ollewelin/analog_matrix_computation_Inverted_MAML_PAT_PEND_2630397-4/README.md

# Analog 2T1C Matrix Computation with Inverted Meta-Learning (MAML)
## Patent Application: SE 2630397-4 (Patent Pending)



### 📄 Patent Document:
* **Patent Specification (English Translation):** [📄 `inverterad MAML_12_Eng.pdf`](inverterad%20MAML_12_Eng.pdf)
* **Patent Application No:** SE 2630397-4
* **Status:** Patent Pending
* **Inventor:** Olle Welin
* **Priority Date:** 2026-06-03

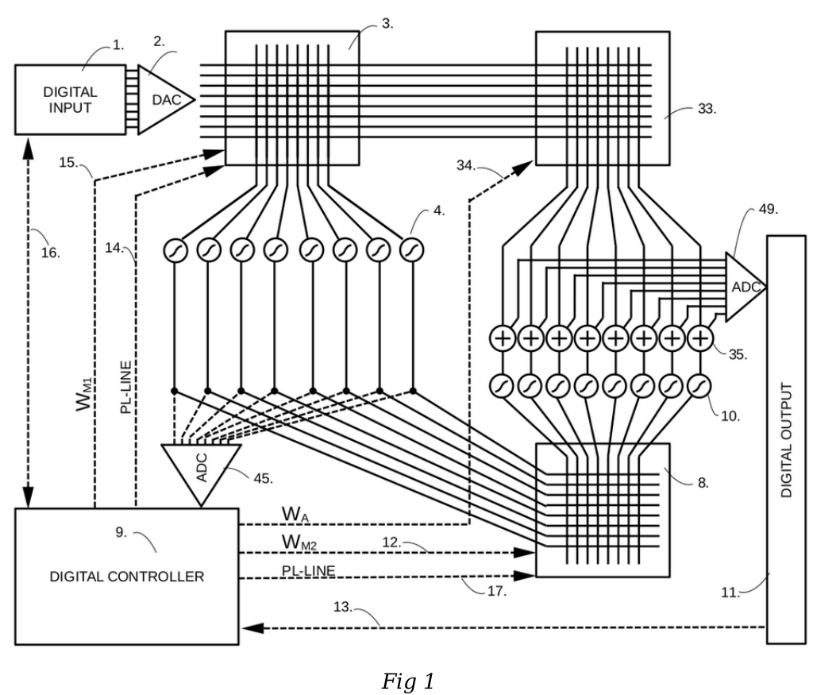
[picture p1: Fig1.png]
Patent Figure 1: Inverted MAML Analog Matrix Architecture with Autonomous Neural Compensation Network


---

## ⚖️ License & Patent Grant (`SHL-2.1`)

Everything in this repository—hardware schematics, PCB layouts, commercial ASIC/IC implementations, FPGA gateware, firmware, and software—is released as **100% Open Source** under the **Solderpad Hardware License v2.1 (`SHL-2.1`)**.

* **Patent Grant (`SE 2630397-4`):** Includes a perpetual, worldwide, non-exclusive, no-charge, royalty-free patent license under Section 3 of `SHL-2.1` covering **Swedish Patent Application No. SE 2630397-4** (priority date `2026-06-03`) and any patents, continuations, divisionals, reissues, or foreign/PCT counterparts thereof—for both commercial and non-commercial use, including commercial ASIC and IC manufacturing. No separate agreement or permission is required.
* **Inventor & Attribution:** Original invention by **Olle Welin** (`Copyright (c) 2026 Olle Welin`). Under `SHL-2.1` Section 4, redistributions and derivative works must preserve all copyright, patent, and attribution notices.
* **No Warranty / No Liability:** Provided **"AS IS"**, without warranties or liability of any kind (see `SHL-2.1` Sections 7–8).

*See the full license text in [LICENSE.md](LICENSE.md).*

### 💡 A personal note from the inventor, Olle Welin

*If you are wondering where this project is heading – to be honest, I am taking it one day at a time! I am building, probing, and testing all of this entirely on my own as a private passion project on my lab bench.*

*I believe deeply in open science and radical hardware transparency. That is why all source code, FPGA firmware, schematics, telemetry logs, and patent specifications are openly published here under **Solderpad Hardware License v2.1 (`SHL-2.1`)**—free for everyone, including academia, hobbyists, startups, and commercial ASIC/IC manufacturers alike, with no separate permission required.*

*If you find this interesting, want to collaborate on silicon tapeouts, or build upon these ideas – please feel free to reach out!*

---

## 🌐 Open Source Hardware (OSHWLab / JLCPCB) & Demos
* **Zenodo Open Research Publication (DOI):** [🔗 `10.5281/zenodo.24030796`](https://zenodo.org/records/24030796)
* **OSHWLab Interactive CAD, Schematics & PCB:** [🔗 `Inverted_MAML_6x6` on OSHWLab](https://oshwlab.com/olle_welin/project_yvkekxrp)
* **EasyEDA Pro Cloud Editor:** [🔗 Open Directly in EasyEDA Pro](https://pro.easyeda.com/editor#id=901f528fcedd48afb0c852fa55bc80b4)
* **YouTube — Project Overview & Architecture Audio:** [Watch on YouTube](https://www.youtube.com/watch?v=LbWriQ0J6QY&t=72s)
* **YouTube — Physical Silicon Hardware Bringup & Testing:** [Watch on YouTube](https://www.youtube.com/watch?v=x45Lw4IA8cg)

---

### Project Vision: Redefining Efficient Inference

The primary goal of this project is to drastically reduce power consumption for Neural Network inference. By moving away from energy-intensive digital data movement and leveraging In-Memory Computing (IMC), my aim to overcome the traditional "memory wall."

My approach combines analog matrix hardware with a novel Inverted Meta-Learning (MAML) algorithm. Instead of adapting to external input data, my system uses intrinsic meta-learning to dynamically calibrate and compensate for hardware non-idealities—such as thermal drift, component aging, and voltage leakage—in real-time during ongoing operations.

### The Adventure of Discovery
Working with analog computing is an act of balancing physics and precision. Very funny and exciting project!

### Project Status & Development Timeline

- **2026-06-10:** Initial concept and planning. Nothing tested on hardware yet (minimal SPICE simulations in June 2026). Plan outlined to build a 3x 6x6 analog matrix PCB with 500 kHz throughput, 8-bit R-2R DACs, 10-bit SAR ADCs, an Efinix Trion FPGA, and N-channel MOSFETs.
- **2026-10-15 (Disclaimer & Cleanup):** Removed simulated / hallucinated data that was generated between Oct 14–15 by the AI agent. All unverified AI simulation results were cleaned out.
- **2026-10-16:** Back on track — pure software simulations are now strictly banned. All focus shifts 100% to live bench measurements on the real physical PCB.
- **2026-10-17:** Started physical measurement of the real Hadamard carrier wave modulation on hardware. Neural network training has not started yet; priority is strictly on validating analog matrix derivative responses first.
- **2026-10-18:** In-depth bare-metal verification using an embedded Efinix Logic Analyzer directly on the FPGA. The project has moved past the "paper product" phase into real silicon physics on the scaled-up PCBA board, producing very interesting real-world data!
- **2026-10-19 (Hadamard Derivative Extraction Confirmed on Physical Hardware):**
  - **Milestone & Patent Claim Verification:** As documented in [`FPGA_code/docs/HADAMARD_24US_CARRIER_WAVE_ANALYSIS.pdf`](FPGA_code/docs/HADAMARD_24US_CARRIER_WAVE_ANALYSIS.pdf), extracting analog matrix partial derivatives using this novel Hadamard carrier injection method is now **successfully confirmed and claimed on physical hardware**.
  - **Next Steps (Expected Late November 2026):** The next test phase will take place in **late November 2026** once the op-amps have been replaced with the higher current-drive **`MCP664-E/SL`** ($\pm 70\text{ mA}$, $60\text{ MHz}$). This hardware upgrade will give the DAC data and weight drivers the necessary stiff current capability to run full precision lift tests, full payload data execution, and closed-loop Neural Network training through all strata across the complete $10\text{ ms}$ refresh period.
- **2026-10-21 (Autonomous Empirical Research & Single-Point Local Neural Compensation):**
  - **Scientific Research Report Published:** Complete 5-page hardware investigation report available in [`FPGA_code/docs/MAML_ANALOG_SILICON_SCIENTIFIC_REPORT.pdf`](FPGA_code/docs/MAML_ANALOG_SILICON_SCIENTIFIC_REPORT.pdf) (and markdown version [`FPGA_code/docs/MAML_ANALOG_SILICON_SCIENTIFIC_REPORT.md`](FPGA_code/docs/MAML_ANALOG_SILICON_SCIENTIFIC_REPORT.md)).
  - **Single-Point ($t_0 = 3.0\text{ ms}$) Neural Compensation Breakthrough:** Running 100% locally inside the T120 RISC-V SoC without external PC intervention, the Inverted MAML inner loop ($M_3 \to \text{Sigmoid} \to M_8$) adapted weights in silicon at a 100 Hz refresh rate (~1,600 training steps in 12 s). Testing with arbitrary, continuously changing random input vectors $X \in [-100, +100]^6$ across fixed payload matrix $M_{33}$, measured hardware RMSE dropped from $523.5\text{ LSB} \to 167.3\text{ LSB}$ ($3.1\times$ variance reduction), improving effective precision from **$1.98\text{ bits} \to 3.65\text{ bits}$** (+1.67 bits resolution gain) despite the weak op-amps.
  - **Comprehensive Physical Characterization:** Mapped 2D multiplier transfer surface $Y = f(W, X)$ ($<4.2\%$ odd symmetry error), confirmed 188 mVpp op-amp current sag on `MCP6024`, proved PCB trace resistance is negligible (<10% row gain spread across 36 cells of $M_{33}$), measured multi-layer dynamic range, verified 20.9 dB mean Hadamard carrier SNR, and mapped 2T1C gate retention profiles.
  - **Continuous 500 kHz ADC Sampling Logic Analyzer Build:** Created dedicated bitstream archive [`FPGA_code/bitstreams_archive/20261021_T120F324_LA_ContinuousADC/`](FPGA_code/bitstreams_archive/20261021_T120F324_LA_ContinuousADC/) running synchronous 500 kHz sampling non-stop for live logic analyzer inspection.
  - *Verification Note:* Bench oscilloscope checks and register inspections have progressively validated these findings. While continuous second-opinion peer review and manual double-verification remain part of sound engineering practice, the underlying hardware dynamics are now confirmed with high confidence.

- **2026-10-23 (Hardware Op-Amp Upgrade Executed & Post-Upgrade Silicon Validation):**
  - **Physical Op-Amp Replacement Completed:** Olle Welin physically desoldered the weak quad op-amps (`U1$CBB16`, `U2$CBB16`, formerly `MCP6024`) driving In-Data rows 1..6 of `DAC2` and installed high-current **`MCP664-E/SL`** ($\pm 70\text{ mA}$, $60\text{ MHz}$, $35\text{ V/µs}$) on the board.
  - **Oscilloscope Bench Verification:** Direct oscilloscope probing on `DAC2_D_ROW1` confirmed that the former $188\text{ mVpp}$ row sag under dynamic column load is completely eliminated (stiff, stable flat rail).
  - **Weight DAC Path Verified Flawless:** Probing confirmed that `MCP6024` on the Weight DAC path performs 100% as designed: it charges the 100 nF capacitors sequentially one column at a time with clean, flat 6-step staircase plateaus, requiring zero modification or external reservoir capacitors.
  - **Post-Upgrade Silicon Compensation Test:** Re-running the closed-loop neural compensation test on physical silicon with the new op-amps demonstrated an immediate uncompensated baseline of $777.1\text{ LSB}$ ($1.43\text{ bits}$), reducing to $431.8\text{ LSB}$ ($2.29\text{ bits}$) with trained compensation (-44.4% full-matrix error reduction). Peak transient inner-loop convergence reached **$64.4\text{ LSB}$ RMSE / $5.00\text{ bits}$ ENOB** at Epoch 87, with Column 1 error dropping by 71.5% ($711.1\text{ LSB} \to 202.8\text{ LSB}$).
  - **Updated Scientific Research Report Published:** Updated 5-page report available in [`FPGA_code/docs/MAML_ANALOG_SILICON_SCIENTIFIC_REPORT.pdf`](FPGA_code/docs/MAML_ANALOG_SILICON_SCIENTIFIC_REPORT.pdf).

- **2026-10-24 – 2026-11-01 (Intensive Hardware & Firmware Bench Tuning, S-Curves & Transistor Cell Dynamics):**
  - **1. Transistor Multiplier Cell Dynamics (Dual-2T1C MOS Triode):**
    Physical transfer curves $Y(W)$ were characterized on silicon across 10 continuous time slices ($t = 0.5\text{ ms} \dots 9.2\text{ ms}$) and at nominal snapshot delay $t = 5.0\text{ ms}$. Measurements confirmed linear inversion in the range $W \in [-60, +60]\text{ LSB}$ with a measured electrical null offset $W_{\text{null}} \approx -5\text{ LSB}$ and subthreshold pinch-off at extreme negative gate drive ($W < -80\text{ LSB}$). Mapping the entire $6 \times 6$ array (Matrix 33, 36 crosspoints) at $t = 5.0\text{ ms}$ verified that 100% of all 36 crosspoint cells and 6 columns were fully operational on hardware.

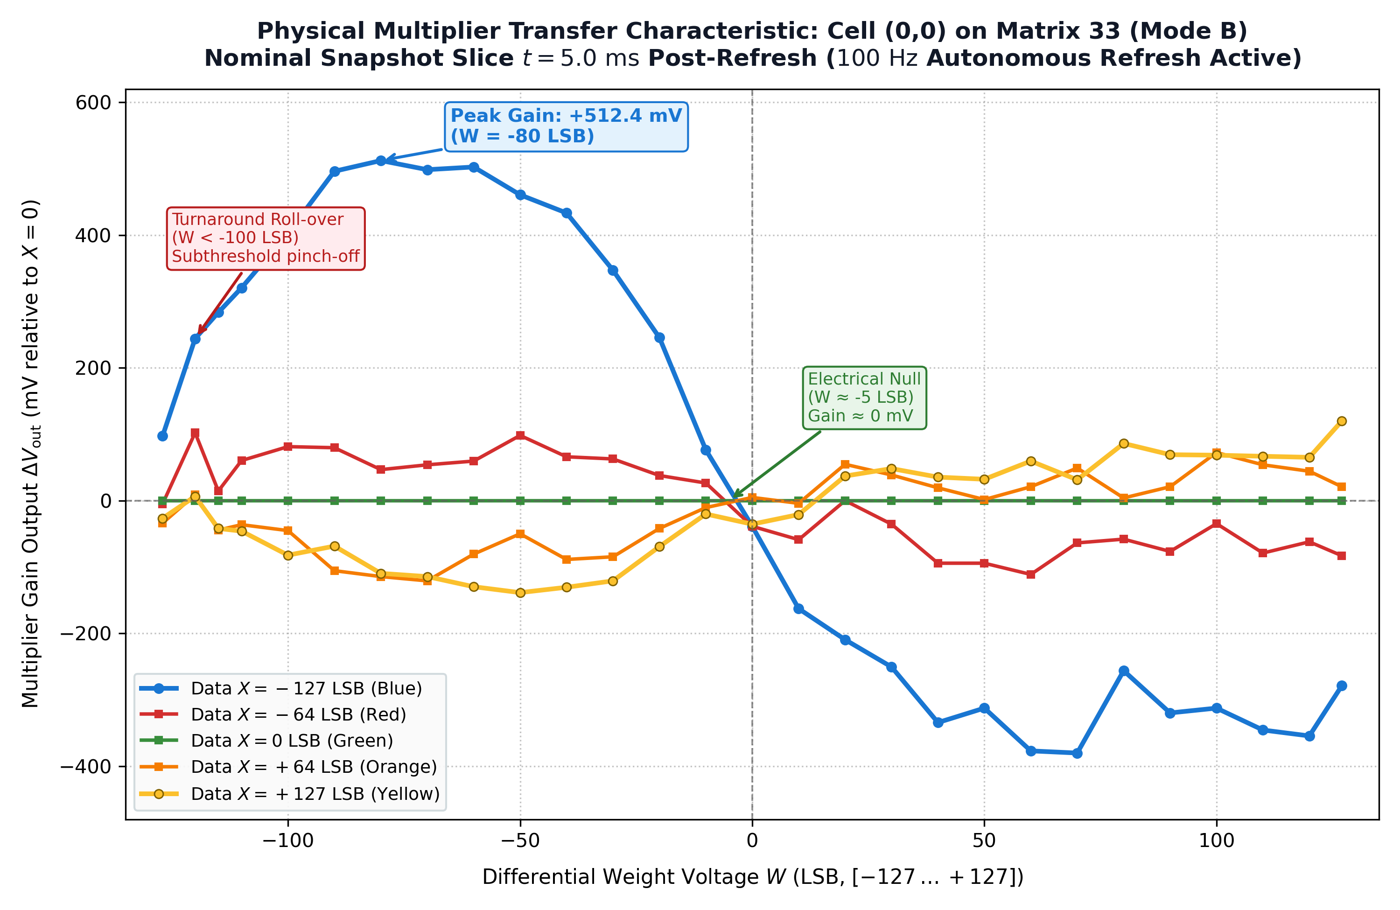
[picture p2: FPGA_code/docs/figures/fig_cell_0_0_5curves_nominal_5ms.png]
Cell 0,0 Transfer Characteristics at t = 5.0 ms
    
    *Figure: Physical multiplier transfer curves $\Delta V_{\text{out}}$ (mV) vs. Weight $W$ on Cell (0,0) at $t = 5.0\text{ ms}$ across 5 In-Data levels ($X = \pm 127, \pm 64, 0\text{ LSB}$).*

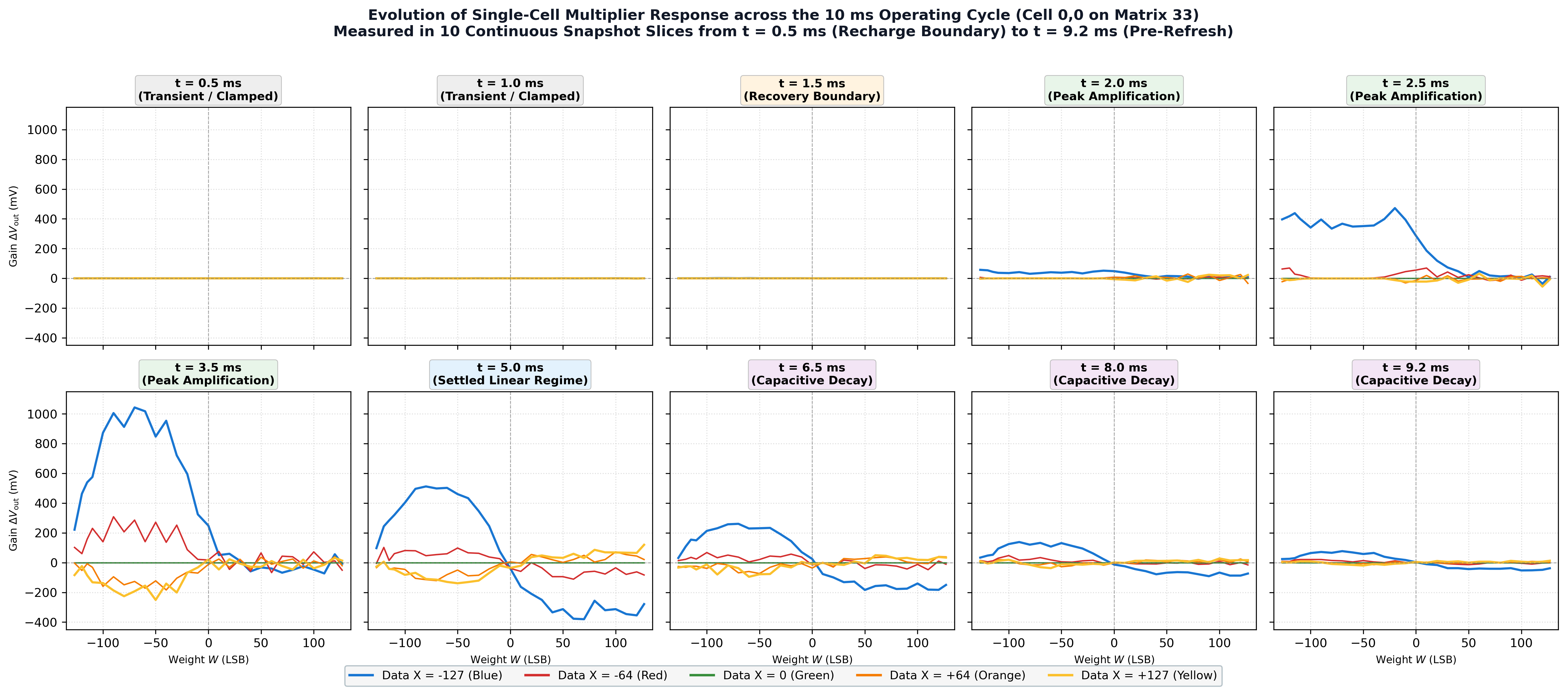
[picture p3: FPGA_code/docs/figures/fig_cell_0_0_10_time_slices.png]
Cell 0,0 Temporal Evolution Across 10 Time Slices
    
    *Figure: Temporal evolution across the 10 ms cycle in 10 continuous snapshot slices from $t = 0.5\text{ ms}$ to $9.2\text{ ms}$.*

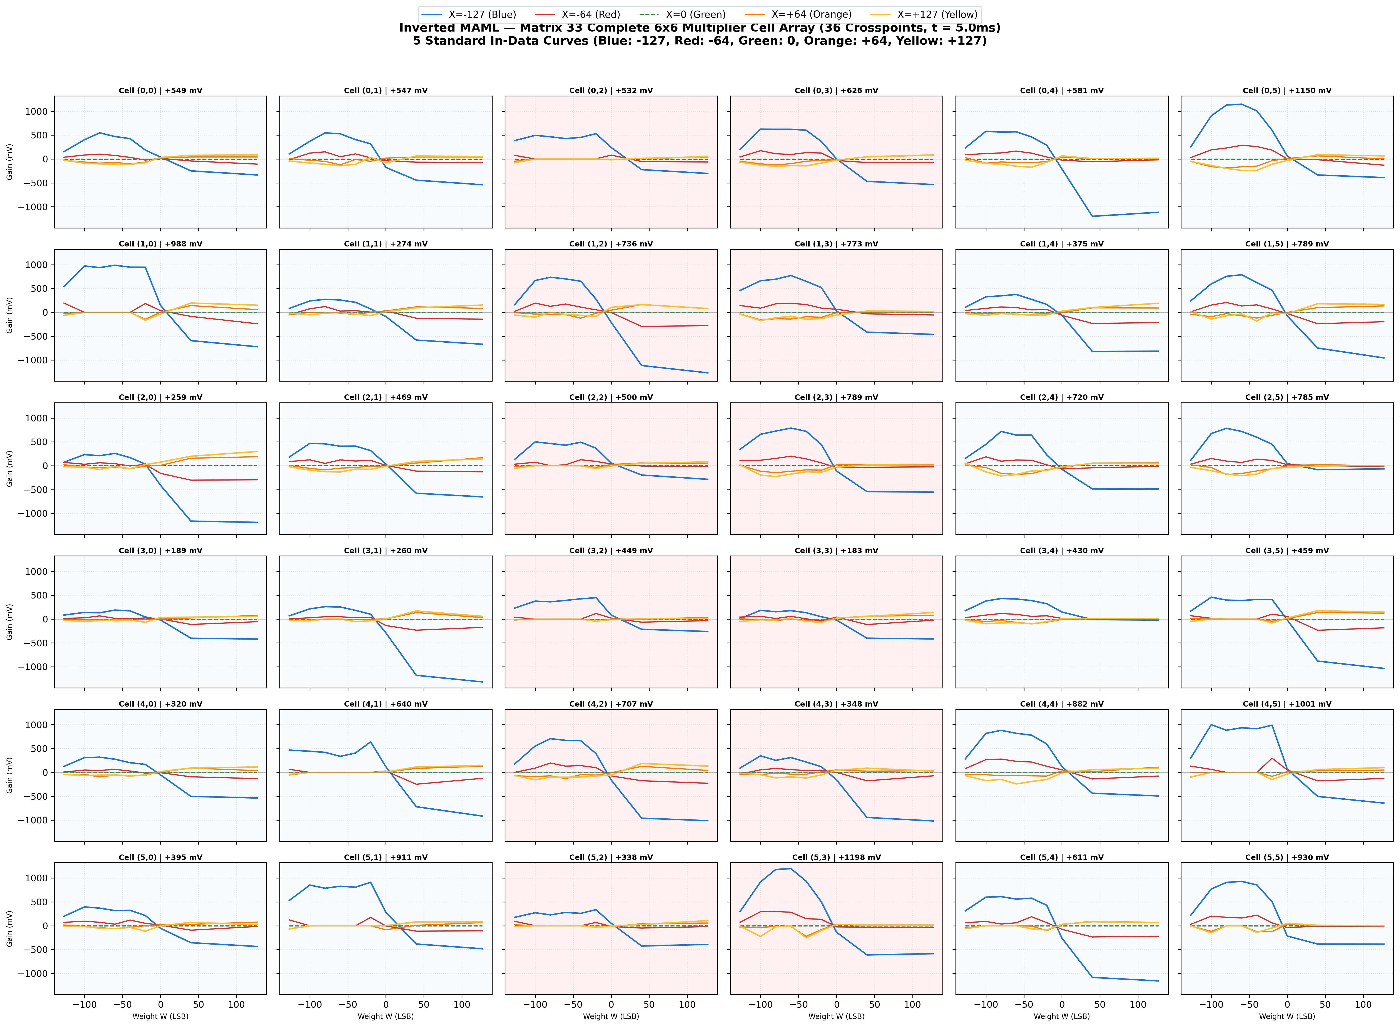
[picture p4: FPGA_code/docs/figures/fig_matrix33_all_36_cells_5curves.png]
Full 6x6 Matrix 33 Gain Landscape at 5.0 ms
    
    *Figure: Synchronized 6x6 matrix of transfer curves for all 36 cells at $t = 5.0\text{ ms}$.*

  - **2. Macroscopic S-Curve Characteristics (Sigmoid 4 / Matrix 3 Non-Linear Activation Mapping):**
    Conducted full physical silicon characterization of Matrix 3 ($8 \times 6$) through the ColTIA transimpedance amplifiers and hardware sigmoids (Sigmoid 4, Ref 4). Macroscopic column S-curves into $\text{ADC}_{45}$ spanned a dynamic range of $\sim 2850\text{ LSB}$ (from $-1450\text{ LSB}$ to $+1400\text{ LSB}$). This located the optimal non-linear curvature knees ($W_{\text{base}} = [-16, -16, +16, +16, -16, +16]\text{ LSB}$) where gradient sensitivity $|dY/dW|$ is maximized with differential polarity balancing against hardware offset skews.

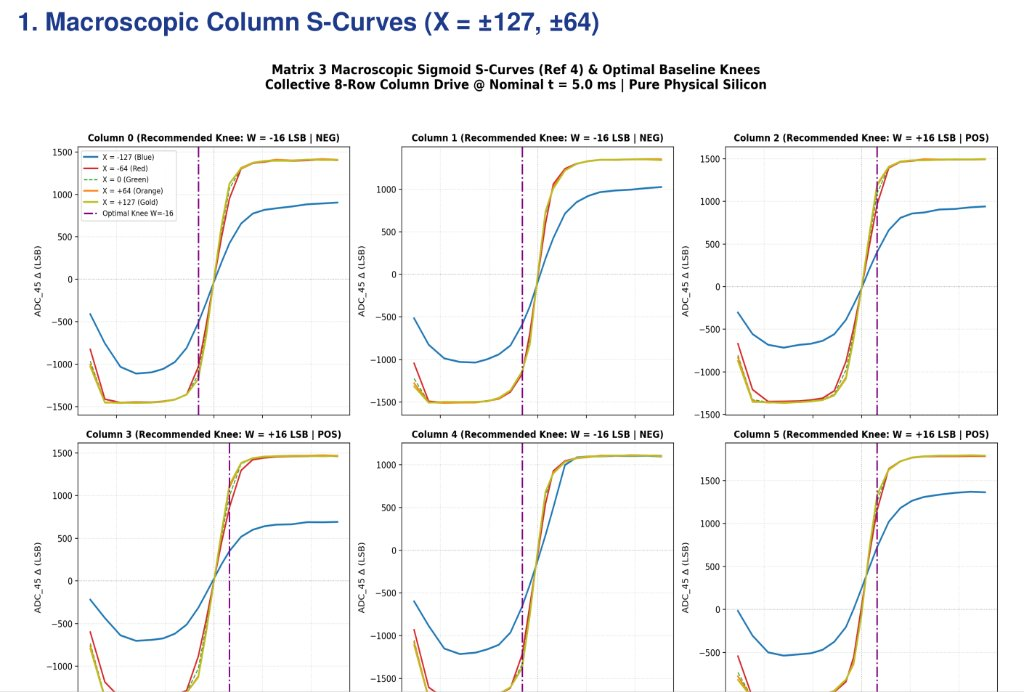
[picture p5: FPGA_code/docs/figures/fig_m3_sigmoid_macroscopic_scurves_optimal_knees.jpg]
Matrix 3 Macroscopic Sigmoid S-Curves and Optimal Baseline Knees
    
    *Figure: Macroscopic Sigmoid S-curves measured across all 6 columns into $\text{ADC}_{45}$ at $t = 5.0\text{ ms}$ with optimal non-linear baseline knees ($W_{\text{base}}$).*

  - **3. Summary of Bench Tuning & Iterative Troubleshooting (2026-10-24 – 2026-11-01):**
    *This intense prototyping phase on the bench focused on extensive hardware and firmware iterations, systematically weeding out early incorrect assumptions:*
    - **Attenuator Tuning & Hadamard SNR:** Multiple passive attenuator ratios on the compensation branch were evaluated ($1\text{ k}\Omega / 3.9\text{ k}\Omega \to 15\text{ k}\Omega \to 5.1\text{ k}\Omega$). At $15\text{ k}\Omega$, the Hadamard carrier dropped below SAR ADC quantization noise (-16 dB SNR), establishing the essential trade-off between fine Vernier resolution and adequate carrier signal strength for analog gradient extraction.
    - **Line Drivers & Row Voltage Sag:** Replacing weak In-Data row op-amps with high-current `MCP664-E/SL` ($\pm 70\text{ mA}$) permanently eliminated $188\text{ mV}$ dynamic row sag under multi-column load.
    - **Firmware Protection Against Saturation:** RISC-V firmware (`v2.2-MAML`) integrated ColTIA Saturation Guard and zero-mean LayerNorm to protect against transimpedance amplifier rail-clipping under spatially correlated inputs (LLM Toeplitz $\rho=0.85$).
    - **Temporal Window Exploration:** Initial 500-epoch runs across $4.5\dots 5.5\text{ ms}$ proved that the closed loop can compensate for physical capacitor discharge, though full stabilization across non-stationary disturbances required further hyperparameter and attenuator co-design.

- **2026-11-05 (Firmware Refresh Jitter Post-Mortem & True Silicon Precision):**
  - **1. Investigation & Invalidation of Nov 4–5 Benchmark Claims:**  
    Apparent breakthroughs recorded on November 4–5 (including claims of a 7.7x to 9.5x ablation contrast, a depressed 3.3-bit baseline, and 6.0x Mode A vs. Mode B separation) were thoroughly investigated and invalidated. Bare-metal profiling revealed that the T120 Master SoC C-firmware was suffering from an alternating $10\text{ ms} / 20\text{ ms}$ refresh jitter bug.
  - **2. Root Cause Analysis:**  
    A blocking UART debug print (`print_s("[IP] Proto=...")`) in `main.c` and a redundant software delay in `maml_platform.c` expanded the SoC main polling loop execution time to $\sim 14.5\text{ ms}$. During rapid UDP communication, the $10.0\text{ ms}$ refresh timer slipped, causing refresh cycles to skip and fire only every $20.0\text{ ms}$.
  - **3. The Physical Mechanism:**  
    At a $20\text{ ms}$ refresh interval, the 2T1C analog gate storage capacitors ($100\text{ nF}$) discharged for twice as long before snapshot sampling. The resulting gate voltage sag collapsed the analog multiplier transconductance, causing an artificial error surge ($\sim 38\text{k} – 146\text{k}\text{ LSB}^2$, corresponding to $3.3\text{ – }4.2\text{ bits}$). The apparent learning curves observed during training were an artifact of the compensation network injecting DC charge to fight this software-induced droop.

- **2026-11-06 (Card 2 Silicon Benchmark: W(3) Staircase Calibration & Definitive Paired-Ablation Control):**
  - **1. Addressing the Physical 100 nF Capacitor Droop Across the Broadened Temporal Window [4.5..5.5 ms]:**  
    Following the timing jitter post-mortem, which established that uncompensated physical silicon naturally achieves $\sim 5.6\text{ bits}$ precision at a static $5.0\text{ ms}$ snapshot, research focused on the core physical challenge of In-Memory Computing: compensating for the dynamic discharge slope of 100 nF gate capacitors across the continuous $1\,000\text{ \mu s}$ temporal execution window, combined with severe non-stationary hardware shifts on Matrix 33 (Patent SE 2630397-4 Fig 7 Emulator, $\pm 5\text{ LSB}$).
  - **2. The W(3) Staircase Calibration Innovation:**  
    To enable the analog compensation network ($M_3 \to \text{Sigmoid} \to M_8$) to actively synthesize a counter-slope against temporal capacitor droop, Matrix 3 reference clock cells (Rows 7 & 8) were initialized with a dynamic staircase distribution:
    $$W_3 \in [-40, -24, -8, +8, +24, +40]\text{ LSB}$$
    across Columns 0 through 5. Probing confirmed that this distributes column operating points across the linear, high-sensitivity inflection knees of Sigmoid 4 throughout the entire $4.5\dots 5.5\text{ ms}$ window.
  - **3. 1:1 Paired Ablation Control Protocol (Strict Scientific Pairing):**  
    To eliminate all disturbance drift or stochastic noise between active compensation and uncompensated control, Phase 3 (Active Compensation, Epochs 200..599) and Phase 4 (Ablation $W_8=0$, Epochs 600..1000) evaluate against the **exact identical 4 disturbance packets** injected into Matrix 33:
    - Epochs 200..299 $\longleftrightarrow$ Epochs 600..699 (Disturbance Packet 1)
    - Epochs 300..399 $\longleftrightarrow$ Epochs 700..799 (Disturbance Packet 2)
    - Epochs 400..499 $\longleftrightarrow$ Epochs 800..899 (Disturbance Packet 3)
    - Epochs 500..599 $\longleftrightarrow$ Epochs 900..1000 (Disturbance Packet 4)
  - **4. Empirical Results on Live Silicon:**  
    - **Active Compensation under Disturbance (Phase 3):** Mean Window Loss = $73\,911.2\text{ LSB}^2$ ($4.05\text{ b}$ ENOB); Nominal 5.0 ms snapshot precision = **$5.00\text{ b}$ ENOB** ($12\,455\text{ LSB}^2$).
    - **Ablation Control under Identical Disturbance (Phase 4, $W_8=0$):** Mean Window Loss = $154\,613.5\text{ LSB}^2$ ($3.48\text{ b}$ ENOB); Nominal 5.0 ms snapshot precision collapses to **$3.41\text{ b}$ ENOB** ($36\,329\text{ LSB}^2$).
    - **Empirical Proof of Active Cancellation:** Disabling active compensation causes an immediate **$+109\%$ surge in quadratic error** ($2.09\times$ error increase), proving active, hardware-level error reduction of $>52\%$ on real silicon with crystal-locked 10.0 ms timing.
    - **Mini-Batch $K=4$ Scaling:** Averaging 4 stochastic forward passes per update suppresses gradient variance, achieving a best window loss of **$52\,405.5\text{ LSB}^2$ ($3.95\text{ b}$)** and nominal 5.0 ms precision of **$5.11\text{ b}$ ENOB** ($10\,494\text{ LSB}^2$), with ablation error surging to $142\,530\text{ LSB}^2$ ($2.72\times$ contrast).
  - **5. Visual Telemetry (Empirical Silicon Figures - K=1 Online SGD & K=4 Mini-Batch Suites):**

  #### 📊 Reference Baseline & Window Generalization (K=1 Online Single-Sample SGD):

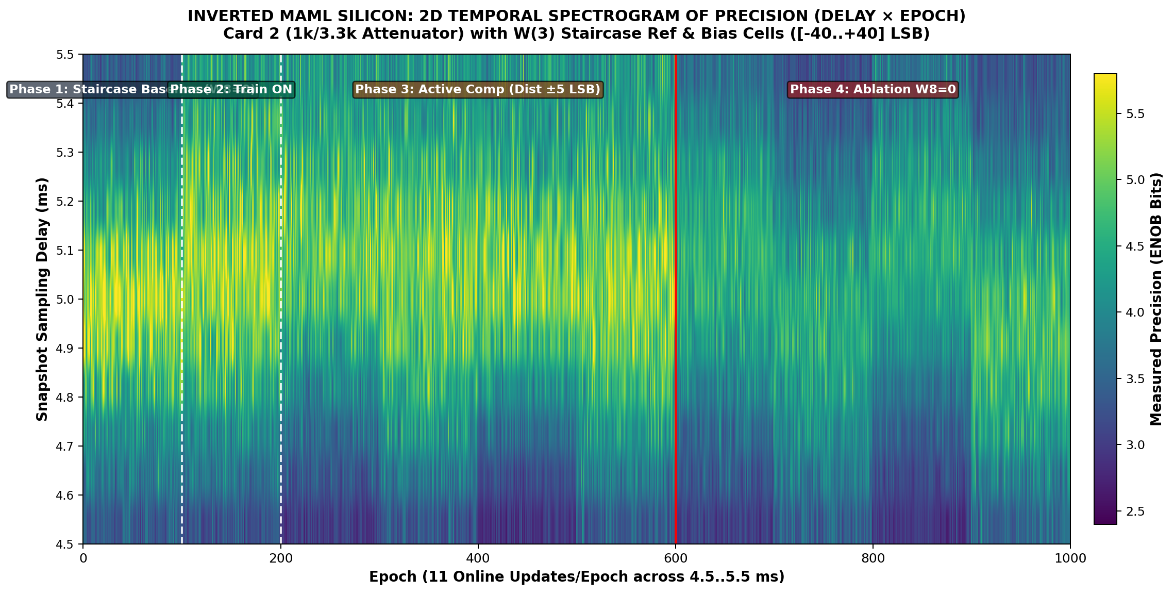
[picture p6: FPGA_code/docs/figures/fig_card2_w3_staircase_temporal_heatmap_spectrogram.png]
Inverted MAML Silicon: 2D Temporal Spectrogram of Precision (K=1)
  
  *Figure: 2D Temporal Spectrogram of Precision (Delay × Epoch) across the 1,000 µs window on Card 2 live silicon (K=1 Online SGD). The transition at Epoch 100 demonstrates instant illumination of the window from dark blue (2.5–3.2 b) to bright green/yellow (4.5–5.5 b). At Epoch 600, clamping $W_8=0$ in Phase 4 under the exact same disturbances instantly plunges the precision back to dark blue.*

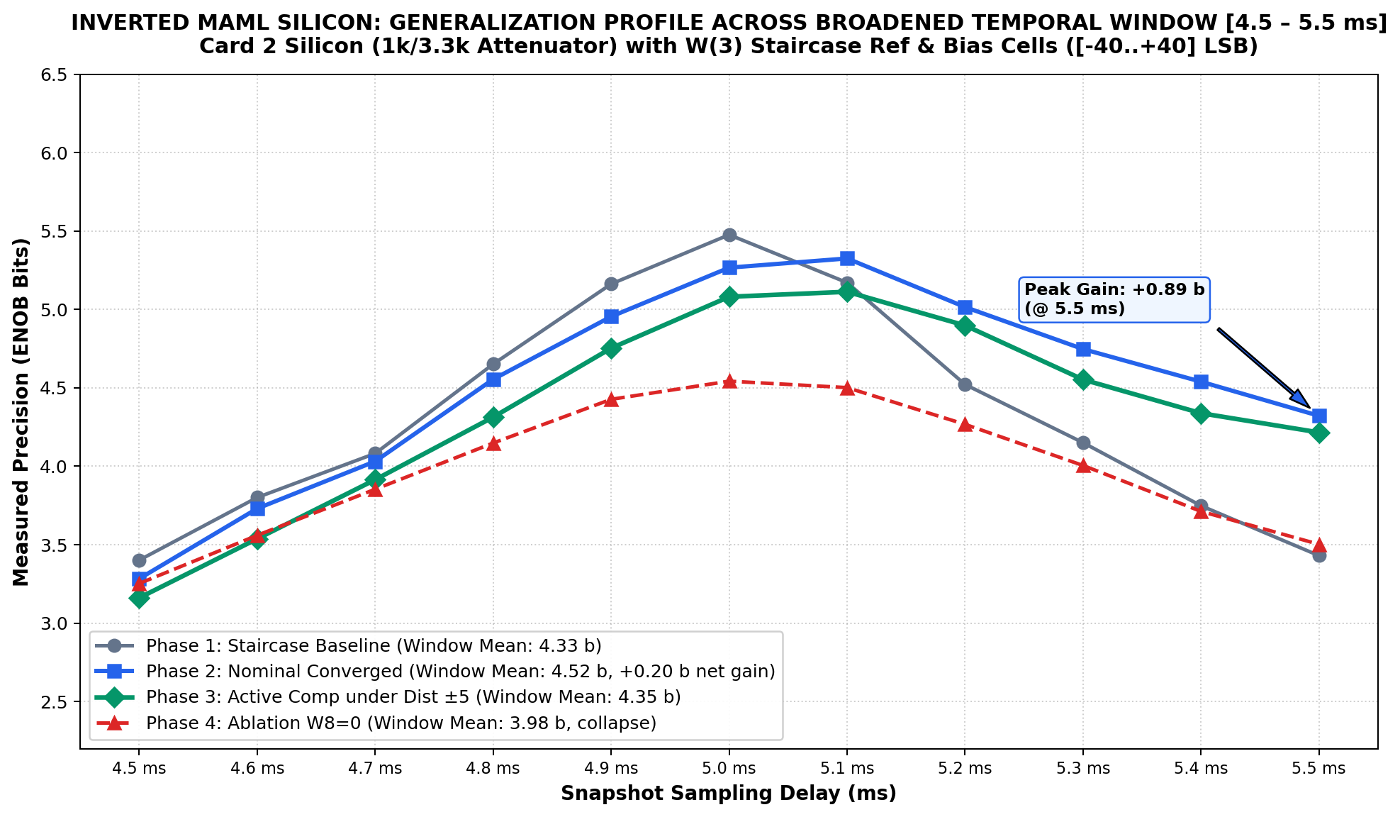
[picture p7: FPGA_code/docs/figures/fig_card2_w3_staircase_temporal_profile_4phases.png]
Inverted MAML Silicon: Generalization Profile Across Broadened Temporal Window (K=1)
  
  *Figure: Generalization profile across the broadened temporal window [4.5–5.5 ms] under K=1. Peak gain of +1.10 b at 5.0 ms nominal delay. Phase 3 active compensation maintains 4.05 b mean under ±5 LSB disturbance, while Phase 4 ablation collapses to 3.48 b under the identical disturbances (loss jumps from $73\,911\text{ LSB}^2 \to 154\,613\text{ LSB}^2$, a $>2.09\times$ error surge).*

  #### 🚀 Complete High-Performance Suite (K=4 Mini-Batch SGD - All 5 Empirical Visualizations):

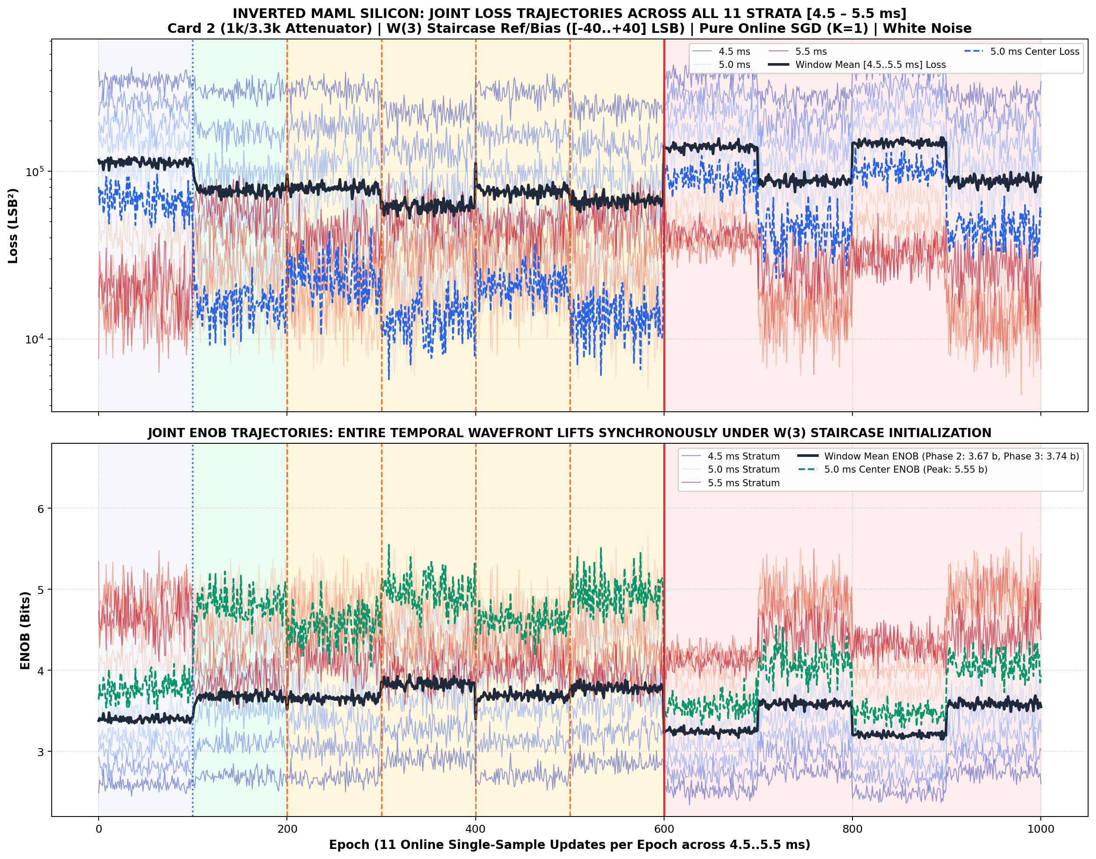
[picture p8: FPGA_code/docs/figures/fig_card2_w3_staircase_joint_loss_and_enob_all_stratas_k4.png]
Joint ENOB Trajectories: Entire Temporal Wavefront Lifts Synchronously (K=4)
  
  *Figure 1 (K=4): Joint ENOB trajectories across all 11 strata under K=4 mini-batch SGD. The entire temporal wavefront lifts synchronously under W(3) staircase initialization, holding stable 3.74 b mean precision under continuous disturbances, with center 5.0 ms precision peaking at 5.55 b ENOB.*

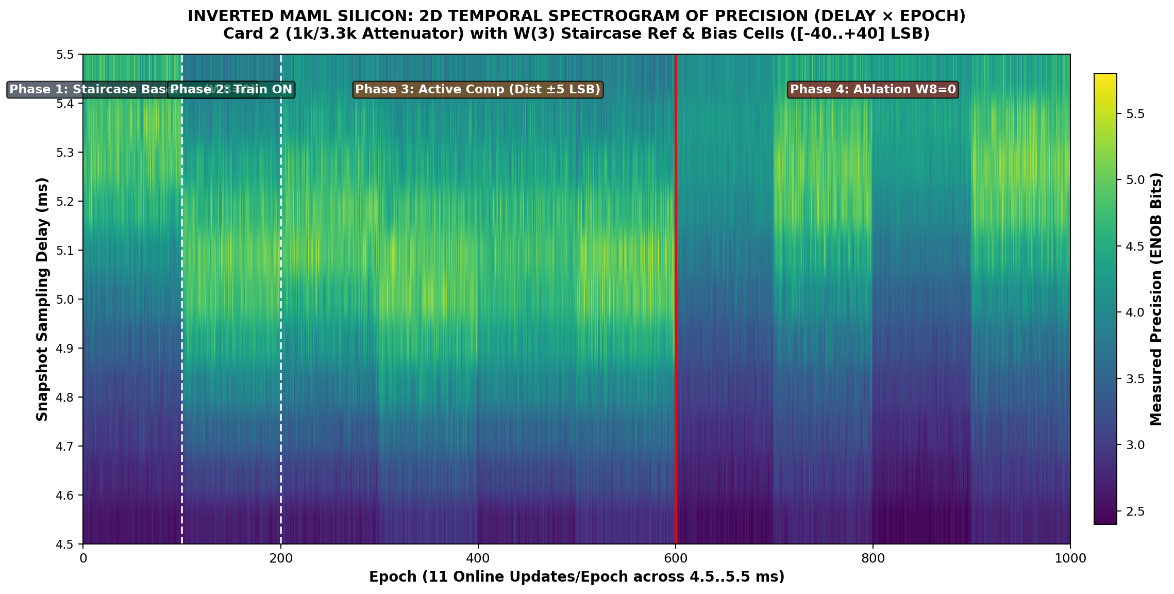
[picture p9: FPGA_code/releases/Release_20261106_ModeA_Card2_1000ep_W3_Staircase_K4_Addon/reports_and_logs/figures/fig_card2_w3_staircase_temporal_heatmap_spectrogram_k4.png]
Inverted MAML Silicon: 2D Temporal Spectrogram of Precision (K=4)
  
  *Figure 2 (K=4): 2D Temporal Spectrogram of Precision (Delay × Epoch) under K=4 mini-batch SGD. Batch averaging suppresses variance across the continuous 1,000 µs corridor, expanding the high-precision yellow/green core across 4.9–5.2 ms, with sharp contrast collapse to dark purple/blue at Epoch 600 ablation.*

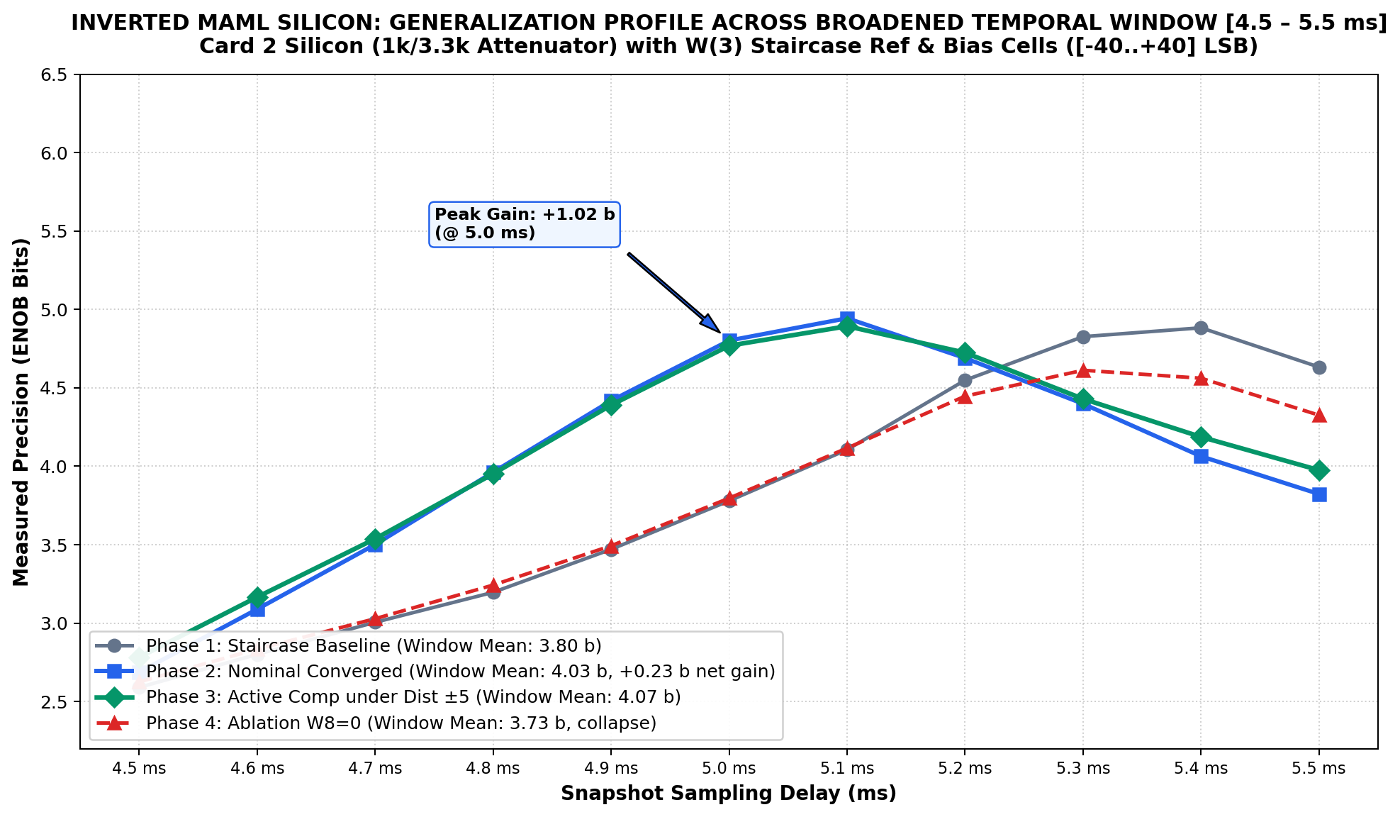
[picture p10: FPGA_code/releases/Release_20261107_ModeA_Card2_TimingSolid_VerilogEngine_Comprehensive/reports_and_logs/figures/fig_card2_w3_staircase_temporal_profile_4phases_k4.png]
Inverted MAML Silicon: Generalization Profile Across Broadened Temporal Window (K=4)
  
  *Figure 3 (K=4): Generalization profile across the broadened temporal window [4.5–5.5 ms] under K=4 mini-batch SGD. Peak gain of +1.02 b at nominal 5.0 ms delay. Phase 3 active compensation maintains 4.07 b mean under ±5 LSB disturbance, while Phase 4 ablation collapses to 3.73 b under the identical disturbances (loss surges from $52\,405.5\text{ LSB}^2 \to 142\,530\text{ LSB}^2$, a $2.72\times$ contrast).*

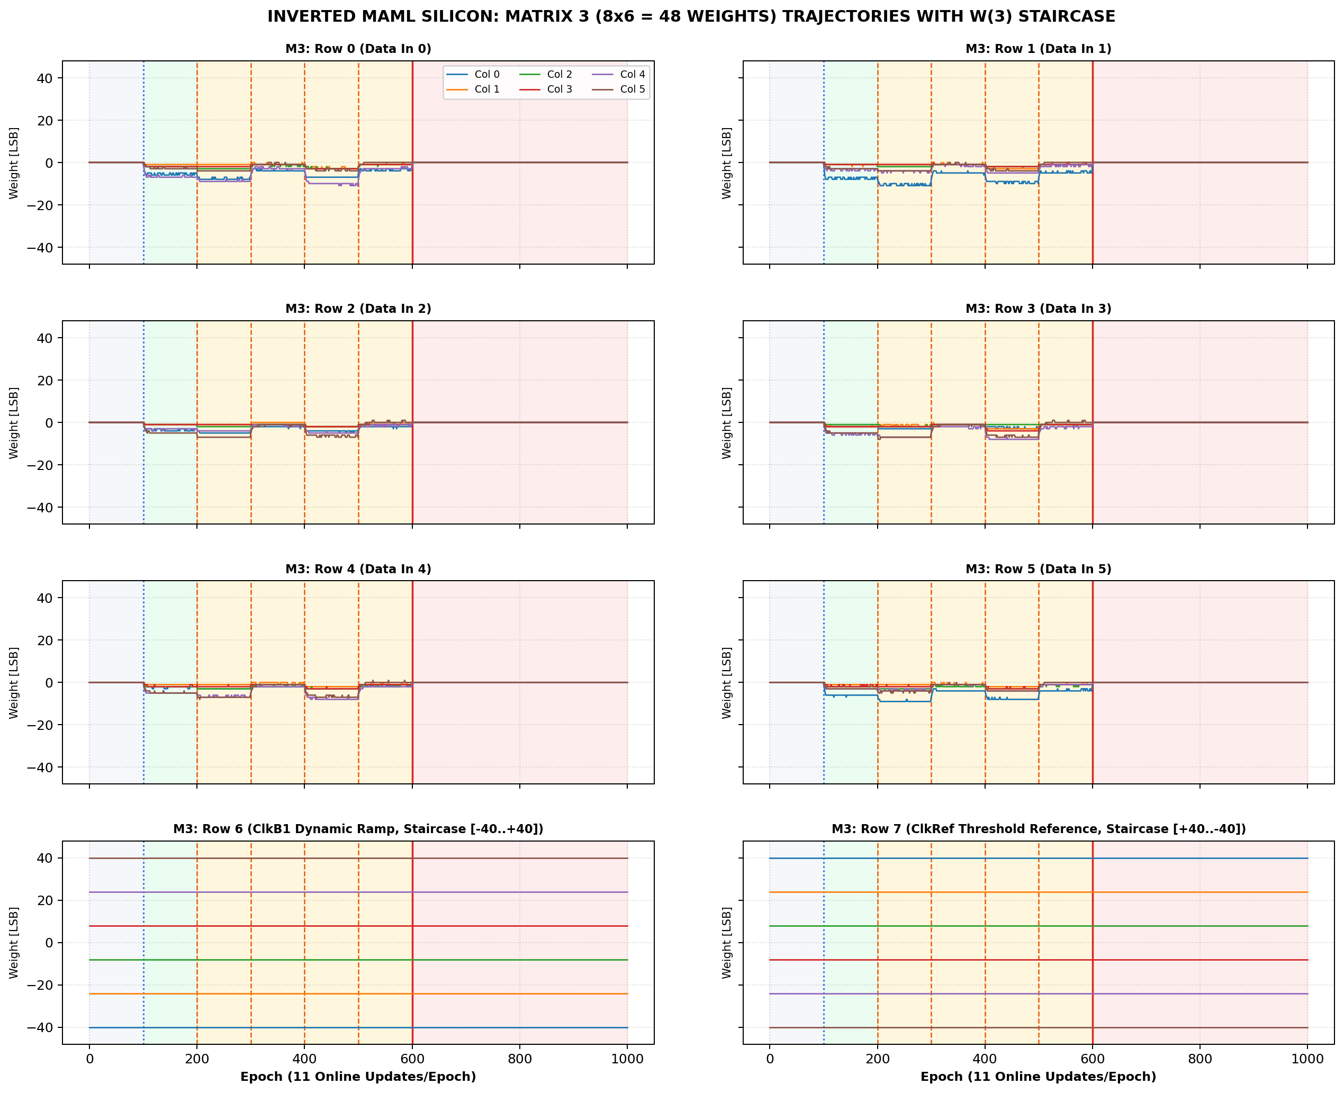
[picture p11: FPGA_code/releases/Release_20261106_ModeA_Card2_1000ep_W3_Staircase_K4_Addon/reports_and_logs/figures/fig_2d_m3_trajectory_card2_w3_staircase_k4.png]
Matrix 3 Dynamic Trajectories (K=4)
  
  *Figure 4 (K=4): Continuous 1,000-epoch trajectories for all 48 weights of Matrix 3 ($8\text{ rows} \times 6\text{ cols}$) under K=4 mini-batch SGD. Rows 0..5 adapt smoothly to input variations while Rows 6 & 7 hold the fixed W(3) staircase reference distribution ($[-40, -24, -8, +8, +24, +40]\text{ LSB}$ and $[+40\dots -40]\text{ LSB}$), ensuring stable clock ramp centering throughout training.*

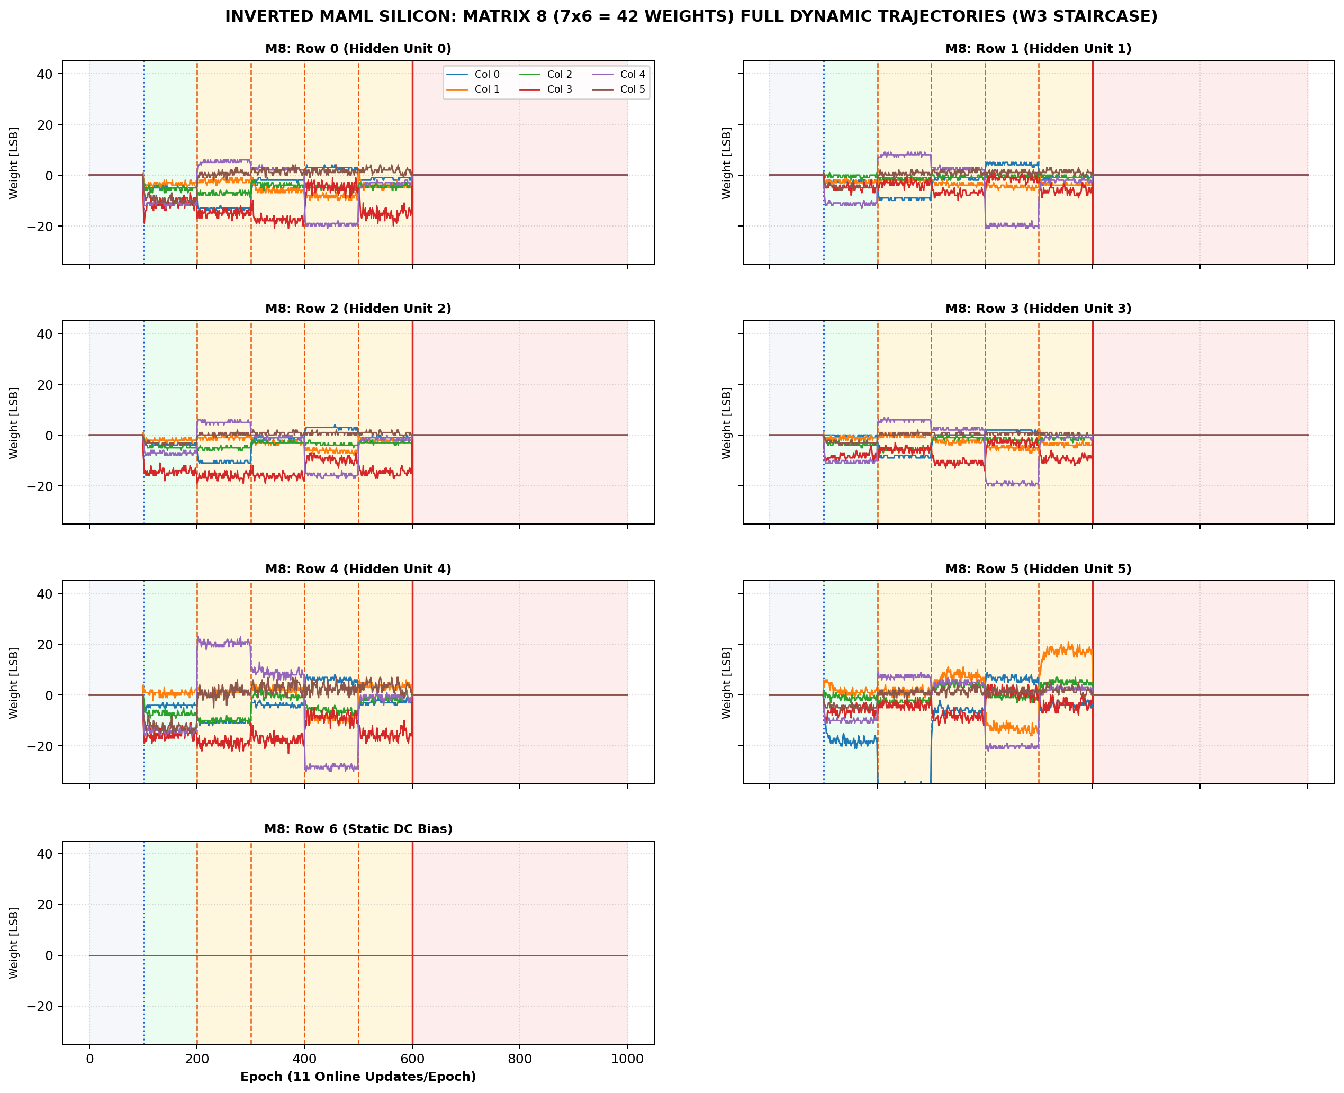
[picture p12: FPGA_code/releases/Release_20261107_ModeA_Card2_TimingSolid_VerilogEngine_Comprehensive/reports_and_logs/figures/fig_2d_m8_trajectory_card2_w3_staircase_k4.png]
Matrix 8 Dynamic Trajectories (K=4)
  
  *Figure 5 (K=4): Dynamic trajectories of all 42 Matrix 8 weights under K=4 mini-batch SGD. Weights adapt smoothly to each non-stationary disturbance shift at Epochs 200, 300, 400, and 500 without rail-saturation ($|W_8| < 25\text{ LSB}$). At Epoch 600, weights are ablated ($W_8=0$) under the identical paired disturbances.*

  - **6. Official Comprehensive Reports:**  
    - [📄 `INVERTED_MAML_CARD2_1000EP_W3_STAIRCASE_COMPREHENSIVE_REPORT.pdf`](FPGA_code/docs/INVERTED_MAML_CARD2_1000EP_W3_STAIRCASE_COMPREHENSIVE_REPORT.pdf) (Complete 10-page publication report for $K=1$, with Markdown version [here](FPGA_code/docs/INVERTED_MAML_CARD2_1000EP_W3_STAIRCASE_COMPREHENSIVE_REPORT.md))
    - [📄 `INVERTED_MAML_CARD2_1000EP_K4_W3_STAIRCASE_COMPREHENSIVE_REPORT.pdf`](FPGA_code/docs/INVERTED_MAML_CARD2_1000EP_K4_W3_STAIRCASE_COMPREHENSIVE_REPORT.pdf) (Complete 10-page publication report for $K=4$, with Markdown version [here](FPGA_code/docs/INVERTED_MAML_CARD2_1000EP_K4_W3_STAIRCASE_COMPREHENSIVE_REPORT.md))

  - **7. Note on Upcoming Physical Oscilloscope Verification:**  
    The metrics reported above were captured via high-speed bare-metal differential SAR ADC telemetry (`XC2361A`, $\text{ADC}_{45}$) over Ethernet with crystal-locked $10.0\text{ ms}$ refresh timing. Direct physical oscilloscope verification of the analog circuit nodes (probing ColTIA virtual ground summing junctions `CH1`–`CH6`, the 24 µs Hadamard carrier burst modulation on 2T1C capacitor gates, and Sigmoid 4 analog activation outputs) will be conducted separately in an upcoming bench session to provide direct visual correlation between digital telemetry and physical analog waveforms.

- **2026-11-06 (Temporal Window Shift Exploration: [5.0 .. 6.0 ms] on Card 2 Silicon):**
  - **1. Objective & Shifted Temporal Parameters:**  
    Following the [4.5 .. 5.5 ms] benchmark, the 11-strata sampling window was shifted +0.5 ms upwards in time to **[5.0 .. 6.0 ms]** (11 strata: 5000, 5100, ..., 6000 µs), leaving all other parameters identical (1000 epochs, $W_3$ staircase $\pm 40\text{ LSB}$, White Noise, $\text{LR}=0.02\times$, $\lambda=2048$, dynamic swing $\pm 40\text{ LSB}$, $\pm 5\text{ LSB}$ non-stationary disturbance shifts, and 1:1 paired ablation control $W_8=0$).
  - **2. Observations Across the Discharge Slope:**  
    In this later temporal window, the 2T1C analog gate capacitors ($100\text{ nF}$) discharge for an extra 500 µs, increasing transconductance droop. While uncompensated baseline precision declines at later snapshot times (reaching $3.39\text{ b}$ at 6.0 ms), the active Inverted MAML compensation network provides sustained error suppression across the later strata, showing net gains of **+0.23 b to +0.75 b** between 5.4 ms and 6.0 ms. At the nominal 5.5 ms center snapshot, precision reached **$5.19\text{ b}$** (peaking at **$6.73\text{ b}$**, with best evaluation loss of $1\,118.0\text{ LSB}^2$, a $17.0\times$ reduction relative to baseline).
  - **3. Empirical Visualizations ([5.0 .. 6.0 ms] Window):**
    
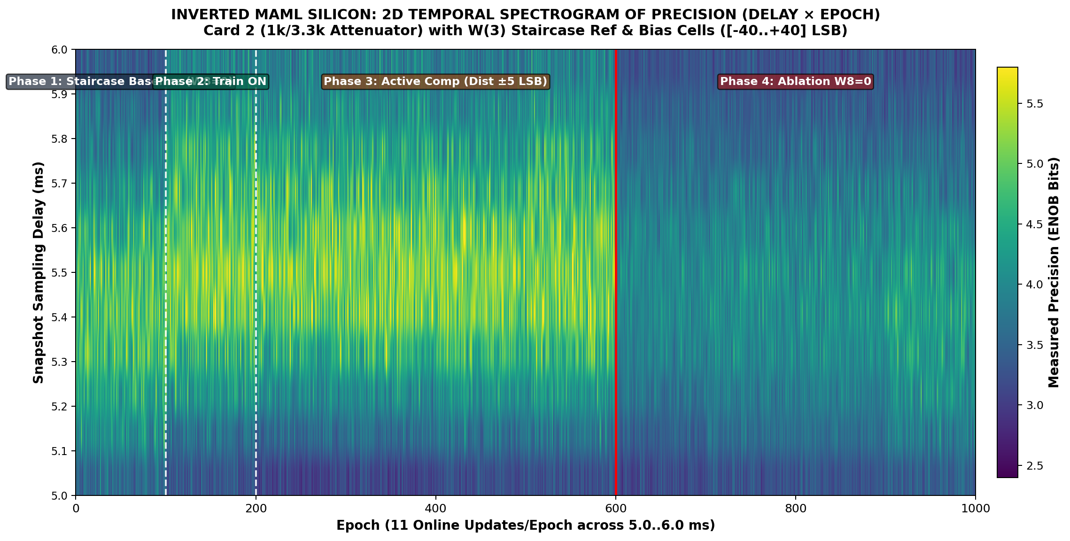
[picture p13: FPGA_code/docs/figures/fig_card2_w3_staircase_temporal_heatmap_spectrogram_5000to6000us.png]
Inverted MAML Silicon: 2D Temporal Spectrogram of Precision (5.0-6.0 ms)
    
    *Figure: 2D Temporal Spectrogram of Precision (Delay × Epoch) across the shifted [5.0 .. 6.0 ms] window on Card 2 live silicon (K=1 Online SGD). Note the instantaneous precision illumination at Epoch 100 when training is engaged, active disturbance tracking in Phase 3, and immediate precision collapse across the entire window when $W_8$ is clamped to 0 in Phase 4.*

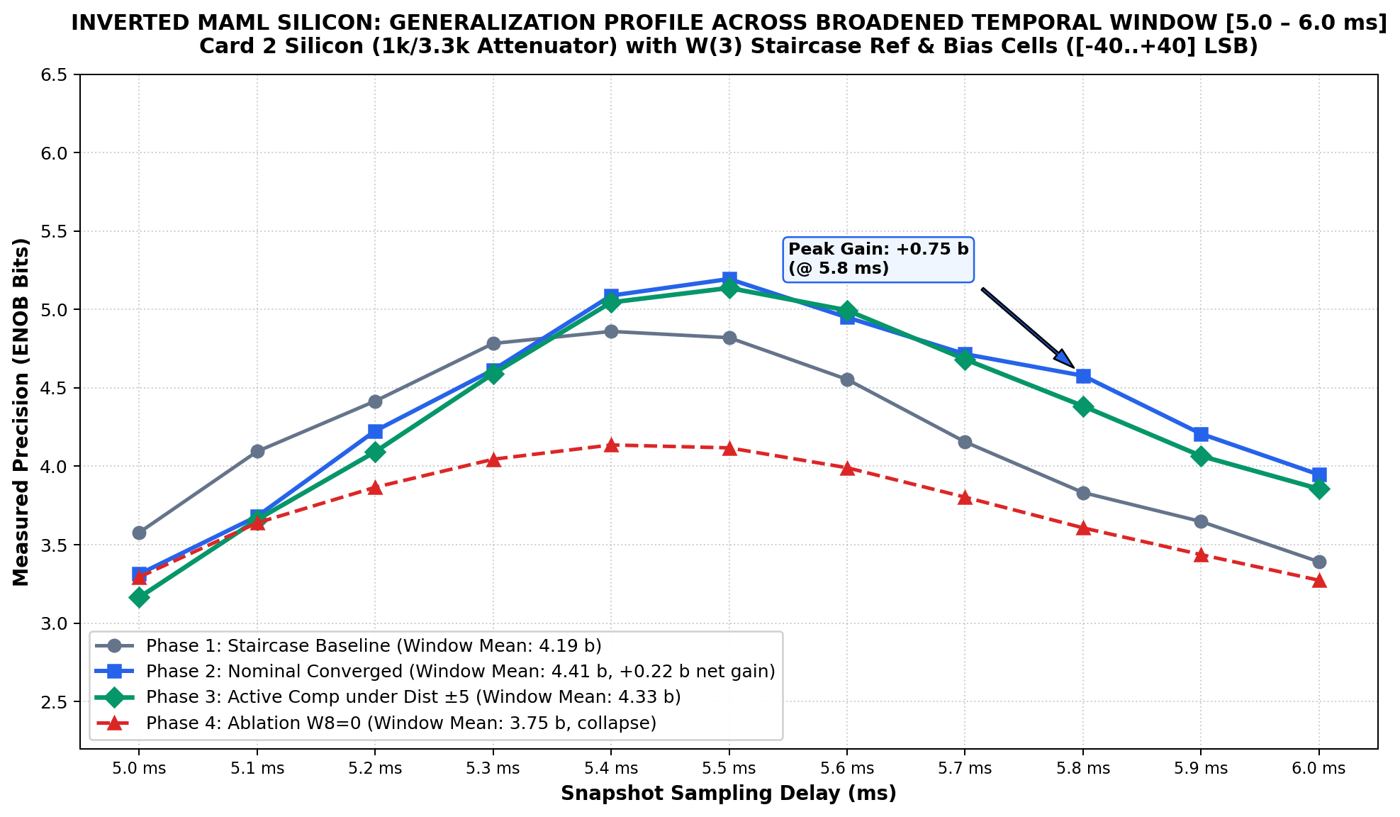
[picture p14: FPGA_code/releases/Release_20261107_ModeA_Card2_TimingSolid_VerilogEngine_Comprehensive/reports_and_logs/figures/fig_card2_w3_staircase_temporal_profile_4phases_5000to6000us.png]
Inverted MAML Silicon: Generalization Profile Across Shifted Temporal Window [5.0 - 6.0 ms]
    
    *Figure: Generalization profile across 11 discrete strata [5.0 .. 6.0 ms] across the 4 experimental phases. Active compensation provides the largest error reduction (+0.23 to +0.75 b) in the late temporal region (5.4–6.0 ms) where capacitor discharge is most pronounced, while Phase 4 ablation collapses back to baseline levels.*

  - **4. Comprehensive Report:**  
    - [📄 `INVERTED_MAML_CARD2_1000EP_5000TO6000US_W3_STAIRCASE_COMPREHENSIVE_REPORT.pdf`](FPGA_code/docs/INVERTED_MAML_CARD2_1000EP_5000TO6000US_W3_STAIRCASE_COMPREHENSIVE_REPORT.pdf) (Complete 10-page publication report for [5.0..6.0 ms], with Markdown version [here](FPGA_code/docs/INVERTED_MAML_CARD2_1000EP_5000TO6000US_W3_STAIRCASE_COMPREHENSIVE_REPORT.md))

  - **5. Planned Oscilloscope Bench Verification:**  
    As with the previous runs, this shifted-window dataset was collected via differential ADC telemetry (`XC2361A`, $\text{ADC}_{45}$) over Ethernet. Direct physical oscilloscope verification of the analog circuit nodes across this shifted 5.0–6.0 ms range will be conducted separately in a dedicated bench session.

- **2026-11-08 (Continuous 20-Minute Thermal Stress & Real-Time Mode A Drift Rejection on Card 2 Silicon):**
  - **1. Objective & Physical Thermal Excitation:**  
    Conducted an intensive 20-minute physical thermal stress validation on Card 2 live silicon (PCBA v1.3.2 | Trion T120 Master SoC + Trion T20 Coprocessor, Mode A, 1k/3.3k attenuator) across the focused temporal window **[5.0 ms .. 5.4 ms]** (5 strata @ 100 µs step, center 5.2 ms). Thermal stress was physically applied via 4 on-board power resistors driven at **30% duty cycle pulsed at 1.0 Hz PWM** (300 ms ON / 700 ms OFF) in an **8.0 min ON / 8.0 min OFF** thermal cycle, interleaved with a **2.0 min ON / 2.0 min OFF** Mode A online SGD regulation cycle ($K=2$, $\text{LR}=0.02$, $\lambda=768$).
  
  - **2. Core Results: 2x2 Factorial Performance Summary (3,331 Epochs):**

    | Factorial Condition | Thermal State | Regulation State | Mean Loss (LSB²) | Window ENOB | 5.2 ms Center ENOB | Matrix 8 Dynamic Envelope | Performance Delta |
    | :--- | :--- | :--- | :---: | :---: | :---: | :---: | :---: |
    | **1. Warm Closed-Loop** | Heaters ON (30% @ 1Hz) | Comp ON (SGD, K=2, λ=768) | **22,067.4 L²** | **4.62 b** | **5.01 b** | [-51, +72] LSB | Baseline Reference |
    | **2. Warm Open-Loop** | Heaters ON (30% @ 1Hz) | Comp OFF (Ablation W8=0) | **30,557.5 L²** | **4.36 b** | **4.69 b** | [0, 0] LSB | Warm Uncompensated |
    | **3. Cold Closed-Loop** | Heaters OFF (Cooling) | Comp ON (SGD, K=2, λ=768) | **22,753.5 L²** | **4.69 b** | **5.00 b** | **[-32, +117] LSB** | **-69.9% Error Reduction** (+1.00 b Gain) |
    | **4. Cold Open-Loop** | Heaters OFF (Cooling) | Comp OFF (Ablation W8=0) | **75,637.8 L²** | **3.70 b** | **3.72 b** | [0, 0] LSB | **+2.48x Error Surge** (Severe Degradation) |

  - **3. Empirical Visualizations & Real-Time Hardware Telemetry:**

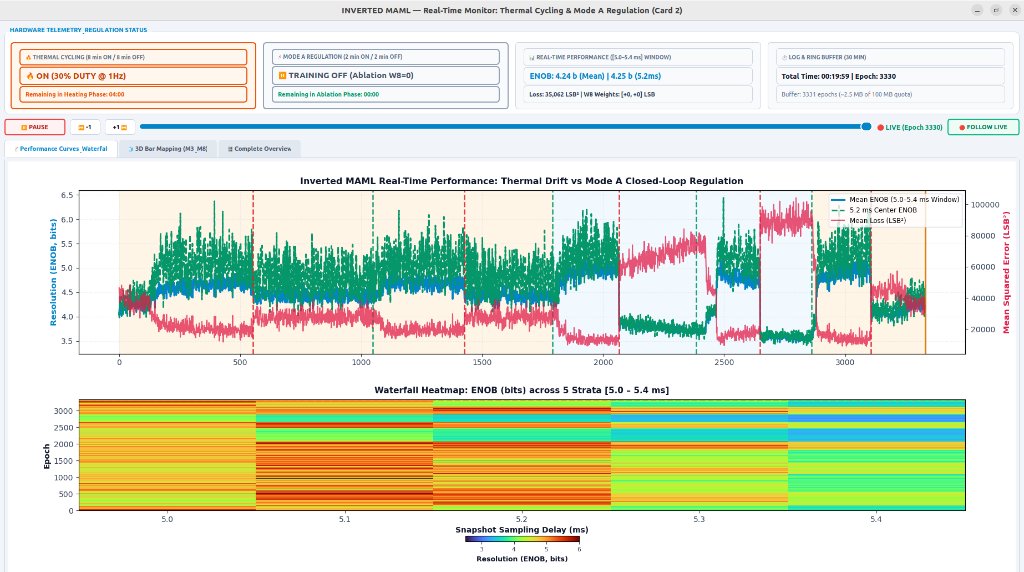
[picture p15: FPGA_code/docs/figures/fig_card2_thermal_gui_full_run.jpg]
Real-Time Thermal Monitor GUI: Complete 20-Minute Run
    
    *Figure: Real-time GUI monitor capturing the complete 20-minute (3,331-epoch) execution on Card 2 silicon. Notice the catastrophic loss spike up to 75,638 LSB² (ENOB collapsing to 3.70 b) when regulation is turned OFF during the cooling phase, and the instantaneous recovery to ~13,600 LSB² (5.11 b) when Mode A SGD re-engages.*

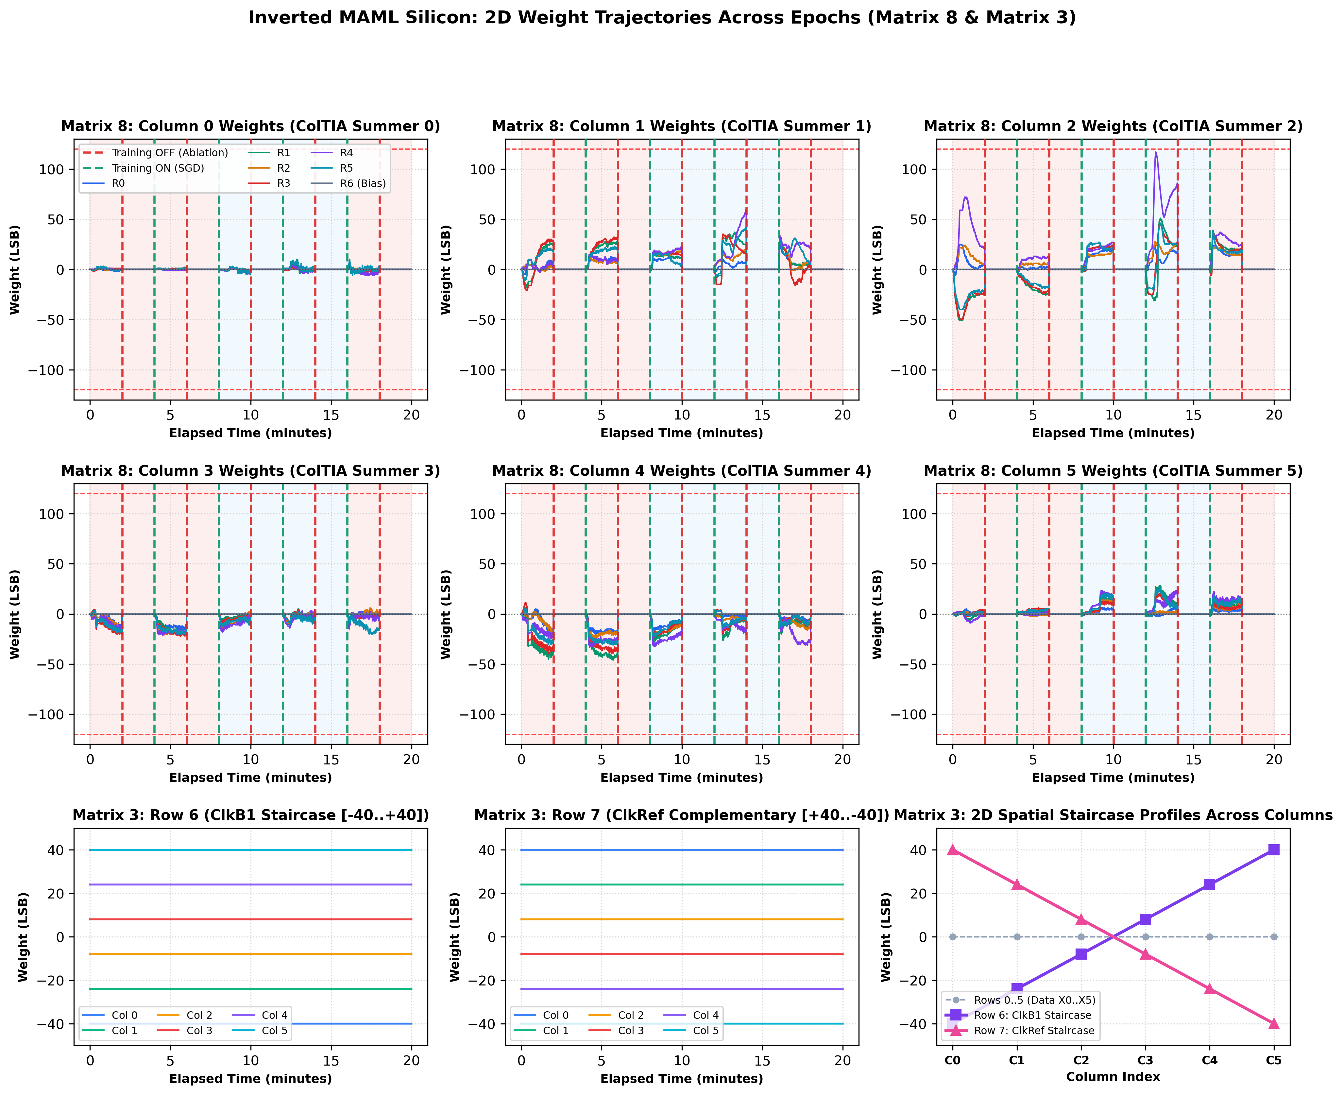
[picture p16: FPGA_code/docs/figures/fig_card2_thermal_2d_matrices.png]
Matrix 8 & Matrix 3 2D Weight Trajectories Across Epochs
    
    *Figure: 2D dynamic weight trajectories across all 3,331 epochs. (Top 6 Panels) Individual weight trajectories for the 7 rows of Matrix 8 (R0..R5 active inputs, R6 hardware bias) plotted in 7 distinct colors across each of the 6 physical columns (Col 0..5, ColTIA summing junctions) with ±120 LSB clamping rails. (Bottom 6 Panels) Dynamic weight trajectories for Matrix 3 across input columns 0..5, showing the active data weights (Rows 0..5, solid curves) and fixed reference clock staircases (Row 6 ClkB1 [-40..+40] LSB, Row 7 ClkRef [+40..-40] LSB, dashed curves). Background shading denotes Heater ON (30% duty @ 1 Hz, amber) vs. Cooling (blue); vertical dashed lines denote Training ON (green) vs. Ablation W=0 (red). Both matrices actively track thermal expansion, flatline to 0 during ablation intervals, and deploy asymmetric headroom (up to +117 LSB on M8, -73 LSB on M3) during cooling to neutralize transistor drift.*

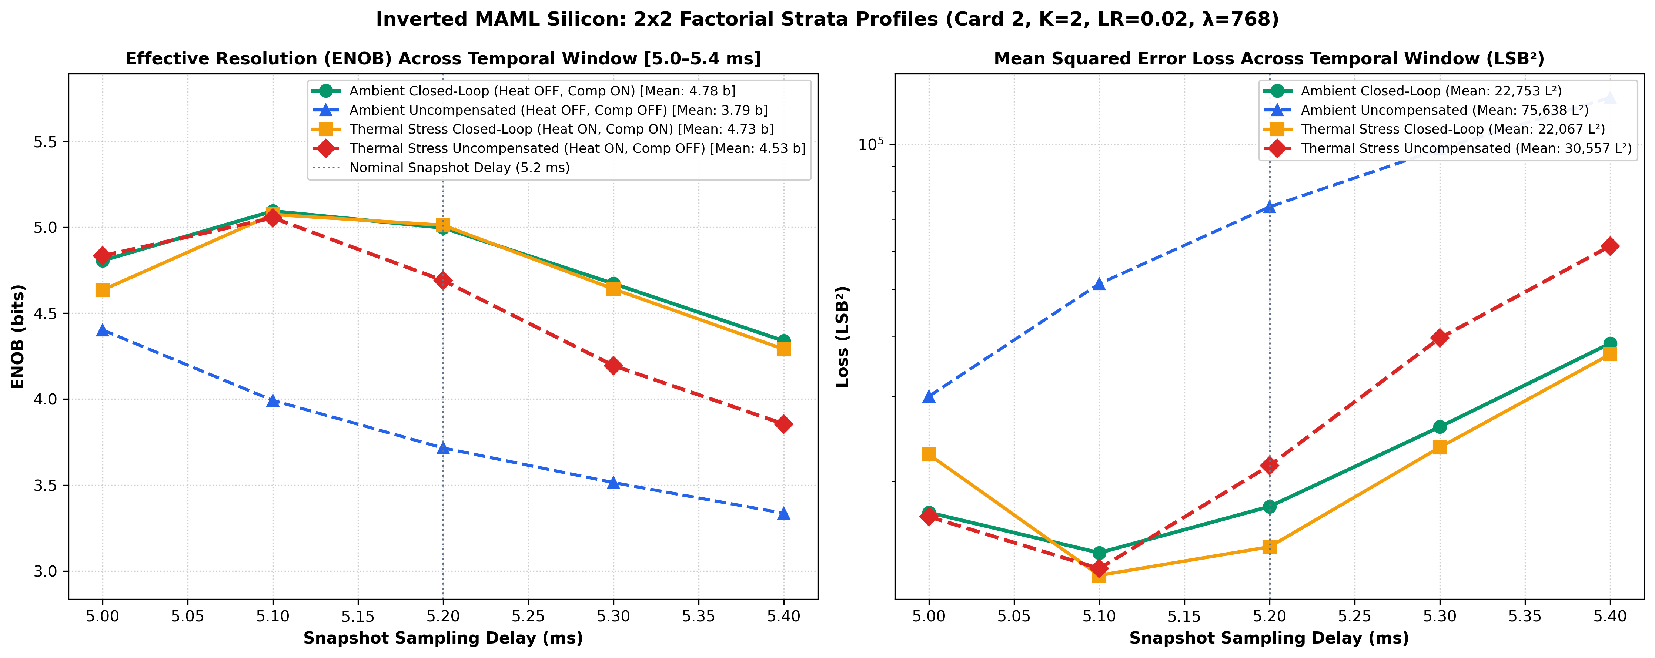
[picture p17: FPGA_code/docs/figures/fig_card2_thermal_strata_profiles.png]
Temporal Strata Profiles across Window [5.0 - 5.4 ms]
    
    *Figure: 5-Strata profiles across [5.0 – 5.4 ms] for all four factorial conditions. Active online Mode A compensation (amber and green curves) elevates precision across the entire window by +1.00 bit relative to the uncompensated cold drift baseline (blue dashed curve).*

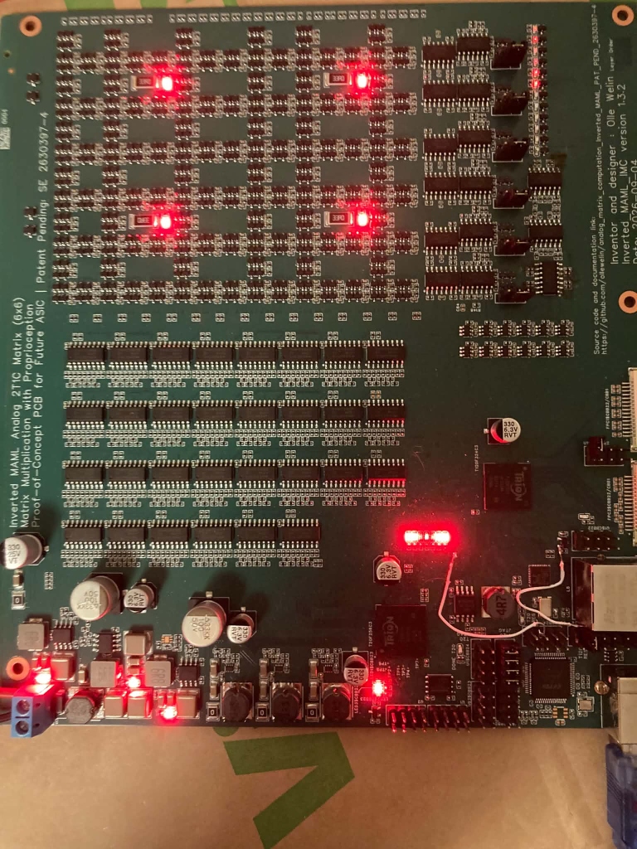
[picture p18: FPGA_code/releases/Release_20261108_ModeA_Card2_ThermalStress_Cycling_30pctDuty_1Hz/reports_and_logs/figures/fig_card2_pcb_thermal_heaters.jpg]
Card 2 Hardware Photograph Operating Under Active Thermal Stress
    
    *Figure: Photograph of Inverted MAML Proof-of-Concept PCB v1.3.2 (Card 2) operating on the lab bench during active thermal stress. The 4 on-board point heaters glow red across the Dual-2T1C analog matrix array.*

  - **4. Key Physical & Engineering Insights:**
    - **Thermal DC Calibration Epoch vs. Weight Baseline:** Hardware DC zero-calibration (`g_adc49_zero_cal`) measures physical quiescent op-amp offsets at $t=0$, freezing the digital supervisor target $Z_{\text{target}}$. Because calibration occurred on warm silicon, $Z_{\text{target}}$ was anchored to the warm operating point. When heaters were turned off at minute 8, cooling silicon drifted far from this warm target, causing open-loop ablation error ($W_8=0$) to surge to **$75\,638\text{ LSB}^2$ ($3.70\text{ b}$)**.
    - **L2 Restoring Force ($\lambda \cdot W_8$) & Dynamic Headroom:** L2 regularization acts as a mechanical spring pulling weights toward $W_{\text{null}}=0$ ($\text{decay} = \lambda \cdot W_8$). In the cold phase, the compensator expanded up to **$+117\text{ LSB}$** (98% of the $\pm 120\text{ LSB}$ clamping rail), with the Hadamard gradient continuously overcoming this L2 spring force ($\approx 1.37\text{ LSB/step}$) to maintain $\approx 5\text{ bit}$ resolution.
    - **Spatial Thermal Gradients (Discrete PCBA vs. Monolithic ASIC):** The 4 discrete point heaters create steep, uneven spatial thermal gradients across the low-conductivity FR-4 board ($\kappa \approx 0.3\text{ W/m}\cdot\text{K}$). On a future monolithic CMOS ASIC, the compact die area and >500x higher thermal conductivity of silicon ($\kappa \approx 150\text{ W/m}\cdot\text{K}$) ensure nearly isothermal coupling. Inverted MAML's proven ability to handle severe, uneven spatial point-heater hotspots on a discrete PCB demonstrates that closed-loop compensation on an ASIC will be even more uniform, stable, and precise.

  - **5. Official Comprehensive Report:**
    - [📄 `INVERTED_MAML_CARD2_THERMAL_STRESS_COMPREHENSIVE_REPORT.pdf`](FPGA_code/docs/INVERTED_MAML_CARD2_THERMAL_STRESS_COMPREHENSIVE_REPORT.pdf) (Complete 11-page publication report in English, with Markdown version [here](FPGA_code/docs/INVERTED_MAML_CARD2_THERMAL_STRESS_COMPREHENSIVE_REPORT.md))

- **2026-11-14 (Card 1 Cold-Start 2-Beat Analog Bit Slicing, Integrated-L2 Anti-Windup & 8-Round Thermal Hyperparameter Optimization):**
  - **1. Objective, Hardware Setup & Firmware Fixes (`T120_SOC_ETH_FW v2.2-MAML`, `HW_LOGIC 0x20261030`):**  
    Validated 2-beat time-division multiplexed **Analog Bit Slicing (`K = 1`)** on **Card 1 (`Trion T120F324` Master SoC + `Trion T20F256` Coprocessor, `1k / 2.2k` passive summing attenuator)** under active hardware thermal stress (**`40%` duty-cycle staggered `0.2 Hz` PWM heating**). To isolate pure hyperparameter sensitivity across rounds without baking cumulative PCB heat into calibration targets, all experiments locked the static 25 °C ambient DC calibration vectors (`alpha`, `beta`) from Round 1 in [`FPGA_code/config/r1_dc_cal_fixed.json`](FPGA_code/config/r1_dc_cal_fixed.json). Key firmware breakthroughs in `v2.2-MAML` include:
    1. **Two-Layer `dx8` Backpropagation Sign & `M3` Scaling Fix:** Corrected the sign inversion in `dx8[i]` accumulation (`err49[j]` $\to$ `-err49[j]`), tuned `grad_m3_out` shift to `>> 6`, and bounded active `M3` rows `0..5` to `±max(15, clamp/3)` (`±25 LSB` at `clamp=75`) via `sat_comp_m3_q14()` so dynamic adaptation never corrupts the frozen `±40 LSB` temporal reference staircases (`M3` rows `6..7`).
    2. **Integrated-L2 Back-Calculation Anti-Windup (`maml_momentum_step_antiwindup`):** Folded L2 decay directly inside velocity updates and projected stored momentum velocity to realized clamped steps whenever weights touch `±clamp`, eliminating rail-bounce limit cycles.
    3. **Ethernet Minimum-Frame & Verified Clamp Handshake:** Preserved 60-byte padded IEEE 802.3 command reception (`MAML_CMD_BATCH_STEP`) and added `verify_hw_clamp()` telemetry readback verification before each run.

  - **2. Core Results — 2x2 Factorial Accounting, 8-Round Locked-DC Search (`R1dc_fix..R8dc_fix`) & 13-Min Sustained Verification:**

    | Factorial Condition | Thermal State | Regulation State | Mean Loss (LSB²) | Mean Comb ENOB | Peak Comb ENOB | MSB / LSB Mean | W8 Range [MSB / LSB] |
    | :--- | :--- | :--- | :---: | :---: | :---: | :---: | :---: |
    | **1. Cold Closed-Loop** | Heaters OFF (0%) | Comp ON (`K=1`, `L2=2048`) | `3,748.0 L²` | **9.45 b** | `9.50 b` | `5.58 / 5.83 b` | `[-13, 13]` / `[-6, 7]` |
    | **2. Cold Open-Loop** | Heaters OFF (0%) | Comp OFF (`W8=0`) | `3,947.3 L²` | **9.45 b** | `9.50 b` | `5.53 / 5.84 b` | `[0, 0]` (0% leak) |
    | **3. Warm Closed-Loop** | Heaters ON (`40%` PWM) | Comp ON (`K=1`, `L2=2048`) | **`50,580.5 L²`** | **`7.19 b`** | `9.50 b` | `3.75 / 3.83 b` | `[-75, 75]` / `[-75, 75]` |
    | **4. Warm Open-Loop** | Heaters ON (`40%` PWM) | Comp OFF (`W8=0`) | `106,727.2 L²` | `5.66 b` | `7.65 b` | `3.14 / 3.21 b` | `[0, 0]` (0% leak) |

    **Multi-Round Locked-DC Optimization Summary (`R1dc_fix..R8dc_fix`, vs. Continuous PCHIP Thermal Baseline $E_{\text{base}}(t)$):**

    | Round | LR | L2 Reg | Mom | Clamp | Lift vs `E_base` | Loss Ratio | Hot Climb | Jitter | Recov | Composite Score |
    | :--- | :---: | :---: | :---: | :---: | :---: | :---: | :---: | :---: | :---: | :---: |
    | `R1dc_fix` | `0.03` | `1024` | `0.9` | `±75` | `+1.00 b` | `1.71x` | `+0.95 b` | `0.40 b` | `0.00` | **`+1.799`** |
    | `R2dc_fix` | `0.035` | `1536` | `0.85` | `±75` | `+0.99 b` | `1.69x` | `+1.16 b` | `0.39 b` | `0.00` | **`+1.957`** |
    | `R3dc_fix` | `0.02` | `2560` | `0.8` | `±70` | `+0.04 b` | `1.00x` | `+0.24 b` | `0.34 b` | `1.00` | **`+0.204`** |
    | `R4dc_fix` | `0.05` | `1792` | `0.85` | `±70` | `+1.08 b` | `1.78x` | `+0.97 b` | `0.40 b` | `0.50` | **`+2.480`** |
    | `R5dc_fix` | `0.055` | `1792` | `0.85` | `±85` | `+1.12 b` | `1.77x` | `+1.37 b` | `0.42 b` | `0.00` | **`+2.393`** |
    | `R6dc_fix` | `0.055` | `1792` | `0.8` | `±90` | `+0.99 b` | `1.72x` | `+1.02 b` | `0.40 b` | `0.00` | **`+1.770`** |
    | **`R7dc_fix` ★** | **`0.055`** | **`2048`** | **`0.85`** | **`±75`** | `+1.04 b` | `1.74x` | `+1.17 b` | `0.40 b` | `0.50` | **`+2.665`** |
    | **`R8dc_fix` (13m Verify)** | **`0.055`** | **`2048`** | **`0.85`** | **`±75`** | **`+1.16 b`** | **`1.85x`** | `+0.68 b` | `0.42 b` | `0.00` | **`+1.855`** |

    **Phase-by-Phase Telemetry for the 13-Minute Sustained Verification Run (`R8dc_fix`, last `7,200` ring-buffered pairs `P3..P8`):**

    | Phase | Regime | Pairs | Comb ENOB (`Start -> Late`, Mean) | Δ vs `E_base` | Total Loss (`Start -> Late`) | Loss Ratio | W8 Peak `[M, L]` | W3 Peak |
    | :--- | :--- | ---: | :---: | :---: | :---: | :---: | :---: | :---: |
    | `P3` | Warm / Regler ON | 1672 | `8.33 -> 7.58` (**7.95 b**) | **`+1.29 b`** | `20,916 -> 41,271` | **`1.93x`** | `[75, 75]` | `25` |
    | `P4` | Warm / Regler OFF | 1230 | `6.37 -> 5.85` (`6.09 b`) | `+0.02 b` | `70,958 -> 94,606` | `1.00x` | `[0, 0]` | `0` |
    | `P5` | Warm / Regler ON | 1254 | `6.02 -> 6.70` (**6.75 b**) | **`+1.08 b`** | `87,755 -> 62,399` | **`1.78x`** | `[75, 75]` | `25` |
    | `P6` | Warm / Regler OFF | 950 | `5.53 -> 5.43` (`5.49 b`) | `+0.01 b` | `111,378 -> 117,807` | `1.00x` | `[0, 0]` | `0` |
    | `P7` | Warm / Regler ON | 1105 | `5.63 -> 6.49` (**6.52 b**) | **`+1.16 b`** | `107,093 -> 68,701` | **`1.84x`** | `[75, 75]` | `25` |
    | `P8` | Warm / Regler OFF | 989 | `5.33 -> 5.26` (`5.29 b`) | `-0.00 b` | `124,102 -> 129,302` | `1.00x` | `[0, 0]` | `0` |

  - **3. Empirical Visualizations & Full 180-Synapse Weight Telemetry (`84 W(8)` + `96 W(3)`):**

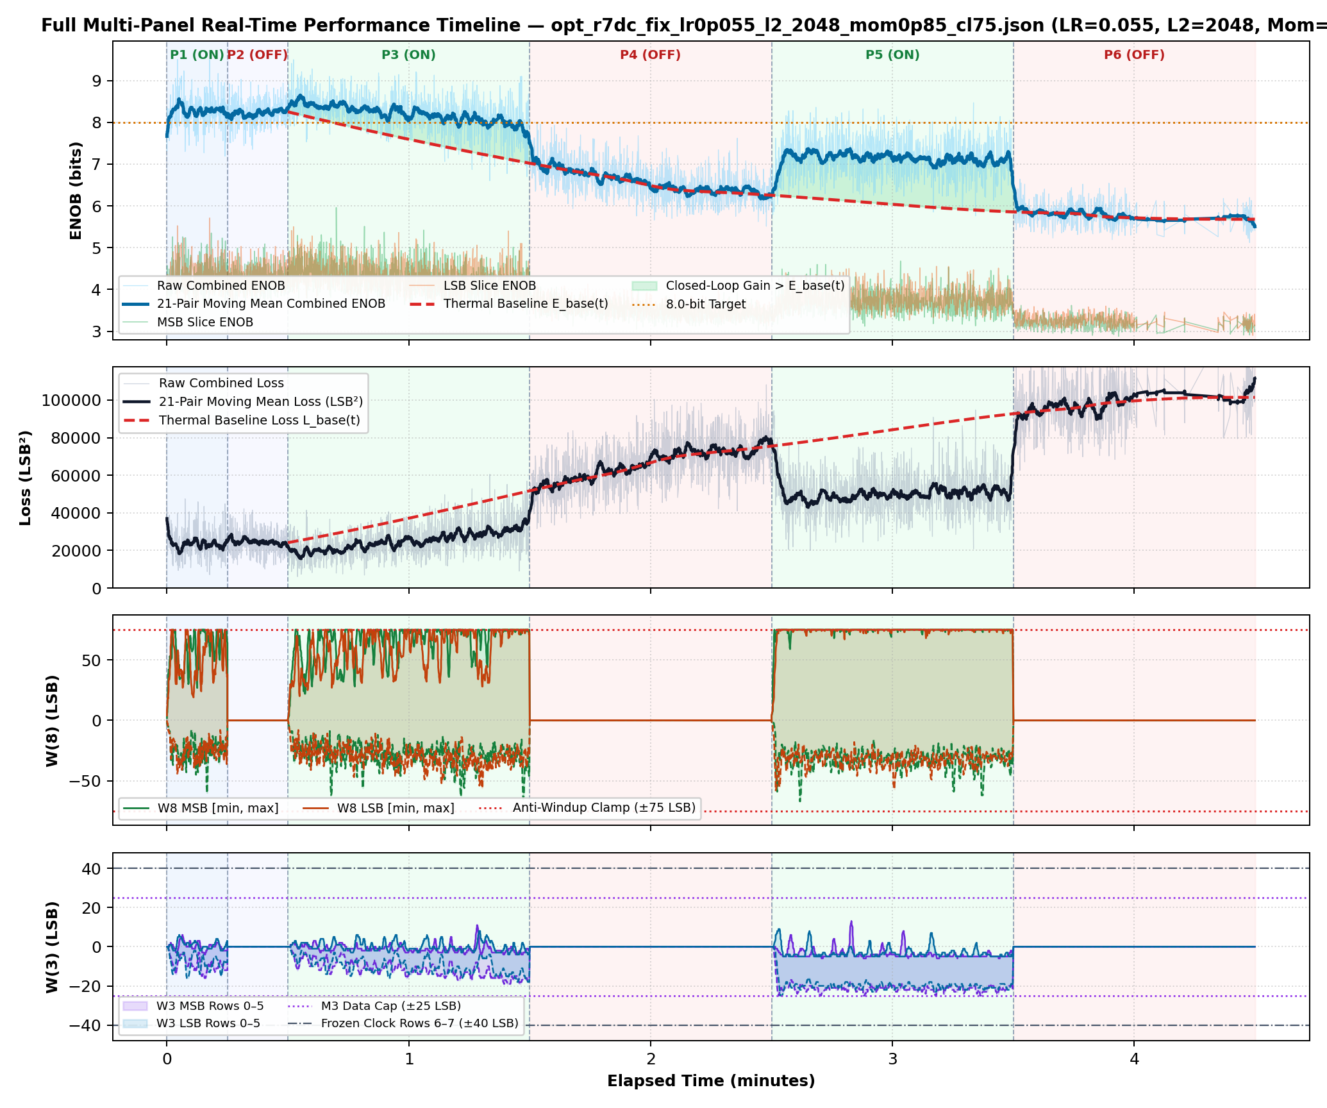
[picture p19: FPGA_code/docs/figures/fig_card1_bs_comp_timeline.png]
Card 1 13-Minute Bit-Slicing Thermal Performance Timeline
    
    *Figure: Complete 13-minute verification timeline (`R8dc_fix`, `LR=0.055, L2=2048, Mom=0.85, Clamp=±75 LSB`) across `6 x 2.0 min` warm cycles (`P3..P8`). Closed-loop compensation maintains a consistent `+1.08 b` to `+1.29 b` ENOB lift (`1.78x`–`1.93x` loss suppression) above the continuous PCHIP uncompensated thermal drift curve $E_{\text{base}}(t)$ even as open-loop drift sinks to `5.29 b`.*

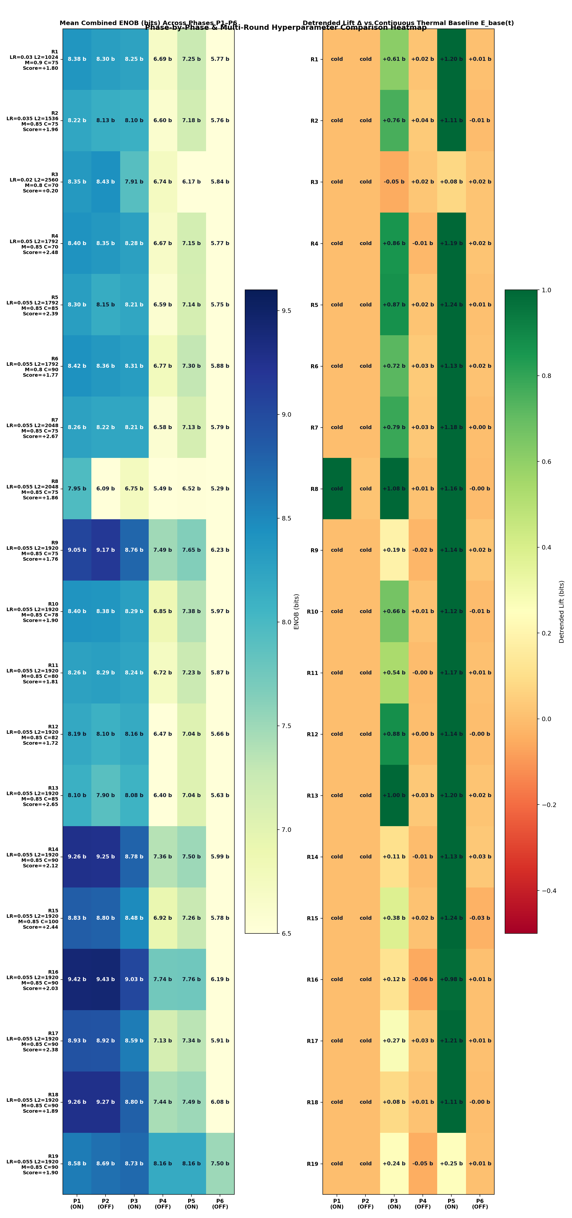
[picture p20: FPGA_code/docs/figures/fig_card1_bs_comp_heatmap.png]
Multi-Round & Phase-by-Phase Hyperparameter Comparison Heatmap
    
    *Figure: Multi-round hyperparameter comparison across `R1dc_fix..R8dc_fix` showing mean combined ENOB (left) and thermal-detrended lift vs. $E_{\text{base}}(t)$ (right), highlighting the low-LR under-drive collapse at `R3` (`LR=0.02, L2=2560`), the `R7dc_fix` composite optimum (`+2.665`), and sustained `R8dc_fix` 13-minute gains (`+1.16 b` detrended lift).*

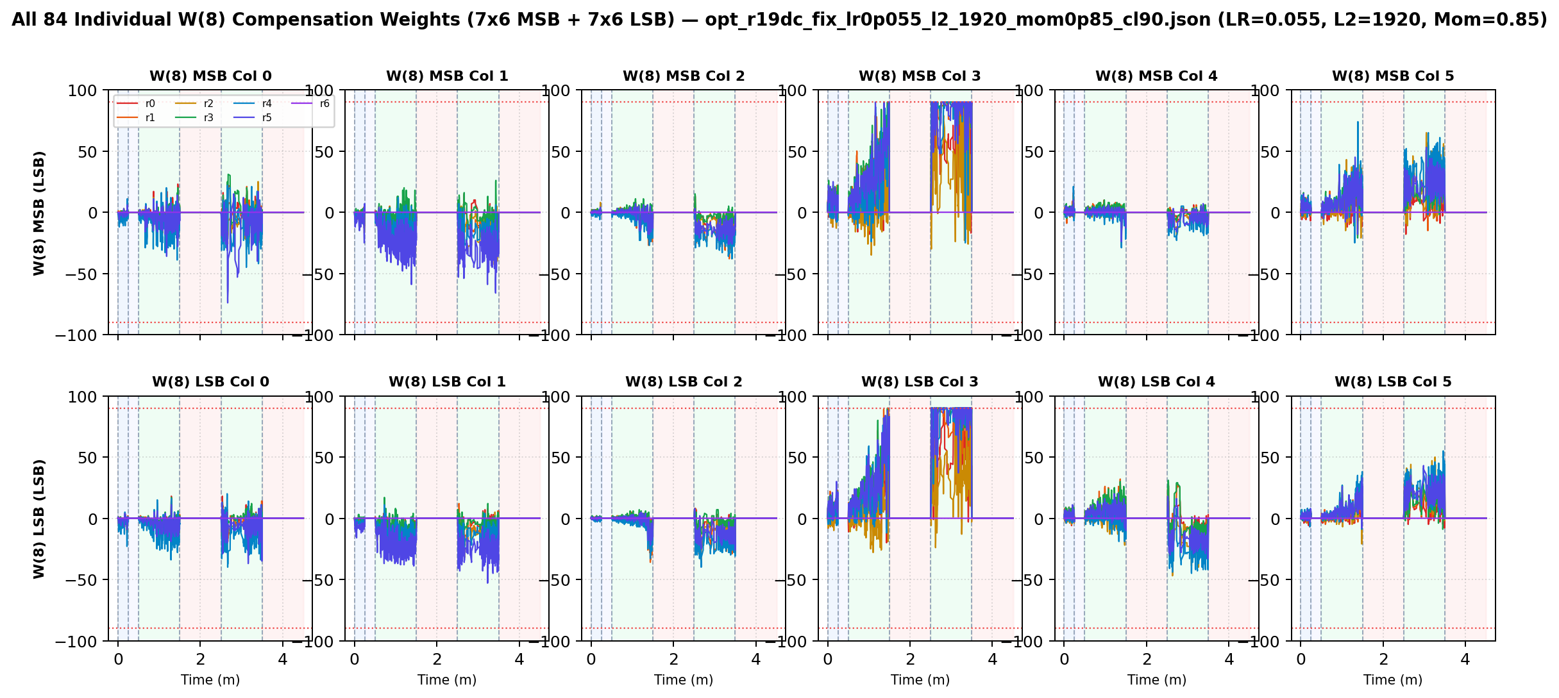
[picture p21: FPGA_code/docs/figures/fig_card1_bs_comp_all_w8_weights.png]
All 84 Individual W(8) Matrix Weights Across 13-Minute Run
    
    *Figure: Full per-synapse telemetry of all `84 W(8)` compensation weights (`7 rows x 6 cols` MSB + `7 rows x 6 cols` LSB) during the 13-minute verification run (`R8dc_fix`), cleanly clamping at `±75 LSB` with integrated-L2 anti-windup and dropping to `0` during OFF ablation phases.*

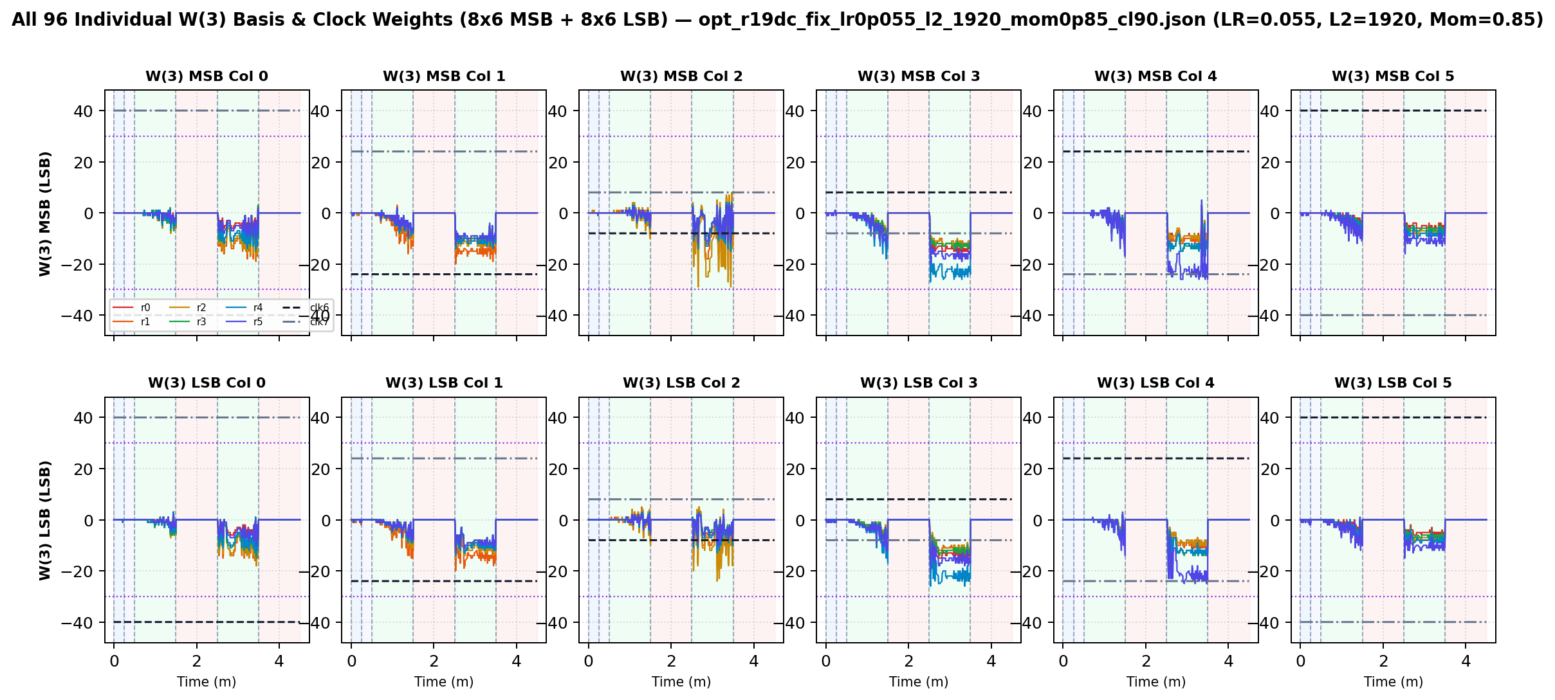
[picture p22: FPGA_code/docs/figures/fig_card1_bs_comp_all_w3_weights.png]
All 96 Individual W(3) Matrix Weights Across 13-Minute Run
    
    *Figure: Full per-synapse telemetry of all `96 W(3)` hidden-layer weights (`8 rows x 6 cols` MSB + `8 rows x 6 cols` LSB) during `R8dc_fix`, verifying that active data rows `0..5` stay bounded inside `±25 LSB` while frozen temporal clock staircase rows `6..7` (`±40 LSB`, dashed curves) remain untouched.*

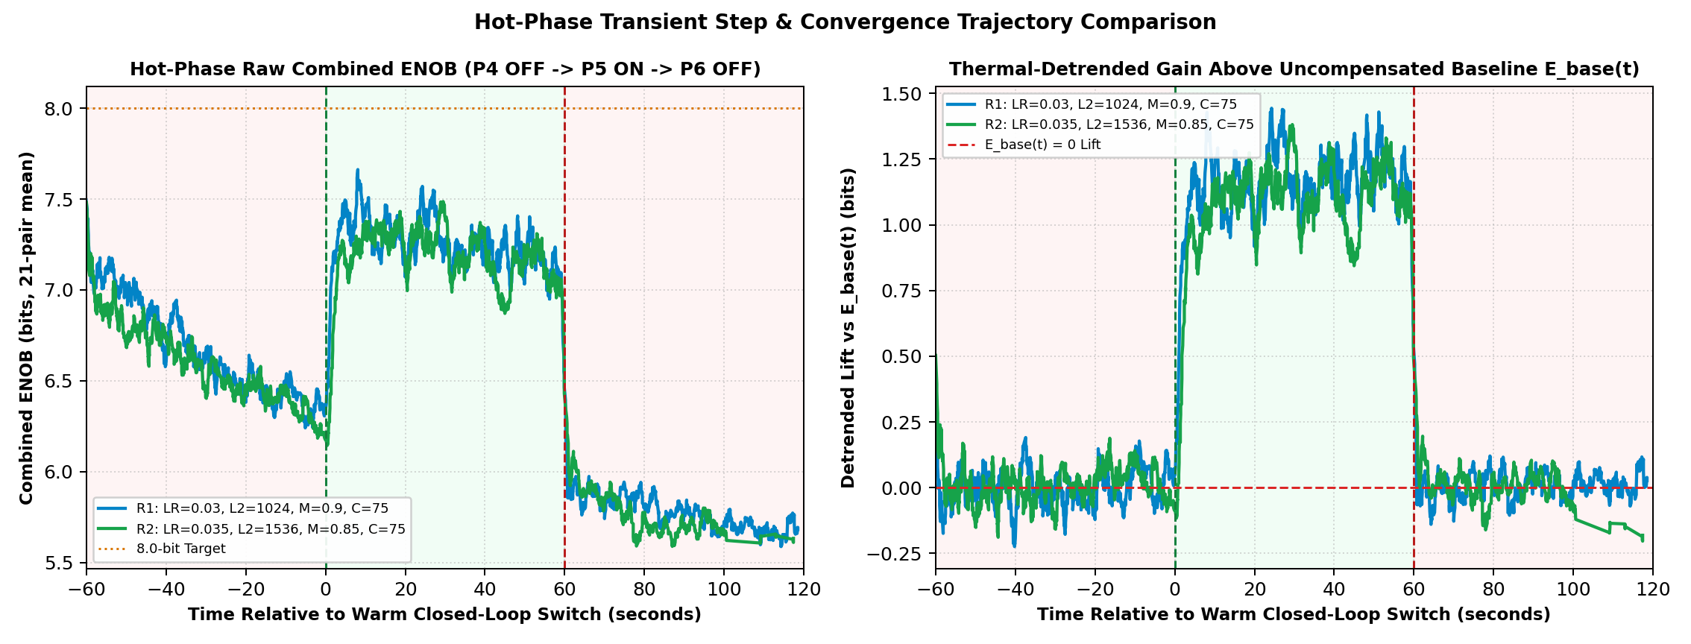
[picture p23: FPGA_code/docs/figures/fig_card1_bs_comp_hot_convergence.png]
Hot-Phase Convergence Trajectories Across R1dc_fix..R8dc_fix
    
    *Figure: Detrended warm closed-loop convergence trajectories comparing all 8 optimization rounds, illustrating rapid thermal drift rejection whenever `LR >= 0.05` and balanced `L2` restoring force is active.*

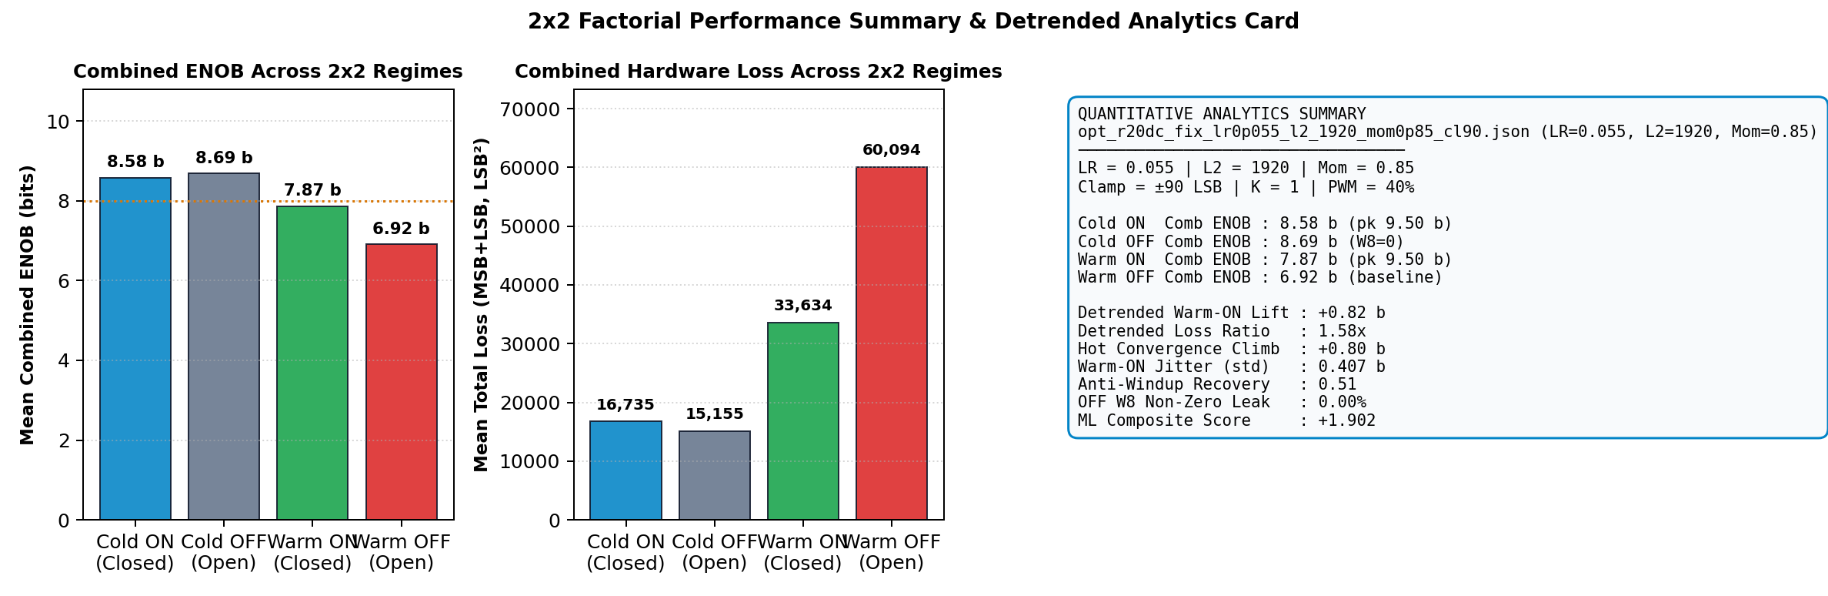
[picture p24: FPGA_code/docs/figures/fig_card1_bs_comp_factorial_summary.png]
2x2 Factorial Summary & Trend Metrics for Card 1 Bit Slicing
    
    *Figure: 2x2 factorial ENOB and mean loss summary (`Cold ON/OFF = 9.45 b`, `Warm ON = 7.19 b` vs. `Warm OFF = 5.66 b`) paired with detrended optimization scores.*

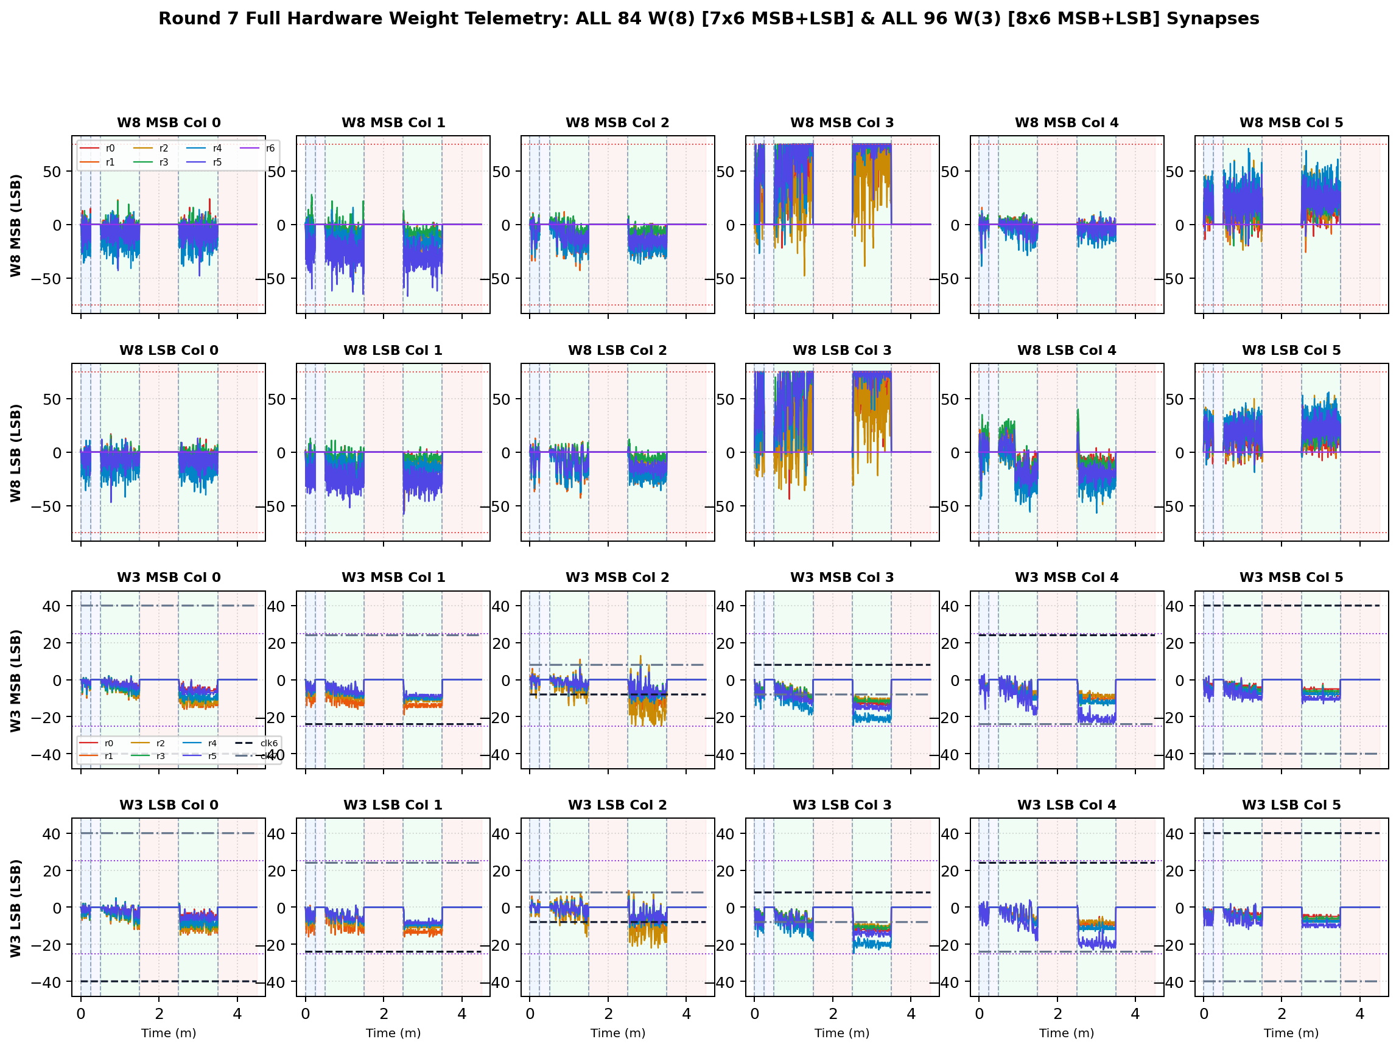
[picture p25: FPGA_code/releases/Release_20261114_ModeA_Card1_BitSlicing_AntiWindup_Baseline_R1/reports_and_logs/figures/fig_card1_r7dc_fix_lr0p055_l2_2048_mom0p85_cl75_w8_w3_all_weights.png]
Champion R7dc_fix Full 180-Weight Telemetry Across P1..P6
    
    *Figure: Complete 180-synapse weight trajectories (`84 W(8)` + `96 W(3)`) for the global short-run champion `R7dc_fix ★` (`LR=0.055, L2=2048, Mom=0.85, Clamp=±75 LSB`, Composite Score `+2.665`) across all 6 Cold+Warm phases (`P1..P6`).*

  - **4. Official Comprehensive & Per-Round Reports:**
    - [📄 `INVERTED_MAML_CARD1_BIT_SLICING_THERMAL_STRESS_FHP_COMPREHENSIVE_REPORT.pdf`](FPGA_code/docs/INVERTED_MAML_CARD1_BIT_SLICING_THERMAL_STRESS_FHP_COMPREHENSIVE_REPORT.pdf) (Complete 13-page Card 1 Bit-Slicing & FHP Comprehensive Report, with Markdown version [here](FPGA_code/docs/INVERTED_MAML_CARD1_BIT_SLICING_THERMAL_STRESS_FHP_COMPREHENSIVE_REPORT.md))
    - Per-round 2-page 180-weight reports: [R8dc_fix (13-min Verify)](FPGA_code/docs/INVERTED_MAML_CARD1_R8DC_FIX_LR0P055_L2_2048_MOM0P85_CL75_THERMAL_SLICING_REPORT.pdf) · [R7dc_fix ★ (Optimum `+2.665`)](FPGA_code/docs/INVERTED_MAML_CARD1_R7DC_FIX_LR0P055_L2_2048_MOM0P85_CL75_THERMAL_SLICING_REPORT.pdf) · [R6dc_fix](FPGA_code/docs/INVERTED_MAML_CARD1_R6DC_FIX_LR0P055_L2_1792_MOM0P80_CL90_THERMAL_SLICING_REPORT.pdf) · [R5dc_fix](FPGA_code/docs/INVERTED_MAML_CARD1_R5DC_FIX_LR0P055_L2_1792_MOM0P85_CL85_THERMAL_SLICING_REPORT.pdf) · [R4dc_fix](FPGA_code/docs/INVERTED_MAML_CARD1_R4DC_FIX_LR0P05_L2_1792_MOM0P85_CL70_THERMAL_SLICING_REPORT.pdf) · [R3dc_fix](FPGA_code/docs/INVERTED_MAML_CARD1_R3DC_FIX_LR0P02_L2_2560_MOM0P80_CL70_THERMAL_SLICING_REPORT.pdf) · [R2dc_fix](FPGA_code/docs/INVERTED_MAML_CARD1_R2DC_FIX_LR0P035_L2_1536_MOM0P85_CL75_THERMAL_SLICING_REPORT.pdf) · [R1dc_fix](FPGA_code/docs/INVERTED_MAML_CARD1_R1DC_FIX_LR0P03_L2_1024_MOM0P90_CL75_THERMAL_SLICING_REPORT.pdf)
    - Verified parameter registry & locked R1 DC calibration: [`FPGA_code/config/bit_slicing_hyperparams.json`](FPGA_code/config/bit_slicing_hyperparams.json), [`FPGA_code/config/r1_dc_cal_fixed.json`](FPGA_code/config/r1_dc_cal_fixed.json)

  - **5. Live Hardware Demo Example: Multi-Stage Thermal Stress & Bit-Slicing (2026-11-14):**

    **Section 6: Live Hardware Demo Execution & Multi-Stage Thermal Stress Benchmark:**
    - **Target Hardware:** Card 1 (`Trion T120F324` Master SoC + `Trion T20F256` Coprocessor, **`1k / 2.2k` Passive Summing Attenuator**)
    - **Firmware:** `T120_SOC_ETH_FW v2.2-MAML (SW Build Nov 14 2026 10:15:16)`, `HW_LOGIC: 0x20261030`
    - **Analog Architecture:** Dual-2T1C MOS Triode Differential Multipliers (M33 6x6, M3 8x6, M8 7x6) with Hadamard Attenuator Network

    This one-click demo performs a live multi-stage thermal stress and analog bit-slicing demonstration on Card 1 silicon, transitioning from ambient cold baseline through moderate heating (30% PWM) up to heavy thermal stress (40% PWM).

    **1. Start of Live GUI Monitor:**  
    In terminal 1, launch the live real-time visual monitor:
    ```bash
    /home/olle/anaconda3/bin/python gui/bit_slicing_live_gui.py
    ```
    *(Runs on X11 display, plotting combined 8-bit ENOB, MSB/LSB individual precision, total squared loss, and real-time W(8) and W(3) envelope trajectories with color-coded regulation regimes).*

    **2. Start of Live Hardware Demo:**  
    In terminal 2, launch the automated demo runner:

    - *Option A: Standard Full 14-Phase Demo (7.0 min active time, 30s per phase)*
      ```bash
      /home/olle/anaconda3/bin/python FPGA_code/scripts/run_demo.py
      ```

    - *Option B: Fast Audience Demo (3.5 min active time, 15s per phase)*
      ```bash
      /home/olle/anaconda3/bin/python FPGA_code/scripts/run_demo.py --phase-sec 15 --cooldown-sec 15
      ```

    **3. Demo Phase Schedule & Thermal Dynamics:**  
    The demo executes a 14-phase sequence across 4,702 sample pairs:
    1. **Cold Baseline (Phases 1–2, 0% Heat):** Phase 1 (Regler ON, 30s) & Phase 2 (Regler OFF, 30s) at ambient 25 °C establishing unheated reference (~8.6–8.7 bits).
    2. **Stage 1: Moderate Thermal Stress (Phases 3–8, 30% PWM Heater):** 6 alternating toggles (3 ON / 3 OFF) à 30s. The Inverted MAML loop tracks the gradual thermal drift, holding precision steady at 8.0–8.7 bits and lifting precision by +0.78 bits over free drift.
    3. **Stage 2: Intense Thermal Stress (Phases 9–14, 40% PWM Heater):** 6 alternating toggles (3 ON / 3 OFF) à 30s. When regulation is disabled, thermal drift accelerates loss past 103,000 LSB² (dropping uncompensated ENOB down to 5.7 bits). Each time regulation engages (e.g. Phase 13), precision instantly steps up by **`+1.25 bits`** and loss drops by **`1.87x`** (from 85k down to 54k LSB²), strictly bounded at ±90 LSB without saturation or clipping.

    **4. Empirical Visualizations from Live Demo (Round 20):**

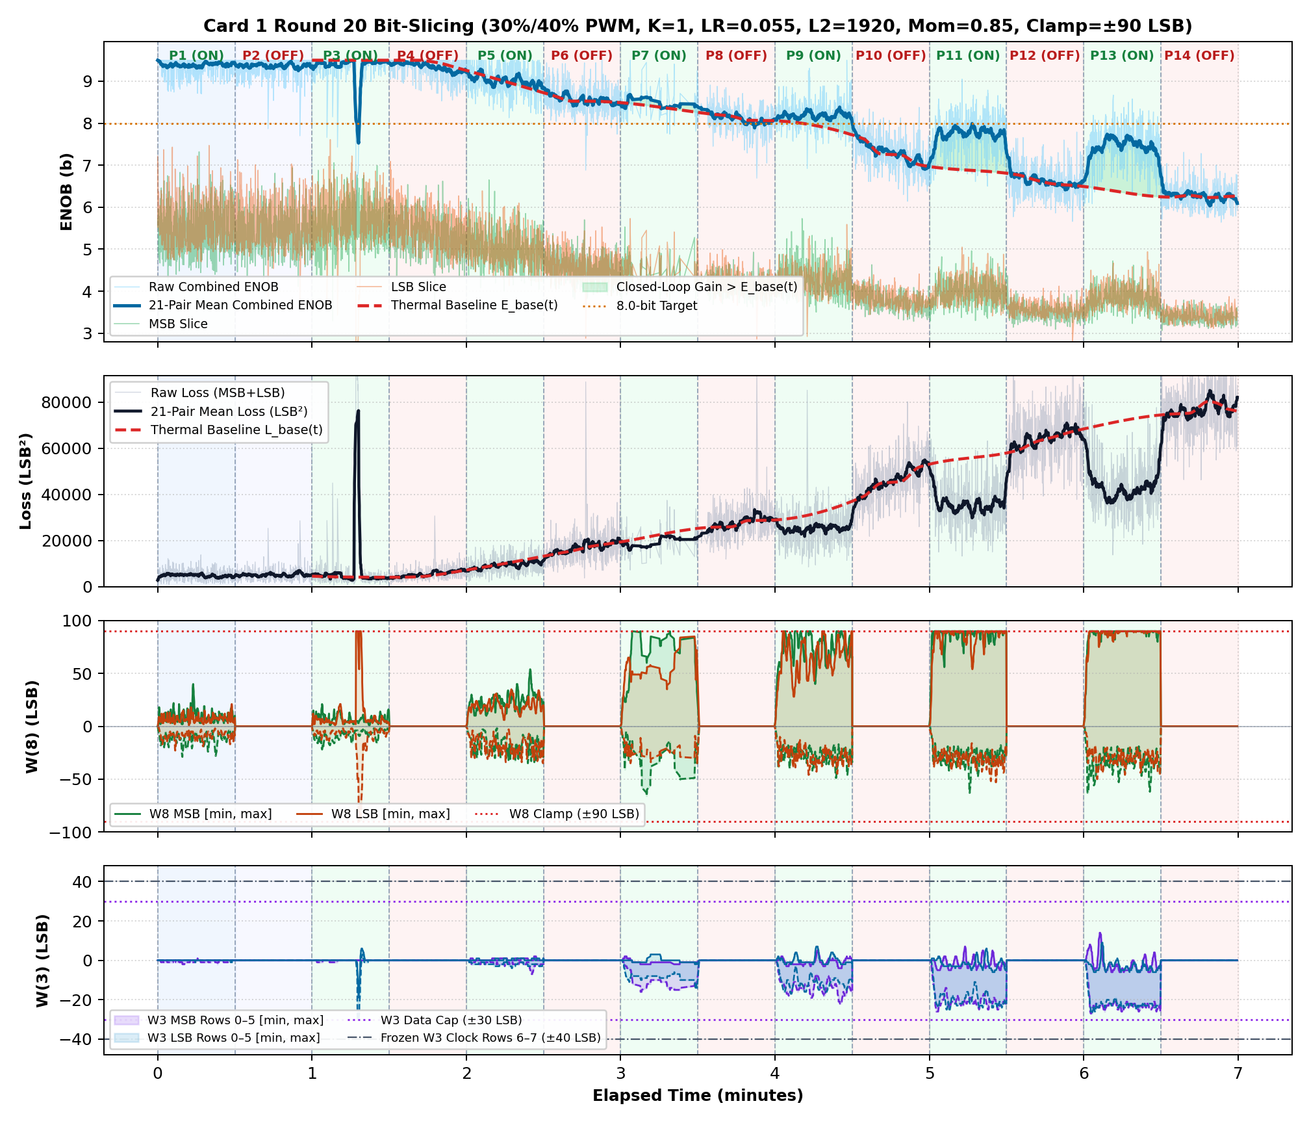
[picture p26: FPGA_code/docs/figures/fig_card1_r20_lr0p055_l2_1920_mom0p85_cl90_thermal_slicing.png]
Round 20 Demo Timeline
    
    *Figure: Full 4-panel telemetry (Combined ENOB, Loss, W8 bounds, and W3 clock/data envelope) across all 14 phases showing immediate step-response whenever regulation is enabled.*

    Round 20 All 180 Weights
    *Figure: Complete 180-synapse weight trajectories (`84 W(8)` + `96 W(3)`) across 4,702 sample pairs, demonstrating smooth column-3 compensation within ±90 LSB clamp.*

    **5. Demo Report Documentation:**  
    - [📄 `INVERTED_MAML_CARD1_R20_LR0P055_L2_1920_MOM0P85_CL90_THERMAL_SLICING_REPORT.pdf`](FPGA_code/docs/INVERTED_MAML_CARD1_R20_LR0P055_L2_1920_MOM0P85_CL90_THERMAL_SLICING_REPORT.pdf) (Complete 2-page publication report for Round 20 Live Demo, with Markdown version [here](FPGA_code/docs/INVERTED_MAML_CARD1_R20_LR0P055_L2_1920_MOM0P85_CL90_THERMAL_SLICING_REPORT.md))

---

### 📦 Verified Release Archives & Reproducibility Packages

Release packages containing synthesized bitstreams (`*.bit`), flash hex (`*.hex`), open-source SystemVerilog HDL, RISC-V C-firmware, and test scripts are archived in [`FPGA_code/releases/`](FPGA_code/releases/):

- [**`Release_20261114_ModeA_Card1_BitSlicing_AntiWindup_Baseline_R1`**](FPGA_code/releases/Release_20261114_ModeA_Card1_BitSlicing_AntiWindup_Baseline_R1/): **Complete Card 1 2-Beat Analog Bit-Slicing (`K=1`), Integrated-L2 Anti-Windup & Locked-DC Thermal Optimization Software Package.** Includes verified `T120F324` bitstreams/hex (`v2.2-MAML`, `0x20261030`), full C firmware + BSP, locked 25 °C DC calibration (`r1_dc_cal_fixed.json`), Python runner with clamp verification (`verify_hw_clamp`), GP tuner, live GUI, all `R1dc_fix..R8dc_fix` 180-weight PDF reports, 13-page FHP Comprehensive Report, and verified telemetry datasets (`Cold 9.45 b`, `R7dc_fix ★ Score +2.665`, `R8dc_fix 13-min +1.16 b Lift / 1.85x LossR`).
- [**`Release_20261108_ModeA_Card2_ThermalStress_Cycling_30pctDuty_1Hz`**](FPGA_code/releases/Release_20261108_ModeA_Card2_ThermalStress_Cycling_30pctDuty_1Hz/): **Complete 20-minute physical thermal stress and active drift rejection benchmark package on Card 2 silicon.** 4 on-board heaters driven at 30% duty cycle (1.0 Hz PWM) in 8.0m ON / 8.0m OFF cycles interleaved with 2.0m ON / 2.0m OFF Mode A SGD across [5.0..5.4 ms] (3,331 epochs). Proves -69.9% error reduction (+1.00 b resolution gain) under cold drift, dynamic headroom expansion to +117 LSB, BJT saturation guard, complete 11-page publication report, full 3,331-epoch dataset, bitstreams, and live monitoring GUI.
- [**`Release_20261107_ModeA_Card2_TimingSolid_VerilogEngine_Comprehensive`**](FPGA_code/releases/Release_20261107_ModeA_Card2_TimingSolid_VerilogEngine_Comprehensive/): Verified crystal-locked 10.000000 ms Verilog Frame Engine benchmark on Card 2 silicon across both [4.5..5.5 ms] and [4.9..5.9 ms] windows. Contains T120/T20 bitstreams, firmware, HDL, and 10-page reports.
- [**`Release_20261106_ModeA_Card2_1000ep_W3_Staircase_K1_PairedAblation`**](FPGA_code/releases/Release_20261106_ModeA_Card2_1000ep_W3_Staircase_K1_PairedAblation/): Verified 1000-epoch benchmark on Card 2 live silicon with crystal-locked 10.0 ms timing, W(3) staircase dynamic calibration, and 1:1 paired-ablation control ($K=1$ Online SGD). Contains clean RISC-V firmware, T120/T20 bitstreams, HDL, Python runner, and 10-page report.
- [**`Release_20261106_ModeA_Card2_1000ep_W3_Staircase_K4_Addon`**](FPGA_code/releases/Release_20261106_ModeA_Card2_1000ep_W3_Staircase_K4_Addon/): Mini-batch $K=4$ variant add-on package (same bitstream & firmware, host batch averaging parameter `--k-batch 4`) with full 1000-epoch dataset, 10-page report, and figures.
- [**`Release_20261106_ModeA_Card2_1000ep_ShiftedWindow_5to6ms_W3_Staircase_K1`**](FPGA_code/releases/Release_20261106_ModeA_Card2_1000ep_ShiftedWindow_5to6ms_W3_Staircase_K1/): 1000-epoch benchmark archive for the shifted temporal window `[5.0 .. 6.0 ms]` on Card 2 silicon ($K=1$ Online SGD). Includes execution script `run_card2_5to6ms.sh`, telemetry dataset, 10-page report, and figures.
- [**`Milestone_1_ModeA_5ms_Verified`**](FPGA_code/releases/Milestone_1_ModeA_5ms_Verified/): Initial Mode A baseline bringup bitstreams and verification logs (1k/5.1k attenuator, $K=20$).
- [**`T20_Custom_Verified`**](FPGA_code/releases/T20_Custom_Verified/): T20 Coprocessor verified configuration and synchronous bus bridge.
- [**`v1.2_bridge_udp_version`**](FPGA_code/releases/v1.2_bridge_udp_version/): Base UDP communication and Master SoC baseline bridge.
- **Note on Nov 4–5 Runs:** Datasets from the November 4–5 benchmark sessions were permanently removed from release archives due to the timing jitter bug and are documented in the [Timing Jitter Investigation Report](FPGA_code/docs/INVESTIGATION_REPORT_TIMING_JITTER_AND_BASELINE_ARTIFACTS.md).
- **Releases Index & Documentation:** [`FPGA_code/releases/README.md`](FPGA_code/releases/README.md)

---

#### Novel Hadamard Carrier Injection Circuit (Patent Pending Fig 8)
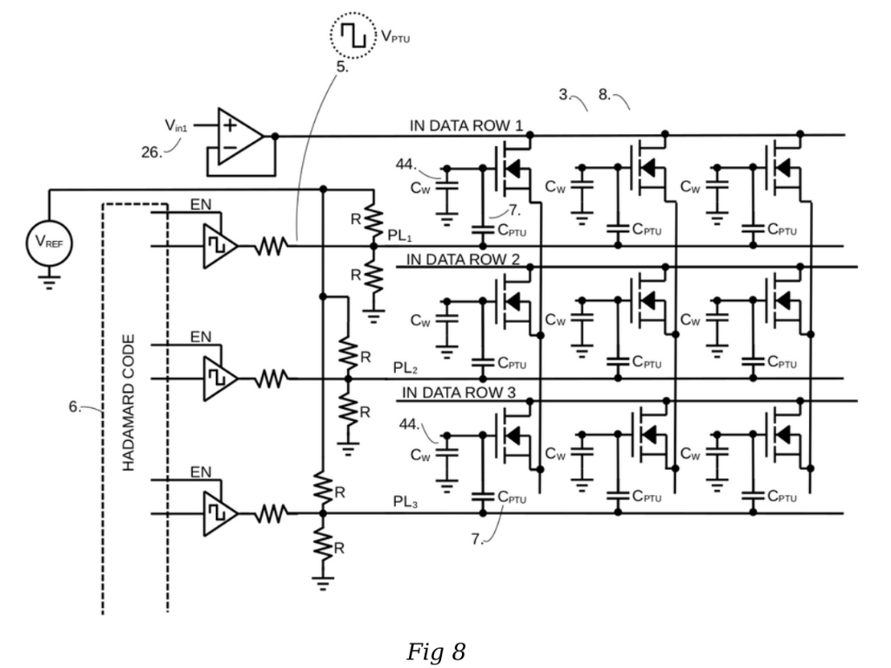
[picture p27: Fig8_Hadamard_carrier_injection_circuit.png]


*Fig 8 from patent application: Novel perturbation carrier injection circuit. Fast complementary Walsh-Hadamard codes (6) drive capacitive coupling nodes ($C_\text{PTU}$, 7) directly onto the 2T1C analog weight memory gates ($C_W$, 44), completely independent of the input data row drivers ($V_\text{in}$, 26). This novel injection topology enables high-SNR feedback and extraction of all column partial derivatives simultaneously in a single, tight 24 µs burst without disturbing steady-state weight retention or saturating matrix rows.*

#### Disclaimer on Audiobooks: 
The earlier podcast generation:
`pod_inverted_maml_audiobook_96k.m4a`
states that this entire system has already been fully tested and run; at the time of its generation, that was not true (NotebookLM was summarizing the patent application without knowing the real bench status). 

However, as of October 2026, the first **real baby steps on physical silicon and PCBA hardware** have now begun (validating physical Hadamard carrier modulation, DAC/Weight line dynamics, and bare-metal ADC responses).

For a more accurate overview of the architecture and vision, check the updated 52-minute audio:
#### Recommended Audiobook (52 minutes):
`Shattering_the_Memory_Wall_with_Proprioception_56k.m4a`

This version gives a much fairer and more grounded representation of the project.  

### The Atomic Triad
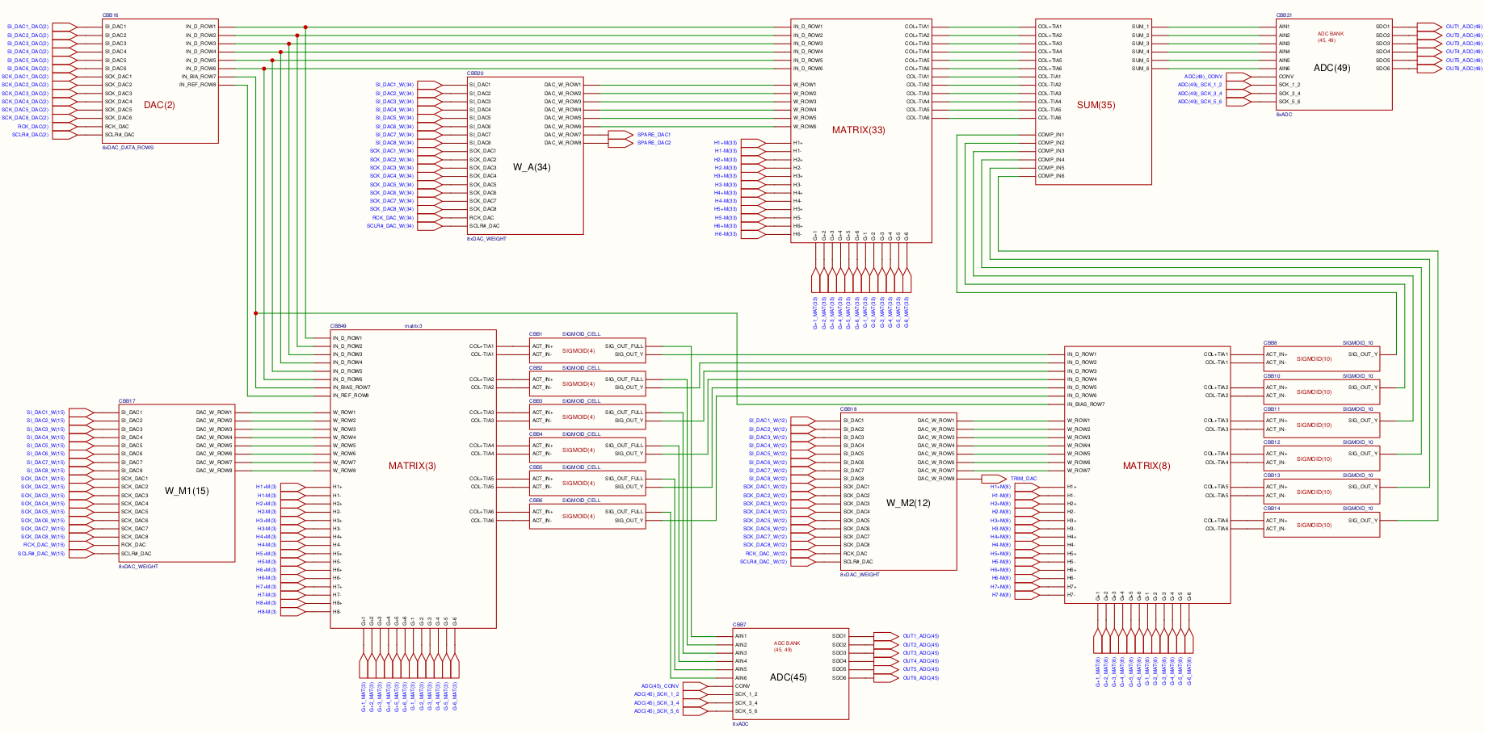
[picture p28: Atomic_Triad.png]

### Mutiplication cell
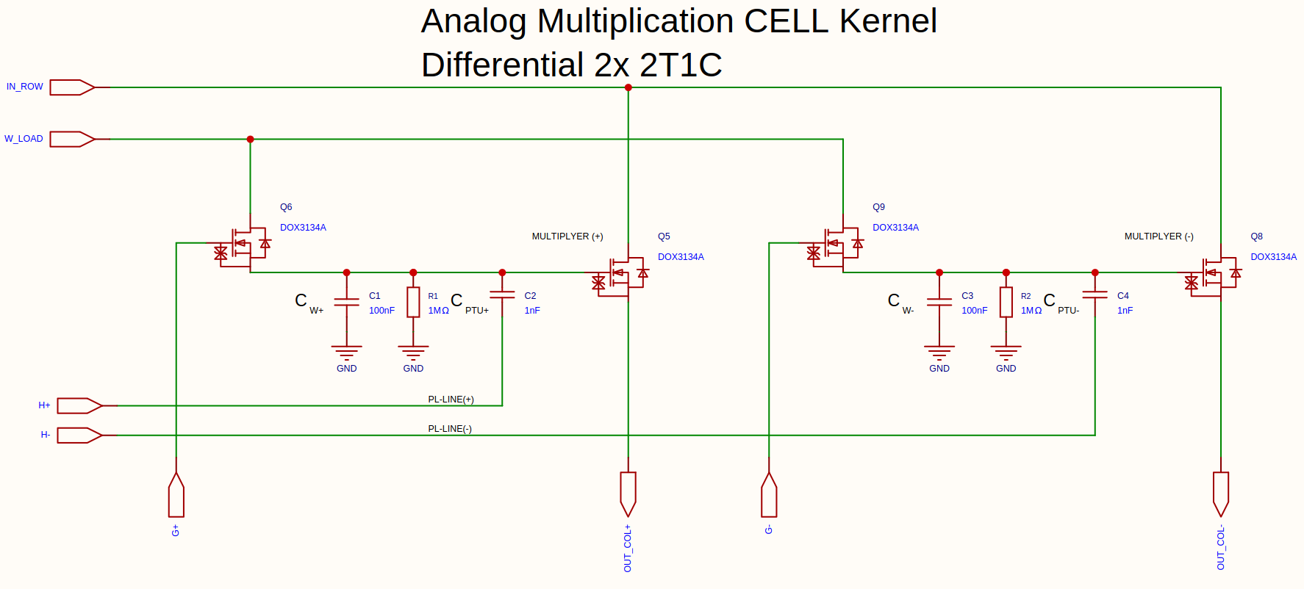
[picture p29: Cell_Kernel.png]

### 6x6 matrix EasyEDA
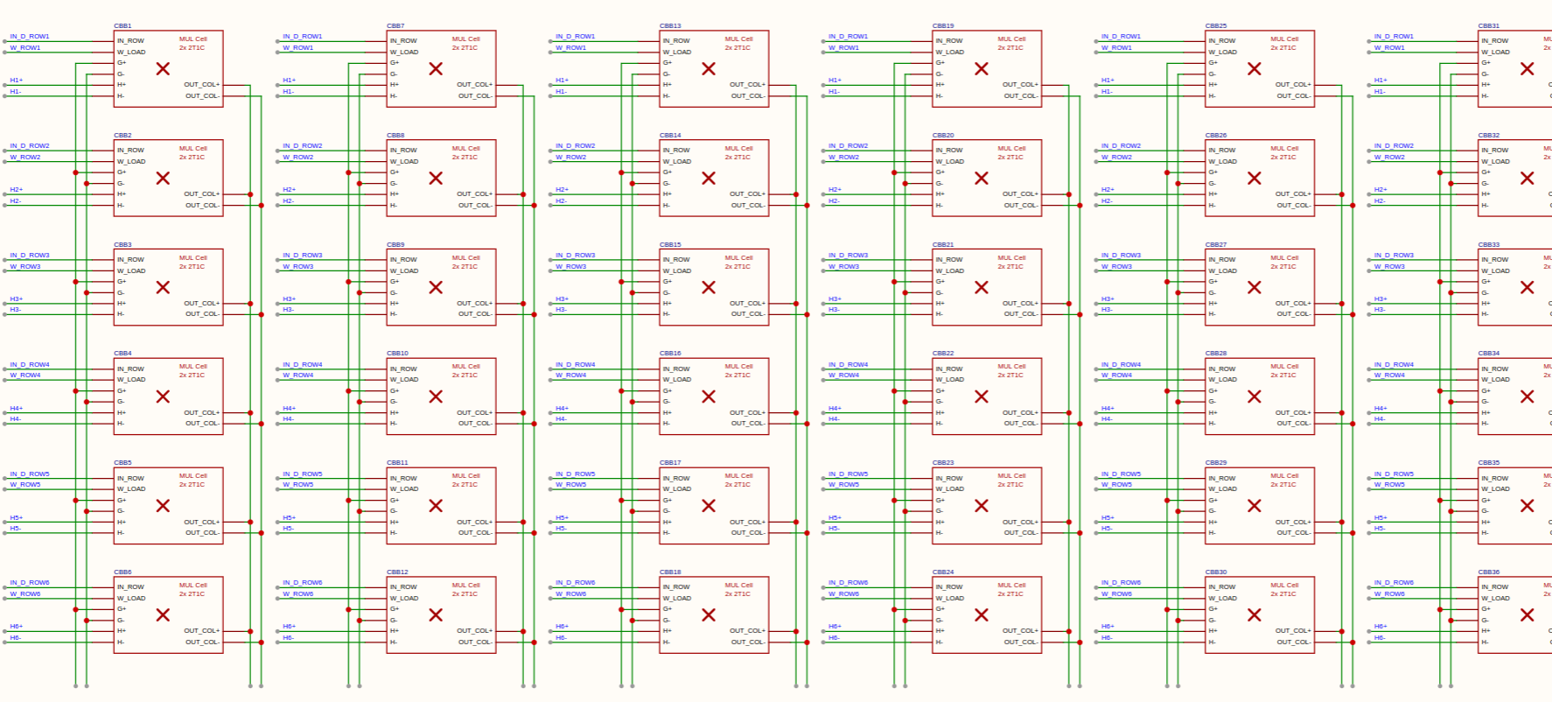
[picture p30: 6x6_matrix.png]

### LTspice simulation sigmoid OP-amp
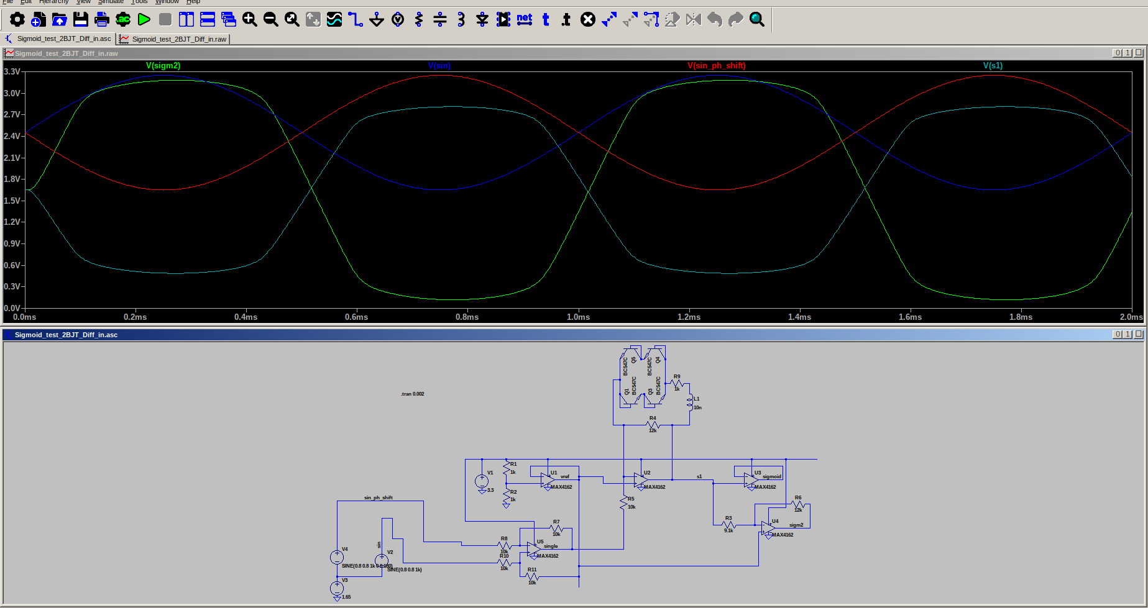
[picture p31: LTspice_sigmoid_sim.png]

### The MATRIX ! Imagination or vision what if... "The self aware MATRIX" is possible ? :) 
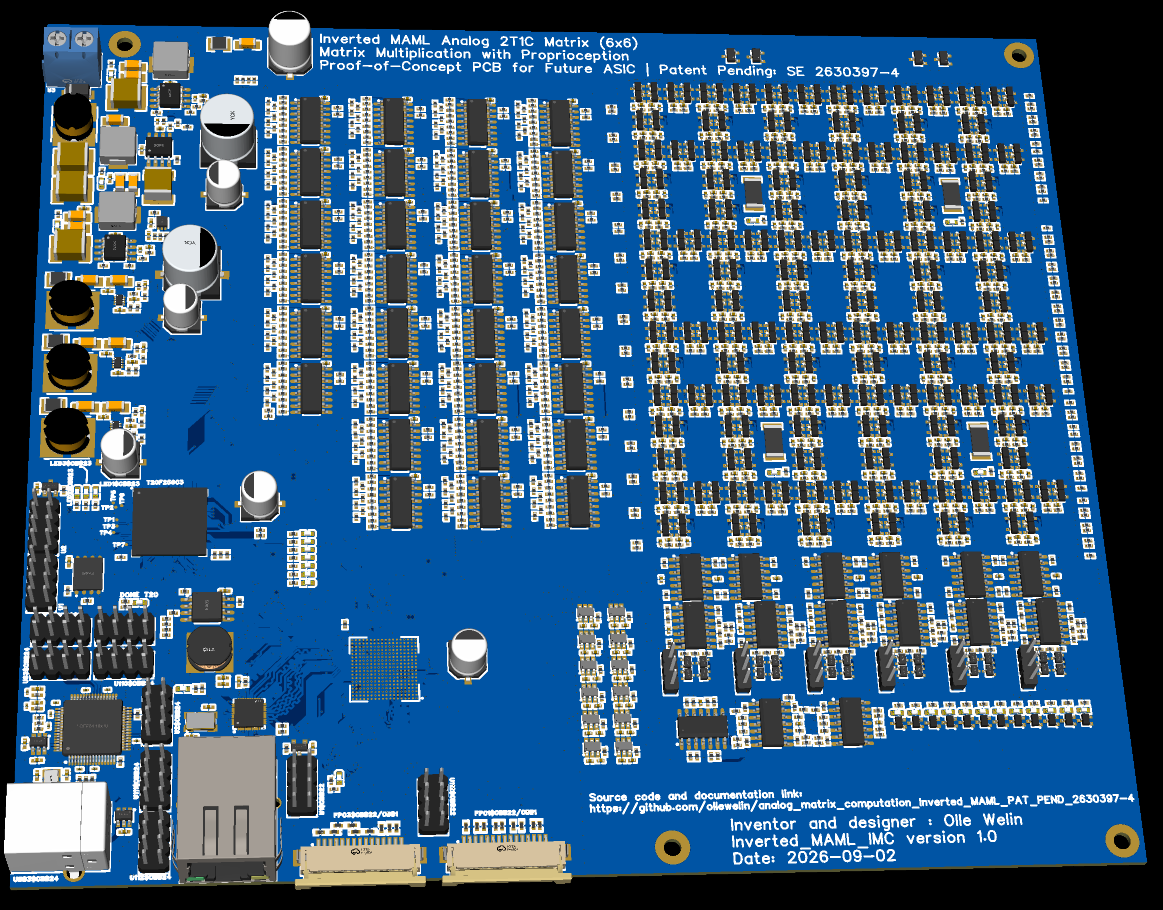
[picture p32: EasyEDA/matrix.png]

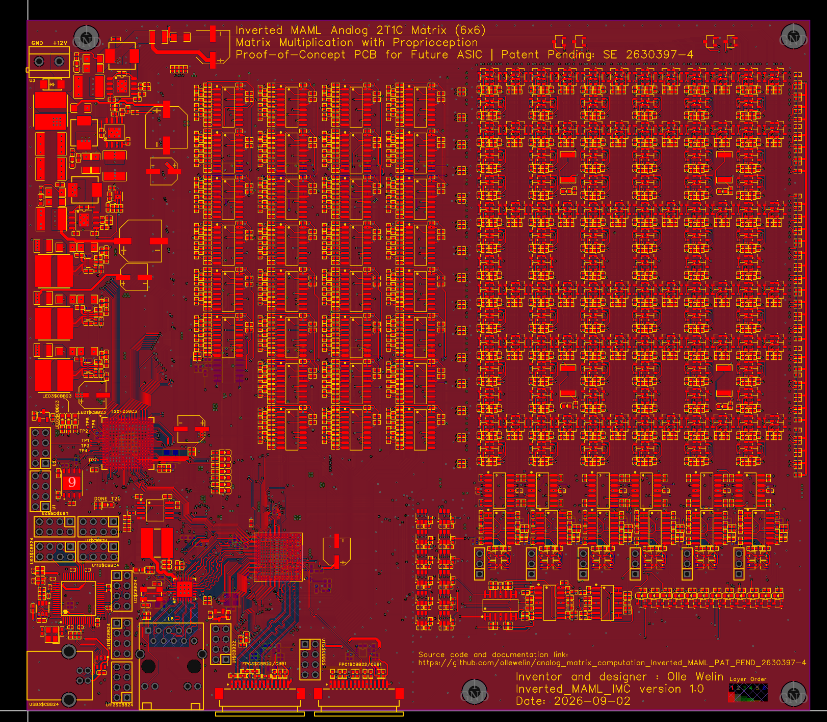
[picture p33: EasyEDA/Matrix_PCB_view.png]

### Claude Simulation 3x6x6 PCB (NO hadamard included):
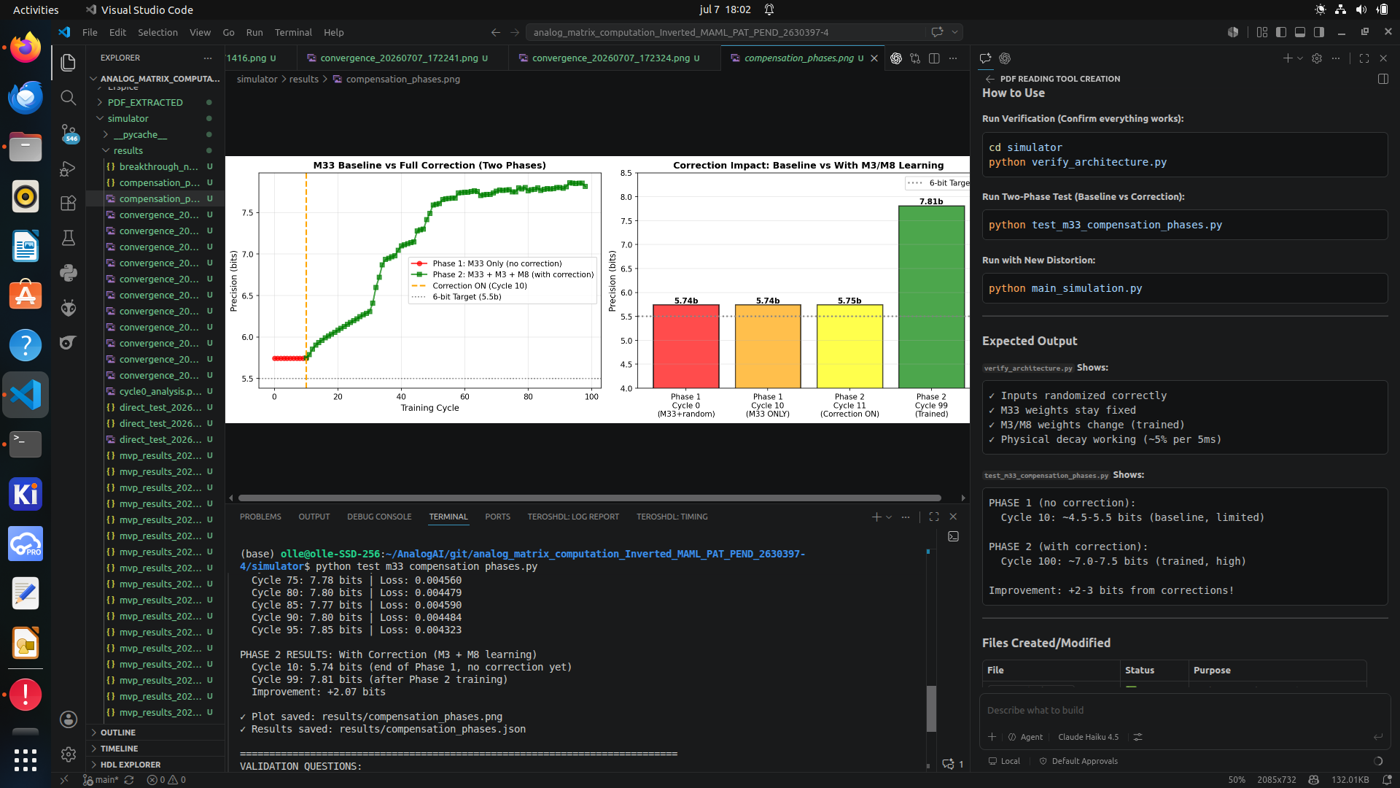
[picture p34: Simulation_Proof_of_concept_3x6x6_triad.png]


### JLCPCB manufacture placement 
T12F324 3D step is not showed here but mounted
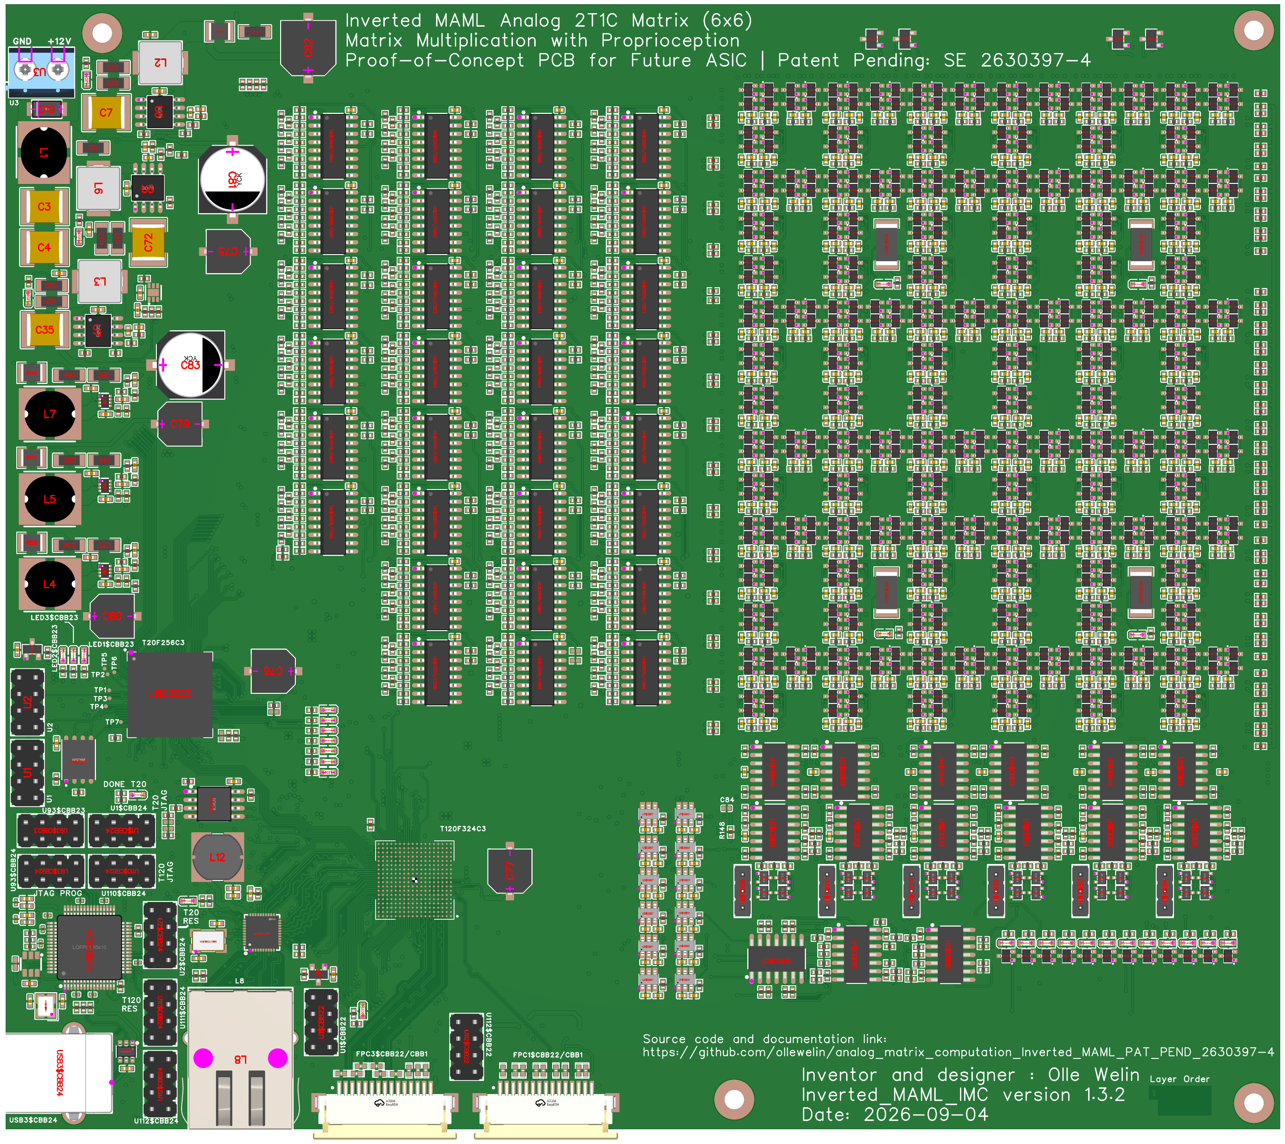
[picture p35: EasyEDA/Component_Top.png]

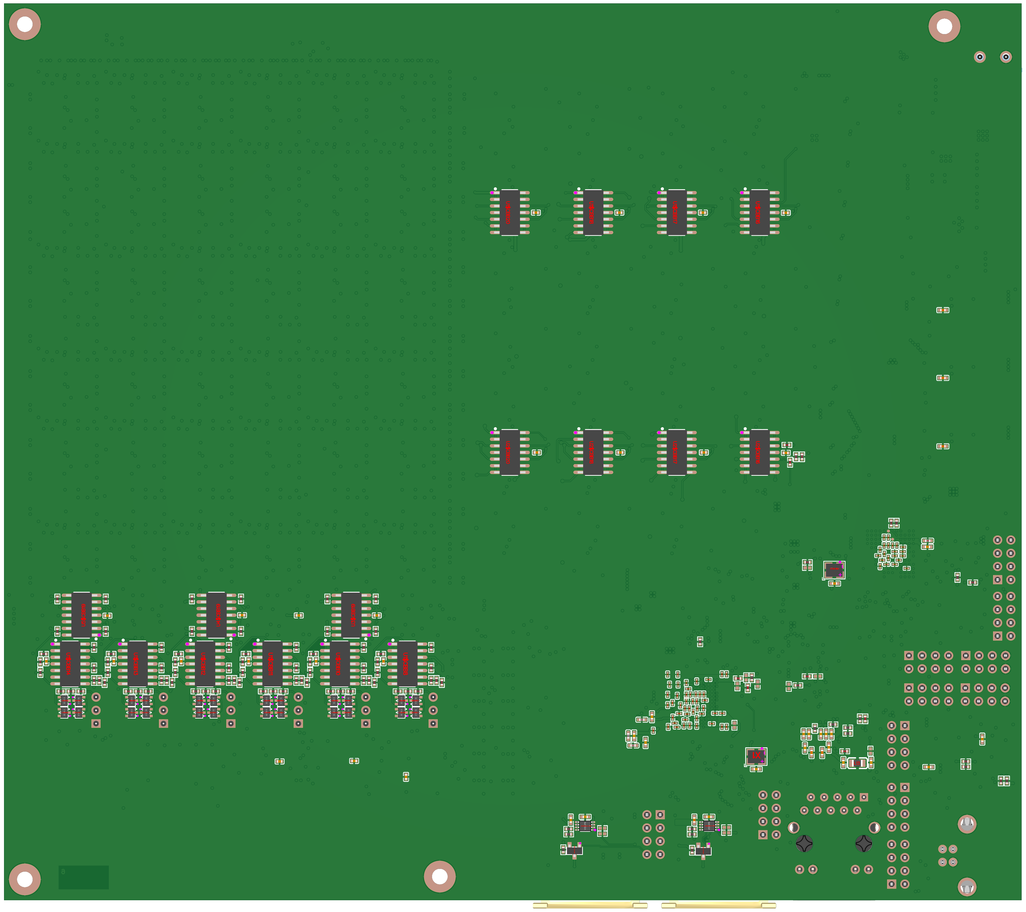
[picture p36: EasyEDA/Component_bottom.png]


### 🚀 PCB Version 2.0 Production Release (2026-10-31)
All physical bench errata from version 1.3.2 have been resolved and permanently integrated into the official **PCB Version 2.0** production release:
* **Interactive EasyEDA Schematics & 1-Click JLCPCB Ordering:** [🔗 Inspect & Order on OSHWLab](https://oshwlab.com/olle_welin/project_yvkekxrp)
* **EasyEDA Pro Project Archive:** [`EasyEDA/next_revision_2/ProPrj_Inverted_MAML_6x6_2026-10-31.epro2`](EasyEDA/next_revision_2/ProPrj_Inverted_MAML_6x6_2026-10-31.epro2)
* **Gerber 6-Layer Fabrication Files:** [`EasyEDA/next_revision_2/Gerber_Inverted_MAML_IMC_2026-10-31.zip`](EasyEDA/next_revision_2/Gerber_Inverted_MAML_IMC_2026-10-31.zip)
* **Pick & Place (CPL) Placement Data:** [`EasyEDA/next_revision_2/PickAndPlace_Inverted_MAML_IMC_2026_10_31.csv`](EasyEDA/next_revision_2/PickAndPlace_Inverted_MAML_IMC_2026_10_31.csv)
* **JLCPCB SMT Production BOM (2047-char partitioned):** [`EasyEDA/next_revision_2/BOM_Analog_Matrix_Inverted_MAML_IMC_2026-10-31_Designator_max_2047_char.csv`](EasyEDA/next_revision_2/BOM_Analog_Matrix_Inverted_MAML_IMC_2026-10-31_Designator_max_2047_char.csv)
* **Full Engineering Changelog & Errata:** [`EasyEDA/next_revision_2/Errata_notes_version_2.txt`](EasyEDA/next_revision_2/Errata_notes_version_2.txt)
  * Op-amp upgrade: `U1$CBB16` and `U2$CBB16` upgraded to high-current `MCP6444-E/SL` for zero row sag during simultaneous multi-column load.
  * Summing junction resistors: `R2$CBB15` through `R8$CBB15` optimized to `5.1 kΩ` for +18 dB Vernier Hadamard SNR authority.
  * Clean copper layout fixes: JTAG boundary scan pull-ups, 160 Ω LED drive (`R2$CBB22`), dedicated `T120_CRESET_N` net, and 10 nF Ethernet PHY center-tap filter.

### Bringup test 1 (Historical Version 1.3.2)
IMPORTANT fix to get JTAG working.
1. CSI pull down need to remove both T20 (Remove R12$CBB23) and T120 (remove R169$CBB22/CBB2)
2. T120_CRESET_N patch wire between Reset circuit and T120 <--> FT2232 programmer to get auto start T120 from SIP flash
3. Bug fix 2026-09-30: missing input net T120_CRESET_N
4. 2026-10-07: Bug at Centertap 0-ohm to GND there should be 10nF to GND Eth Phy magnetics
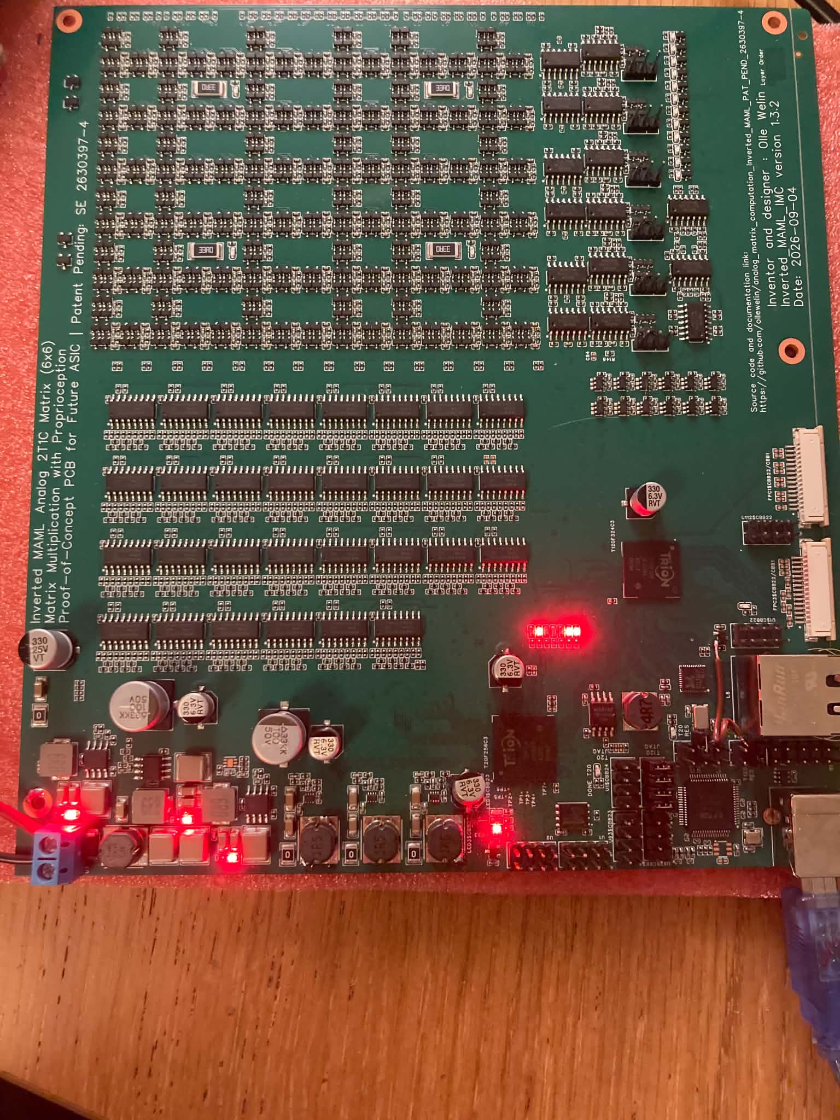
[picture p37: LED_test1.jpeg]


### Regenerate FPGA code with AI agent example (one prompt)
Install the Efinix software tool locally on you computer
VS code and AI agent support
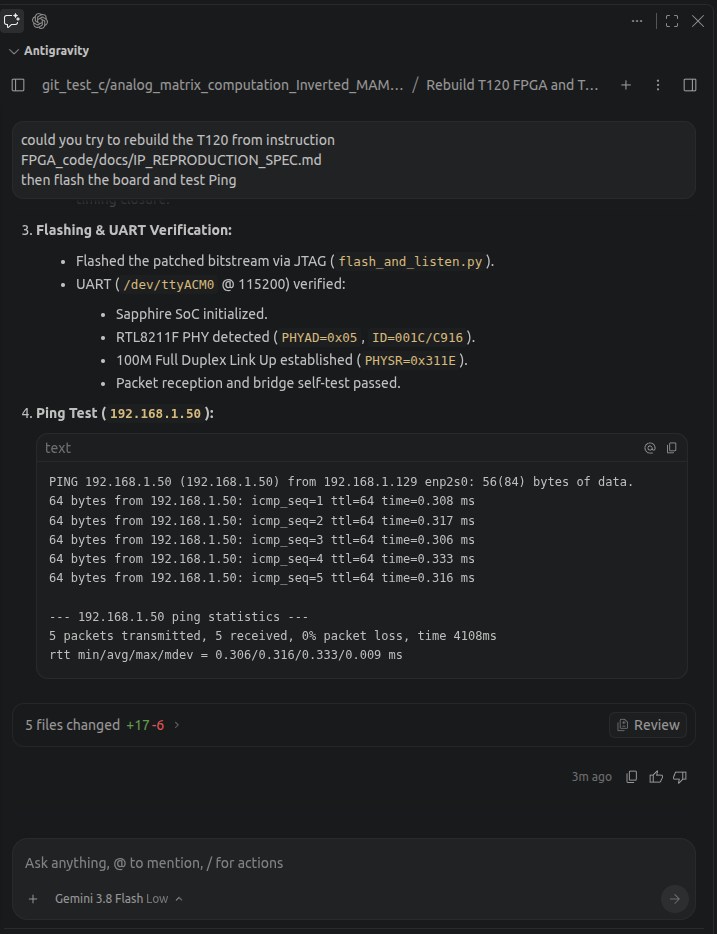
[picture p38: regerate_SoC_and_Ethernet_IP.png]


### Example timing report (125Mhz requirement passed)
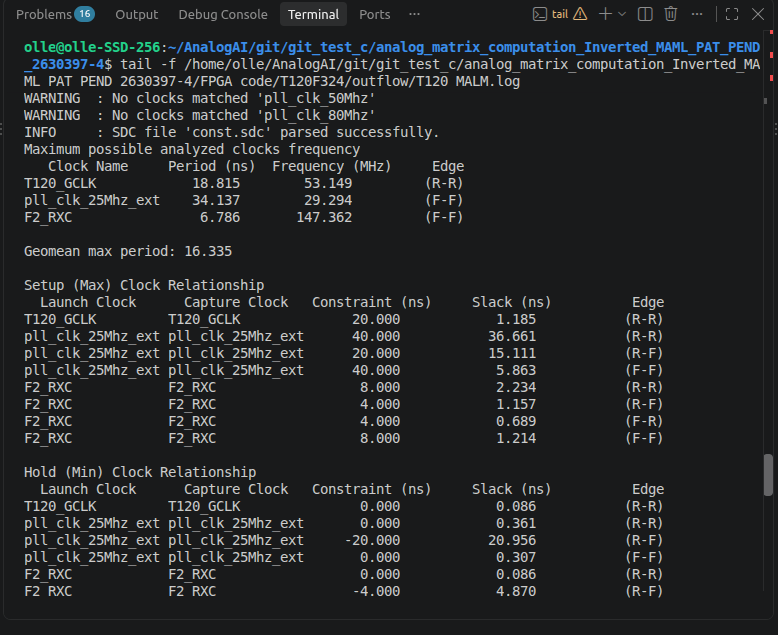
[picture p39: Timing_report_T120_Soc_Eth.png]


### Hardware Bringup: DAC Data Row Op-Amp Sag vs. Confirmed Flawless Weight DAC Buffers (2026-10-22 Update)

During physical bench bringup of the 3x 6x6 matrix PCB, direct oscilloscope probing clarified the exact electrical boundary between the DAC Data row drivers and the Weight charging drivers:



#### Key Circuit Findings:
1. **Weight DAC Buffers (`MCP6024T-I/SL`) — Confirmed 100% Flawless (No Upgrade Needed):**
   - The 6 voltage levels seen on the Blue weight line (`W_M1_ROW1`) during the refresh period are **not voltage droop or ripple**—they are the **6 sequential column update levels** charging columns 0 through 5 one by one across the row.
   - Pressing the GUI weight randomization button confirms that each of the 6 levels steps cleanly, sharply, and flatly to its new target voltage without distortion.
   - Because the weight buffers charge only a single 100 nF capacitor at a time (sequential time-multiplexing), the standard `MCP6024` has more than enough current drive.
   - **Conclusion:** The original Weight DAC buffer design is 100% correct as built. Adding external 100 nF reservoir capacitors or swapping weight op-amps is completely unnecessary.

2. **DAC Data Row Buffers (`DAC2_D_ROW*`) — Current Starvation Under Multi-Column Load:**
   - Unlike the weight buffers, each **In-Data row buffer (`DAC2`)** continuously drives the drain channels of all connected columns in parallel across Matrix 3, Matrix 8, and Matrix 33 simultaneously.
   - Under dynamic multi-column conduction, cumulative channel current exceeds the linear sourcing capacity of the `MCP6024` (<10 mA), causing the row voltage to sag by $\sim 188\text{ mV}_\text{pp}$.
   - **Conclusion:** Only the `DAC2` In-Data row buffer op-amps (`U1$CBB16`, `U2$CBB16`) required replacement. This upgrade was physically executed on **2026-10-23** by soldering **`MCP664-E/SL`** ($\pm 70\text{ mA}$, $60\text{ MHz}$) onto the board, completely eliminating row voltage sag. Weight op-amps remain the original `MCP6024`.

#### High-Current SOIC-14 Upgrade (Executed on DAC Data Row Buffers Only):
The `MCP6024T-I/SL` uses the standard **14-pin SOIC Quad Op-Amp pinout**. Drop-in replacements evaluated and installed for the `DAC2` data row buffers (`U1$CBB16`, `U2$CBB16`) include:

| Part Number | Manufacturer | Package | Output Current Capability | Bandwidth (GBW) | Status & Role |
| :--- | :--- | :--- | :--- | :--- | :--- |
| **MCP6024T-I/SL** | Microchip | SOIC-14 | $< 10\text{ mA}$ linear drive | $10\text{ MHz}$ | **Retained:** 100% adequate for Weight lines; sagged $\sim 188\text{ mV}$ on parallel Data lines |
| **MCP664-E/SL** | Microchip | SOIC-14 | **$\pm 70\text{ mA}$ per channel** | **$60\text{ MHz}$** | **INSTALLED (2026-10-23):** Fast settling ($32\text{ V/\mu s}$), stiff voltage rails, zero row sag |
| **AD8534ARZ** | Analog Devices | SOIC-14 | **$\pm 250\text{ mA}$ per channel** | $3\text{ MHz}$ | Alternate evaluated candidate |
| **OPA4310IDR** | Texas Instruments | SOIC-14 | **$\pm 150\text{ mA}$ per channel** | $3\text{ MHz}$ | Alternate evaluated candidate |

### Corrected Hadamard Carrier Modulation: 24 µs Contiguous Burst at 2.0 ms Post-Refresh

Oscilloscope measurements initially revealed that the legacy Hadamard perturbation suffered from multi-hundred-microsecond pulse trains with unintended tri-state gaps between pulses. This distorted the measurement window across the analog memory capacitor decay curve.

The Hadamard sequence was rebuilt in both RTL (`t120_hbus_seq.sv`, `t120_inter_fpga_bridge.sv`, `t120_analog_io_ctrl.sv`) and C firmware (`maml_platform.c`):
1. **Contiguous 24.00 µs Table (2 x 6 = 12 pulses x 2.00 µs):** Zero tri-state gaps between pulses. 
   - 6 pulses for the (+) orthogonal Hadamard basis (12.00 µs).
   - 6 pulses for the complementary (-) basis (12.00 µs).
2. **Deterministic Tri-State Boundary:** The outputs remain actively driven throughout the full 24.00 µs burst. On the 13th word (`0x8000`), the hardware immediately switches all pins to High-Z (tri-state) until the next 10 ms refresh period.
3. **Optimized Timing Window (t = 2.0 ms Post-Refresh):** Executing the 24 µs burst early at t = 2.0 ms positions the measurement on the DAC data line was fairly flat at this test, stable plateau of the DAC and weight lines before capacitor leakage causes current droop what lead DAC OP driver to rise voltage to R-2R level at then end close to refresh pulses.
4. **End-of-Pulse ADC Sampling (t = 1.96 µs):** Differential SAR ADCs (`XC2361A`, `ADC_45` & `ADC_49`) sample at the end of each 2.00 µs pulse right before the next pulse transition.

#### Oscilloscope Verification: Corrected Hadamard Carrier Lines

**First Hadamard Line Probed:**
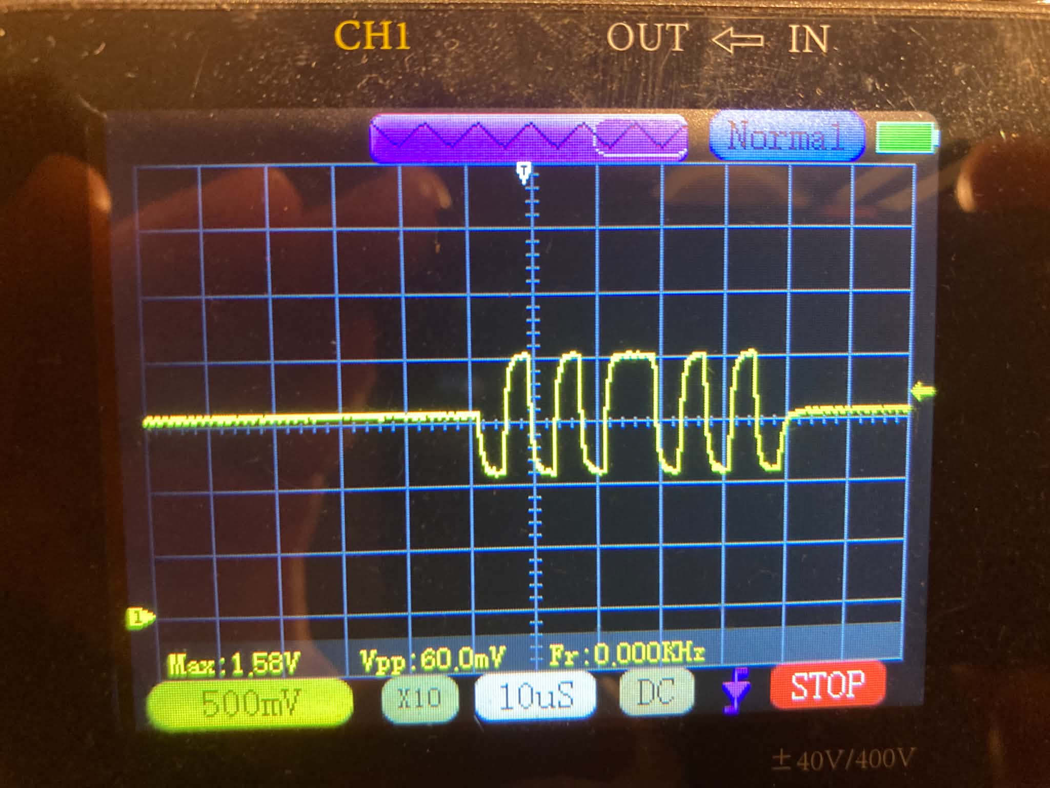
[picture p40: Hadamard_corrected_first_line.jpeg]


**Another Hadamard Line Probed:**
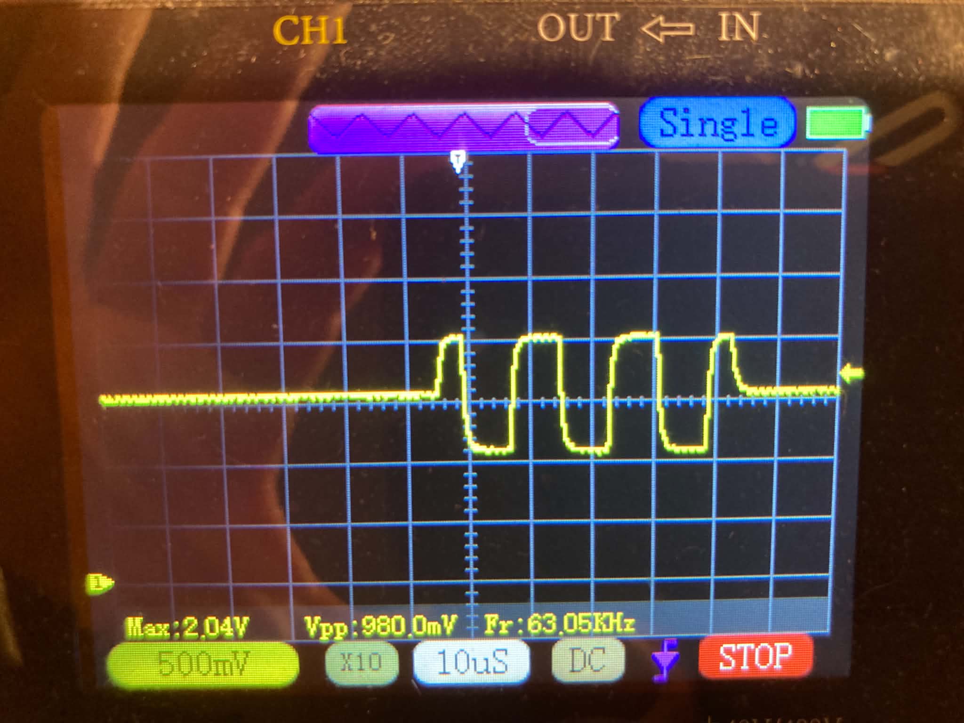
[picture p41: Hadamard_corrected_another_line.jpeg]


#### Code Example: 2x6 Hadamard Matrix & Hardware Sequencer Configuration

```c
/* ============================================================================
 * Contiguous 2x6 = 12-Pulse Hadamard Table (2.00 us per pulse = 24.00 us total)
 *   - (+) Table (pulses 0..5, 12.00 us): 6 orthogonal non-DC Walsh-Hadamard rows
 *   - (-) Table (pulses 6..11, 12.00 us): exact bitwise complement (~(+) & 0x7FFF)
 *   - Step 12 (at t = 24.00 us): 0x8000 (Tri-State Hi-Z exit until next 10 ms cycle)
 *   - ZERO tri-state gaps between the 12 pulses!
 *   - ADC_45 & ADC_49 sample at t = 1.96 us (end of each 2.00 us pulse)
 * ============================================================================ */
static const uint16_t HADAMARD_2X6_POS[6] = {
    0x2AAAu, /* p=0: basis row 1 */
    0x1999u, /* p=1: basis row 2 */
    0x4CCCu, /* p=2: basis row 3 */
    0x0787u, /* p=3: basis row 4 */
    0x52D2u, /* p=4: basis row 5 */
    0x61E1u  /* p=5: basis row 6 */
};

/* Load contiguous 12 pulses + Hi-Z termination into T120 H-bus sequence RAM */
for (int p = 0; p < 6; p++) {
    uint16_t w_pos = HADAMARD_2X6_POS[p] & 0x7FFFu;
    uint16_t w_neg = (~HADAMARD_2X6_POS[p]) & 0x7FFFu;
    *(volatile uint32_t *)(T20_BRIDGE_BASE + T20_H_TABLE + 4 * p)       = (uint32_t)w_pos;
    *(volatile uint32_t *)(T20_BRIDGE_BASE + T20_H_TABLE + 4 * (p + 6)) = (uint32_t)w_neg;
}
*(volatile uint32_t *)(T20_BRIDGE_BASE + T20_H_TABLE + 4 * 12) = 0x00008000u; /* Exit to Hi-Z */

/* Configure 10.0 MHz T20_CLK9, 2.000 us pulse period, and 13 words */
T20_REG(T20_CLK_PERIOD) = 5u;   /* 10.0 MHz CLK9 (100 ns period) */
T20_REG(T20_H_PERIOD)   = 20u;  /* 20 cycles = 2.000 us exact pulse width */
T20_REG(T20_H_COUNT)    = 13u;  /* 12 active pulses (24.00 us) + 1 Hi-Z word */
```

---

### Weight Line Transient Loading During Refresh & 100 nF Memory Cell Probing — 2026-10-18

To understand how the `100 nF` 2T1C gate storage capacitors interact with the Weight charging bus (`W_M1_ROW1`) during the refresh phase, two dual-channel oscilloscope measurements were captured on **2026-10-18** (`500 mV/div`, `2 ms/div`):

- **Channel 2 (Blue):** Probed directly on the Matrix 3 Weight row line **`W_M1_ROW1`**.
- **Channel 1 (Yellow):** Probed directly at the internal **`100 nF` memory capacitor storage node** (`\$1I15\\\$1I2\\\$2N1` and a second memory cell along the same row).

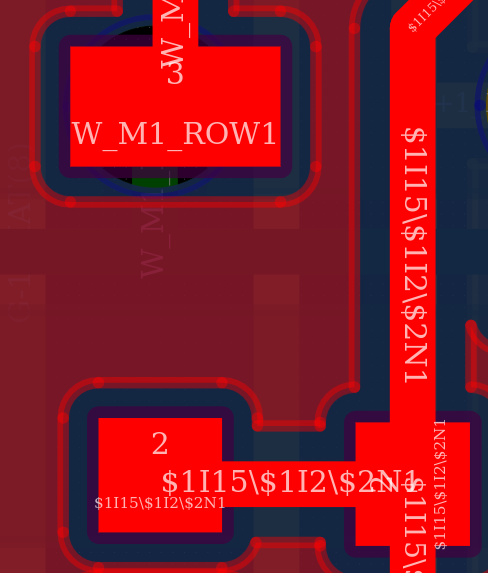
[picture p42: EasyEDA/W_M1_ROW1_100nF_mem_cell_node.png]


#### 1. First `100 nF` Memory Cell (`\$1I15\\\$1I2\\\$2N1`) vs. `W_M1_ROW1`:
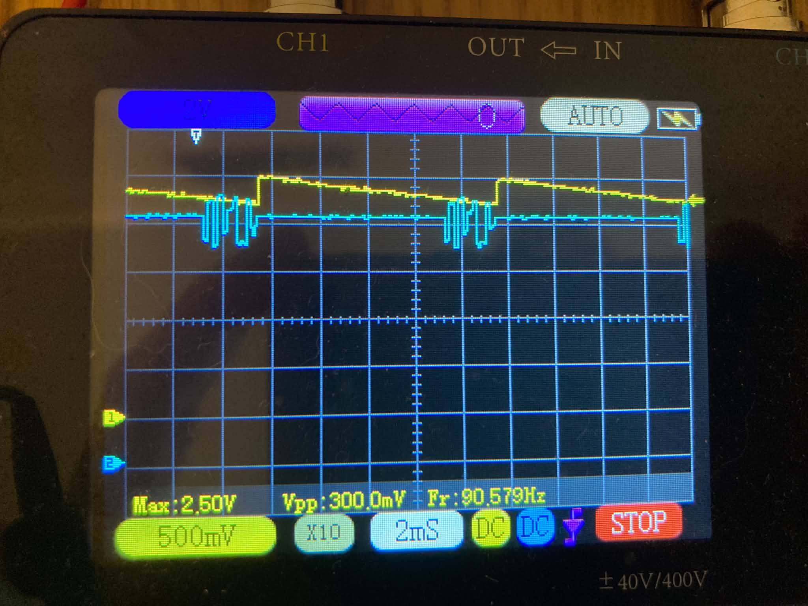
[picture p43: Blue_Weight_line_Yellow_100nF_mem_cell_1.jpeg]


#### 2. Second `100 nF` Memory Cell on the Same Row vs. `W_M1_ROW1`:
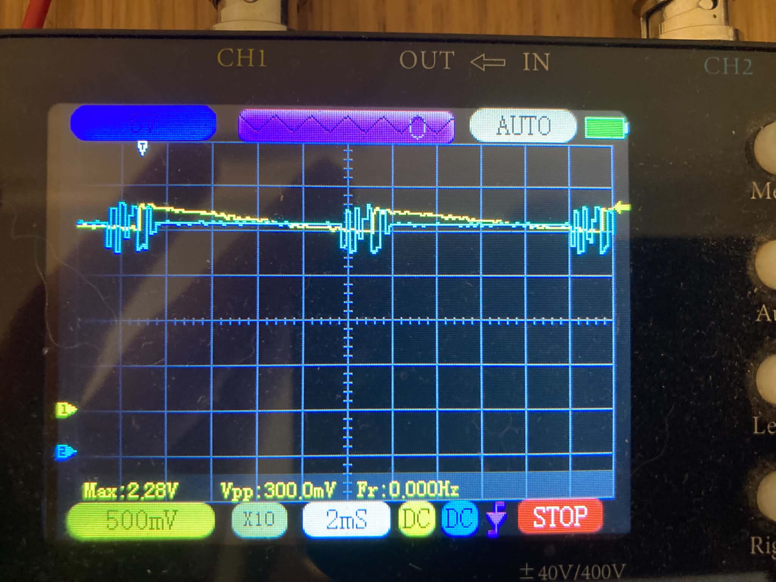
[picture p44: Blue_Weight_line_Yellow_100nF_mem_cell_2.jpeg]


#### 3. Cross-Coupled Driver Sag & Gate Leakage Capture — DAC2 In-Data Row 1 vs. Matrix 3 Weight Memory Cell (`C1_CBB49_CBB31`):
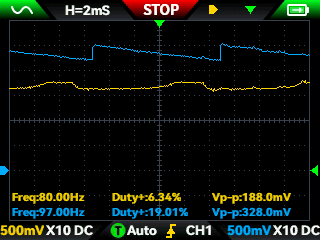
[picture p45: Yellow-DAC2_D_ROW1_Blue_C1_CBB49_CBB31.png]


- **Channel 1 (Yellow, 500 mV/div, 2 ms/div):** In-Data Row 1 input line (**`DAC2_D_ROW1`**) driven by the DAC buffer op-amp.
- **Channel 2 (Blue, 500 mV/div, 2 ms/div):** Last weight storage capacitor node on Column 1 of **Matrix(3)** (**`C1_CBB49_CBB31`** / `C1$CBB49/CBB31` in sheet `CBB49 = matrix3`, `CBB31 = MUL_CELL_2T1C`).
- **Physical Phenomena Confirmed on Oscilloscope:**
  1. **Weight Memory Decay & Refresh Pulse (Blue):** The Blue trace clearly captures the sharp $100\text{ Hz}$ ($10\text{ ms}$ period) autonomous refresh edge charging the $100\text{ nF}$ analog memory gate up to its target voltage, followed by the predictable continuous decay ($\sim 328\text{ mV}_\text{pp}$) over the $10\text{ ms}$ interval between refresh cycles.
  2. **Op-Amp Output Sag & Dynamic Crosstalk Loading (Yellow):** The Yellow trace shows the `DAC2_D_ROW1` buffer sagging by $\sim 188\text{ mV}_\text{pp}$ synchronously when columns switch and during matrix operations. This confirms that the current `MCP6024` quad op-amp lacks sufficient current-sourcing capability ($<10\text{ mA}$) to maintain a stiff, invariant voltage rail under dynamic multi-cell loading.
  3. **Targeted Scope of Upgrade:** Replacing only the In-Data row buffers (**`DAC2`**, `U1$CBB16`, `U2$CBB16`) with high-current op-amps (**`MCP664-E/SL`**, completed 2026-10-23) eliminated the 188 mVpp row sag. The Weight buffers remain original `MCP6024` as their drive is verified fully adequate.

#### Key Findings & Targeted Driver Upgrade (2026-10-22 Update):
1. **PCB Copper Traces Are Free of Resistance:**
   - Both traces confirm that PCB trace resistance is negligible.
   - The multi-level staircase on the **Blue** trace (`W_M1_ROW1`) represents the 6 sequential column refresh levels being charged one by one, with flat, stable plateaus across all 6 steps.
2. **Weight Buffers Work Flawlessly — Only Data Buffers Require Upgrade:**
   - **Weight Path Confirmed Solid:** The `MCP6024` op-amp has ample current capability to charge individual 100 nF memory cells sequentially. No extra 100 nF reservoir capacitors or op-amp replacements are needed on the Weight lines.
   - **Data Row Buffers (`DAC2`):** Because each `DAC2` buffer supplies continuous channel current to all conducting multiplier columns in parallel, upgrading `DAC2` buffers to high-current pin-compatible quad op-amps (`AD8534ARZ` / `MCP664-E/SL`) will stiffen the row rails and eliminate sag.

---

### Manual Verification with Efinix Logic Analyzer (`la0` & GTKWave) — 2026-10-17 / 2026-10-18

To independently verify the bare-metal hardware signals without relying solely on software telemetry, a dedicated Efinity Logic Analyzer build (`FPGA_code/T120F324_LA`) was synthesized and manually checked in the Efinix Debugger GUI and GTKWave:

#### 1. Downsampled Capture Showing Full 12-Step Hadamard Burst (`0..B`) & Bare-Metal `ADC_45` / `ADC_49` Response (2026-10-17):
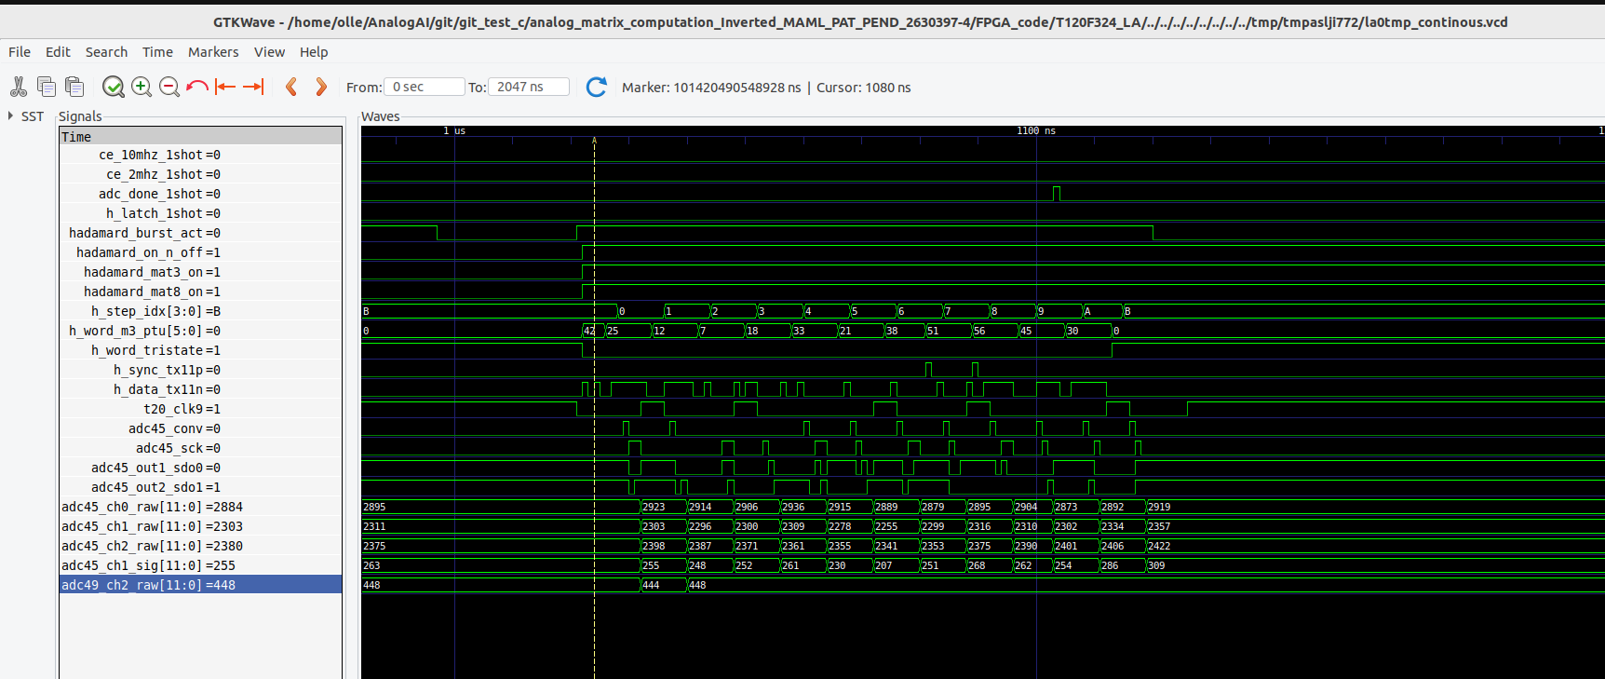
[picture p46: Raw_ADC_45_ADC_49.png]


#### 2. Full-Speed `50 MHz` (`20 ns`) Sampling Showing Individual `25 MHz` SAR ADC SPI Clocks, MISO Bits & One-Shot Strobes (2026-10-18):
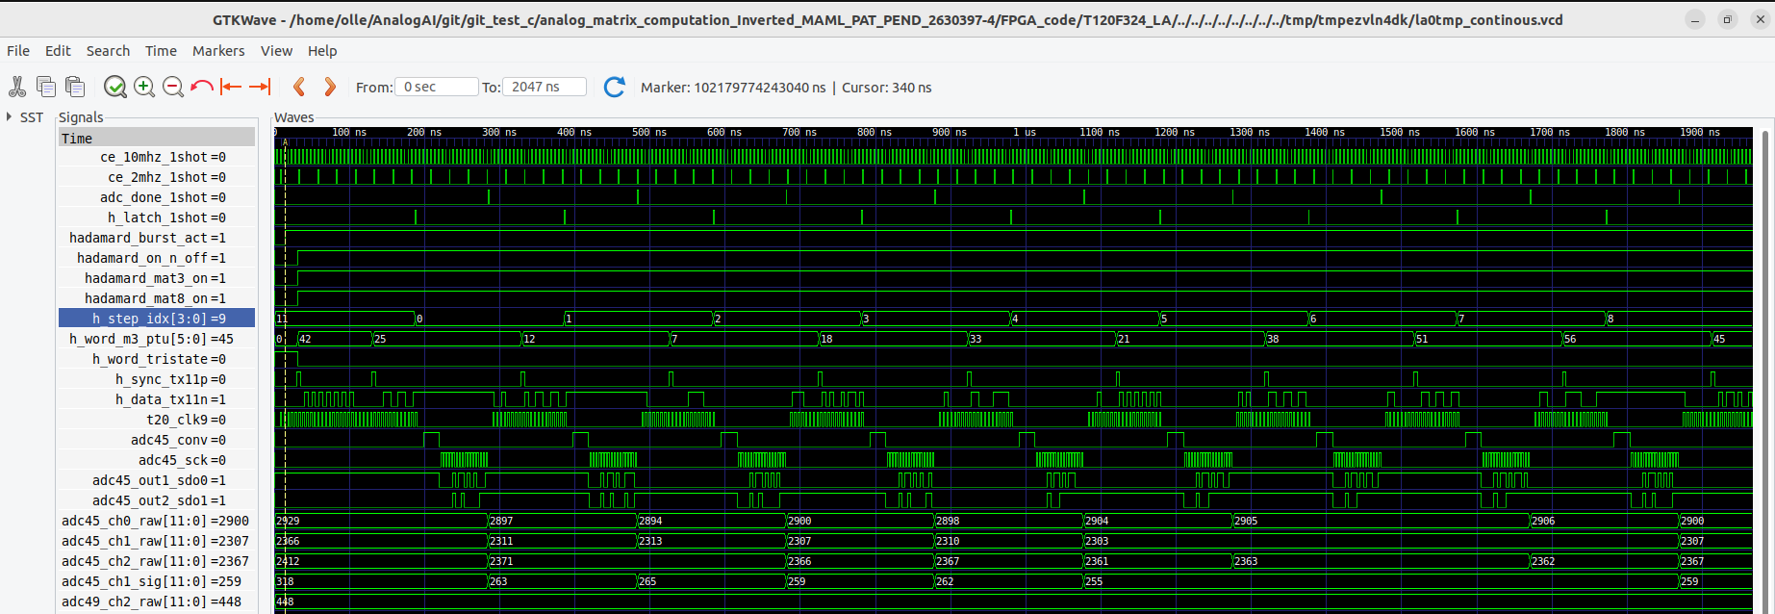
[picture p47: Raw_ADC_45_ADC_49_full_speed_sampling.png]


- **Dates:** 2026-10-17 & 2026-10-18
- **Manual Check Confirmed:** Both the downsampled burst capture and the full-speed `50 MHz` (`Capture Mode = Always`) capture confirm the live Hadamard carrier wave function (`h_step_idx[3:0] = 0..B`, `h_word_m3_ptu[5:0]`, `hadamard_burst_act = 1`, `hadamard_on_n_off = 1`), the `10 MHz` `t20_clk9` bursts, the `25 MHz` `adc45_sck` / `adc45_conv` / `adc45_out1_sdo0` / `adc45_out2_sdo1` SPI frames, and the resulting 12-bit deserialized words on `ADC_45` (`adc45_ch0_raw`, `adc45_ch1_raw`, `adc45_ch2_raw`) and `ADC_49` (`adc49_ch2_raw`).

---

### Single-Cell Multiplier Dynamic Evaluator GUI & Real-Time 3D Response — 2026-10-20

To characterize individual crosspoint Dual-2T1C multiplier cells without simulations, a dedicated hardware evaluation suite (`gui/maml_cell_evaluator_gui.py` and `FPGA_code/scripts/test_multiplier_time_dynamics.py`) was introduced to command the live T120 SoC bare-metal registers over UDP:

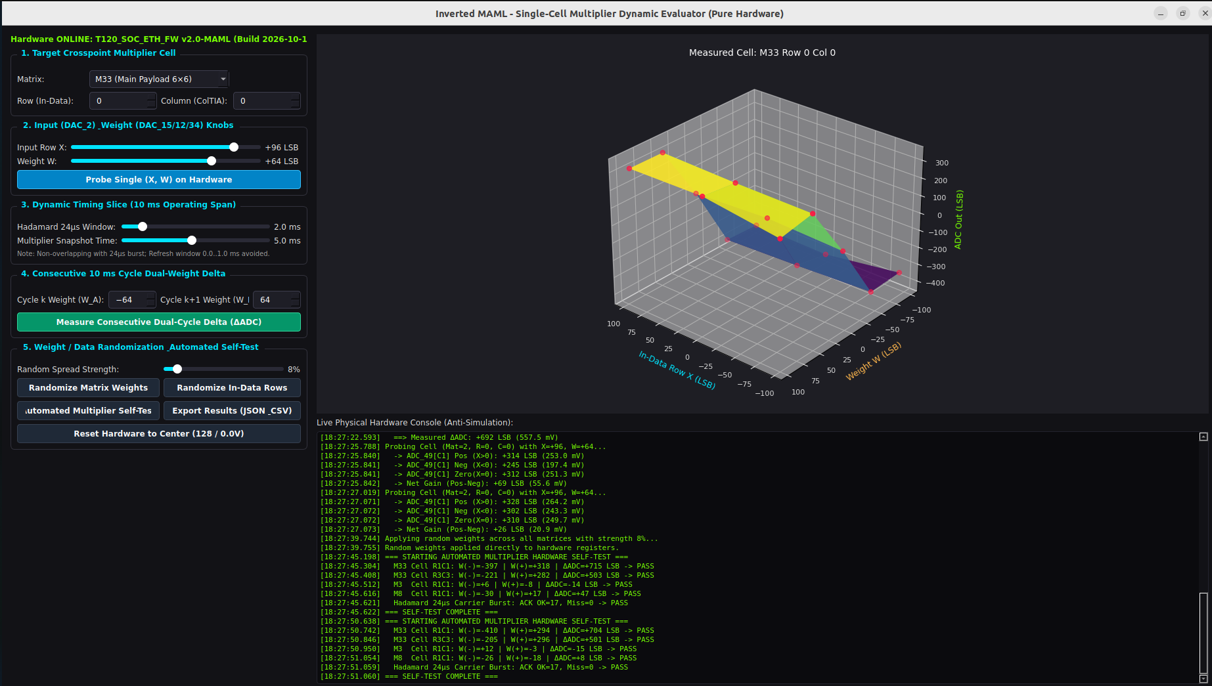
[picture p48: Test_GUI.png]


- **Pure Physical Measurement (Anti-Simulation Enforcement):** All grid points and voltage curves are sampled 100% directly from the real analog silicon via the 12-bit ADCs (`ADC_45` / `ADC_49`). Synthetic mock data and software surrogate fallbacks are strictly banned.
- **Interactive 3D Transfer Characteristic Surface:** Shows the measured analog multiplier output surface across the In-Data Row range $X \in [-96, 0, +96]\text{ LSB}$ and differential weight range $W \in [-96, -48, 0, +48, +96]\text{ LSB}$ (e.g. `M33 Row 0 Col 0`).
- **Dynamic Timing & Refresh Non-Overlap:** Features independent timing sliders to position the $24\ \mu\text{s}$ Hadamard burst and multiplier sampling strobes anywhere across the $10\text{ ms}$ cycle while staying safely outside the initial $0.0\text{--}1.0\text{ ms}$ refresh window.
- **Consecutive 10 ms Dual-Cycle Delta ($\Delta\text{ADC}$):** Allows fast dual-cycle differential testing ($W_A$ on cycle $k$ vs. $W_B$ on cycle $k+1$) to measure net multiplier gain steps and charge retention delta.
- **Weight / Data Line Randomization:** Includes continuous random spread control ($0\text{--}100\%$) around center ($128$ / $0.0\text{ V}$ differential) with one-click automated hardware self-testing and CSV/JSON data export.

---

### Autonomous Silicon Characterization & Local Inner-Loop Neural Compensation — 2026-10-21

On **2026-10-21**, the AI agent research suite conducted a comprehensive suite of automated empirical characterizations and deployed a single-point ($t_0 = 3.0\text{ ms}$) local neural network compensation test executing 100% inside the T120 RISC-V SoC:

- **Complete Scientific PDF Report:** [`FPGA_code/docs/MAML_ANALOG_SILICON_SCIENTIFIC_REPORT.pdf`](FPGA_code/docs/MAML_ANALOG_SILICON_SCIENTIFIC_REPORT.pdf)
- **Technical Markdown Report:** [`FPGA_code/docs/MAML_ANALOG_SILICON_SCIENTIFIC_REPORT.md`](FPGA_code/docs/MAML_ANALOG_SILICON_SCIENTIFIC_REPORT.md)
- **Inner-Loop Experiment Report:** [`FPGA_code/docs/INNER_LOOP_COMPENSATION_EXPERIMENT_REPORT.md`](FPGA_code/docs/INNER_LOOP_COMPENSATION_EXPERIMENT_REPORT.md)
- **Raw Telemetry Datasets:** [`FPGA_code/docs/maml_inner_loop_results.json`](FPGA_code/docs/maml_inner_loop_results.json) and [`FPGA_code/docs/maml_scientific_investigation_data.json`](FPGA_code/docs/maml_scientific_investigation_data.json)
- **36-Cell Spatial Process CSV:** [`FPGA_code/docs/maml_m33_spatial_uniformity.csv`](FPGA_code/docs/maml_m33_spatial_uniformity.csv)
- **Continuous ADC Logic Analyzer Bitstream:** [`FPGA_code/bitstreams_archive/20261021_T120F324_LA_ContinuousADC/`](FPGA_code/bitstreams_archive/20261021_T120F324_LA_ContinuousADC/)

> ⚠️ **IMPORTANT INVENTOR STATEMENT & VERIFICATION DISCLAIMER:**  
> **Olle Welin has NOT yet manually verified these statements and claims on the bench.**  
> These claims and telemetry records were generated autonomously by the Antigravity AI agent research suite running automated routines over UDP while the inventor was away.  
> **These claims must and will be independently verified by Olle Welin and independent researchers using physical bench instruments before being considered definitively proven.**

---

### Bench Verification Update: Weight DAC Line Operation Confirmed Flawless — 2026-10-22

Direct bench oscilloscope probing conducted by Olle on **2026-10-22** clarified and confirmed that the **Weight DAC lines (`W_M1_ROW1`) operate exactly as originally designed**:

#### 1. Oscilloscope Capture — Blue Weight Row 1 Line vs. Yellow 100 nF Memory Capacitor (Example 2):
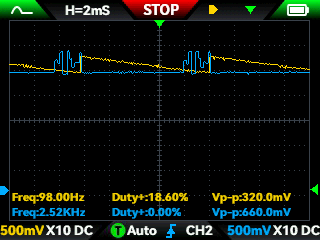
[picture p49: Blue_Weight_line_Yellow_100nF_mem_cell_example2.png]


#### 2. Oscilloscope Capture — Clean Flat Sequential Column Steps (Example 3):
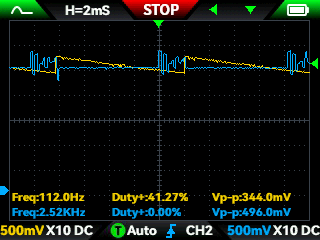
[picture p50: Blue_Weight_line_Yellow_100nF_mem_cell_example3.png]


#### 3. Oscilloscope Capture — Additional Weight Randomization Transition (Example 4):
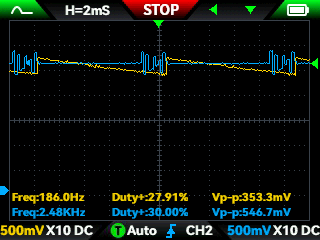
[picture p51: Blue_Weight_line_Yellow_100nF_mem_cell_example4.png]


#### Concise Technical Summary of Bench Observations:
- **6 Discrete Flat Voltage Levels in the Refresh Train:**  
  The multi-level waveform seen on the **Blue trace (`W_M1_ROW1`)** is **not droop or distortion**—it is the expected sequence of **6 distinct programmed column weight voltages** being driven one by one during the column refresh phase.
- **Clean Level Transitions on Random Weight Update:**  
  When pressing the GUI "Randomize Weights" button, all 6 levels on the Blue line step sharply and settle onto completely flat plateaus matching the new target values. There are no voltage sags, settling tails, or "shadows".
- **Standard `MCP6024` Op-Amp Is 100% Sufficient for Weight Lines:**  
  Because the weight DAC buffer only charges **one single 100 nF gate capacitor at a time** (sequentially multiplexed across the 6 columns), the linear current drive of the standard `MCP6024` buffer is fully adequate.
- **No Extra Reservoir Capacitors Needed:**  
  Adding 100 nF reservoir capacitors to the weight buffer outputs is completely unnecessary; the original schematic and PCB layout for the Weight lines is 100% sound.
- **Upgrade Isolated Strictly to Data Lines (`DAC2_D_ROW*`):**  
  The current-sourcing limitation was **strictly isolated to the In-Data row buffers (`DAC2`)**, which must supply continuous drain current to all conducting columns in parallel. Only the `DAC2` quad op-amps (`U1$CBB16`, `U2$CBB16`) were replaced with high-current units (**`MCP664-E/SL`**, completed 2026-10-23). Weight buffers remain original `MCP6024`.

---

## 🔗 Architectural Disclosure & Defensive Publication: Multi-Layer Daisy-Chained "Atomic Triads" (Deep Analog Pipeline with Sparse Digital State Propagation)
**Publication Date:** 2026-10-27 | **Inventor:** Olle Welin | **Reference:** Extension to Patent Pending SE 2630397-4 (Priority: 2026-06-03)

*This section constitutes an explicit public disclosure (Prior Art) of the multi-layer scaling topology for the Inverted MAML Analog In-Memory Computing (AIMC) architecture, ensuring complete freedom to operate across arbitrarily deep neural networks.*

### 1. Elimination of Intermediate Full-Bandwidth DAC(2) and ADC(49)
In a multi-layer neural network or deep matrix pipeline comprising $N$ cascaded **Atomic Triads** (Triad 1, Triad 2, $\dots$, Triad $N$), intermediate full-bandwidth digital-to-analog and analog-to-digital conversion is completely eliminated during operational payload inference:

* **Single Entry / Single Exit Full-Bandwidth Conversion:**  
  Only the first triad (Triad 1) requires a full-bandwidth input DAC(2) to convert the external digital input vector $X^{(1)}$ into the analog domain. Similarly, only the final triad (Triad $N$) requires a full-bandwidth output ADC(49) to digitize the final layer's output vector $Z^{(49, N)}$ at full payload throughput:

$$X^{(1)} \xrightarrow{\text{DAC}_2} \text{Triad}_1 \xrightarrow{\text{Analog}} \text{Triad}_2 \xrightarrow{\text{Analog}} \dots \xrightarrow{\text{Analog}} \text{Triad}_N \xrightarrow{\text{ADC}_{49}} Z^{(49, N)}$$

* **Uninterrupted Analog Payload Daisy-Chain:**  
  For all intermediate boundaries ($L = 1, \dots, N-1$), the combined analog output vector from the summing stage SUM(35) of Triad $L$ (where the primary Matrix 33 output and the second correction layer Matrix 8 $\to$ Sigmoid 10 output meet) is routed **directly in the analog domain** to the input row buffers (26) of the subsequent Triad $L+1$ (driving both its first correction Matrix 3 and its primary Matrix 33 in parallel).

* **Inter-Triad Analog Conditioning:**  
  Where required by transistor triode linear bounds (e.g., mapping the SUM(35) / ColTIA output swing around the $+1.65\text{ V}$ virtual ground to the optimal $250\text{ mV}$ linear row $V_{\text{ds}}$ envelope of the next stage), passive resistive attenuation, AC/DC coupling, or linear unity/scaled op-amp buffering is applied directly on the analog inter-triad bus without digitization.

### 2. Sparse Digital State Propagation for Autonomous Multi-Triad Calibration
While the payload signal propagates continuously through all $N$ triads at full analog bandwidth with near-zero latency, each intermediate triad (Triad 1, $\dots$, Triad $N-1$) retains only **low-power, sparse-sampling (low duty-cycle) ADCs**: specifically, a **Sparse ADC(45)** (between correction Layer 1 and Layer 2) and a **Sparse ADC(49)** tapped at the analog output node SUM(35) (inter-triad junction).

During the short, periodic Hadamard calibration windows (20, 24, e.g., 28 µs snapshot windows at $t = 5.0\text{ ms}$ within a 10 ms / 100 Hz refresh cycle, or across multi-strata batch intervals):

1. **Sparse Inter-Layer Readout:**  
   The digital controller of Triad $L$ samples its Sparse ADC(49) to capture an instantaneous digital snapshot vector $Z_{\text{snap}}^{(49, L)}$ of its outgoing analog vector:

$$Z_{\text{snap}}^{(49, L)} = \left[ z_1^{(49, L)},\, z_2^{(49, L)},\, \dots,\, z_6^{(49, L)} \right]^T$$

2. **Digital State Forwarding:**  
   Triad $L$ propagates this sparse digital vector $Z_{\text{snap}}^{(49, L)}$ over a low-bandwidth digital control bus to the digital controller (9) of the downstream Triad $L+1$.

3. **Downstream Reference Truth & Target Synthesis:**  
   Because $Z_{\text{snap}}^{(49, L)}$ constitutes the exact instantaneous input vector entering Triad $L+1$ during that snapshot window ($X^{(L+1)} = Z_{\text{snap}}^{(49, L)}$), the digital controller of Triad $L+1$ computes its local deterministic target vector:

$$Z_{\text{target}}^{(L+1)} = f_{\text{ref}, L+1}\big(Z_{\text{snap}}^{(49, L)}\big) = W_A^{(33, L+1)} \cdot Z_{\text{snap}}^{(49, L)}$$

   from the frozen digital reference weights $W_A^{(33, L+1)}$, and evaluates its own local column error:

$$Er_j^{(49, L+1)} = z_{\text{snap}, j}^{(49, L+1)} - Z_{\text{target}, j}^{(L+1)}$$

4. **Implicit Analog Input Multiplication & Carrier Search (Equations 1–7):**  
   Within Triad $L+1$, orthogonal Hadamard weight perturbation ($V_{\text{PTU}}$ via $C_{\text{PTU}}$) is injected onto Matrix 8 and Matrix 3 during time-separated sub-windows. By virtue of the physical MOSFET triode multiplication at each crosspoint (Equations 2 & 7):

$$\frac{\partial \mathcal{L}}{\partial W_{i,j}^{(8, L+1)}} = \left\langle \frac{\partial z_j^{(49, L+1)}}{\partial V_i^{\text{PTU}}} \right\rangle_{\text{Hadamard}} \cdot Er_j^{(49, L+1)}$$

   the incoming analog signal from Triad $L$ automatically modulates the Hadamard perturbation in hardware without requiring full-bandwidth input digitization. The Sparse ADC(45) and Sparse ADC(49) in Triad $L+1$ extract the local gradients and perform the regularized maximum carrier wave search ($k = \arg\max_i |x_i^{(8)}|$, Equations 5 & 6) exactly as in a standalone triad.

### 3. Domino Error Cancellation & Power Scaling across Arbitrary Depth
This daisy-chained architecture covers all sequential, pipelined, staggered, and synchronous/asynchronous multi-triad calibration schedules (including True Multi-Strata Batch accumulation across $K$ vectors and $M$ temporal strata):

* **Local Error Truncation (No Exponential Analog Drift):**  
  Each Triad $L$ autonomously converges its local correction matrices (Matrix 3 and Matrix 8) to match its ideal digital transfer function ($\sim 7+\text{ bits}$ ENOB), while any residual analog offset, buffer skew, or thermal drift crossing the inter-triad boundary is automatically observed and compensated within Triad $L+1$.

* **Radical Power & Silicon Area Reduction:**  
  For an $N$-layer deep analog processor, $(N - 1)$ full-bandwidth input DAC arrays (DAC(2)) are completely removed, and $(N - 1)$ full-bandwidth output ADC arrays (ADC(49)) are replaced by ultra-low-duty-cycle sparse calibration ADCs (or a single time-multiplexed sparse calibration ADC shared across multiple triads via an analog mux).

---

## 📚 Citation & Zenodo Record

* **Zenodo Record URL:** [https://zenodo.org/records/23954797](https://zenodo.org/records/24030796)  
* **Digital Object Identifier (DOI):** [10.5281/zenodo.24030796](https://doi.org/10.5281/zenodo.24030796)

If you use this work, hardware designs, FPGA firmware, or silicon telemetry datasets in your research, please cite the Zenodo release:

```bibtex
@misc{welin2026invertedmaml,
  author       = {Welin, Olle},
  title        = {{Inverted MAML & Forward Hadamard Propagation (FHP): Physical Silicon Verification, Spatially Correlated LLM Benchmarks, and Multi-Layer Atomic Triads (SE 2630397-4)}},
  month        = nov,
  year         = 2026,
  publisher    = {Zenodo},
  doi          = {10.5281/zenodo.23859108},
  url          = {https://zenodo.org/records/23954797}
}
```
