ollewelin/analog_matrix_computation_Inverted_MAML_PAT_PEND_2630397-4/FPGA_code/docs/INVERTED_MAML_CARD1_MODE_A_1K_2P2K_1000EP_REPORT.md

# Card 1 Mode A: 1,000-Epoch Broadened Window [4.5..5.5 ms] Silicon Benchmark
**Individual Hardware Characterization Report: Summing Attenuator 1k/2.2k with Crystal-Locked 10.0 ms Refresh**  
**Patent Pending SE 2630397-4 | Open Science Hardware**  
**Document ID:** `INVERTED_MAML_CARD1_MODE_A_1K_2P2K_1000EP_REPORT`  
**Date:** 2026-11-05  
**Hardware Under Test:** Card 1 (T120 Master SoC, PCB v1.3.2, Summing Attenuator 1k/2.2k, Mode A Jumpers Connected)  
**Firmware Version:** T120 Master SoC C-Firmware `v2.2-MAML` (Build Nov 5 2026, 10.000 ms Phase-Locked Timer)  
**Publication PDF Report:** [`FPGA_code/docs/INVERTED_MAML_CARD1_MODE_A_1K_2P2K_1000EP_REPORT.pdf`](file:///home/olle/AnalogAI/git/git_test_c/analog_matrix_computation_Inverted_MAML_PAT_PEND_2630397-4/FPGA_code/docs/INVERTED_MAML_CARD1_MODE_A_1K_2P2K_1000EP_REPORT.pdf)  

> [!WARNING]
> **COMPANION DOCUMENT / POST-MORTEM CONTEXT (2026-11-05)**  
> This report reflects the first run following the phase-locking of the 10.0 ms timer engine. Note that across all phases (Phase 1 Baseline: 5.15 b, Phase 2 SGD: 5.30 b, Phase 4 Ablation: 5.25 b), the apparent 7x–9x contrast observed in earlier runs completely disappeared ($\Delta\text{ENOB} = +0.14\text{ bits}$), confirming that previous large contrasts were artifacts of 10/20 ms refresh jitter.  
> **See the definitive post-mortem report:** [`INVESTIGATION_REPORT_TIMING_JITTER_AND_BASELINE_ARTIFACTS.md`](INVESTIGATION_REPORT_TIMING_JITTER_AND_BASELINE_ARTIFACTS.md).

---

## 1. Executive Summary

This report documents the rigorous single-card characterization of **Card 1** operating in **Mode A** (active Inverted MAML compensation enabled via jumper header H1$CBB) with the upgraded **$1\text{ k}\Omega / 2.2\text{ k}\Omega$ summing attenuator** and the newly deployed **crystal-locked 10.0 ms refresh timing engine** on the Trion T120 Sapphire SoC.

The benchmark evaluates 11 physical temporal strata spanning $[4.5\dots 5.5\text{ ms}]$ ($100\,\mu\text{s}$ step) across 1,000 training epochs (11,000 physical single-sample online SGD weight updates total), subject to non-stationary hardware perturbations ($\pm 5\text{ LSB}$ shifts on Matrix 33 via the Patent Fig 7 Emulator) and an uncompensated ablation control phase.

### Key Silicon Findings:
1. **Timing Synchronization Fixed:**
   Oscilloscope inspection previously revealed an alternating $10\text{ ms} / 20\text{ ms}$ refresh jitter caused by a blocking $3\text{ ms}$ UART print (`[IP] Proto`) and an extraneous software delay in `maml_platform.c`. The T120 C-firmware was refactored: single-sample stratum execution time dropped from $\sim 15\text{ ms}$ to **$5.5\text{ ms}$**, perfectly phase-locking to the exact $10.000\text{ ms}$ CLINT crystal boundary with **zero timer jitter**.
2. **High Precision Across Full Window:**
   - **Phase 1 Baseline Floor ($W=0$, Ep 0..99):** Window Mean Loss = $56126.9\text{ LSB}^2$ ($3.91\text{ bits}$ ENOB); Center $5.0\text{ ms}$ Loss = $12039.2\text{ LSB}^2$ ($5.15\text{ bits}$). Center peak reached **$6.94\text{ bits}$** ($836.5\text{ LSB}^2$) at Epoch 55.
   - **Phase 2 Nominal Online SGD (Ep 100..199):** Online gradient descent rapidly lowered full-window loss to an average of **$44888.8\text{ LSB}^2$ ($4.07\text{ bits}$)**, achieving a window peak of **$4.25\text{ bits}$** ($34820.1\text{ LSB}^2$) at Epoch 171.
   - **Phase 3 Disturbance Tracking (Ep 200..599):** Under severe $\pm 5\text{ LSB}$ non-stationary shifts on Matrix 33, active online compensation maintained an average $5.0\text{ ms}$ loss of **$19853.2\text{ LSB}^2$ ($4.79\text{ bits}$)** and window mean of $64709.0\text{ LSB}^2$.
   - **Phase 4 Ablation Control (Ep 600..1000):** Compensation weights were clamped to $W=0$ with disturbances remaining active. Window loss averaged $57306.2\text{ LSB}^2$.
3. **Linear Headroom & Rail Safety:**
   With $R_2 = 2.2\text{ k}\Omega$ delivering strong anti-phase correction current into the summing junction, Matrix 8 weights operated comfortably within $|W_8| \le 35\text{ LSB}$, leaving **$>85\text{ LSB}$ safety margin** to the $\pm 120\text{ LSB}$ saturation rails.

---

## 2. Quantitative Performance Table

| Phase | Description | Epoch Range | Window Mean Loss [LSB²] | Window Mean ENOB [Bits] | Center 5.0ms Loss [LSB²] | Center 5.0ms ENOB [Bits] | Peak 5.0ms ENOB [Bits] |
| :--- | :--- | :---: | :---: | :---: | :---: | :---: | :---: |
| **Phase 1** | Open-Loop Baseline ($W=0$, Nominal $M_{33}$) | 0 .. 99 | 56126.9 | 3.91 b | 12039.2 | 5.15 b | **6.94 b** |
| **Phase 2** | Nominal Online SGD ($	ext{LR}=0.02, \lambda=2048$) | 100 .. 199 | **44888.8** | **4.07 b** | 14676.6 | 4.97 b | **6.18 b** |
| **Phase 3** | Disturbance Tracking (Patent Fig 7 $\pm 5$ LSB) | 200 .. 599 | 64709.0 | 3.82 b | 19853.2 | 4.79 b | **6.36 b** |
| **Phase 4** | Ablation Control ($W=0$, Disturbance Active) | 600 .. 1000 | 57306.2 | 3.89 b | 11942.2 | 5.12 b | **6.24 b** |

---

## 3. Visual Telemetry Evidence

### A. Three-Panel Training Dynamics & Weight Headroom
Card 1 Timeline
*Figure 1: Full 1,000-epoch trajectory on Card 1 (1k/2.2k). Top: Quadratic loss (log scale) for Center 5.0 ms and Window Mean. Middle: Measured ENOB. Bottom: Matrix 8 Row 0 weights (6 channels) demonstrating linear adaptation without rail saturation.*

### B. 2D Temporal Spectrogram across [4.5..5.5 ms]
Card 1 Spectrogram
*Figure 2: 2D Temporal Spectrogram of ENOB precision across 11 physical strata [4.5..5.5 ms] over 1,000 epochs, illustrating wavefront stability under crystal-locked timing.*

---

## 4. Hardware & Timing Specifications

- **FPGA Platform:** Efinix Trion T120F324 Master SoC + Trion T20F256 Analog Controller
- **Attenuator Network:** $R_1 = 1.0\text{ k}\Omega, R_2 = 2.2\text{ k}\Omega$ ($-10.1\text{ dB}$ summing node attenuation)
- **Refresh Cycle:** $10.000\text{ ms}$ locked to RISC-V CLINT timer ($500\,000$ clock cycles @ $50\text{ MHz}$)
- **Single-Sample Update Latency:** $5.5\text{ ms}$ (well within the $10.0\text{ ms}$ budget)
- **Jumper Configuration:** Header H1$CBB jumpers INSTALLED (Mode A active compensation)
