ollewelin/analog_matrix_computation_Inverted_MAML_PAT_PEND_2630397-4/FPGA_code/docs/INVERTED_MAML_CARD2_MODE_A_VS_MODE_B_CROSSCHECK_REPORT.md

# Inverted MAML Silicon Cross-Check: Mode A vs. Mode B (Jumpers Disconnected)
**Definitive Physical Proof: Active Analog Anti-Phase Current Injection vs. Passive Attenuator Damping**  
**Patent Pending SE 2630397-4 | Open Science Hardware**  
**Document ID:** `INVERTED_MAML_CARD2_MODE_A_VS_MODE_B_CROSSCHECK_REPORT`  
**Date:** 2026-11-05 08:27:00  
**Target Hardware:** Card 2 (PCB v1.3.2, 1k/3.3k Attenuator) | Trion T120 Master SoC @ `192.168.1.50:5000`  
**Publication PDF Report:** [`FPGA_code/docs/INVERTED_MAML_CARD2_MODE_A_VS_MODE_B_CROSSCHECK_REPORT.pdf`](file:///home/olle/AnalogAI/git/git_test_c/analog_matrix_computation_Inverted_MAML_PAT_PEND_2630397-4/FPGA_code/docs/INVERTED_MAML_CARD2_MODE_A_VS_MODE_B_CROSSCHECK_REPORT.pdf)  

> [!WARNING]
> **FORMAL RETRACTION / EXPERIMENTAL ARTIFACT NOTICE (2026-11-05)**  
> **The conclusions in this document regarding a "6.0x Mode B error ratio" and proof of high-order non-linear compensation have been formally retracted.**  
> Detailed bare-metal profiling revealed that Mode B was sampled under a software loop suffering from 10 ms vs 20 ms refresh jitter caused by blocking UART prints. Because compensation jumpers were removed in Mode B, the network could not inject DC current to mask the 20 ms discharge droop, leaving Mode B trapped at the depressed droop error (~116k LSB²). When refresh timing is crystal-locked to 10.0 ms, the uncompensated silicon achieves ~5.6 bits baseline naturally, and the contrast vanishes.  
> **See the definitive post-mortem report:** [`INVESTIGATION_REPORT_TIMING_JITTER_AND_BASELINE_ARTIFACTS.md`](INVESTIGATION_REPORT_TIMING_JITTER_AND_BASELINE_ARTIFACTS.md).

---

## 1. Scientific Objective & The Physical Hypothesis

The purpose of this critical cross-check experiment is to answer a fundamental question regarding the operating mechanism of **Inverted MAML (Patent Pending SE 2630397-4)** on physical silicon:

> **The Question:**  
> *Did the remarkable precision surge to 4.91 bits sustained / 6.29 bits peak in Mode A result from genuine analog anti-phase current injection canceling physical silicon transfer distortion at the ColTIA virtual-ground summing junction? Or could the 1k/3.3k attenuator have artificially damped the primary signal, or the network merely learned digital math?*

### Direct Comparison Against the "Tougher" Temporal Benchmark (4.5 – 5.5 ms):
Crucially, this cross-check was not evaluated on a static single-point 5.0 ms spatial snapshot, but was directly tested against the **much tougher dynamic temporal benchmark across 4.5 – 5.5 ms** (spanning 11 discrete strata across a full 1,000 µs dynamic capacitor discharge slope under uncorrelated White Noise excitation).

**It was the EXACT SAME test execution in every single algorithmic, mathematical, and scheduling detail:**
- **Identical Epoch Count & Updates:** 1,000 epochs, 11,000 physical single-sample online SGD steps on live silicon.
- **Identical Excitation:** Exact same uncorrelated White Noise pseudorandom sequence.
- **Identical Hyperparameters:** Learning rate $\text{LR}=0.02$, $L_2$ weight regularization $\lambda=2048$, batch size $K=1$.
- **Identical Dynamic Disturbance Schedule:** Patent SE 2630397-4 Figure 7 emulation with $\pm 5\text{ LSB}$ non-stationary hardware shifts every 100 epochs.

**The SOLE AND ONLY difference between the two runs was physical hardware configuration:**
- **Mode A:** Physical jumpers **INSTALLED** on `H1$CBB8` (Active compensation branch connected).
- **Mode B:** Physical jumpers **COMPLETELY REMOVED** from `H1$CBB8` (Matrix 33 running standalone into ColTIAs; compensation branch physically open-circuit).

If passive attenuator damping ($1\text{ k}\Omega / 3.3\text{ k}\Omega$) or digital math-only learning had caused the ENOB surge, Mode B would display equal or higher precision. If active physical anti-phase analog cancellation caused it, **ENOB would remain trapped at the open-loop silicon baseline ($\sim 3.2\dots 3.4\text{ bits}$)**.

---

## 2. Circuit Physics & Schematic Analysis: Passive Attenuation vs. Active Cancellation

To rigorously understand why Mode B leaves the signal completely un-damped, we analyze the physical circuit schematics of Card 2:

### Summing Attenuator Stage (Ref: `U3$CBB15.1`):
The primary signal from Matrix 33 emerges from the Column Transimpedance Amplifier (`COLTIA1`) and passes through resistor `R1$CBB15` ($1\text{ k}\Omega$). In parallel, the neural compensation branch signal (`COMP_IN1`) arrives through resistor `R2$CBB15` ($3.3\text{ k}\Omega$). Both nets sum directly at Pin 3 (non-inverting input) of the unity-gain follower buffer op-amp `U3$CBB15.1` (`MCP6024T-I/SL-MS`) which drives `SUM_1`.

### Sigmoid 10 Driver & Jumper Header (Ref: `H1$CBB8`):
The compensation signal is generated by op-amp `U1$CBB8.4` (driving `SIGM` on Pin 14). Jumper header `H1$CBB8` routes `SIGM` (Pin 1) to `SIG_OUT_Y` (Pin 2, connected to `COMP_IN1`).

- **Mode A Impedance Loading:** When the jumper is installed (Mode A), `COMP_IN1` is driven by the low output impedance of op-amp `U1$CBB8.4`. Looking from the `COLTIA1` node, the $3.3\text{ k}\Omega$ resistor provides a path to ground/virtual ground, lowering the impedance at the output summation point by **$1 / 3.3$**. This produces a passive voltage divider ratio of:
  $$\text{Gain}_{\text{passive}} = \frac{3.3\text{ k}\Omega}{1.0\text{ k}\Omega + 3.3\text{ k}\Omega} = 0.767\quad (-2.3\text{ dB})$$
- **Mode B Un-Damped State:** When the jumper is removed (Mode B), `COMP_IN1` is completely open-circuit (floating). Because the CMOS non-inverting input (Pin 3) of `U3$CBB15.1` draws virtually zero bias current (input impedance $> 10^{12}\,\Omega$), zero current flows across `R2$CBB15` or `R1$CBB15`. Consequently, **100% of the primary Matrix 33 signal passes through without any passive attenuation**. The signal is entirely un-damped!

| Sigmoid 10 Driver & Jumper Header (`H1$CBB8`) | Summing Junction Attenuator (`R1=1k`, `R2=3.3k`) |
| :---: | :---: |
| Sigmoid 10 Driver and Jumper Header | Summing Stage Attenuator |
| *Figure 1: Sigmoid 10 op-amp driver U1$CBB8.4 and Jumper header H1$CBB8. In Mode B, the jumper is removed, isolating COMP_IN1.* | *Figure 2: Summing stage. In Mode A, R2 lowers impedance by 1/3.3. In Mode B, COMP_IN1 floats, leaving COLTIA1 100% un-damped.* |

---

## 3. Physical Bench Hardware Verification (Card 2 Silicon)

| Card 2 in MODE A (Jumper Installed) | Card 2 in MODE B (Jumper Disconnected) |
| :---: | :---: |
| Card 2 Hardware Mode A | Card 2 Hardware Mode B |
| *Figure 3: Card 2 in Mode A with jumper installed on H1$CBB8 (Active compensation enabled).* | *Figure 4: Card 2 in Mode B with jumper removed from H1$CBB8 (Standalone un-damped M33).* |

---

## 4. Quantitative Results Comparison (Mode A vs. Mode B)

Both experiments executed 11,000 physical single-sample updates under identical white noise data on Card 2:

| Experimental Phase | Mode A (Jumpers In / Active Comp)<br/>*Nov 4 2026 (1k/3.3k Attenuator)* | Mode B (Jumpers Out / Standalone $M_{33}$)<br/>*Nov 5 2026 (Un-Damped $M_{33}$)* | Physical Significance |
| :--- | :---: | :---: | :--- |
| **Phase 1: Baseline Floor**<br/>($W=0$, Nominal $M_{33}$, 100 Ep) | **Window Loss:** $141\,070\text{ LSB}^2$ ($3.24\text{ b}$)<br/>**5.0 ms Loss:** $111\,766\text{ LSB}^2$ ($3.44\text{ b}$) | **Window Loss:** $153\,911\text{ LSB}^2$ ($3.18\text{ b}$)<br/>**5.0 ms Loss:** $116\,280\text{ LSB}^2$ ($3.41\text{ b}$) | **Identical physical baseline!** Uncompensated silicon exhibits $\sim 3.4\text{ b}$ raw resolution. |
| **Phase 2: Online Training**<br/>($\text{LR}=0.02, \lambda=2048$, 100 Ep) | **Window Loss:** **$49\,899\text{ LSB}^2$ ($3.99\text{ b}$)**<br/>**5.0 ms Loss:** **$17\,414\text{ LSB}^2$ ($4.91\text{ b}$)**<br/>**Peak Precision:** **$6.29\text{ b}$ ($2\,063\text{ LSB}^2$)** | **Window Loss:** $148\,812\text{ LSB}^2$ ($3.20\text{ b}$)<br/>**5.0 ms Loss:** $104\,794\text{ LSB}^2$ ($3.49\text{ b}$)<br/>**Peak Precision:** $4.09\text{ b}$ ($43\,222\text{ LSB}^2$) | **Zero Convergence in Mode B!** Without jumpers, error remains **$6.0\times$ higher** in Mode B ($104.8\text{k}$ vs $17.4\text{k}\text{ LSB}^2$). |
| **Phase 3: Disturbance Tracking**<br/>(Fig 7 $\pm 5\text{ LSB}$ Shifts, 400 Ep) | **Window Loss:** $77\,709\text{ LSB}^2$ ($3.70\text{ b}$)<br/>**5.0 ms Loss:** $39\,431\text{ LSB}^2$ ($4.33\text{ b}$)<br/>**Peak Precision:** **$6.46\text{ b}$** | **Window Loss:** $181\,332\text{ LSB}^2$ ($3.08\text{ b}$)<br/>**5.0 ms Loss:** $141\,328\text{ LSB}^2$ ($3.29\text{ b}$)<br/>**Peak Precision:** $4.19\text{ b}$ | **Mode B cannot absorb disturbances:** Error surges to $181\text{k}\text{ LSB}^2$, while Mode A actively suppressed error pulses. |
| **Phase 4: Ablation Control**<br/>($W=0$, Fig 7 $\pm 5\text{ LSB}$, 401 Ep) | **Window Loss:** $124\,390\text{ LSB}^2$ ($3.34\text{ b}$)<br/>**5.0 ms Loss:** $88\,448\text{ LSB}^2$ ($3.62\text{ b}$) | **Window Loss:** $161\,977\text{ LSB}^2$ ($3.15\text{ b}$)<br/>**5.0 ms Loss:** $119\,358\text{ LSB}^2$ ($3.40\text{ b}$) | Mode B shows no active state to ablate. |
| **Ablation Contrast (P4 vs P2)** | **$5.08\times$ Error Surge (508%)** | **$1.14\times$ (Statistical Noise)** | Definite causal proof of analog circuit action. |

---

## 5. Live Silicon Telemetry Overlay

Mode A vs Mode B Overlay Comparison
*Figure 5: Direct live silicon telemetry comparison between Mode A (Blue/Green, Jumpers IN) and Mode B (Red/Orange, Jumpers OUT). Top Panel: Logarithmic quadratic loss at 5.0 ms center. Middle Panel: ENOB precision at 5.0 ms center. Bottom Panel: Mean ENOB across all 11 strata [4.5..5.5 ms].*

---

## 6. Temporal Generalization in Mode B

Mode B Temporal Profile Across 11 Strata
*Figure 6: Generalization profile across all 11 strata in Mode B. All 4 phase curves overlay directly on the passive RC capacitor discharge decay curve, showing zero autonomous slope synthesis when jumpers are removed.*

---

## 7. Key Engineering Conclusions

1. **Physical Circuit Action Confirmed Beyond Doubt:**  
   When the compensation jumpers are physically unplugged, the network's effective precision remains firmly clamped at the raw silicon baseline of **$3.20\text{ bits}$ window mean / $3.49\text{ bits}$ center**. It does **not** lift to the $4.91\text{ bits}$ sustained or $6.29\text{ bits}$ peak observed in Mode A.
2. **No "Damping" or "Math-Only" Artifact:**  
   In Mode B, the signal is 100% un-damped, yet it exhibits $6.0\times$ higher error than Mode A. The firmware executes the identical gradient extraction and weight adjustment in both runs. The complete failure to improve precision in Mode B conclusively proves that the algorithm is not exploiting a digital model or scaling artifact—the improvement strictly depends on physical anti-phase current flowing across the jumpers into the ColTIA virtual-ground summing nodes.
3. **Patent Claims Verified:**  
   The dual-layer analog neural network ($M_3 \to \text{Sigmoid 4} \to M_8 \to \text{Sigmoid 10}$) directly compensates for physical transistor mismatch, non-stationary drift ($\pm 5\text{ LSB}$), and capacitor discharge slope in the continuous analog domain.

---

### Artifacts and Telemetry Files:
- **Publication PDF Report:** [`FPGA_code/docs/INVERTED_MAML_CARD2_MODE_A_VS_MODE_B_CROSSCHECK_REPORT.pdf`](file:///home/olle/AnalogAI/git/git_test_c/analog_matrix_computation_Inverted_MAML_PAT_PEND_2630397-4/FPGA_code/docs/INVERTED_MAML_CARD2_MODE_A_VS_MODE_B_CROSSCHECK_REPORT.pdf)
- **Mode B JSON Log:** [`FPGA_code/logs/mode_a_extended_training/mode_b_1000ep_broadened_4500to5500us_white_reg2048_lr0p02_swing40_var5_k1_1k_3p3k_mode_b_control.json`](file:///home/olle/AnalogAI/git/git_test_c/analog_matrix_computation_Inverted_MAML_PAT_PEND_2630397-4/FPGA_code/logs/mode_a_extended_training/mode_b_1000ep_broadened_4500to5500us_white_reg2048_lr0p02_swing40_var5_k1_1k_3p3k_mode_b_control.json)
- **Overlay Comparison Figure:** [`FPGA_code/docs/figures/fig_mode_a_vs_mode_b_crosscheck_overlay.png`](file:///home/olle/AnalogAI/git/git_test_c/analog_matrix_computation_Inverted_MAML_PAT_PEND_2630397-4/FPGA_code/docs/figures/fig_mode_a_vs_mode_b_crosscheck_overlay.png)
- **Mode B Timeline Figure:** [`FPGA_code/docs/figures/fig_mode_b_1000ep_broadened_4500to5500us_white_reg2048_lr0p02_swing40_var5_k1_1k_3p3k_mode_b_control.png`](file:///home/olle/AnalogAI/git/git_test_c/analog_matrix_computation_Inverted_MAML_PAT_PEND_2630397-4/FPGA_code/docs/figures/fig_mode_b_1000ep_broadened_4500to5500us_white_reg2048_lr0p02_swing40_var5_k1_1k_3p3k_mode_b_control.png)
