ollewelin/analog_matrix_computation_Inverted_MAML_PAT_PEND_2630397-4/FPGA_code/docs/INVERTED_MAML_500EP_BROADENED_WINDOW_REPORT_EN.md

# INVERTED MAML: 500-Epoch Empirical Silicon Evaluation Across Broadened Temporal Window [4.5 - 5.5 ms]
### With Colored LLM-Like Data, 3D Topography Evolution, and Closed-Loop Proprioceptive Verification

**Patent Pending:** Swedish Patent Application SE 2630397-4  
**Inventor & System Architect:** Olle Welin  
**Platform:** Open Science Hardware | Efinix Trion T120 Master SoC (Ethernet @ `192.168.1.50:5000`) & T20 Controller  
**Dataset Source:** Physical telemetry from `FPGA_code/logs/mode_a_extended_training/mode_a_500ep_broadened_4p5to5p5ms_k20_llm.json`  
**Code Repository:** [https://github.com/ollewelin/analog_matrix_computation_Inverted_MAML_PAT_PEND_2630397-4](https://github.com/ollewelin/analog_matrix_computation_Inverted_MAML_PAT_PEND_2630397-4)  

---

## 1. Executive Summary & Core Research Question

### The Central Scientific Question:
> *Does the analog neural compensation path (Matrix 3 &rarr; Sigmoid 4 &rarr; Matrix 8 &rarr; Sigmoid 10 &rarr; Passive Attenuator &rarr; Summing Junctions 35) genuinely lift computational accuracy above both the uncompensated analog core (Matrix 33 alone) and an optimized static DC baseline across a realistic, time-varying capacitor discharge window (4.5 to 5.5 ms)?*

### Empirical Silicon Answer: An Unequivocal YES.
Physical differential ADC telemetry (XC2361A converters) proves that active neural training collapses the quadratic error by **98 %** and elevates effective analog resolution from **4.38 bits to 7.31 bits ENOB** at nominal 5.0 ms, lifting full-window generalization across all 10 strata to **4.15 bits**.

- **Phase 1: Uncompensated Matrix 33 Alone (Epochs 0–99, W = 0 LSB, Training OFF):**
  - Nominal 5.0 ms Loss: $29\,122.6\text{ LSB}^2$ ($98.53\text{ LSB}$ RMSE, **$4.38\text{ bits}$ ENOB**).
  - Window Mean Loss across $[4.5, 5.5]\text{ ms}$: $86\,796.5\text{ LSB}^2$ (**$3.73\text{ bits}$ ENOB**).
- **Phase 2: Calibrated Static DC Baseline (Epochs 100–199, Fixed Weights, Training OFF):**
  - Nominal 5.0 ms Loss: $18\,706.4\text{ LSB}^2$ ($78.96\text{ LSB}$ RMSE, **$4.70\text{ bits}$ ENOB**).
  - Window Mean Loss across $[4.5, 5.5]\text{ ms}$: $61\,089.1\text{ LSB}^2$ (**$3.92\text{ bits}$ ENOB**).
- **Phase 3: Active Inverted MAML Training (Epochs 200–270, Golden Convergence):**
  - **Nominal 5.0 ms Loss plummets by 98 % to $498.2\text{ LSB}^2$** ($15.78\text{ LSB}$ RMSE, **$7.31\text{ bits}$ ENOB** at Epoch 215).
  - Full-window generalization lifts to **$4.15\text{ bits}$ ENOB** ($53\,627.9\text{ LSB}^2$).
- **Phase 3 Long-Term (Epochs 320–500, Physical Rail Clamp Saturation):**
  - At Epoch 320, Columns 3 & 4 in Matrix 8 hit the physical $-120\text{ LSB}$ hardware rail clamp due to accumulated temporal DC discharge gradient, causing subsequent drift back to $24\,122.9\text{ LSB}^2$.

---

## 2. In-Data Generation: "Colored" LLM-Like Vectors & Hardware LayerNorm

Real Large Language Model (LLM) activation vectors are never uncorrelated white noise. Adjacent activation channels exhibit strong spatial correlation ($\\rho \approx 0.70 - 0.90$) due to multi-head self-attention token projections.

### A. Kac-Murdock-Szegö AR(1) Spatial Covariance Model (`COLOR_LLM_TOEPLITZ`):
Input vectors $X \in [-45, +45]^6$ are generated via a first-order autoregressive spatial filter with $\\rho = 0.85$ ($218/256$ Q8.8):
$$x_0 = w_0, \quad x_i = \rho \cdot x_{i-1} + (1 - \rho) \cdot w_i, \quad i \in \{1..5\}$$
where $w_i \sim \mathcal{U}[-45, +45]$ are independent uniform stochastic samples.

### B. Zero-Mean Centering (Hardware LayerNorm):
Because correlated inputs can induce a massive collective common-mode current that would drive single-supply ColTIA transimpedance amplifiers into saturation rails, the firmware enforces real-time zero-mean centering:
$$X_{\text{norm}, i} = x_i - \frac{1}{6} \sum_{j=0}^5 x_j$$
This maintains the physical summing junctions at exactly $1.65\text{ V}$ quiescent DC center.

---

## 3. Empirical Silicon Telemetry Table

| Metric | Phase 1: M33 Alone (Ep 0) | Phase 2: Fixed Baseline (Ep 120) | **Phase 3: Trained Peak (Ep 215/220)** | Phase 3: Saturated (Ep 500) |
| :--- | :---: | :---: | :---: | :---: |
| **Compensation Mode** | Zeroed ($W=0$) | Fixed Calibrated | **Active Trained (Optimal)** | Long-Term Saturated |
| **Training Status** | OFF (Ep 0) | OFF (Ep 120) | **ON (Ep 15–20 of Phase 3)** | ON (Ep 300 of Phase 3) |
| **Nominal 5.0 ms Loss** | $29\,122.6\text{ LSB}^2$ | $18\,706.4\text{ LSB}^2$ | **$498.2\text{ LSB}^2$** | $24\,122.9\text{ LSB}^2$ |
| **Nominal 5.0 ms RMSE** | $98.53\text{ LSB}$ | $78.96\text{ LSB}$ | **$15.78\text{ LSB}$** | $89.67\text{ LSB}$ |
| **Nominal 5.0 ms ENOB** | $4.38\text{ bits}$ | $4.70\text{ bits}$ | **$7.31\text{ bits}$** | $4.51\text{ bits}$ |
| **Window Mean Loss [4.5..5.5 ms]** | $86\,796.5\text{ LSB}^2$ | $61\,089.1\text{ LSB}^2$ | **$53\,627.9\text{ LSB}^2$** | $85\,965.6\text{ LSB}^2$ |
| **Window Mean ENOB [4.5..5.5 ms]** | $3.73\text{ bits}$ | $3.92\text{ bits}$ | **$4.15\text{ bits}$** | $3.75\text{ bits}$ |
| **M8 Diagonal Weights** | $[0, 0, 0, 0, 0, 0]$ | $[-20, -20, 20, 20, -20, 20]$ | $[-17, -17, 18, -4, -84, 30]$ | $[-4, 18, -91, -69, -119, 120]$ |

---

## 4. 3D Dual-2T1C Weight Landscapes (Baseline vs. Trained Golden Convergence)

3D Weight Landscapes

### Topographical Analysis:
- **Subplots 1 & 2 (Baseline, Epoch 100):** Display the engineered balanced baseline. $M_3$ rows 0..5 have alternating $\\pm 16/24\text{ LSB}$ weights to cancel common-mode Toeplitz currents; Row 6 (Clock B1, $330\text{ k}\\Omega$) is held in the linear S-bend; Row 7 is held as DC anchor. $M_8$ features $\\pm 20\text{ LSB}$ diagonal vernier weights and Row 6 Bias.
- **Subplots 3 & 4 (Golden State, Epoch 220):** Reveal the emergent trained topology. $M_3$ forms structured ridge patterns counter-acting Toeplitz correlations. $M_8$ establishes sharp differential tuning (Column 4 at $-84\text{ LSB}$, Column 5 at $+30\text{ LSB}$) that cancels residual analog nonlinearities.

---

## 5. 500-Epoch Trajectories: Loss, Resolution, and Weight Dynamics

500-Epoch Full Trajectory

---

## 6. Full 2D Trajectories of All Weights (Matrix 3 & Matrix 8 across 500 Epochs)

### Matrix 3 (First Triad Layer): 48 Dynamic Weights
Matrix 3 2D Trajectories

### Matrix 8 (Second Triad Layer): 42 Vernier Weights
Matrix 8 2D Trajectories

---

## 7. Deep Dive: Golden Window & Physical Drift Diagnosis (-120 LSB Clamp)

Deep Dive Analysis

### Physical Drift Mechanism Analysis:
1. **Asymmetric Temporal Discharge Gradient:** Over a 1000 µs window ($4.5$ to $5.5\text{ ms}$), $M_{33}$ capacitor discharge curve exhibits nonzero second derivative. Accumulating across 10 strata every batch update injects a persistent negative DC gradient into Columns 3 and 4.
2. **Integrator Windup:** With L2 regularization $\\lambda = 512$, restoring force was insufficient to overcome persistent DC gradient, driving weights into the $-120\text{ LSB}$ hardware rail clamp at Epoch 320.
3. **Loss of Vernier Control:** Once clamped at $-120\text{ LSB}$, the multipliers can no longer provide linear bidirectional corrections, causing Loss to drift back up.

---

## 8. Actionable Roadmap: Remediation Actions 1 & 2 to be Tested Next

### Action 1: Elevated L2 Regularization Attractor (\\lambda = 1024 or 2048)
- **Mechanism:** Scale the restoring decay $dW \mathrel{-}= \lambda \cdot (W - W_{\\text{null}})$ by $2\times$ to $4\times$.
- **Expected Outcome:** Constrains all weights strictly within $[-80, +80]\text{ LSB}$, preventing rail clamp collision and preserving the 6.0+ bit golden convergence permanently.

### Action 2: Dynamic Temporal Clock DC Relief via Rows 6 & 7
- **Mechanism:** Program Matrix 3 Clock Rows 6 (`TRIM_B1`) and 7 (`TRIM_REF`) to synthesize an explicit counter-ramp matching the average temporal discharge slope across $[4.5, 5.5]\text{ ms}$.
- **Expected Outcome:** Absorbs 100 % of the gross DC drift, allowing regular compute rows to focus purely on input-dependent dynamic errors without accumulating integrator windup.

---

## 9. Physical Hardware Silicon: Inverted MAML Proof-of-Concept PCB (v1.3.2)

Physical Hardware PCB v1.3.2

**Figure 9: Physical Proof-of-Concept Hardware (PCB v1.3.2, Inverted_MAML_IMC).**  
Designed and fabricated by inventor Olle Welin (Patent Pending SE 2630397-4). The board integrates a dual-FPGA Trion architecture: Trion T120F324 Master SoC (Ethernet @ `192.168.1.50:5000`, 32-bit RISC-V Sapphire) and Trion T20F256 Controller, high-speed 74HC595 differential DAC ladders, discrete 2T1C MOS triode analog multiplier crosspoint arrays (Matrix 33 payload, Matrix 3, and Matrix 8), differential ColTIA transimpedance amplifiers, and XC2361A high-speed differential ADCs.  
**Hardware Repository & Open Source RTL/Firmware:** [https://github.com/ollewelin/analog_matrix_computation_Inverted_MAML_PAT_PEND_2630397-4](https://github.com/ollewelin/analog_matrix_computation_Inverted_MAML_PAT_PEND_2630397-4)  

---

## 10. Patented Inverted MAML Proprioceptive Architecture (Patent SE 2630397-4 Fig 1)

Patented Architecture Fig 1

**Figure 10: Inverted MAML Proprioceptive Feedback Architecture (Patent Application SE 2630397-4, Fig 1).**  
Digital input (1) is converted via DAC ladder (2) into analog signals driving both the primary uncompensated matrix Matrix 33 (33) and the first Vernier matrix Matrix 3 (3). The output of Matrix 3 passes through analog sigmoid activation (4) and is sampled by ADC (45) for the digital controller (9). The second Vernier matrix Matrix 8 (8) injects anti-phase compensation currents into summing junctions (35) before final transimpedance amplification and sampling by ADC (49) to produce the high-precision digital output (11).

---

## 11. Forward Hadamard Propagation (FHP) & Capacitive Perturbation (Patent Fig 8)

> **Forward Hadamard Propagation (FHP) – parallel capacitive perturbation for single-shot analog gradient extraction. (Works for physical unknown Analog Neural Networks).**

Patent Fig 8 FHP Circuit

### Physical Circuit Operation & Theoretical Breakthrough of FHP (SE 2630397-4 Fig 8):
1. **Parallel Capacitive Perturbation ($C_{\text{PTU}}$, Ref 7):** An AC perturbation square wave $V_{\text{PTU}}$ (5) is modulated by 3-state Hadamard drivers (6) along perturbation lines $PL_1..PL_n$. Each crosspoint cell couples the carrier through dedicated perturbation capacitor $C_{\text{PTU}}$ (7) onto the floating gate storage node $C_W$ (44) of the 2T1C MOS triode transistor. Crucially, $C_{\text{PTU}}$ perturbs the operating point dynamically without altering or leaking the static stored weight voltage.
2. **Single-Shot Analog Gradient Extraction:** In conventional analog tuning, extracting the gradient vector of $N$ weights requires $2N$ sequential forward perturbations, creating massive latency and thermal drift. FHP applies mutually orthogonal Walsh/Hadamard carrier waves simultaneously across all rows. In a single analog measurement snapshot ($t = 5.0\text{ ms}$), the composite response at the summing amplifiers is projected onto the Hadamard basis in the digital domain (T120 SoC), isolating all partial derivatives in $O(1)$ time.
3. **Universal In-Situ Training for Arbitrary Analog Networks:** FHP requires zero internal analytical models of the physical transistors, threshold voltages, parasitic capacitances, or thermal drift. It treats the physical Analog Neural Network as a true unknown black box, enabling robust closed-loop learning on physical silicon where classical backpropagation fails.
4. **Complete Source Code & Hardware Repository:** [https://github.com/ollewelin/analog_matrix_computation_Inverted_MAML_PAT_PEND_2630397-4](https://github.com/ollewelin/analog_matrix_computation_Inverted_MAML_PAT_PEND_2630397-4)  

---

## 12. Verification & Open Science Reproducibility Summary

All experimental findings presented in this report were executed live on physical silicon hardware (Trion T120 Master SoC, Trion T20 Controller, Dual-2T1C silicon arrays) and recorded via UDP telemetry. Zero software emulation or synthetic interpolation was utilized. The full telemetry logs, Verilog RTL, firmware source code, and calibration datasets are archived and publicly verifiable in the project repository.
