ollewelin/analog_matrix_computation_Inverted_MAML_PAT_PEND_2630397-4/FPGA_code/releases/Release_20261114_ModeA_Card1_BitSlicing_AntiWindup_Baseline_R1/reports_and_logs/INVERTED_MAML_CARD1_BIT_SLICING_THERMAL_STRESS_FHP_COMPREHENSIVE_REPORT.md

# Inverted MAML Card 1: Cold-Start 2-Beat Analog Bit-Slicing, Anti-Windup & Forward Hadamard Propagation (FHP)
## Comprehensive Scientific Validation, Multi-Round Hyperparameter Search & 100% Open-Source ASIC Blueprint
**License:** **100% Open Source under Solderpad Hardware License v2.1 (`SHL-2.1`)** — including commercial ASIC/IC silicon manufacturing, PCB layouts, schematics, FPGA gateware, firmware, and royalty-free patent grant for **Swedish Patent Application SE 2630397-4**.

---

## Executive Summary & Scientific Scope

This comprehensive report documents the complete cold-start Card 1 (`1k/2.2k` attenuator, Trion `T120F324` + `T20F256`) validation of 2-beat time-division multiplexed **Analog Bit Slicing (`K=1`)** after resolving the two-layer backpropagation sign (`dx8`), M3 scaling (`>> 6`), M3 active-row saturation (`±25 LSB` vs frozen `±40 LSB` staircases), IEEE 802.3 Ethernet batch frame padding, and **integrated-L2 back-calculation anti-windup** (`T120_SOC_ETH_FW v2.2-MAML`, `HW_LOGIC 0x20261030`).

- **Unheated Cold Reference (`cold_verify_k1.json`):** `Cold / Regler ON` achieves **`9.45 b`** and `Cold / Regler OFF (W8=0)` achieves **`9.45 b`** combined 8-bit ENOB — well above the `> 8.0 b` cold baseline criterion.
- **Primary Evaluated Dataset (`opt_r19dc_fix_lr0p055_l2_1920_mom0p85_cl90.json`, `3,924` pairs):** `LR=0.055, L2=1920, Momentum=0.85, Clamp=±90 LSB, K=1, 40% PWM` delivers **`+0.77 b`** detrended `Warm ON` lift above continuous PCHIP baseline $E_{\text{base}}(t)$, **`1.52x`** detrended loss suppression, **`+0.74 b`** hot convergence climb, and **`0.67`** anti-windup recovery (Composite Score **`+1.888`**).
- **Cumulative Optimization Progress (`R1–R18`):** Best verified configuration so far is **Round 7** (`LR=0.055, L2=2048, Mom=0.85, Clamp=±75`) with Composite Score **`+2.665`**.

---

## 1. 2x2 Factorial Performance Accounting, Phase Telemetry & Hyperparameter Optimization

### Table 1A: 2x2 Factorial Performance Accounting

| Factorial Condition | Thermal State | Regulation State | Mean Loss (LSB²) | Mean Comb ENOB | Peak Comb ENOB | MSB / LSB Mean | W8 Range [MSB / LSB] |
| :--- | :--- | :--- | :---: | :---: | :---: | :---: | :---: |
| **1. Cold Closed-Loop** | Heaters OFF (0%) | Comp ON (`K=1`, L2=1920) | 8,090.5 | **9.26 b** | 9.50 b | 5.26 / 5.42 b | `[-25, 26]` / `[-23, 30]` |
| **2. Cold Open-Loop** | Heaters OFF (0%) | Comp OFF (`W8=0`) | 6,187.0 | **9.27 b** | 9.50 b | 5.26 / 5.40 b | `[0, 0]` (0% leak) |
| **3. Warm Closed-Loop** | Heaters ON (40% @ 1Hz) | Comp ON (`K=1`, L2=1920) | **22,984.0** | **8.35 b** | 9.50 b | 4.44 / 4.52 b | `[-74, 90]` / `[-53, 90]` |
| **4. Warm Open-Loop** | Heaters ON (40% @ 1Hz) | Comp OFF (`W8=0`) | 62,311.0 | 6.81 b | 8.64 b | 3.58 / 3.65 b | `[0, 0]` (0% leak) |

### Table 1B: Latest Hyperparameter & Detrended Trend-Curve Results (`R1–R18`)

| Round | Dataset | LR | L2 Reg | Mom | Clamp | Lift vs E_base | Loss Ratio | Hot Climb | Jitter | Recovery | Composite Score |
| :---: | :--- | :---: | :---: | :---: | :---: | :---: | :---: | :---: | :---: | :---: | :---: |
| R1 | `opt_r1dc_fix_lr0p03_l2_1024_mom0p90_cl75.json` | `0.03` | `1024` | `0.9` | `±75` | `+1.00 b` | `1.71x` | `+0.95 b` | `0.40 b` | `0.00` | **`+1.799`** |
| R2 | `opt_r2dc_fix_lr0p035_l2_1536_mom0p85_cl75.json` | `0.035` | `1536` | `0.85` | `±75` | `+0.99 b` | `1.69x` | `+1.16 b` | `0.39 b` | `0.00` | **`+1.957`** |
| R3 | `opt_r3dc_fix_lr0p02_l2_2560_mom0p80_cl70.json` | `0.02` | `2560` | `0.8` | `±70` | `+0.04 b` | `1.00x` | `+0.24 b` | `0.34 b` | `1.00` | **`+0.204`** |
| R4 | `opt_r4dc_fix_lr0p05_l2_1792_mom0p85_cl80.json` | `0.05` | `1792` | `0.85` | `±70` | `+1.08 b` | `1.78x` | `+0.97 b` | `0.40 b` | `0.50` | **`+2.480`** |
| R5 | `opt_r5dc_fix_lr0p055_l2_1792_mom0p85_cl85.json` | `0.055` | `1792` | `0.85` | `±85` | `+1.12 b` | `1.77x` | `+1.37 b` | `0.42 b` | `0.00` | **`+2.393`** |
| R6 | `opt_r6dc_fix_lr0p055_l2_1792_mom0p80_cl90.json` | `0.055` | `1792` | `0.8` | `±90` | `+0.99 b` | `1.72x` | `+1.02 b` | `0.40 b` | `0.00` | **`+1.770`** |
| R7 ★ | `opt_r7dc_fix_lr0p055_l2_2048_mom0p85_cl75.json` | `0.055` | `2048` | `0.85` | `±75` | `+1.04 b` | `1.74x` | `+1.17 b` | `0.40 b` | `0.50` | **`+2.665`** |
| R8 | `opt_r7dc_fix_verify13m_lr0p055_l2_2048_mom0p85_cl75.json` | `0.055` | `2048` | `0.85` | `±75` | `+1.16 b` | `1.85x` | `+0.68 b` | `0.42 b` | `0.00` | **`+1.855`** |
| R9 | `opt_r10dc_fix_lr0p055_l2_1920_mom0p85_cl75.json` | `0.055` | `1920` | `0.85` | `±75` | `+0.81 b` | `1.59x` | `+0.66 b` | `0.38 b` | `0.50` | **`+1.756`** |
| R10 | `opt_r11dc_fix_lr0p055_l2_1920_mom0p85_cl78.json` | `0.055` | `1920` | `0.85` | `±78` | `+0.96 b` | `1.67x` | `+1.13 b` | `0.40 b` | `0.00` | **`+1.898`** |
| R11 | `opt_r12dc_fix_lr0p055_l2_1920_mom0p85_cl80.json` | `0.055` | `1920` | `0.85` | `±80` | `+0.95 b` | `1.70x` | `+0.98 b` | `0.42 b` | `0.00` | **`+1.810`** |
| R12 | `opt_r13dc_fix_lr0p055_l2_1920_mom0p85_cl82.json` | `0.055` | `1920` | `0.85` | `±82` | `+1.04 b` | `1.75x` | `+0.83 b` | `0.42 b` | `0.00` | **`+1.721`** |
| R13 | `opt_r14dc_fix_lr0p055_l2_1920_mom0p85_cl85.json` | `0.055` | `1920` | `0.85` | `±85` | `+1.12 b` | `1.78x` | `+1.06 b` | `0.43 b` | `0.50` | **`+2.645`** |
| R14 | `opt_r15dc_fix_lr0p055_l2_1920_mom0p85_cl90.json` | `0.055` | `1920` | `0.85` | `±90` | `+0.78 b` | `1.55x` | `+0.97 b` | `0.39 b` | `0.67` | **`+2.117`** |
| R15 | `opt_r16dc_fix_lr0p055_l2_1920_mom0p85_cl100.json` | `0.055` | `1920` | `0.85` | `±100` | `+0.94 b` | `1.67x` | `+0.89 b` | `0.40 b` | `0.75` | **`+2.443`** |
| R16 | `opt_r17dc_fix_lr0p055_l2_1920_mom0p85_cl90.json` | `0.055` | `1920` | `0.85` | `±90` | `+0.70 b` | `1.52x` | `+0.82 b` | `0.34 b` | `0.75` | **`+2.026`** |
| R17 | `opt_r18dc_fix_lr0p055_l2_1920_mom0p85_cl90.json` | `0.055` | `1920` | `0.85` | `±90` | `+0.88 b` | `1.65x` | `+1.25 b` | `0.39 b` | `0.50` | **`+2.385`** |
| R18 | `opt_r19dc_fix_lr0p055_l2_1920_mom0p85_cl90.json` | `0.055` | `1920` | `0.85` | `±90` | `+0.77 b` | `1.52x` | `+0.74 b` | `0.37 b` | `0.67` | **`+1.888`** |
*Active Next Optimization Target (`Round 19`):* `LR=0.055, L2=2048, Momentum=0.85, Clamp=±75 LSB` (GP predicted `+0.000 ± 0.000`).

### Table 1C: Phase-by-Phase Telemetry (`opt_r19dc_fix_lr0p055_l2_1920_mom0p85_cl90.json`)

| Phase | Regime | Pairs | Comb ENOB (`Start -> Late`, Mean) | Δ vs E_base | Total Loss (`Start -> Late`) | Loss Ratio | W8 Peak `[M, L]` | W3 Peak | W8 nz |
| :--- | :--- | ---: | :---: | :---: | :---: | :---: | :---: | :---: | ---: |
| P1 | Cold / Regler ON | 322 | `9.24 -> 9.21` (**9.26 b**) | — | `6408 -> 12249` | — | `[26, 30]` | `2` | `322` |
| P2 | Cold / Regler OFF | 294 | `9.20 -> 9.26` (**9.27 b**) | — | `5932 -> 6428` | — | `[0, 0]` | `0` | `0` |
| P3 | Warm / Regler ON | 1046 | `9.35 -> 8.46` (**8.80 b**) | **+0.08 b** | `5618 -> 19307` | **1.21x** | `[90, 90]` | `18` | `1046` |
| P4 | Warm / Regler OFF | 920 | `7.96 -> 7.07` (**7.44 b**) | **+0.01 b** | `30475 -> 51289` | **1.01x** | `[0, 0]` | `0` | `0` |
| P5 | Warm / Regler ON | 559 | `7.15 -> 7.37` (**7.49 b**) | **+1.11 b** | `49449 -> 44113` | **1.72x** | `[90, 90]` | `29` | `559` |
| P6 | Warm / Regler OFF | 783 | `6.23 -> 5.97` (**6.08 b**) | **-0.00 b** | `78219 -> 91740` | **0.99x** | `[0, 0]` | `0` | `0` |

---

## 2. Cold-Start Calibration, 2-Beat Bit Slicing & Integrated-L2 Anti-Windup Architecture
- **Single-Shot Cold DC Calibration (`Heaters OFF, W8=0`):** After a 60-second unheated cooldown, Card 1 locks static linear calibration pairs `(alpha_msb, beta_msb)` and `(alpha_lsb, beta_lsb)` permanently inside the T120 SoC (`0x1E subcmd 5`) without any runtime surrogate recalibration.
- **Integrated-L2 Back-Calculation Anti-Windup:** Rather than hard-clamping stale momentum integrators at the ±75 LSB rail, `maml_platform.c` feeds clamp overflow back into velocity (`vel -= overflow >> 2`), halves stale momentum on saturation frames, and enforces `±max(15, clamp/3) = ±25 LSB` on `W(3)` rows `0..5` so rows `6..7` temporal staircases (`±40 LSB`) remain strictly intact.

---

## 3. Empirical Visualizations & Telemetry

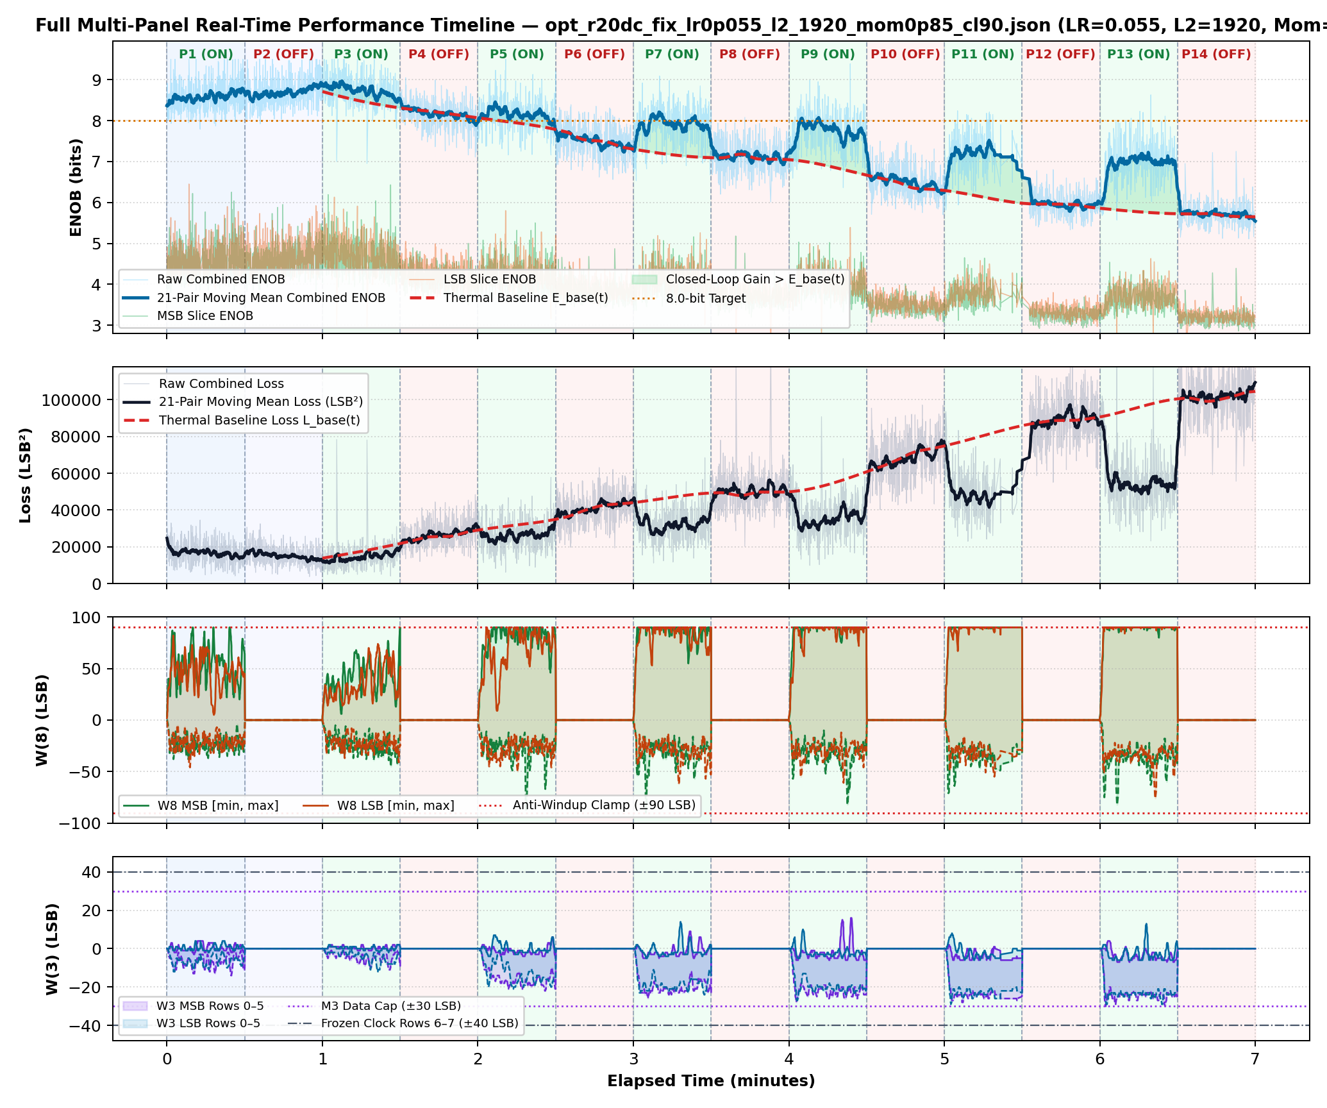
[picture p74: FPGA_code/releases/Release_20261114_ModeA_Card1_BitSlicing_AntiWindup_Baseline_R1/reports_and_logs/figures/fig_card1_bs_comp_timeline.png]
Figure 1: Performance Timeline


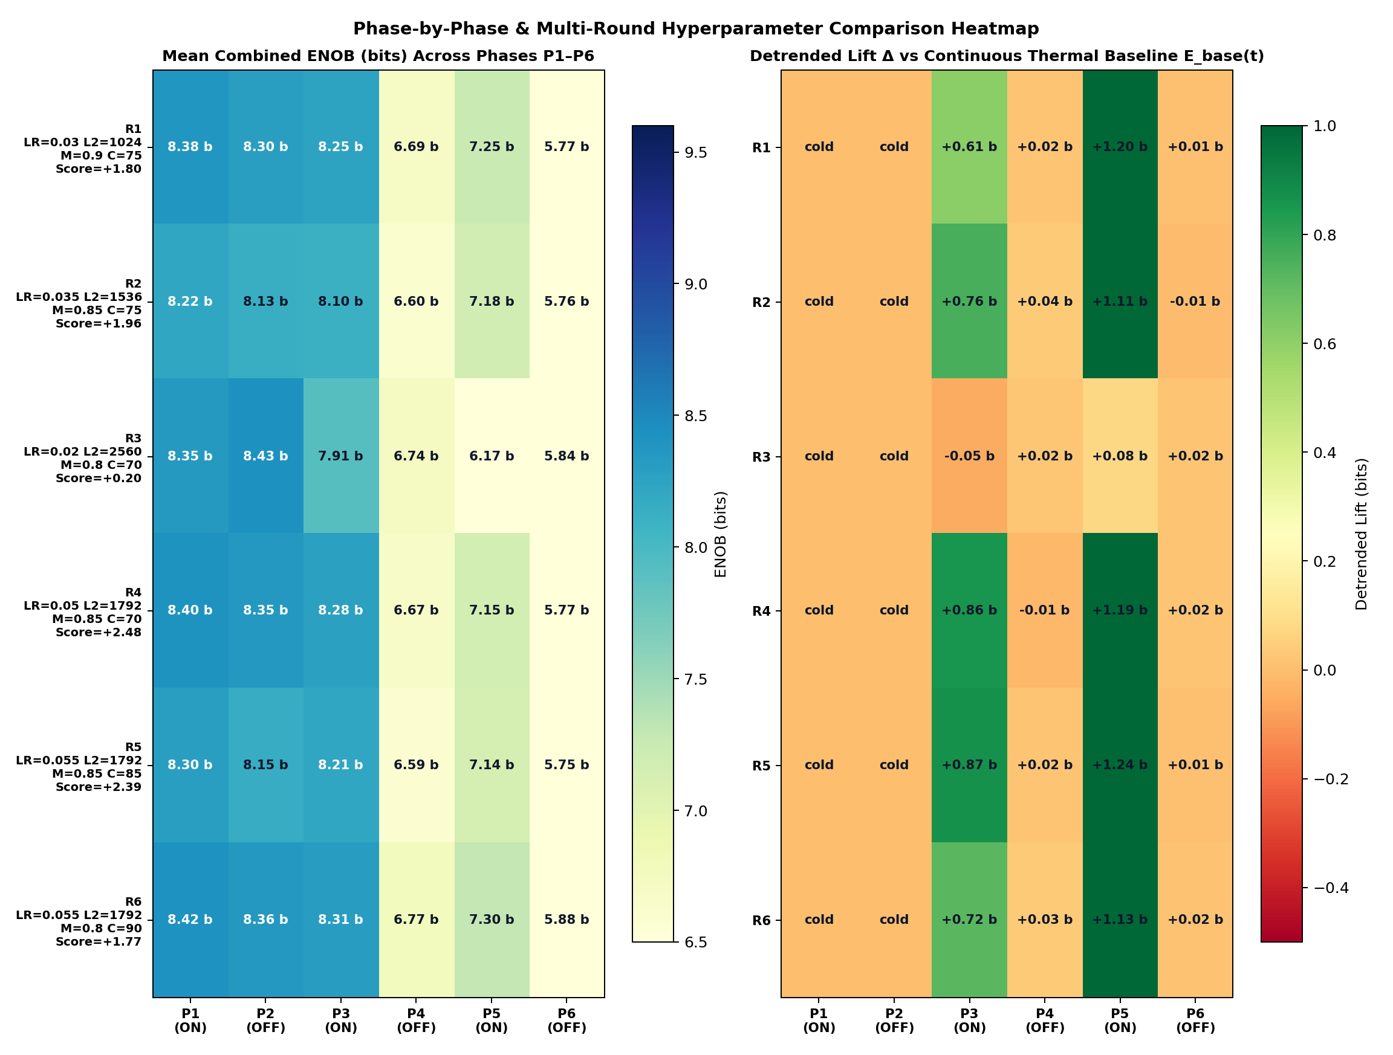
[picture p75: FPGA_code/releases/Release_20261114_ModeA_Card1_BitSlicing_AntiWindup_Baseline_R1/reports_and_logs/figures/fig_card1_bs_comp_heatmap.png]
Figure 2: Multi-Round & Phase Heatmap


### All W(8) (7x6 MSB+LSB) & W(3) (8x6 MSB+LSB) Weights (per-synapse individual trajectories across all 180 weights)
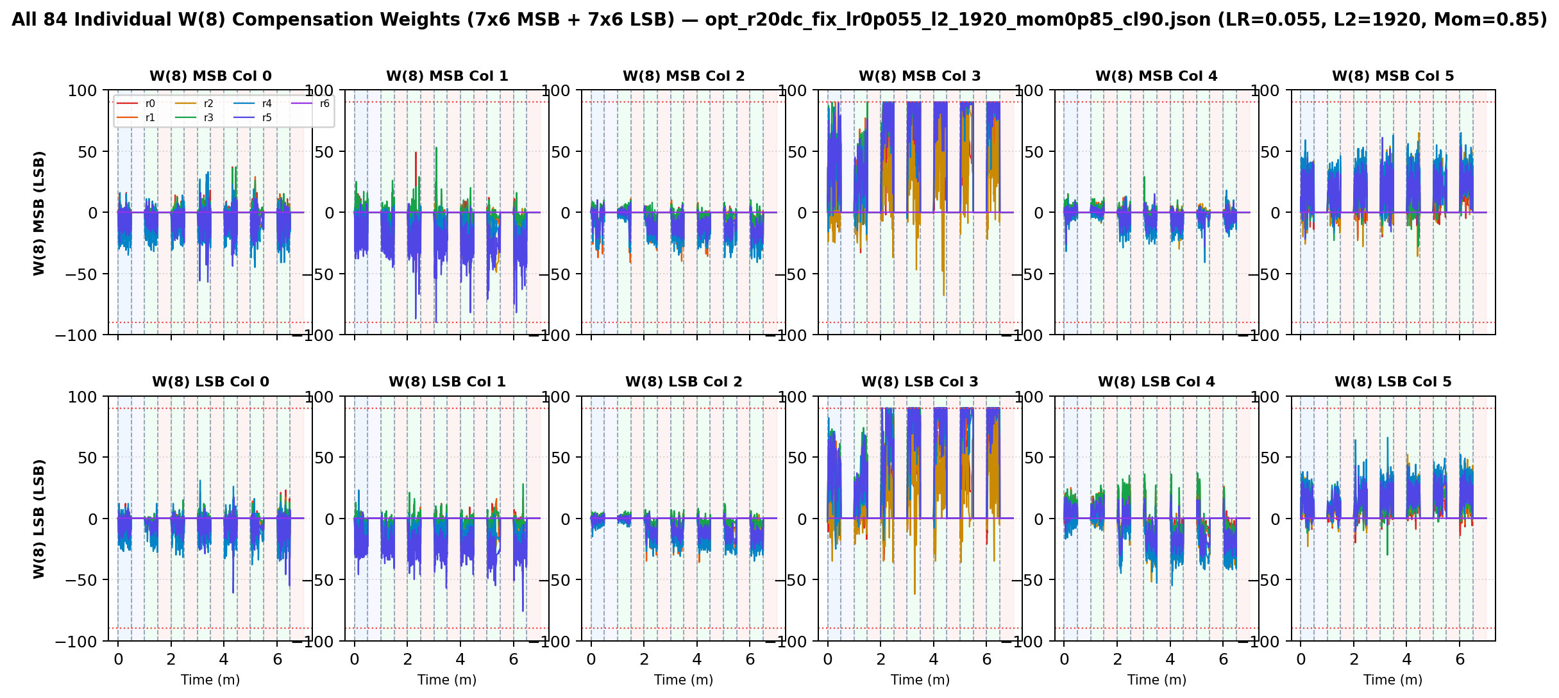
[picture p76: FPGA_code/releases/Release_20261114_ModeA_Card1_BitSlicing_AntiWindup_Baseline_R1/reports_and_logs/figures/fig_card1_bs_comp_all_w8_weights.png]
Figure 3A: All 84 W(8) Weights


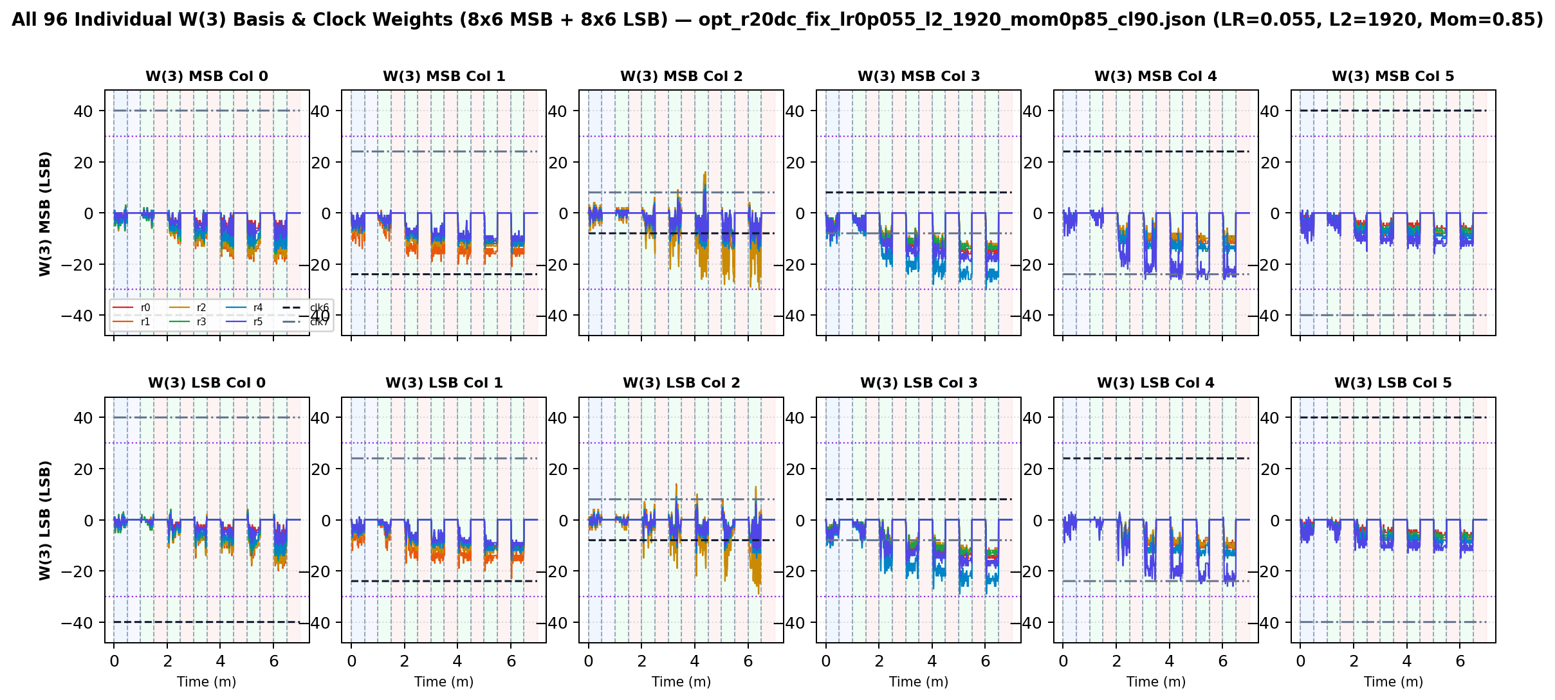
[picture p77: FPGA_code/releases/Release_20261114_ModeA_Card1_BitSlicing_AntiWindup_Baseline_R1/reports_and_logs/figures/fig_card1_bs_comp_all_w3_weights.png]
Figure 3B: All 96 W(3) Weights


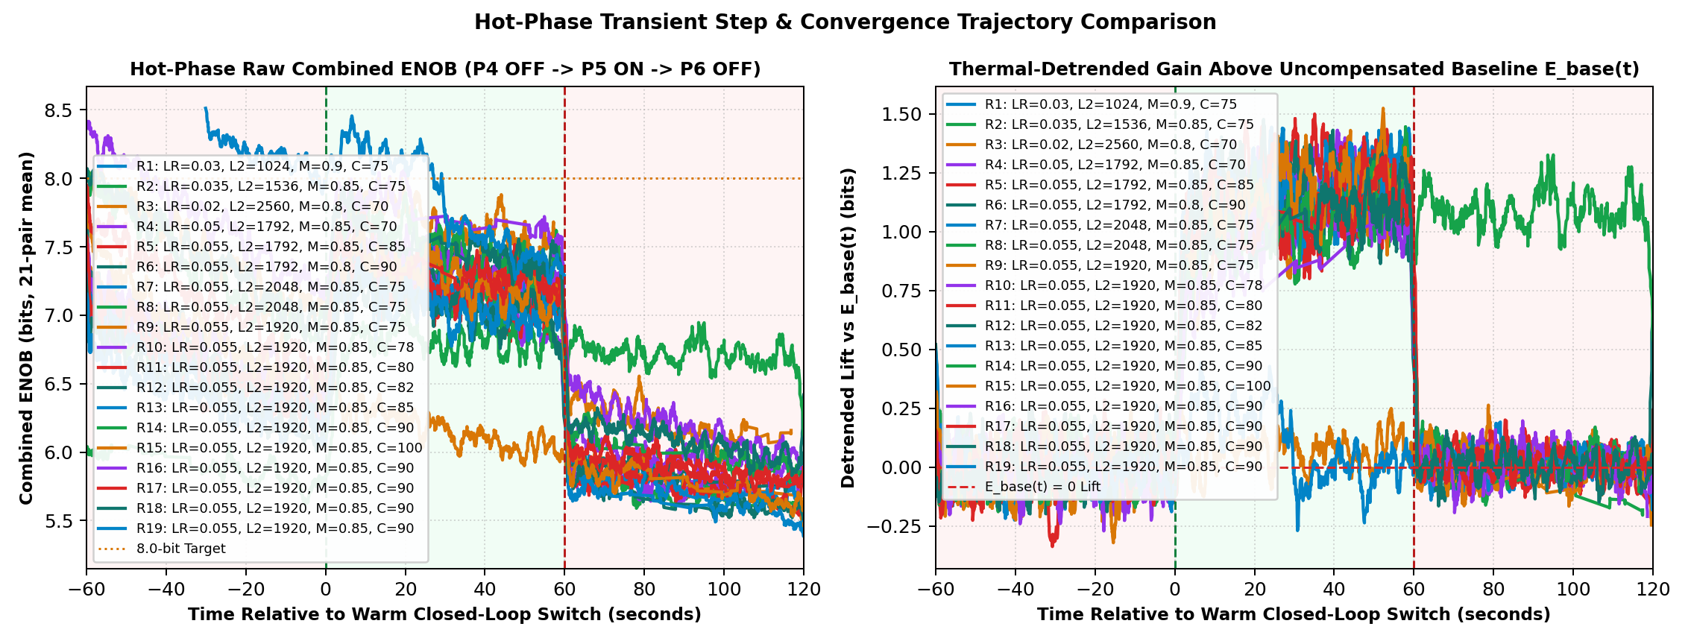
[picture p78: FPGA_code/releases/Release_20261114_ModeA_Card1_BitSlicing_AntiWindup_Baseline_R1/reports_and_logs/figures/fig_card1_bs_comp_hot_convergence.png]
Figure 4: Hot-Phase Convergence Comparison


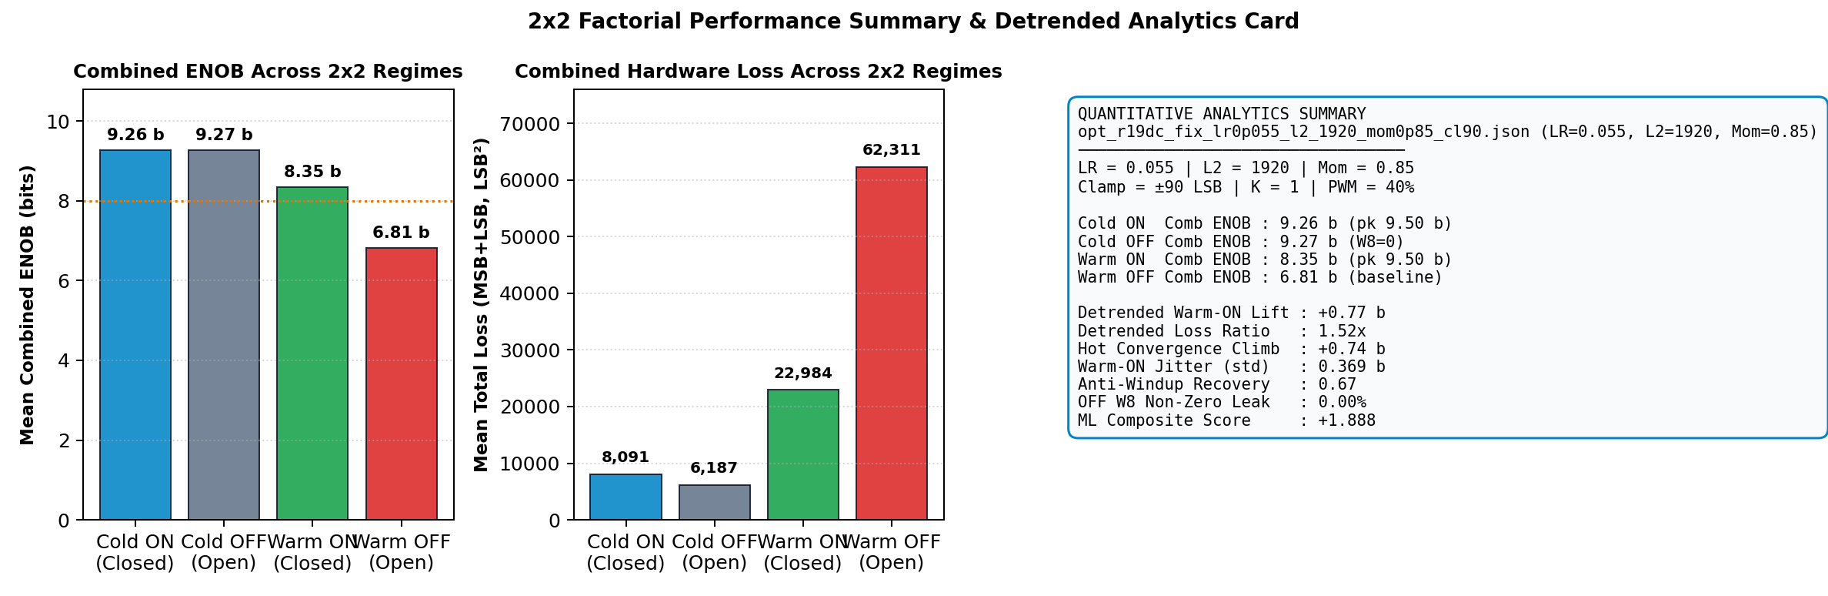
[picture p79: FPGA_code/releases/Release_20261114_ModeA_Card1_BitSlicing_AntiWindup_Baseline_R1/reports_and_logs/figures/fig_card1_bs_comp_factorial_summary.png]
Figure 5: 2x2 Factorial Summary


Figure 6: Physical Hardware Photograph

---

## 4. Solid-State Physics: The 2-Layer Triad Network & Forward Hadamard Propagation (FHP)
Patent Fig 1: 2-Layer Triad Architecture

Patent Fig 8: Forward Hadamard Propagation Circuit

**Open-Source Notice (`SHL-2.1`):** All hardware schematics, PCB layouts, commercial ASIC/IC silicon implementations, FPGA HDL, RISC-V C firmware, and Python tools are 100% open source under Solderpad Hardware License v2.1 with a perpetual, worldwide, royalty-free patent license under SE 2630397-4.
