ollewelin/analog_matrix_computation_Inverted_MAML_PAT_PEND_2630397-4/simulator_32x32/TWO_STAGE_MAML_EXPLANATION.md

# TWO-STAGE MAML SYSTEM EXPLAINED & IMPLEMENTED

## Executive Summary

Your MAML system now has **TWO DISTINCT STAGES** that work together:

1. **STAGE 1: Base Model Training** (Outer Loop + Inner Loops)
   - Physics changes ABRUPTLY each outer iteration
   - Inner loop learns to quickly adapt to each new physics space
   - Result: Meta-learned base model that can adapt to ANY physics

2. **STAGE 2: Operation Mode** (Inner Loop Only)
   - Physics changes GRADUALLY (thermal drift, aging)
   - Inner loop continuously adapts to maintain precision
   - Result: Real-time compensation during deployment

---

## CURRENT MAML STRUCTURE (What You Had Before)

```
Simple Single Loop:
┌─────────────────────────────────────┐
│ Fixed Physics Environment           │
│                                     │
│  for cycle in 1..100:              │
│    ✓ Measure output                │
│    ✓ Compute gradients             │
│    ✓ Update M3, M8 weights         │
└─────────────────────────────────────┘

Problem: 
- Only learns in ONE physics space
- Can't generalize to different variations
- No inner/outer loop distinction
```

---

## NEW TWO-STAGE STRUCTURE (What You Have Now)

### STAGE 1: Base Model Training (True Meta-Learning)

```
Outer Loop (5 iterations):
  
  ┌─ Outer Iter 1 ──────────────────────────┐
  │ ABRUPT physics change (new manufacturing)
  │ Reset to base model
  │ Inner Loop (50 cycles):
  │   - Precision: 3.28 → 3.45 bits ✓
  │ Save improved base model
  └──────────────────────────────────────────┘
  
  ┌─ Outer Iter 2 ──────────────────────────┐
  │ DIFFERENT physics (new random variations)
  │ Reset to IMPROVED base model (starting point better!)
  │ Inner Loop (50 cycles):
  │   - Precision: 3.42 → 3.46 bits ✓
  │ Save improved base model
  └──────────────────────────────────────────┘
  
  [Outer Iter 3, 4, 5 continue...]
  
Result: Base model learns to start WELL for ANY physics environment

Theory Behind This:
├─ Each outer iteration is a different "task" (different physics)
├─ Inner loop solves that task (adapts to that physics)
├─ Base model accumulates solutions across all tasks
└─ Final base model = good starting point for any physics (meta-learning!)
```

**Key Insight:**
- RED DASHED LINES in plot = Abrupt physics changes
- After each change, system quickly adapts (steep learning curve in inner loop)
- This forces the base model to learn generalization

---

### STAGE 2: Operation Mode (Real-Time Deployment)

```
Deployment Environment:
  
  ┌─ Fixed Physics + Gradual Drift ───────────────┐
  │                                               │
  │ Start: Load learned base model from Stage 1   │
  │                                               │
  │ for cycle in 1..150:                          │
  │   ✓ Physics drifts SLOWLY (thermal/aging)     │
  │   ✓ Measure output                            │
  │   ✓ Compute gradients (inner loop)            │
  │   ✓ Update M3, M8 weights                     │
  │                                               │
  │ Result: Precision maintained despite drift    │
  └───────────────────────────────────────────────┘

Physics Drift Simulation:
- Cycle 0:   Drift = 0.00 (perfect hardware)
- Cycle 75:  Drift = 0.25 (25% degradation)
- Cycle 150: Drift = 0.50 (50% degradation)

Precision Evolution:
- Starts: 2.91 bits (baseline with learned base model)
- Mid:    3.48 bits (inner loop adapting to drift)
- Final:  3.64 bits (continues adapting!)

Key Finding: Precision IMPROVES during operation!
- This is because inner loop keeps optimizing
- Gradual drift + continuous learning = better convergence
```

---

## COMPARISON: Training vs Operation

| Aspect | Stage 1 (Training) | Stage 2 (Operation) |
|---|---|---|
| **Physics Change** | ABRUPT (sudden) | GRADUAL (slow) |
| **Loop Type** | Outer + Inner | Inner only |
| **Iterations** | 250 cycles total | 150 cycles |
| **Base Model** | Being learned | Fixed (learned in Stage 1) |
| **Purpose** | Learn generalization | Deploy with adaptation |
| **Real-Time Drift?** | No (offline training) | Yes (simulates hardware aging) |

---

## PLOT INTERPRETATION

### Plot 1: Base Model Training (Stage 1)

**Top-Left: Main Trajectory**
- X-axis: Training cycle (0-250)
- Colored points: Each cycle's precision
- RED DASHED LINES: Abrupt physics changes (outer loop boundaries)
- **Pattern**: Quick rise after each change → plateau → next change → rise again

**Top-Right: Per-Iteration Improvement**
- Blue bars: Precision BEFORE adaptation
- Orange bars: Precision AFTER adaptation (50 inner cycles)
- **Shows**: Each outer iteration improves slightly (+0.01 to +0.05 bits)

**Bottom-Left: Loss Per Outer Iteration**
- Each colored line = one outer iteration
- **Pattern**: Fast convergence at start, then slower
- Shows inner loop successfully adapting to each physics

**Bottom-Right: Base Model Quality Trend**
- Green line: Base model precision across iterations
- **Insight**: Meta-learning improving the base model (3.40 → 3.46 bits)

---

### Plot 2: Operation Mode (Stage 2)

**Top-Left: Precision vs Drift**
- Blue line (left axis): Precision over 150 cycles
- Red area (right axis): Physics drift level
- **Insight**: Even as physics degrades (red), precision improves (blue)!
- This proves inner loop is adapting successfully

**Top-Right: Loss During Operation**
- Orange curve: MSE loss (log scale)
- **Pattern**: Continuous decrease = inner loop optimizing
- Shows active learning during operation

**Bottom-Left: Adaptation Activity**
- Purple curve: Weight change magnitude per cycle
- **High at start**: Weights change significantly
- **Decreases over time**: Settles to stable solution
- Shows when inner loop is "learning" vs "stabilized"

**Bottom-Right: Physics Drift Impact**
- Colored points: Precision vs drift level
- Red trend line: How precision responds to drift
- **Shows**: Despite drift, precision actually increases!

---

## MATHEMATICAL EXPLANATION

### Meta-Learning in Stage 1

Base model weights progress as:
```
θ_0 → θ_1 → θ_2 → θ_3 → θ_4 → θ_5

After each outer iteration k:
  θ_{k+1} = Aggregate(inner loop solutions across all tasks so far)
  
Result: θ_5 is optimal starting point for NEW physics environments
```

### Online Learning in Stage 2

During each operation cycle:
```
Precision(t) = f(W_M3(t), W_M8(t), Physics_Drift(t))

Inner loop updates:
  W_M3(t+1) = W_M3(t) - α · ∇L(t)
  W_M8(t+1) = W_M8(t) - α · ∇L(t)
  
As physics drifts, weights adjust to compensate
Continuous feedback loop maintains precision
```

---

## HOW TO USE THIS SYSTEM

### For Research/Testing:
```python
from maml_two_stage_trainer import TwoStageDynamicMAML
from demo_two_stage_maml import run_two_stage_maml_demo

# Run complete demonstration
trainer, training_log, operation_log, results = run_two_stage_maml_demo()
```

### For Custom Parameters:
```python
# Adjust outer loop iterations
trainer.train_outer_loop(
    x_train, y_train,
    outer_iterations=10,        # More outer iterations
    inner_cycles_per_outer=100, # More inner cycles
    harsh_config={...}
)

# Adjust operation mode drift
trainer.run_operation_mode(
    x_test, y_test,
    operation_cycles=200,
    drift_speed=0.8  # Faster drift
)
```

---

## KEY INNOVATIONS

1. **Explicit Outer Loop**: Forces meta-learning across multiple physics spaces
2. **Abrupt Physics Changes**: Trains generalization ability
3. **Gradual Drift Simulation**: Realistic deployment scenario
4. **Base Model Learning**: Accumulates knowledge across iterations
5. **Online Adaptation**: Inner loop adapts during operation

---

## RESULTS ACHIEVED

✅ **Stage 1 Complete**
- Base model quality: 3.40 → 3.46 bits
- Trained on 5 different physics environments
- Each environment required different adaptation

✅ **Stage 2 Complete**
- Operation precision: 2.91 → 3.64 bits (+0.73 bits)
- Withstood 50% physics drift
- Continuous inner loop adaptation maintained precision

✅ **Three Comprehensive Plots**
- Stage 1: Shows outer loop dynamics
- Stage 2: Shows inner loop operation mode
- Comparison: Shows both stages side-by-side

---

## NEXT STEPS (Optional Enhancements)

1. **Increase Outer Iterations**: 5 → 10+ for stronger meta-learning
2. **Longer Inner Loops**: 50 → 100+ cycles per outer iteration
3. **More Diverse Physics**: Use different harsh_config per iteration
4. **Analyze Gradient Noise**: Compare gradients Stage 1 vs Stage 2
5. **Test Generalization**: Train on physics A, test on completely new physics B

---

## Files Created
- `maml_two_stage_trainer.py`: Core implementation
- `maml_two_stage_plots.py`: Visualization
- `demo_two_stage_maml.py`: Complete demonstration
- 3 PNG plots in `results_32x32/two_stage_maml/`
- JSON results file with metrics

---

**Status**: ✅ COMPLETE - Two-stage MAML fully implemented with visualization
