ollewelin/analog_matrix_computation_Inverted_MAML_PAT_PEND_2630397-4/FPGA_code/docs/INVERTED_MAML_CARD2_THERMAL_STRESS_COMPREHENSIVE_REPORT.pdf

# Inverted MAML Silicon: Physical Thermal Stress & Real-Time Closed-Loop Drift Rejection

Hardware Evaluation on Card 2 Silicon (PCBA v1.3.2 | Trion T120 Master SoC + T20 Coprocessor)
Continuous 20-Minute 2x2 Factorial Characterization under 100% Duty Cycle Substrate Heating | Focused Temporal Window [5.0 – 5.4 ms]
(5 Strata @ 100 µs) | K=2, LR=0.02, L2 Reg λ=768 | W(3) Staircase Pattern
Target Silicon: Card 2 (PCBA v1.3.2, T120F324 + T20) | Temporal Window: [5.0 .. 5.4 ms] (5 strata, step 100 µs) | Attenuator Network: 1k/3.3k Passive Attenuator
Disturbance Type: 100% Real Physical Thermal (4 Heaters @ 100%) | Input Stimulus: White Noise (COLOR_WHITE, ±40 LSB) | Active Loop: Mode A (FHP SGD Online, K=2, LR=0.02, λ=768)
Duration & Scale: 3,436 Epochs (~20.0 minutes) | Thermal Cycling: 8 min ON (100%) / 8 min OFF (0%) | Regulation Cycling: 2 min ON (SGD) / 2 min OFF (W8=0)

## Executive Summary & Core Scientific Breakthrough
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
