ollewelin/analog_matrix_computation_Inverted_MAML_PAT_PEND_2630397-4/FPGA_code/docs/INVERTED_MAML_CARD1_1000EP_BROADENED_WINDOW_1K_2P2K_COMPREHENSIVE_REPORT.pdf

# TEST CARD 1 ATTENUATOR 1k/2.2k: BROADENED WINDOW [4.5..5.5 ms] SILICON BENCHMARK

Comprehensive Hardware Characterization: Three-Way Attenuator Benchmark (1k/5.1k vs. 1k/3.3k vs. 1k/2.2k)
Patent Pending SE 2630397-4 | Open Science Hardware | Date: 2026-11-05 | 11,000 Physical Updates on Silicon

## 1. Executive Summary & Circuit Breakthrough
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
