ollewelin/analog_matrix_computation_Inverted_MAML_PAT_PEND_2630397-4/Blue_Weight_line_Yellow_100nF_mem_cell.jpeg

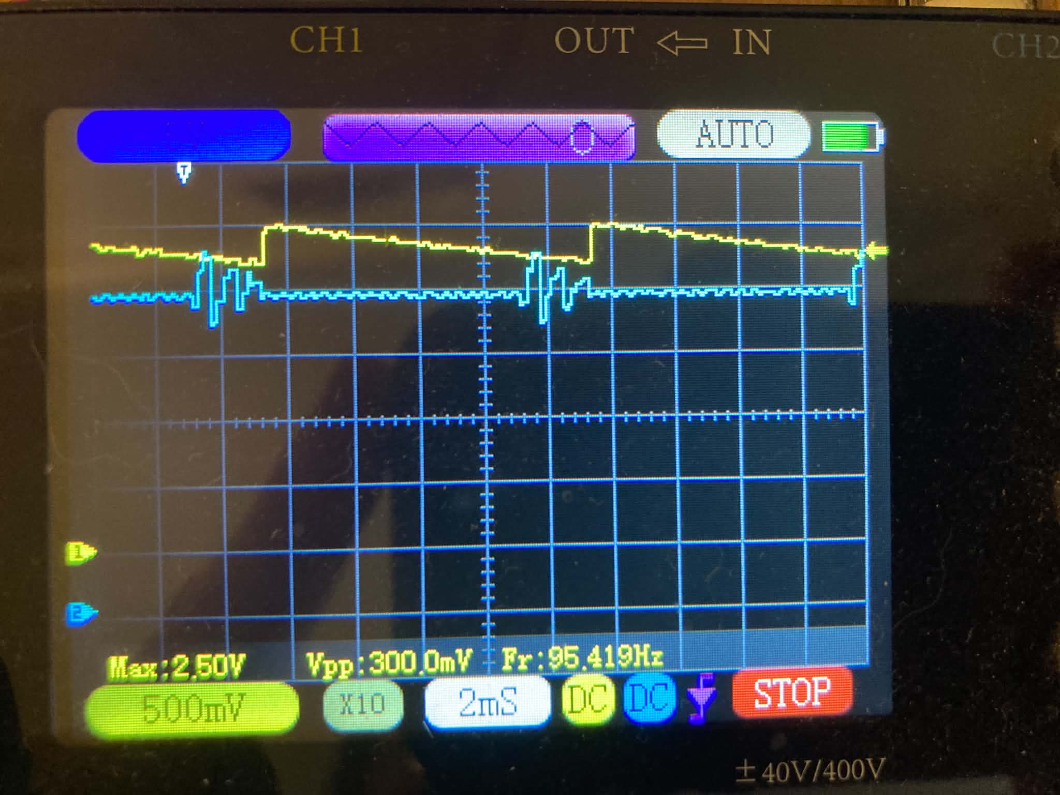
Blue_Weight_line_Yellow_100nF_mem_cell.jpeg
