ollewelin/analog_matrix_computation_Inverted_MAML_PAT_PEND_2630397-4/EasyEDA/Autoplace_matrix/IMAGE/48c9183e818345b7a21e7780624ea25a.webp

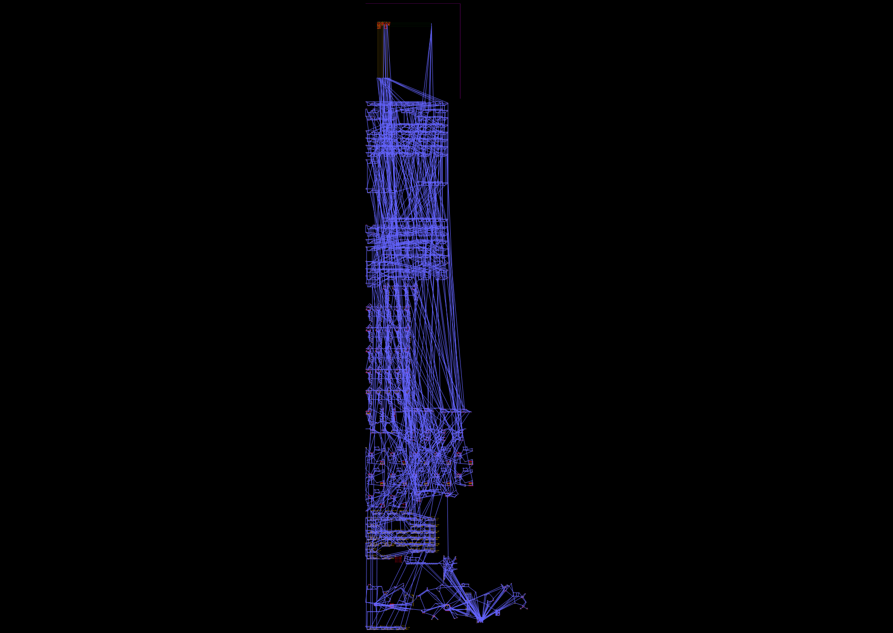
EasyEDA/Autoplace_matrix/IMAGE/48c9183e818345b7a21e7780624ea25a.webp
