ollewelin/analog_matrix_computation_Inverted_MAML_PAT_PEND_2630397-4/FPGA_code/docs/fig_card1_bs_comp_hot_convergence.png

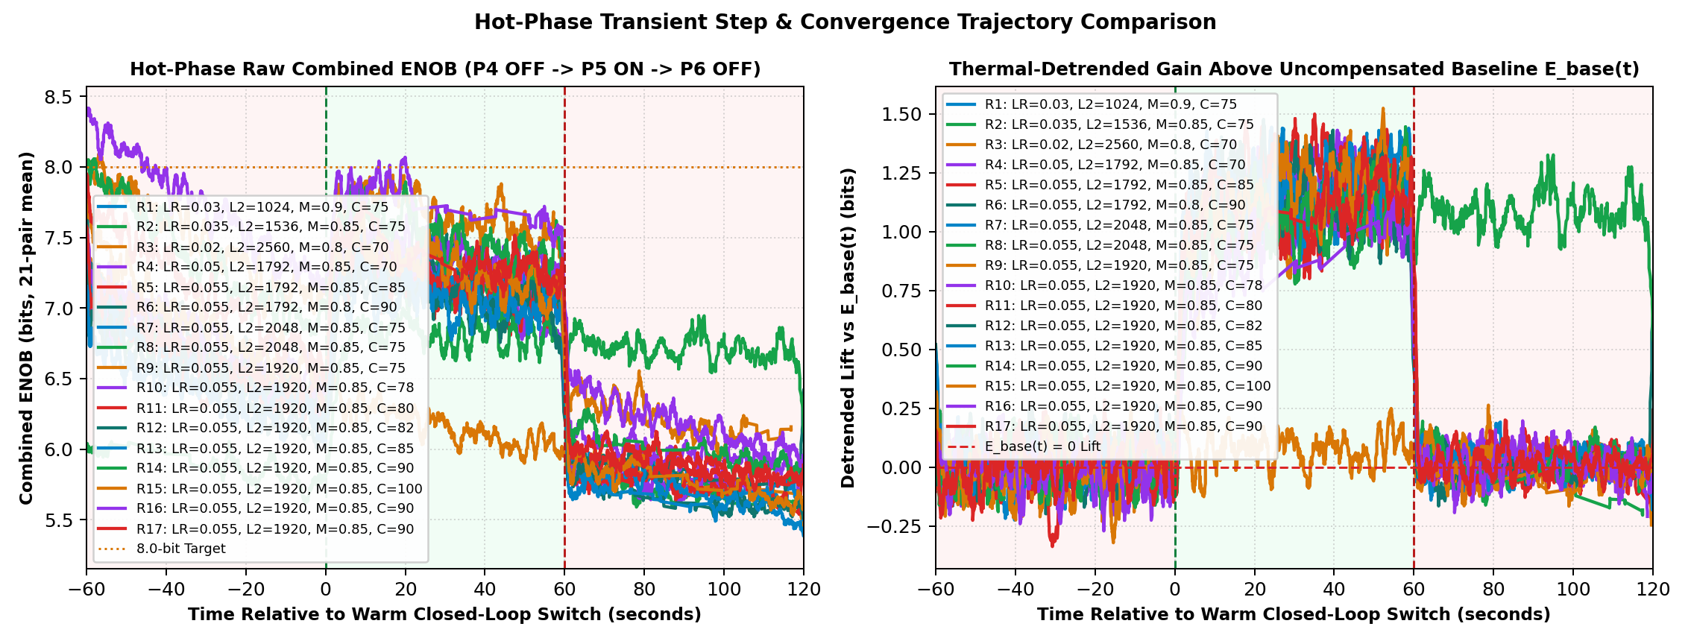
FPGA_code/docs/fig_card1_bs_comp_hot_convergence.png
