ollewelin/analog_matrix_computation_Inverted_MAML_PAT_PEND_2630397-4/FPGA_code/docs/fig_card1_r5_lr0p03_l2_1024_mom0p85_cl75_thermal_slicing.png

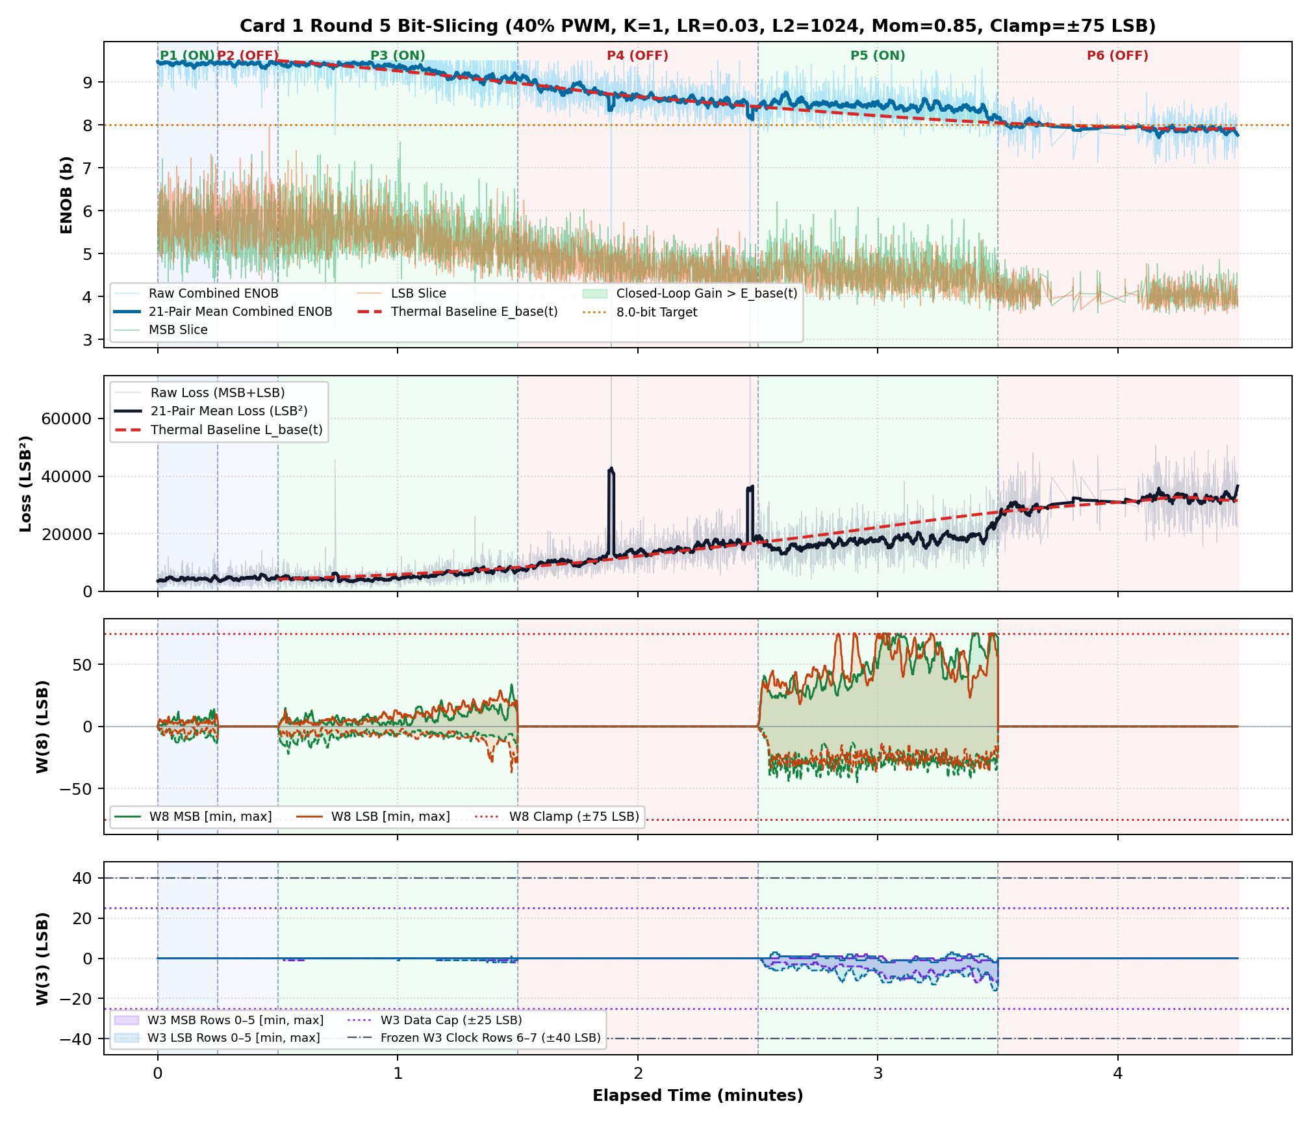
FPGA_code/docs/fig_card1_r5_lr0p03_l2_1024_mom0p85_cl75_thermal_slicing.png
