ollewelin/analog_matrix_computation_Inverted_MAML_PAT_PEND_2630397-4/FPGA_code/docs/figures/fig_2d_card2_w3_staircase_disturbances_numeric_mode_b.png

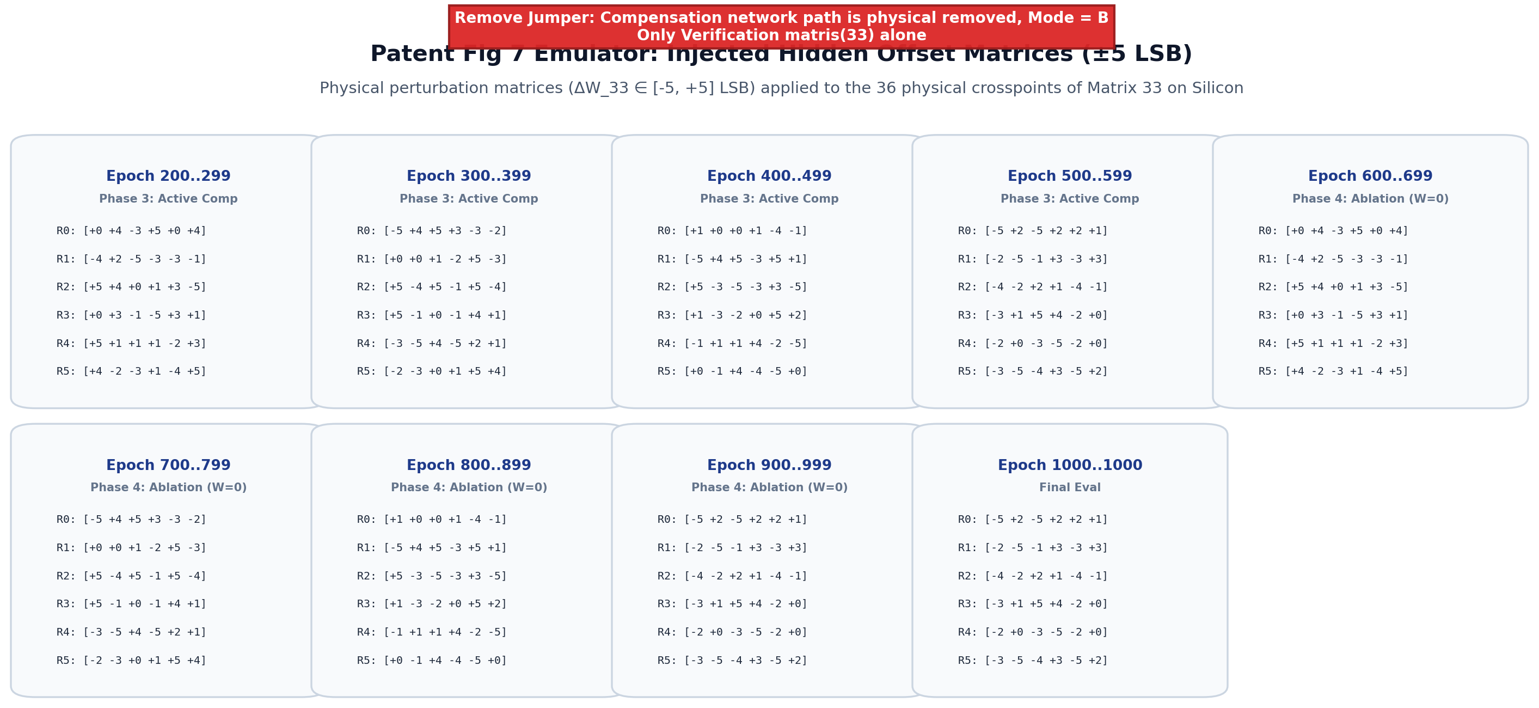
FPGA_code/docs/figures/fig_2d_card2_w3_staircase_disturbances_numeric_mode_b.png
