ollewelin/analog_matrix_computation_Inverted_MAML_PAT_PEND_2630397-4/FPGA_code/docs/figures/fig_2d_m3_weights_trajectory_reg1024_lr0p08_swing80.png

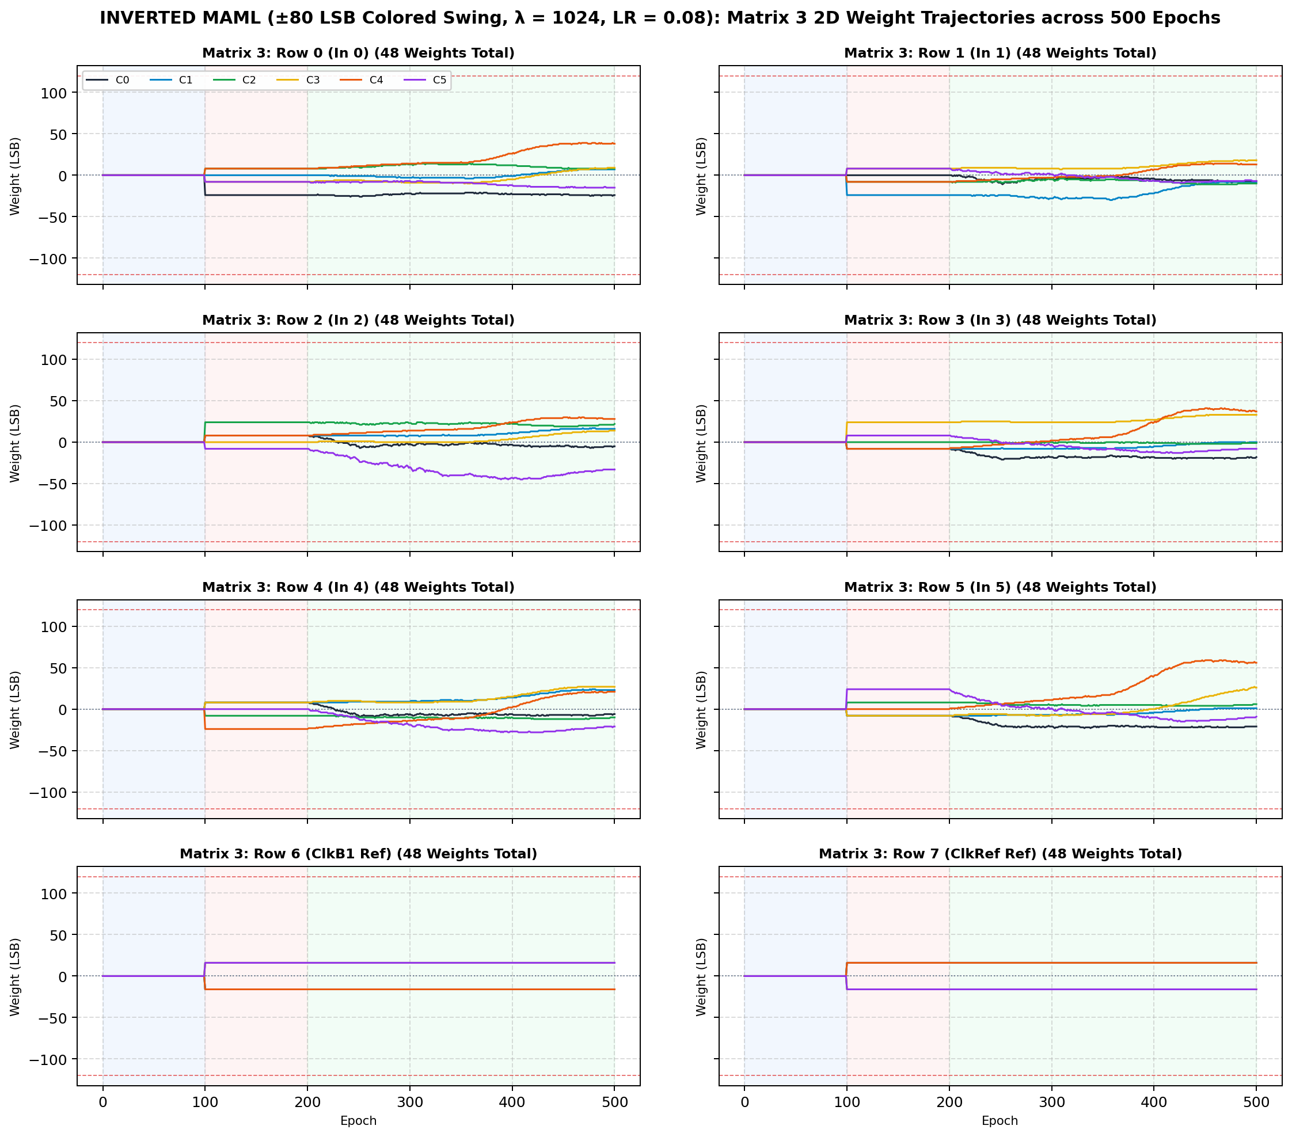
FPGA_code/docs/figures/fig_2d_m3_weights_trajectory_reg1024_lr0p08_swing80.png
