ollewelin/analog_matrix_computation_Inverted_MAML_PAT_PEND_2630397-4/FPGA_code/docs/figures/fig_2d_m8_weights_trajectory_card2_flat.png

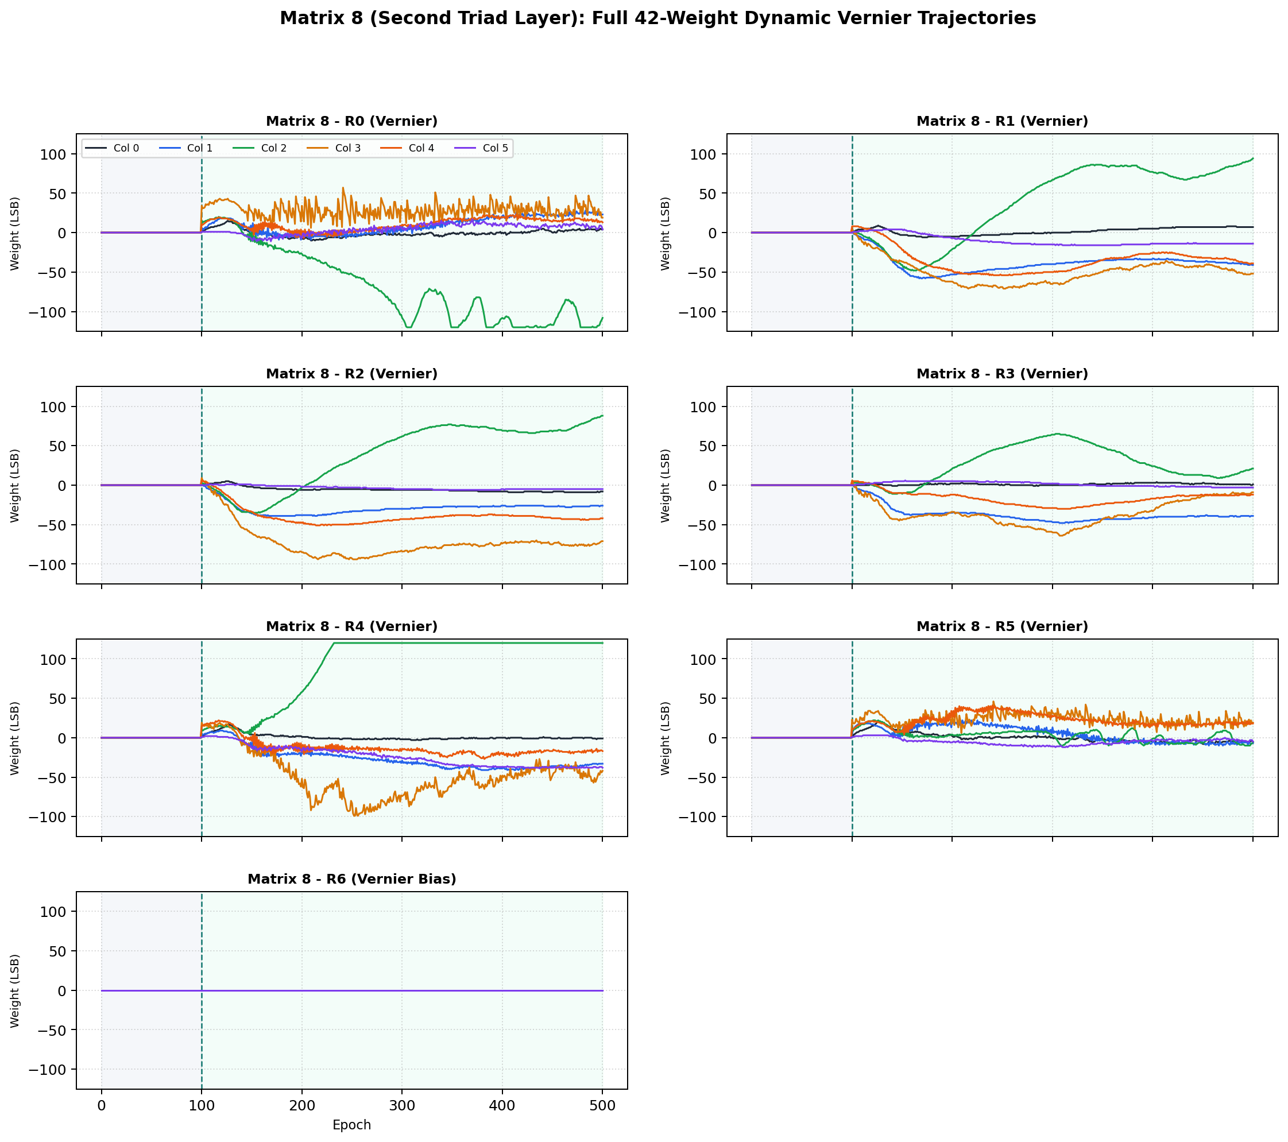
FPGA_code/docs/figures/fig_2d_m8_weights_trajectory_card2_flat.png
