ollewelin/analog_matrix_computation_Inverted_MAML_PAT_PEND_2630397-4/FPGA_code/docs/figures/fig_3d_card2_w3_staircase_part2_dist1_dist2_4900to5900us_reg1024.png

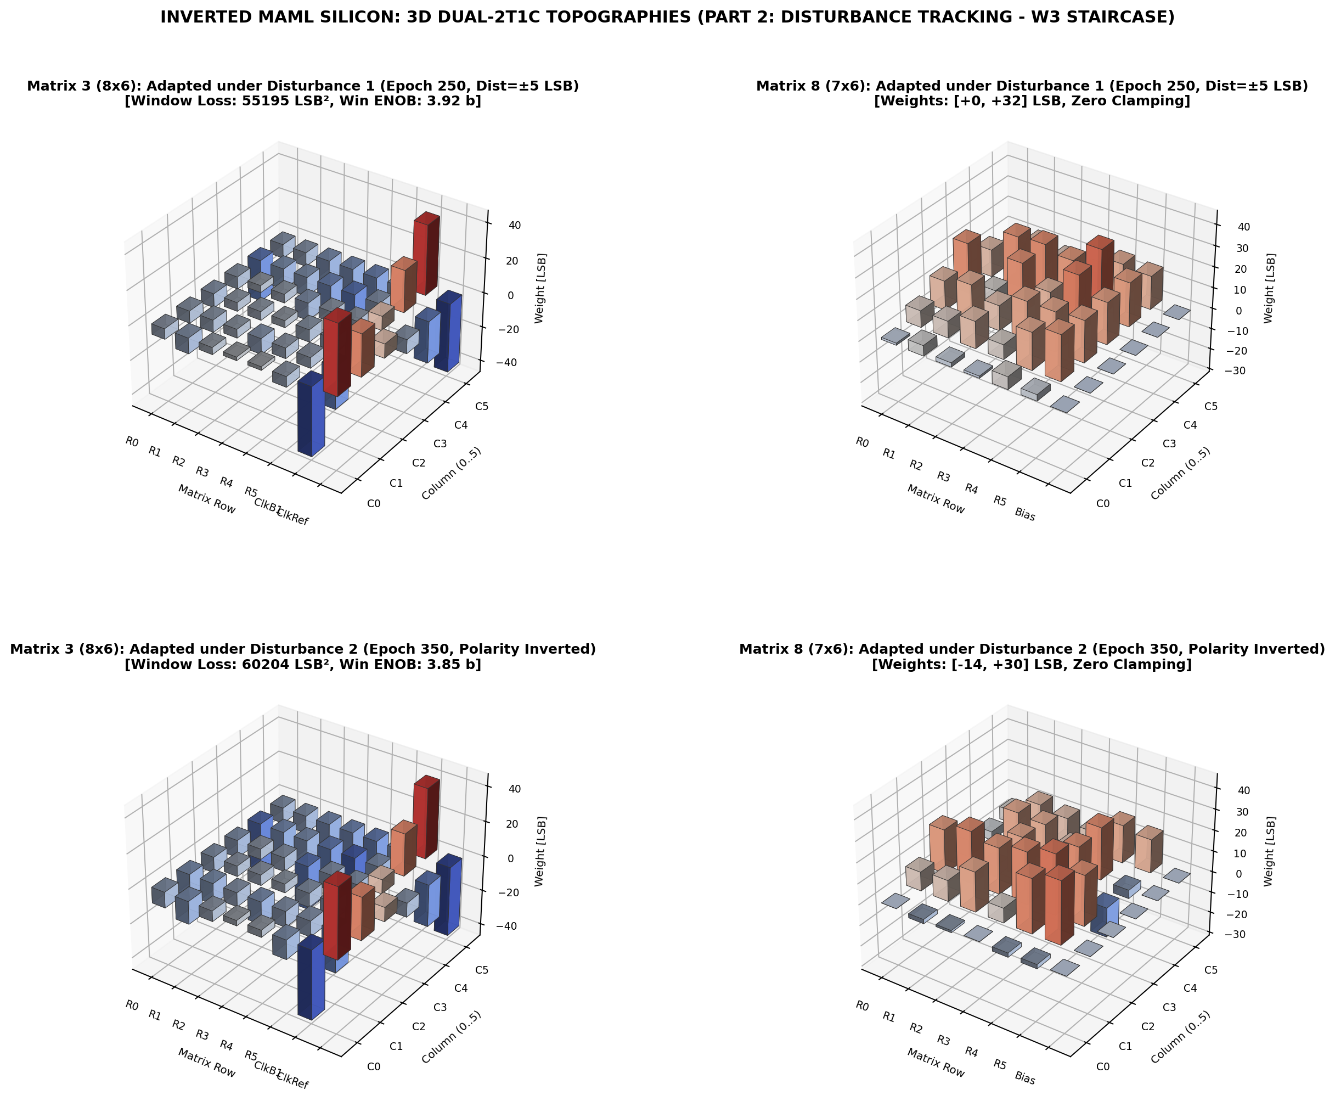
FPGA_code/docs/figures/fig_3d_card2_w3_staircase_part2_dist1_dist2_4900to5900us_reg1024.png
