ollewelin/analog_matrix_computation_Inverted_MAML_PAT_PEND_2630397-4/FPGA_code/docs/figures/fig_broadened_temporal_heatmap_spectrogram.png

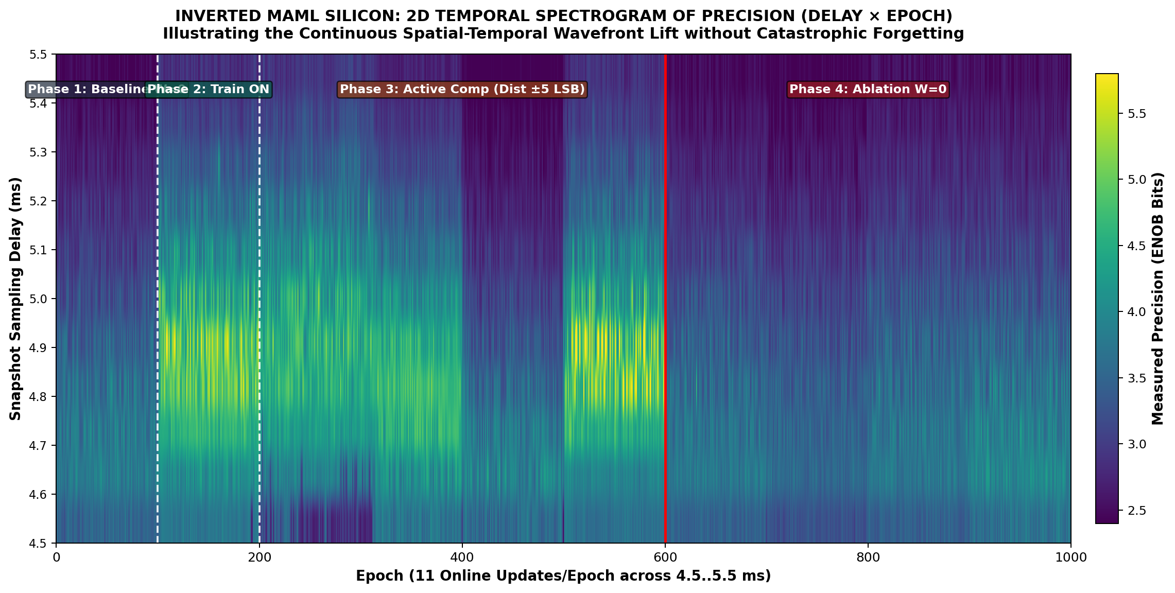
FPGA_code/docs/figures/fig_broadened_temporal_heatmap_spectrogram.png
