ollewelin/analog_matrix_computation_Inverted_MAML_PAT_PEND_2630397-4/FPGA_code/docs/figures/fig_card1_mode_a_1k_2p2k_spectrogram.png

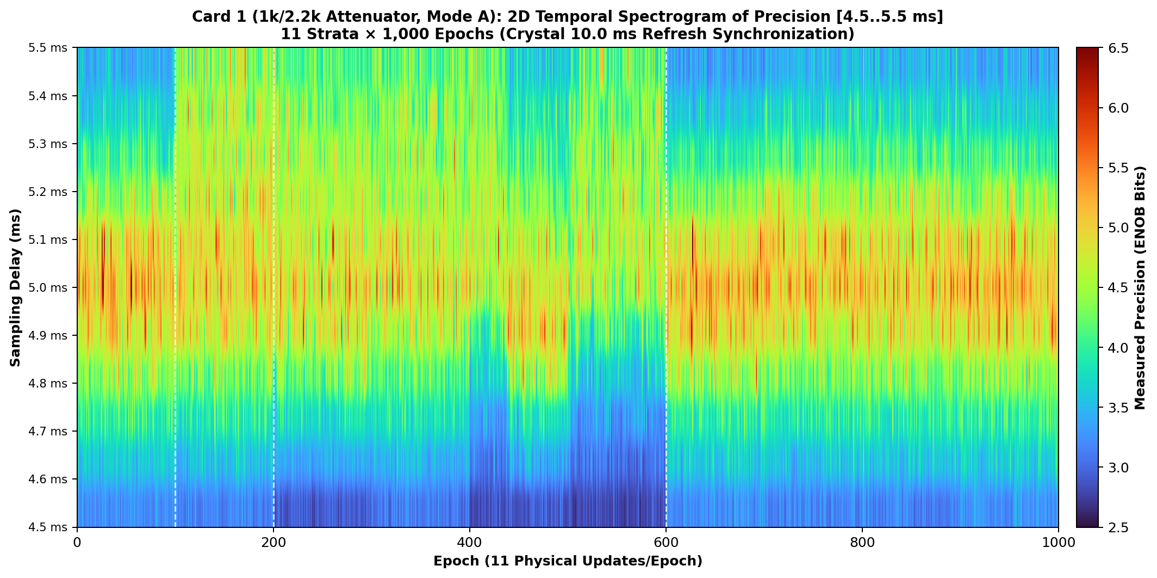
FPGA_code/docs/figures/fig_card1_mode_a_1k_2p2k_spectrogram.png
