ollewelin/analog_matrix_computation_Inverted_MAML_PAT_PEND_2630397-4/FPGA_code/docs/figures/fig_card1_vs_card2_comparative_overlay.png

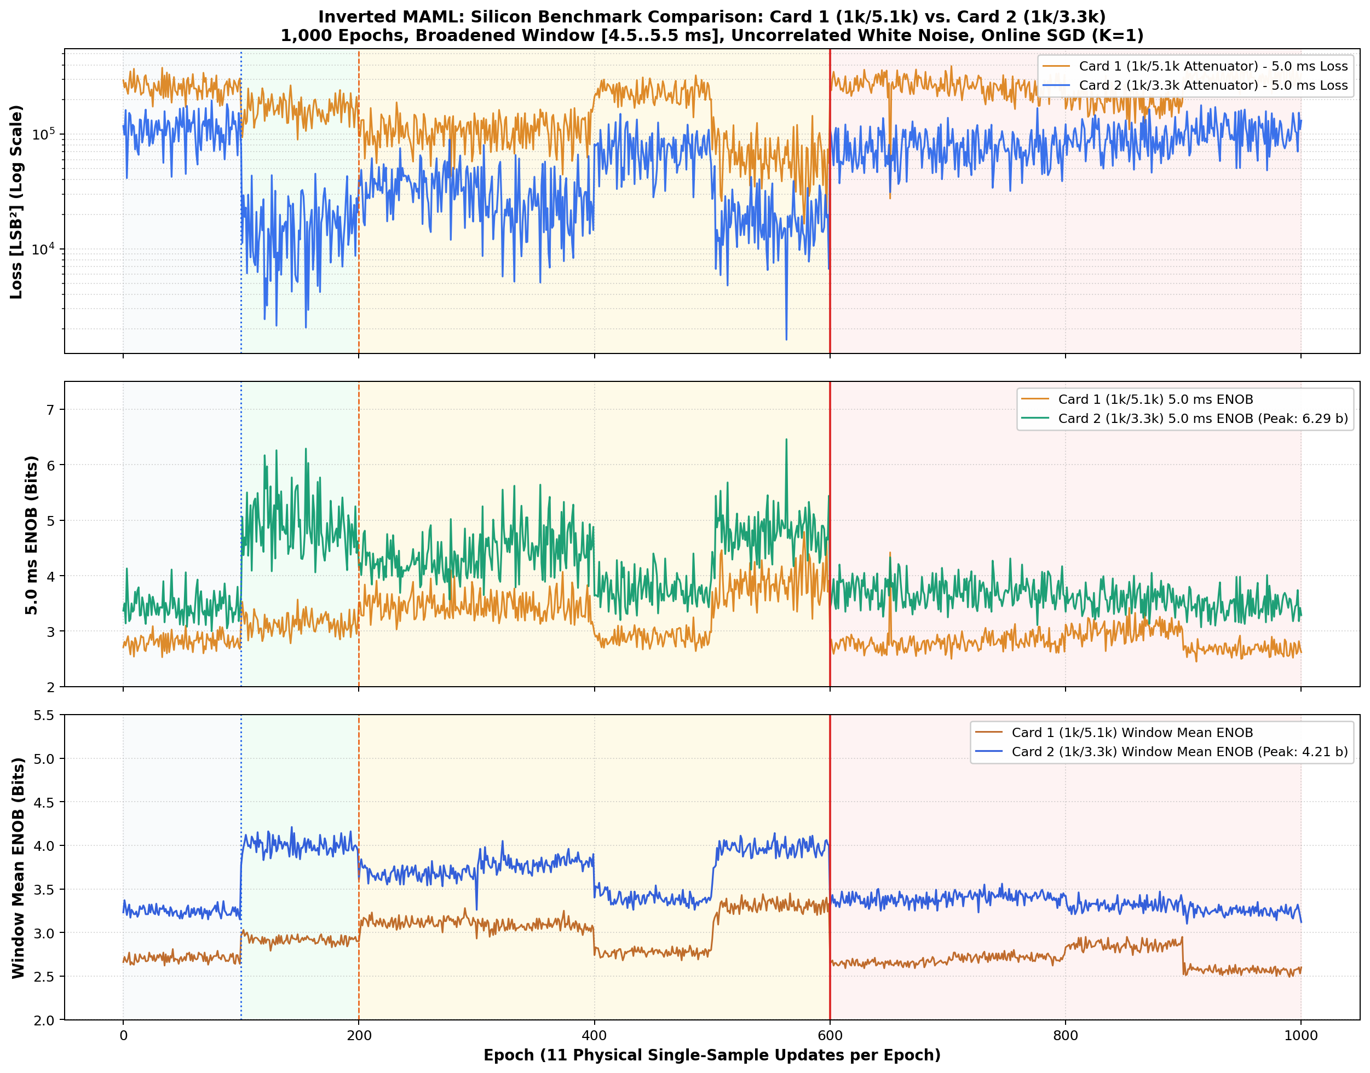
FPGA_code/docs/figures/fig_card1_vs_card2_comparative_overlay.png
