ollewelin/analog_matrix_computation_Inverted_MAML_PAT_PEND_2630397-4/FPGA_code/docs/figures/fig_card2_w3_staircase_joint_loss_and_enob_all_stratas.png

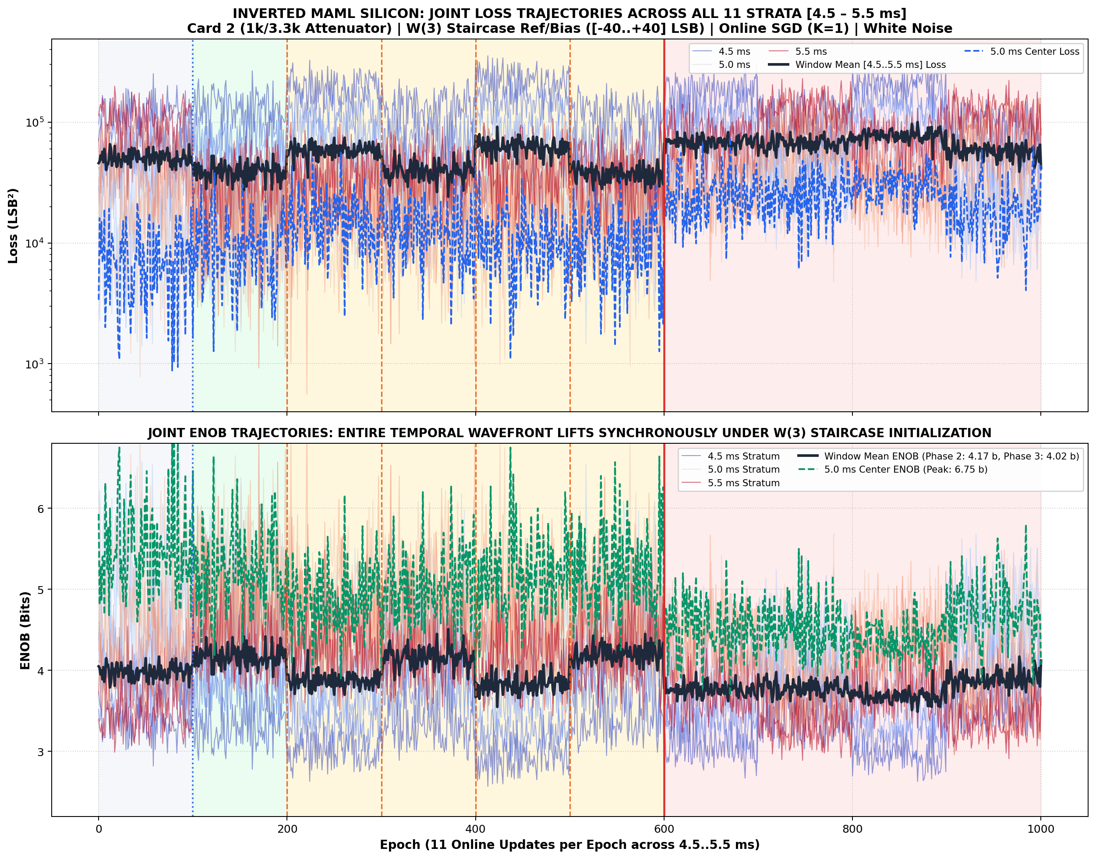
FPGA_code/docs/figures/fig_card2_w3_staircase_joint_loss_and_enob_all_stratas.png
