ollewelin/analog_matrix_computation_Inverted_MAML_PAT_PEND_2630397-4/FPGA_code/docs/figures/fig_card2_w3_staircase_temporal_heatmap_spectrogram_4900to5900us_reg1024.png

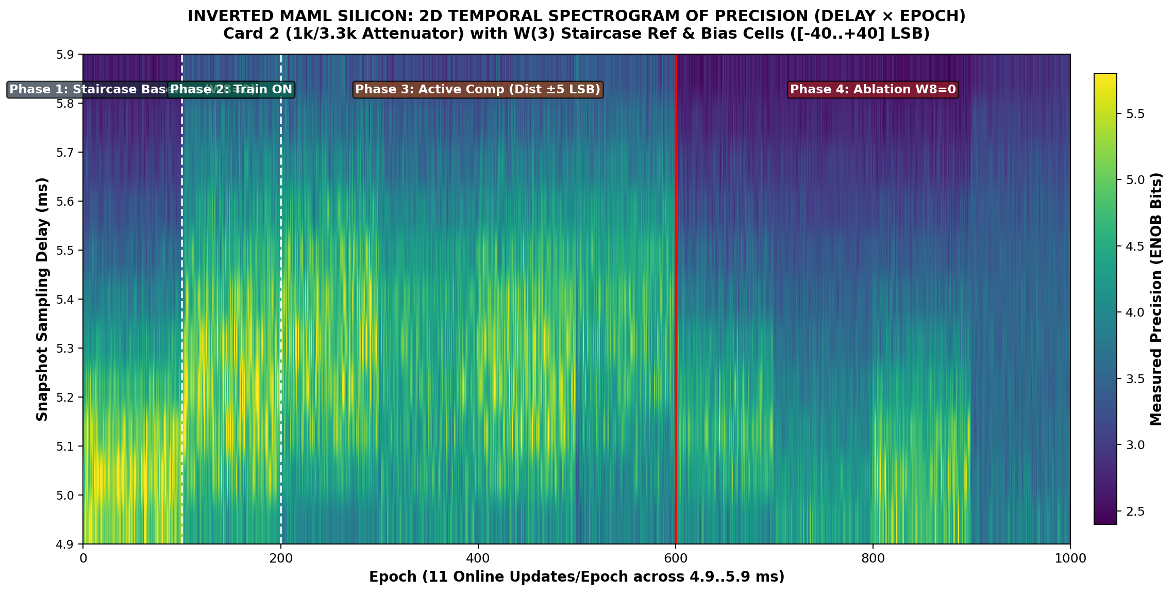
FPGA_code/docs/figures/fig_card2_w3_staircase_temporal_heatmap_spectrogram_4900to5900us_reg1024.png
