ollewelin/analog_matrix_computation_Inverted_MAML_PAT_PEND_2630397-4/FPGA_code/docs/figures/fig_m3_m8_10runs_1000ep_stats.png

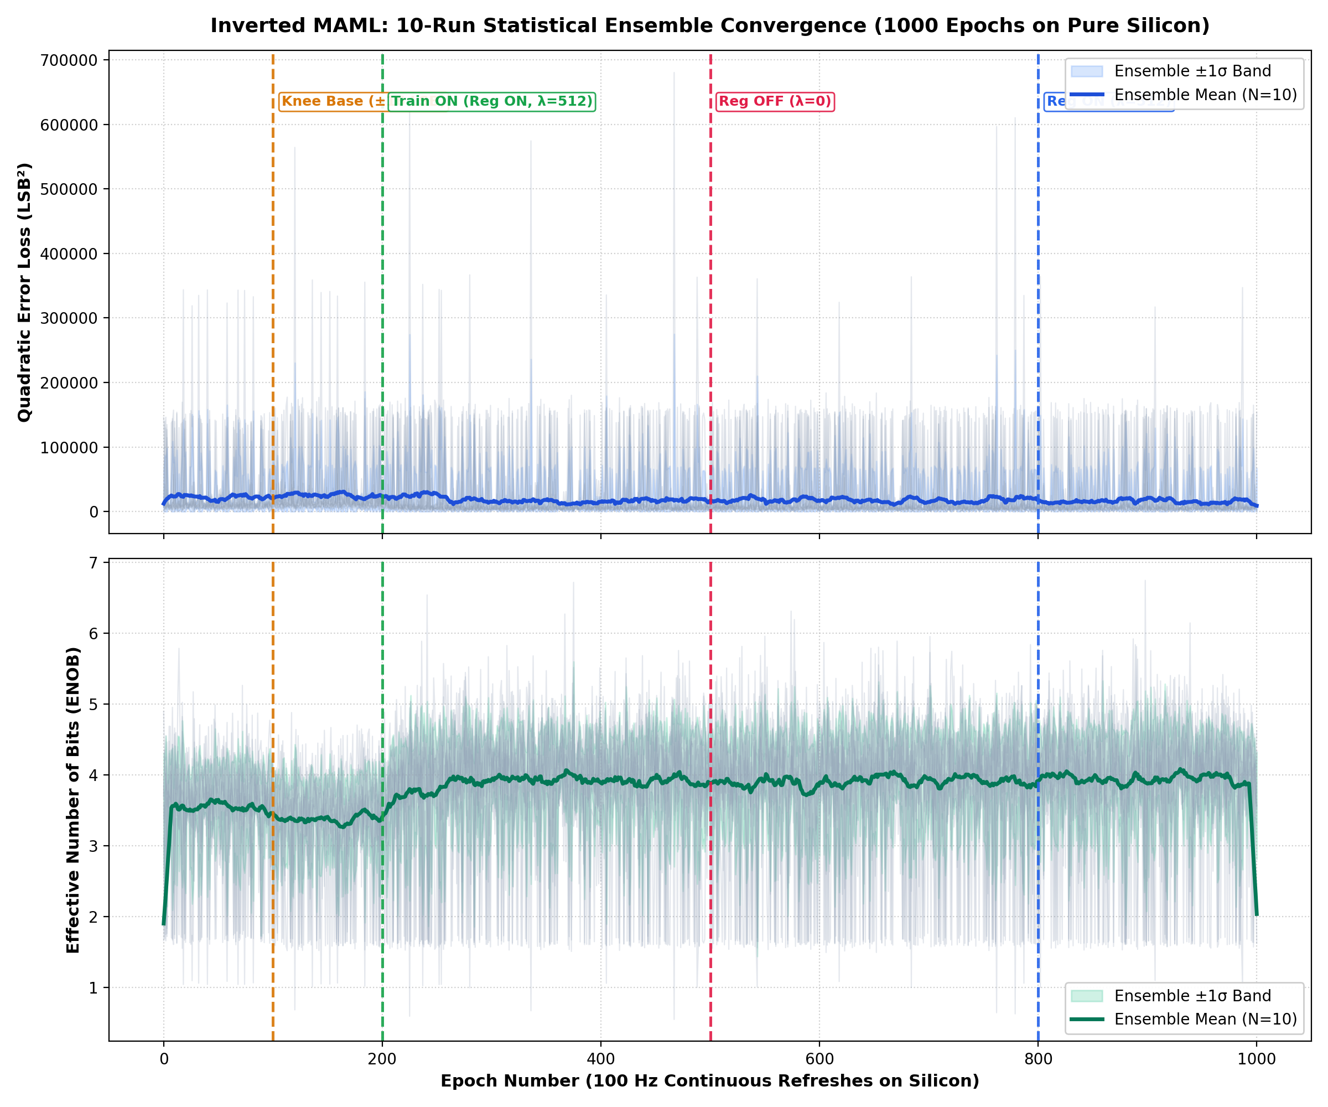
FPGA_code/docs/figures/fig_m3_m8_10runs_1000ep_stats.png
