ollewelin/analog_matrix_computation_Inverted_MAML_PAT_PEND_2630397-4/FPGA_code/docs/figures/fig_m3_m8_optimal_baseline_400ep_stats.png

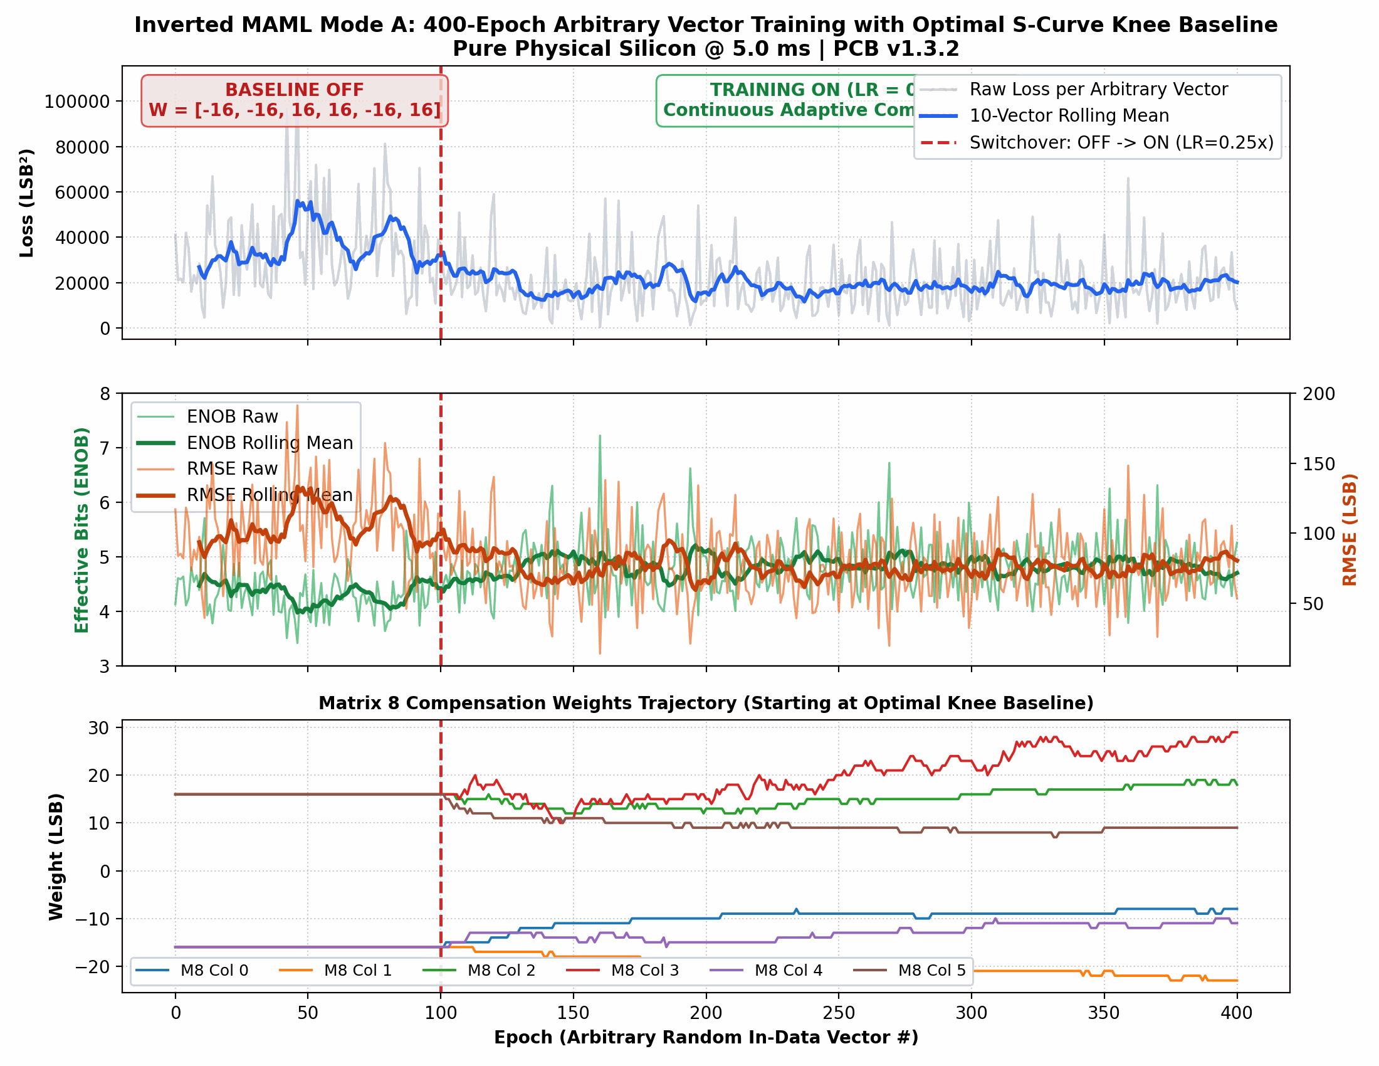
FPGA_code/docs/figures/fig_m3_m8_optimal_baseline_400ep_stats.png
