ollewelin/analog_matrix_computation_Inverted_MAML_PAT_PEND_2630397-4/FPGA_code/docs/figures/fig_mode_a_3d_weight_landscapes_baseline_vs_golden_rev2_1k3p9k.png

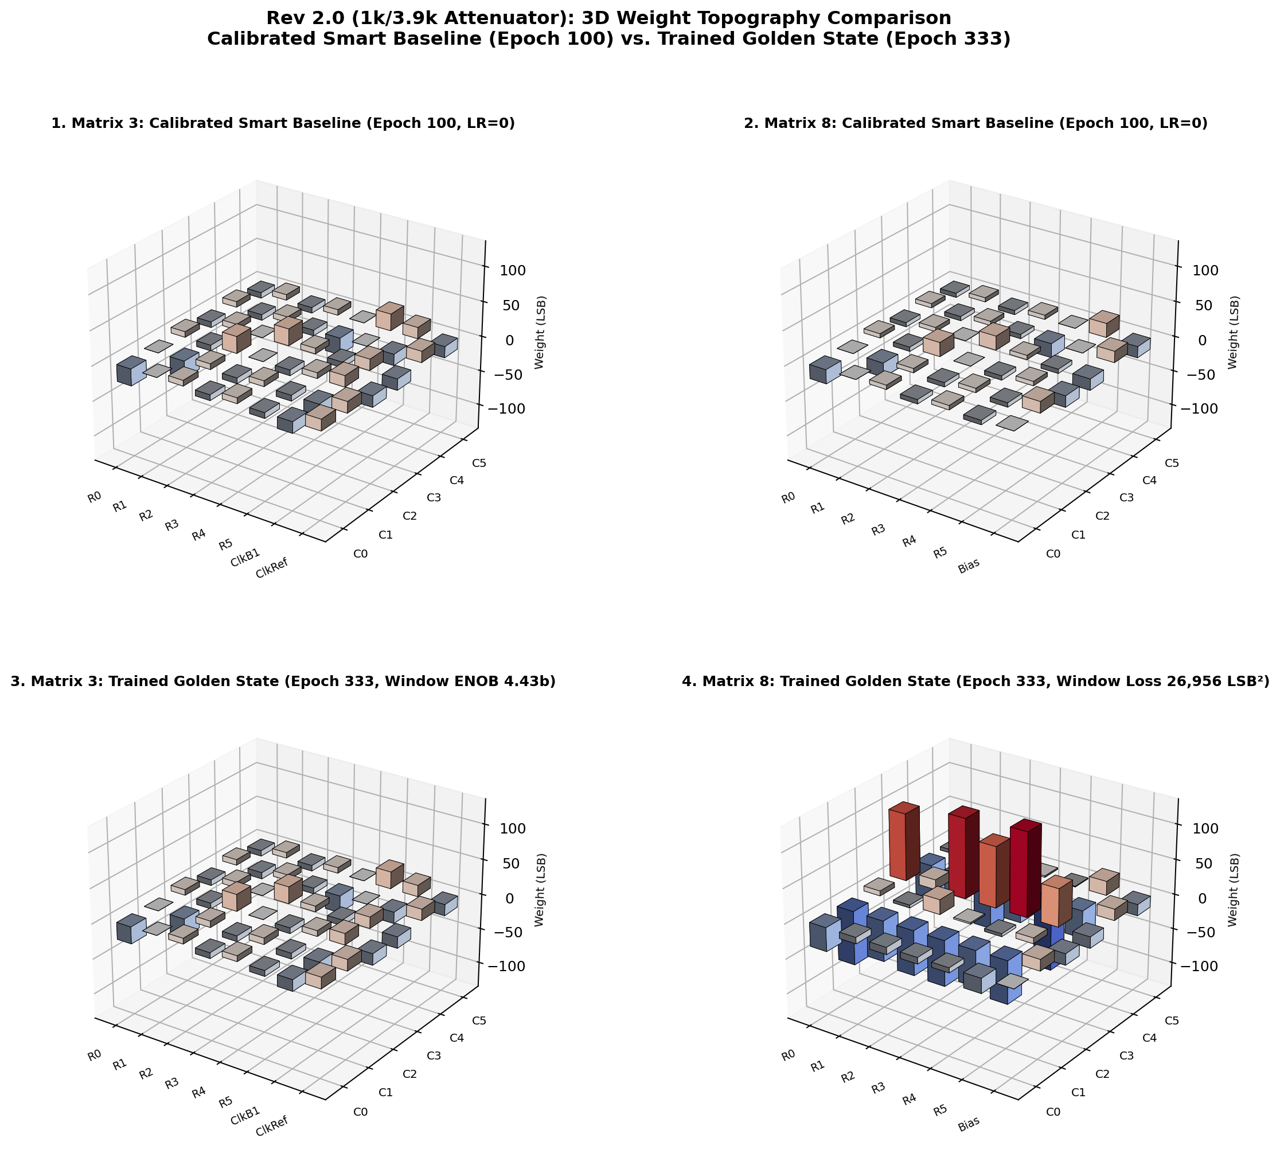
FPGA_code/docs/figures/fig_mode_a_3d_weight_landscapes_baseline_vs_golden_rev2_1k3p9k.png
