ollewelin/analog_matrix_computation_Inverted_MAML_PAT_PEND_2630397-4/FPGA_code/docs/figures/fig_mode_a_500ep_5ms_pure_toeplitz_lr0p08_reg1024_swing80.png

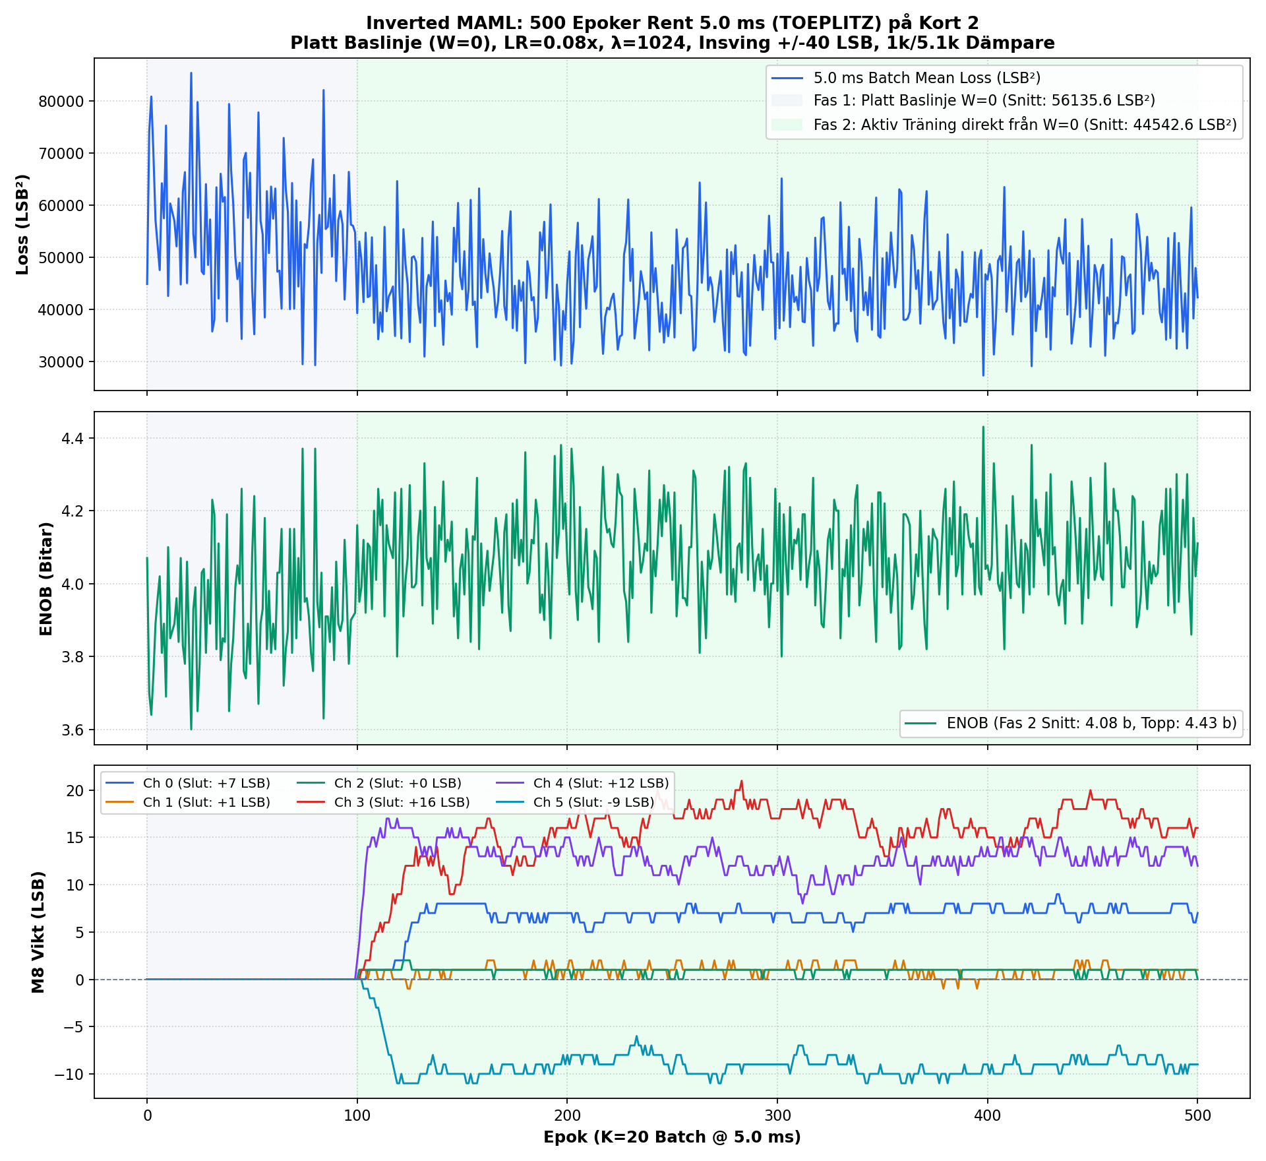
FPGA_code/docs/figures/fig_mode_a_500ep_5ms_pure_toeplitz_lr0p08_reg1024_swing80.png
