ollewelin/analog_matrix_computation_Inverted_MAML_PAT_PEND_2630397-4/FPGA_code/docs/figures/fig_mode_a_500ep_5ms_pure_toeplitz_reg341_swing40_var5.png

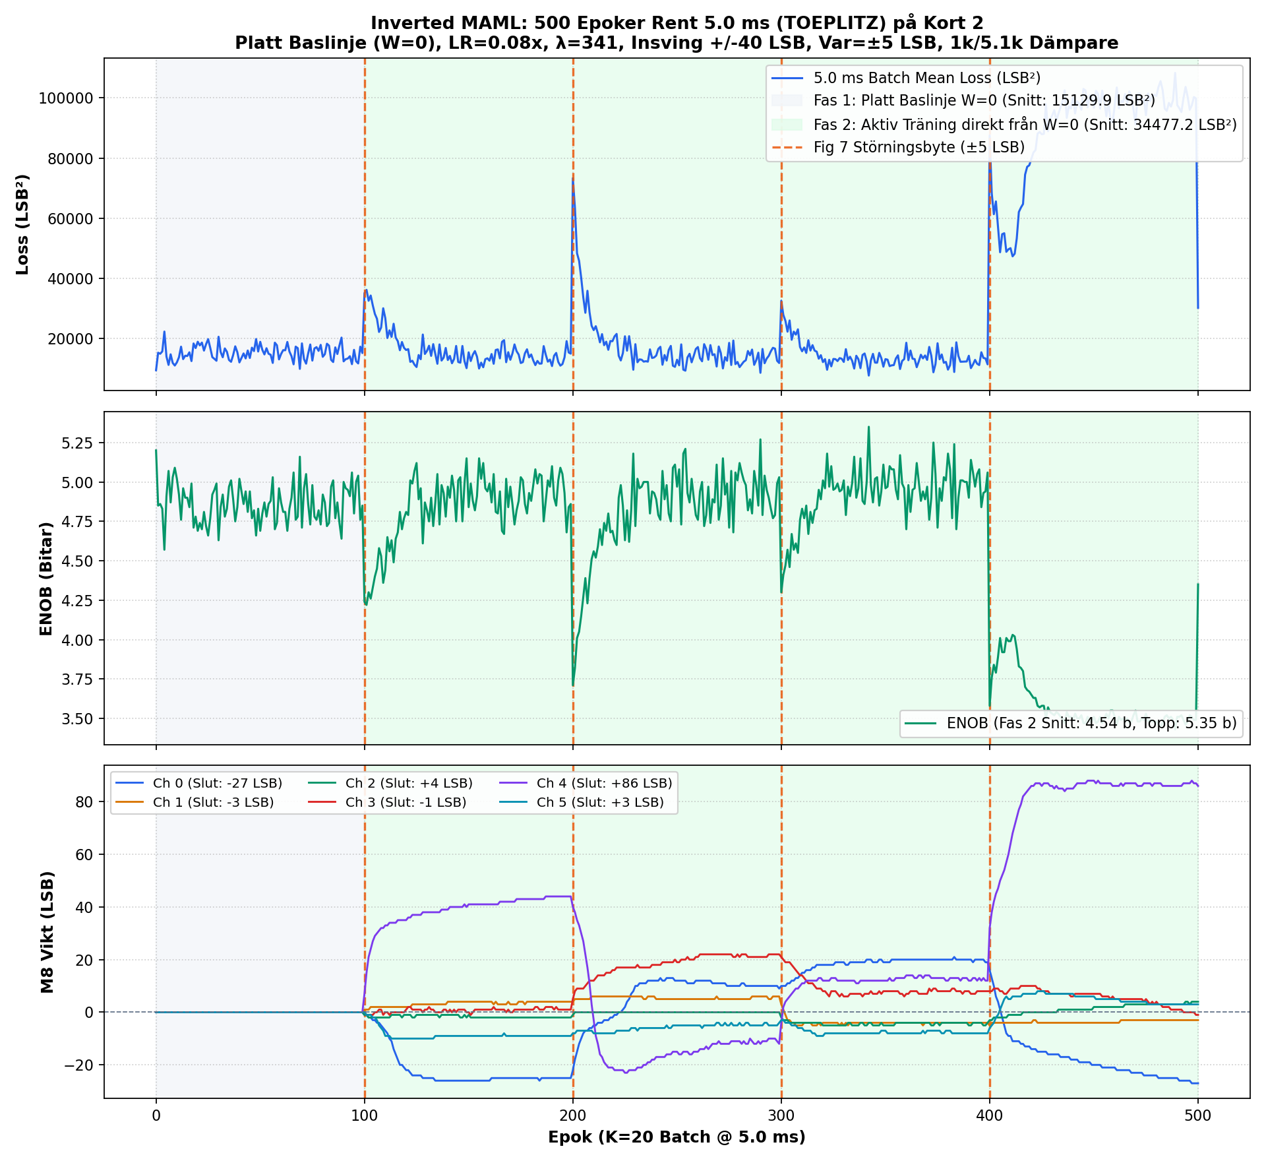
FPGA_code/docs/figures/fig_mode_a_500ep_5ms_pure_toeplitz_reg341_swing40_var5.png
