ollewelin/analog_matrix_computation_Inverted_MAML_PAT_PEND_2630397-4/FPGA_code/docs/figures/fig_mode_a_500ep_5p0ms_only_card2_flat_lr0p08_swing40.png

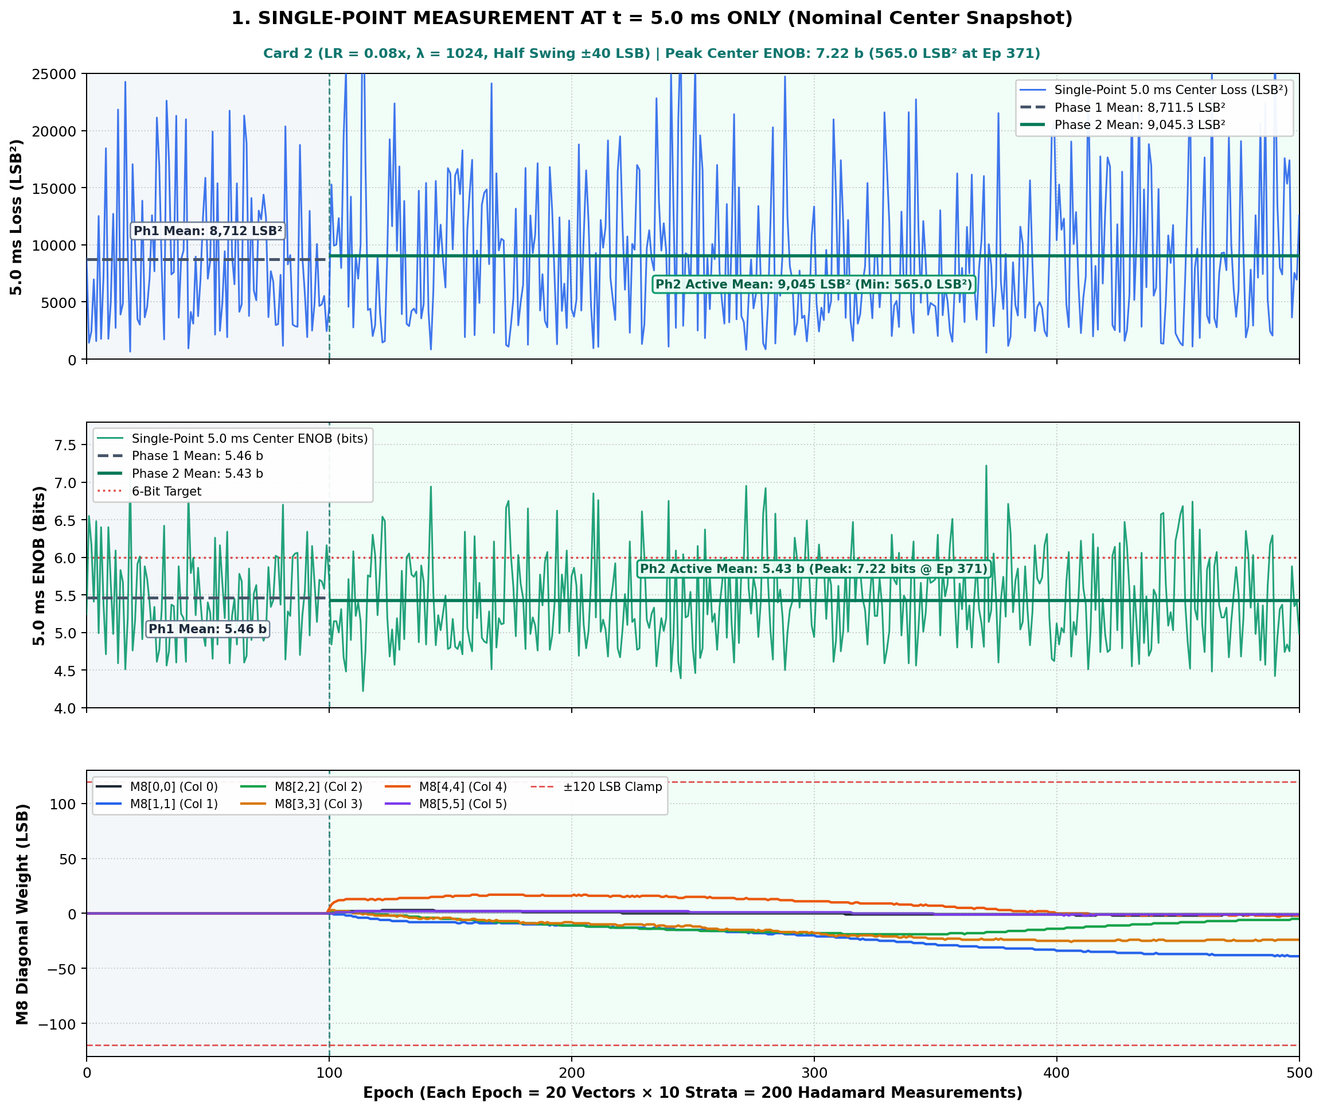
FPGA_code/docs/figures/fig_mode_a_500ep_5p0ms_only_card2_flat_lr0p08_swing40.png
