ollewelin/analog_matrix_computation_Inverted_MAML_PAT_PEND_2630397-4/FPGA_code/docs/figures/fig_mode_a_500ep_card2_5p1k_run08.png

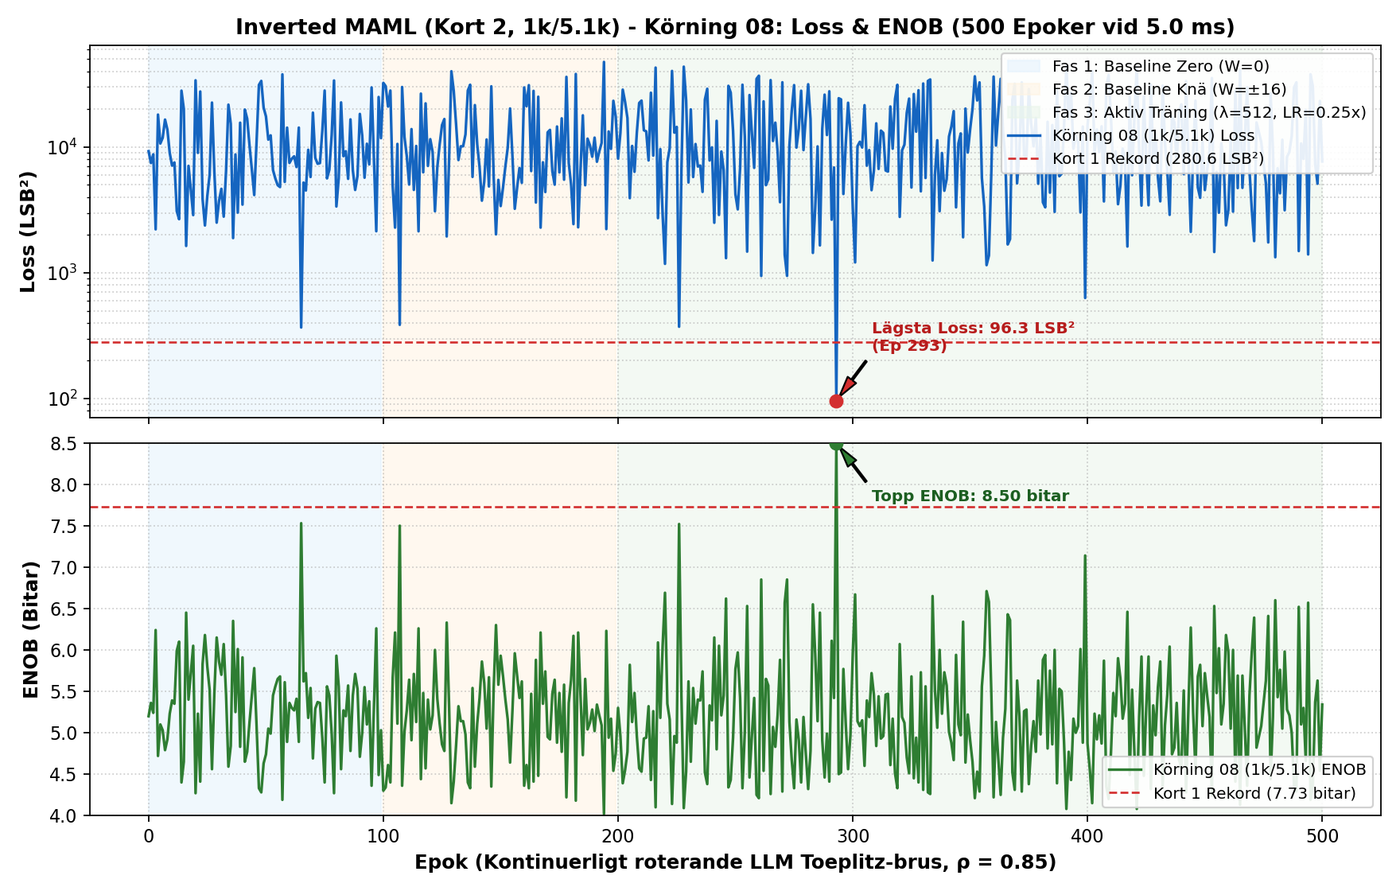
FPGA_code/docs/figures/fig_mode_a_500ep_card2_5p1k_run08.png
