ollewelin/analog_matrix_computation_Inverted_MAML_PAT_PEND_2630397-4/FPGA_code/docs/figures/fig_mode_a_500ep_llm_training_trajectory.jpg

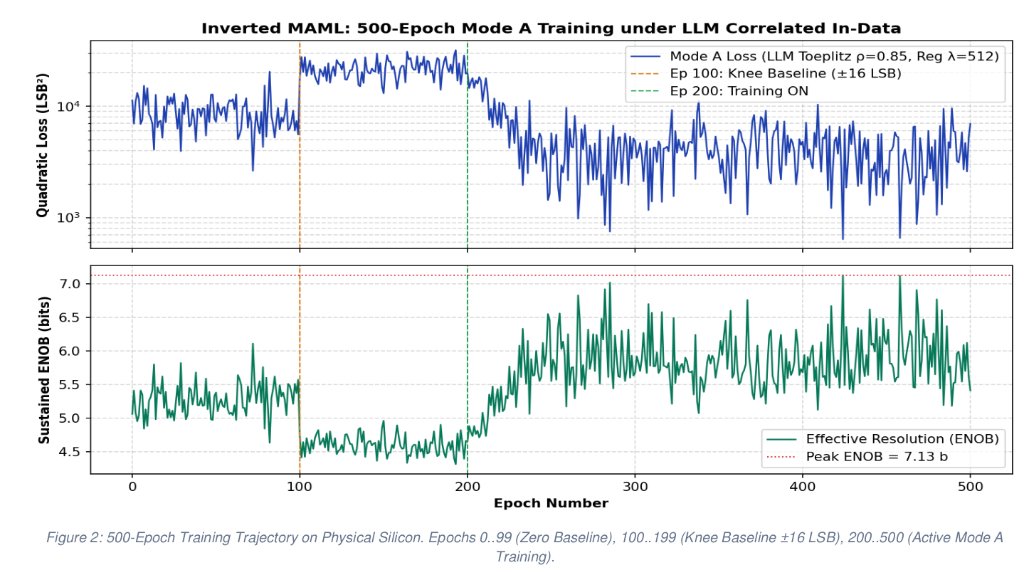
FPGA_code/docs/figures/fig_mode_a_500ep_llm_training_trajectory.jpg
