ollewelin/analog_matrix_computation_Inverted_MAML_PAT_PEND_2630397-4/FPGA_code/docs/figures/fig_mode_a_500ep_window_4p5to5p5ms_only_card2_flat_lr0p08.png

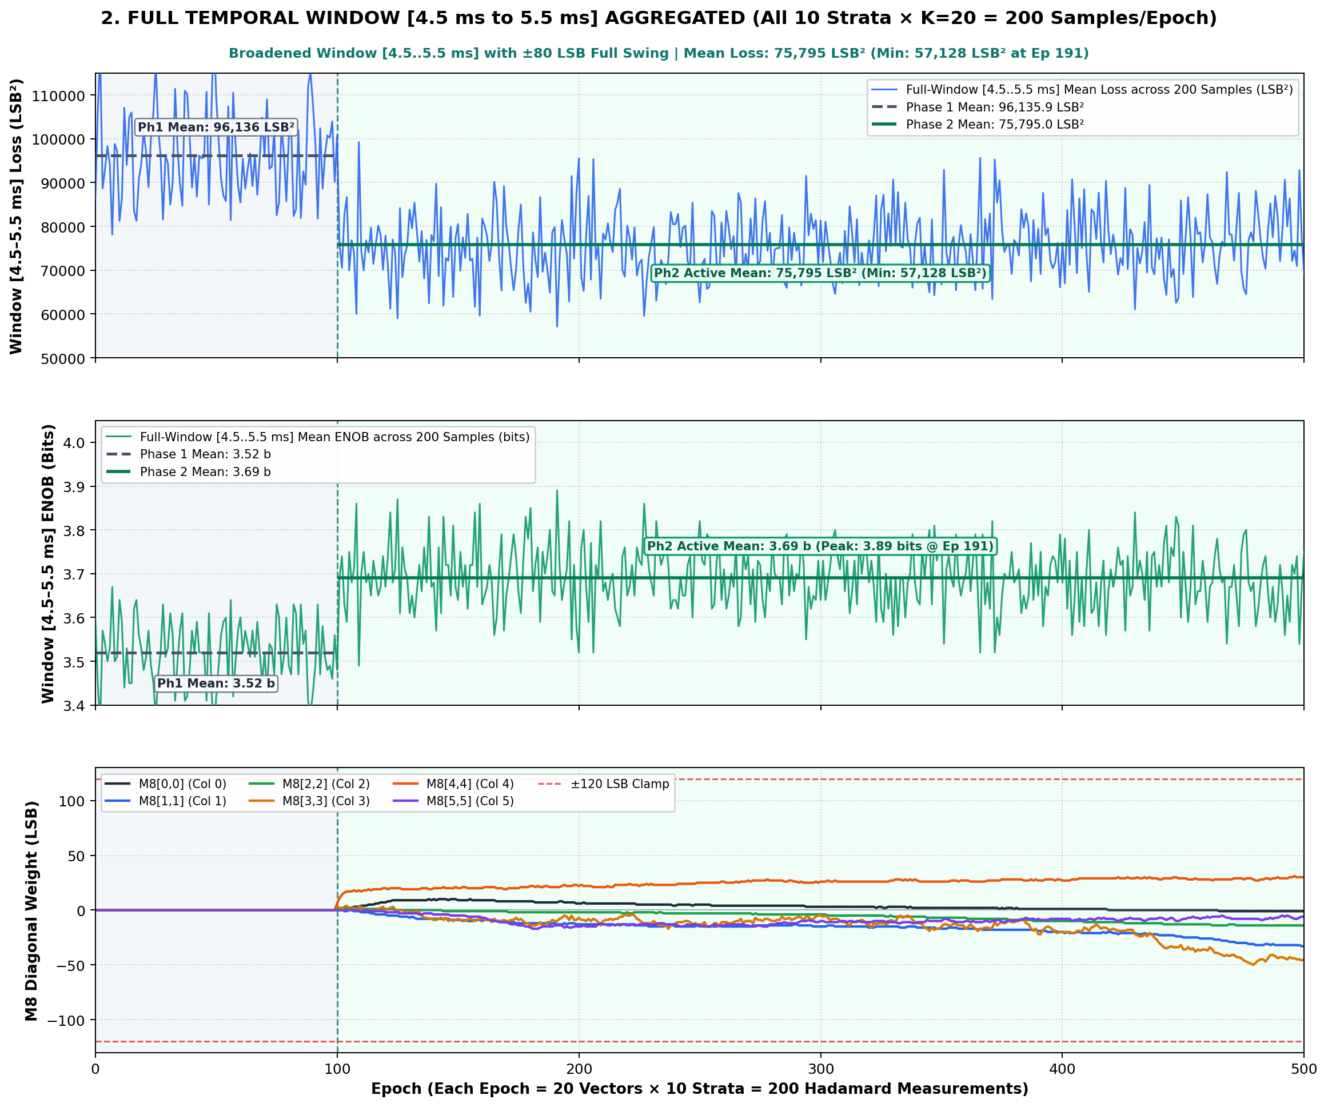
FPGA_code/docs/figures/fig_mode_a_500ep_window_4p5to5p5ms_only_card2_flat_lr0p08.png
