ollewelin/analog_matrix_computation_Inverted_MAML_PAT_PEND_2630397-4/FPGA_code/docs/figures/fig_mode_a_1000ep_5ms_pure_toeplitz_reg1024_lr0p08_swing40_var3_k1_ablation.png

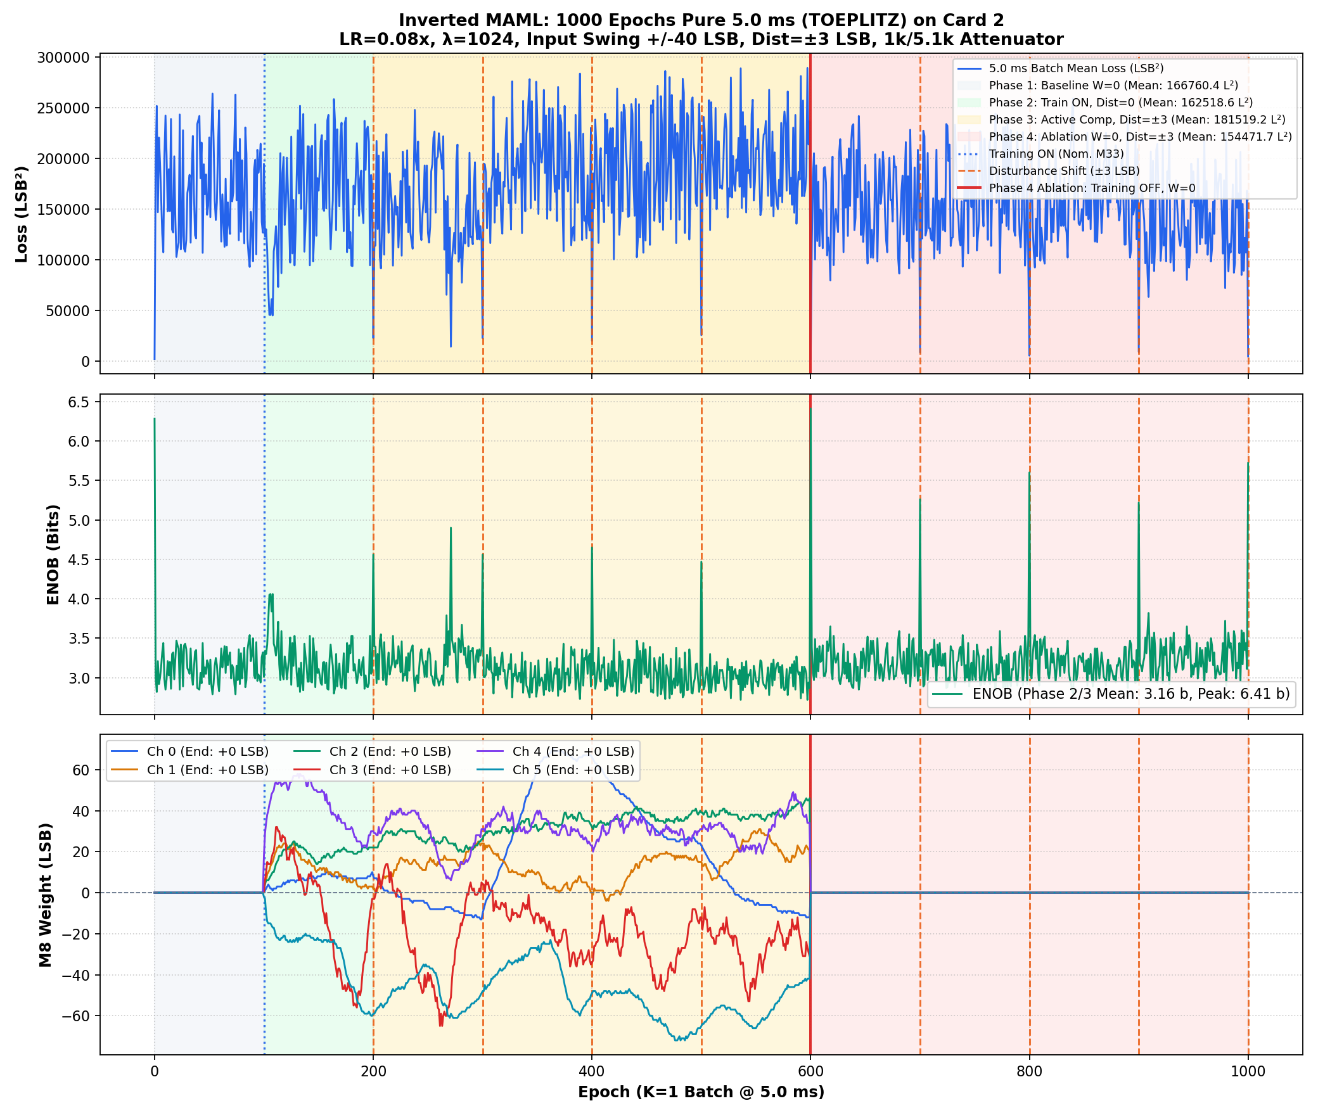
FPGA_code/docs/figures/fig_mode_a_1000ep_5ms_pure_toeplitz_reg1024_lr0p08_swing40_var3_k1_ablation.png
