ollewelin/analog_matrix_computation_Inverted_MAML_PAT_PEND_2630397-4/FPGA_code/docs/figures/fig_mode_a_1000ep_5ms_pure_toeplitz_reg2048_lr0p04_swing40_var3_k1_1k_3p3k_ablation.png

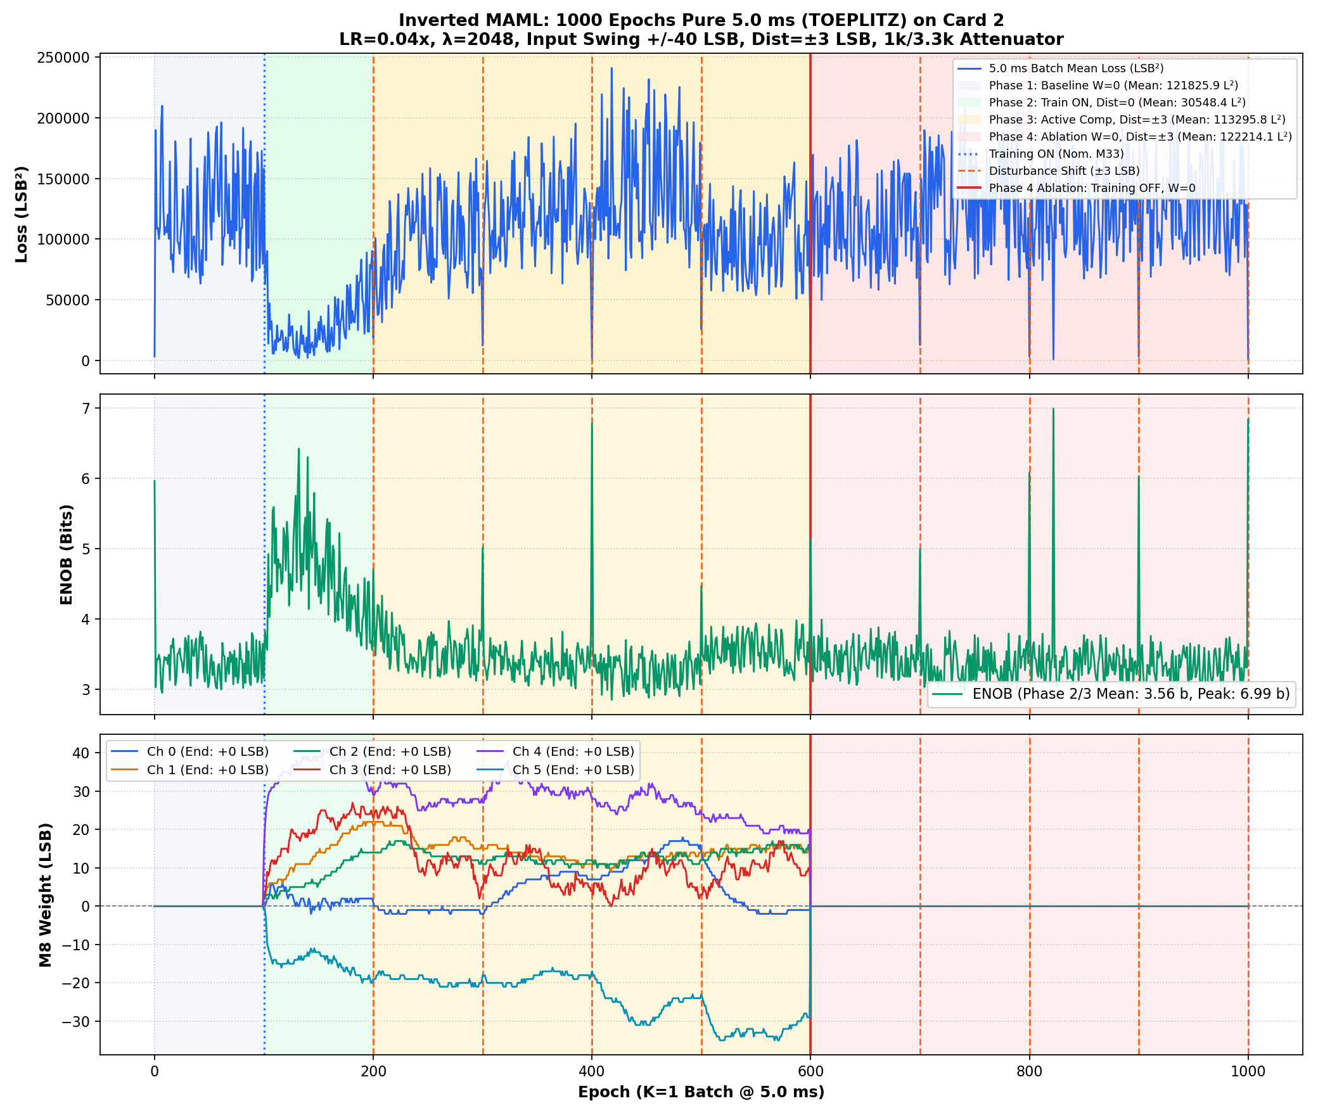
FPGA_code/docs/figures/fig_mode_a_1000ep_5ms_pure_toeplitz_reg2048_lr0p04_swing40_var3_k1_1k_3p3k_ablation.png
