ollewelin/analog_matrix_computation_Inverted_MAML_PAT_PEND_2630397-4/FPGA_code/docs/figures/fig_mode_a_1000ep_broadened_4500to5500us_white_reg2048_lr0p02_swing40_var5_k1_1k_3p3k_ablation.png

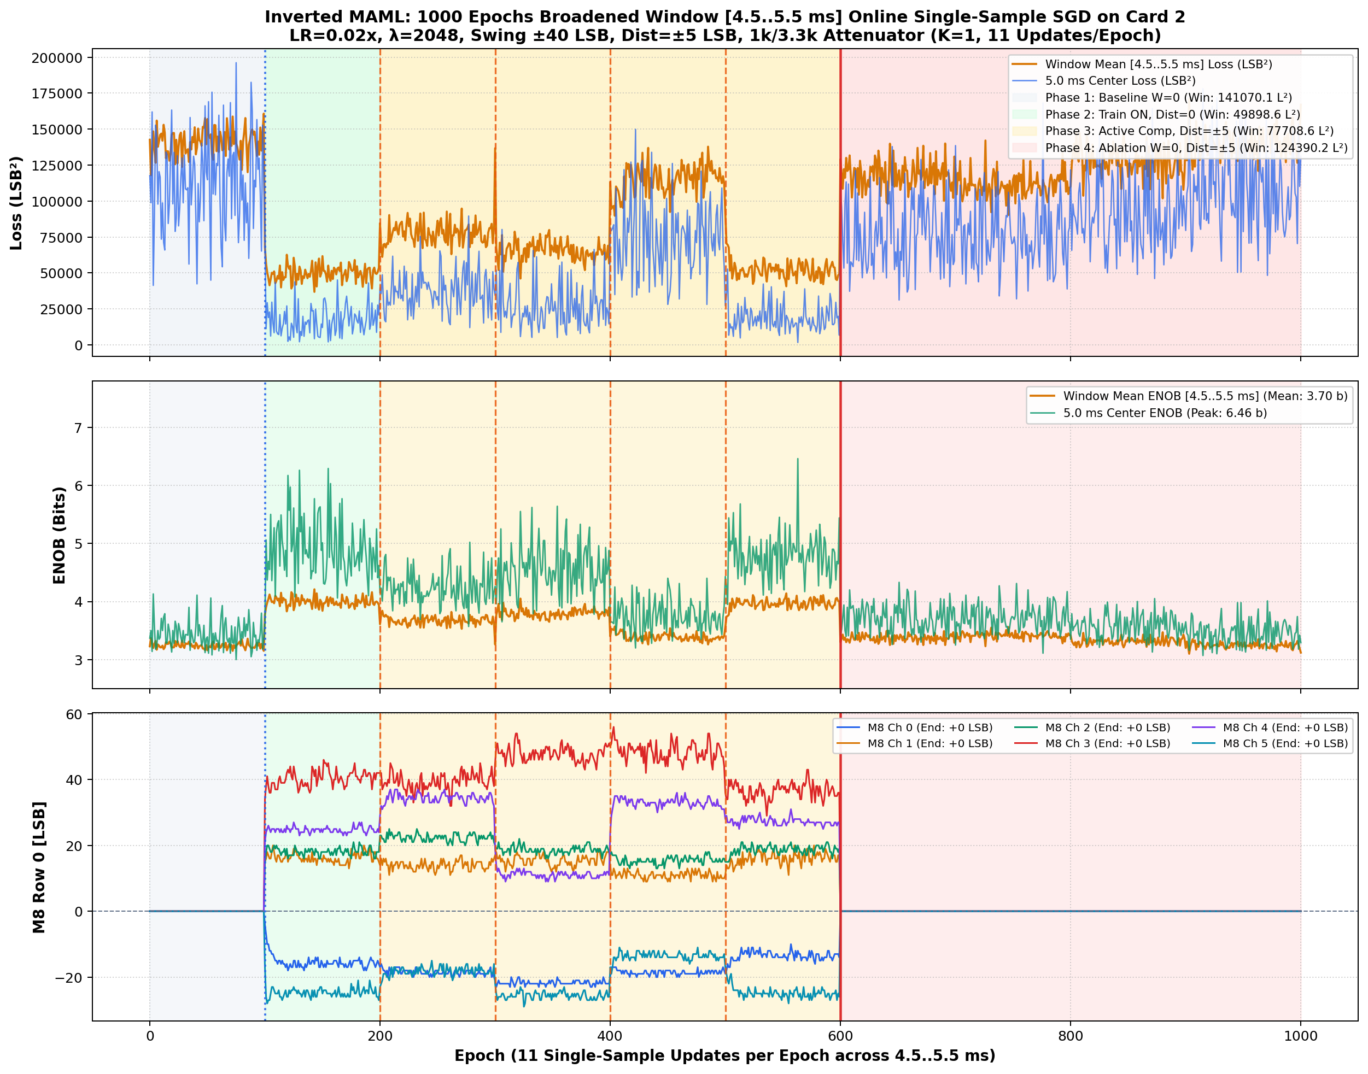
FPGA_code/docs/figures/fig_mode_a_1000ep_broadened_4500to5500us_white_reg2048_lr0p02_swing40_var5_k1_1k_3p3k_ablation.png
