ollewelin/analog_matrix_computation_Inverted_MAML_PAT_PEND_2630397-4/FPGA_code/docs/figures/fig_mode_b_vs_mode_a_comparison.png

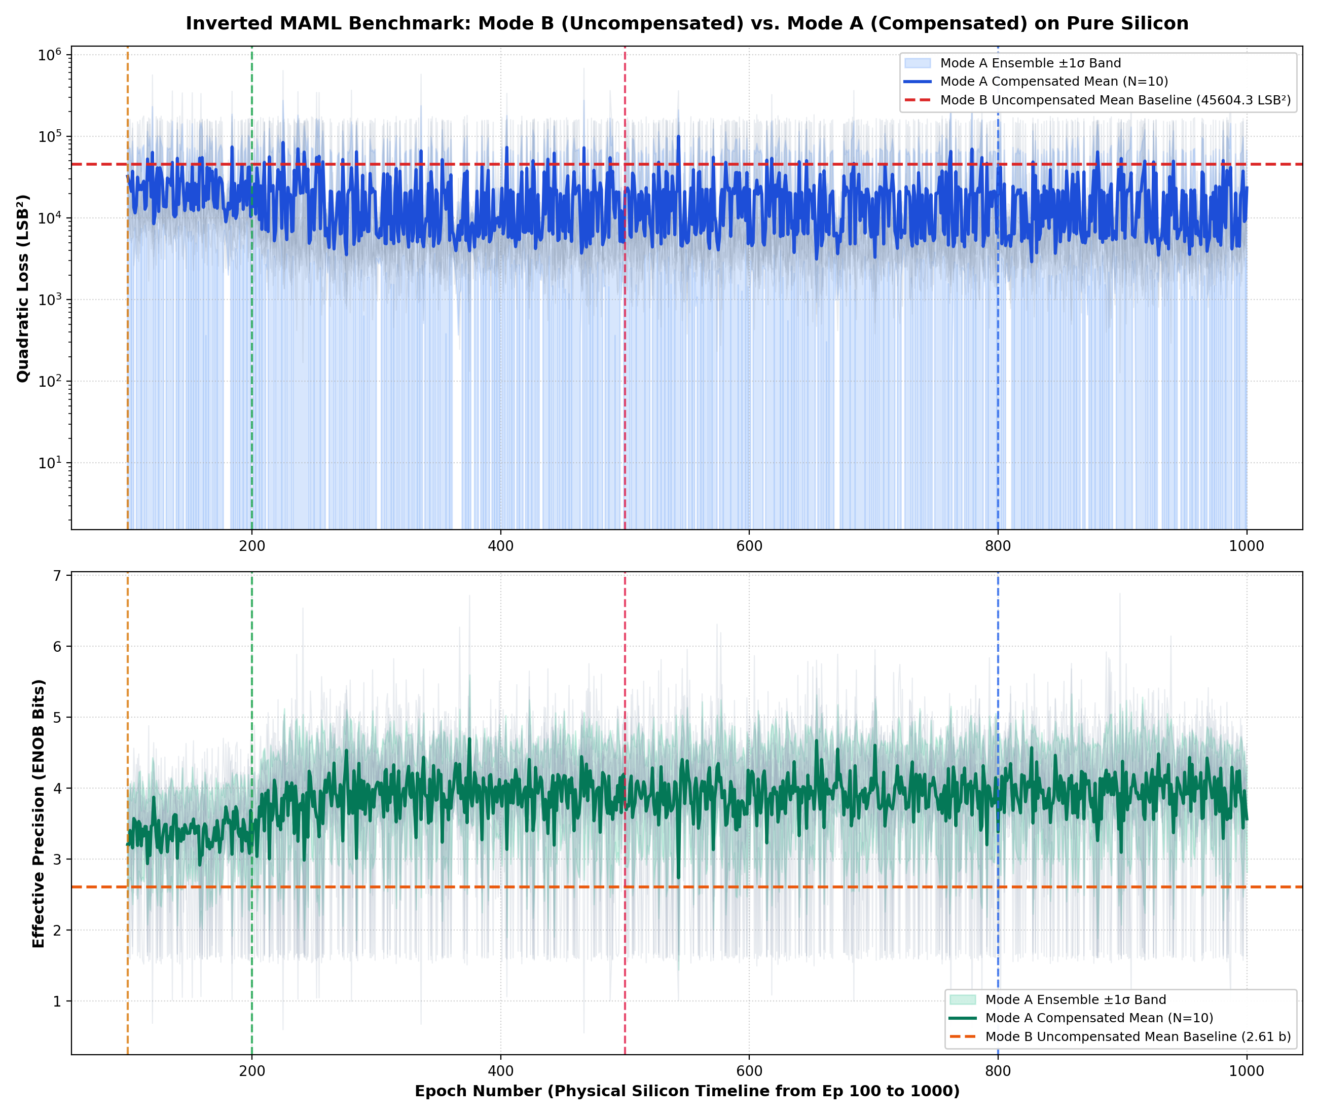
FPGA_code/docs/figures/fig_mode_b_vs_mode_a_comparison.png
