ollewelin/analog_matrix_computation_Inverted_MAML_PAT_PEND_2630397-4/FPGA_code/docs/figures/fig_schematic_sigmoid10_jumper_header.jpg

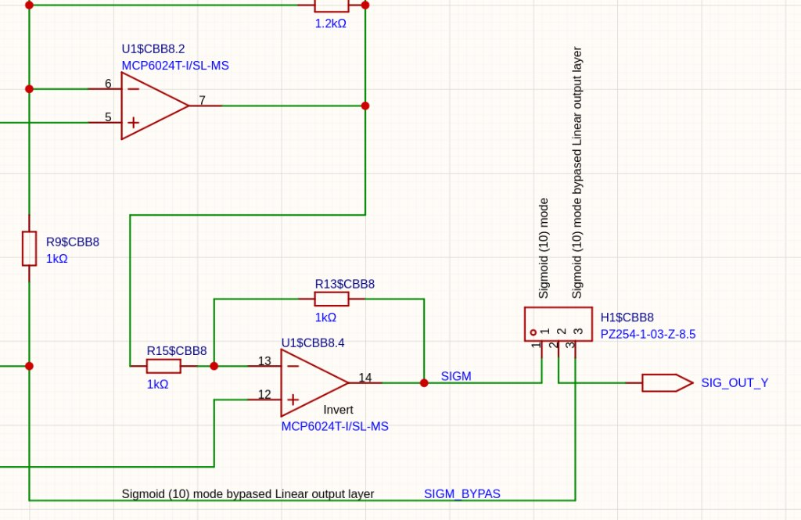
FPGA_code/docs/figures/fig_schematic_sigmoid10_jumper_header.jpg
