ollewelin/analog_matrix_computation_Inverted_MAML_PAT_PEND_2630397-4/FPGA_code/docs/figures/fig_schematic_summing_attenuator_1k_3k3.png

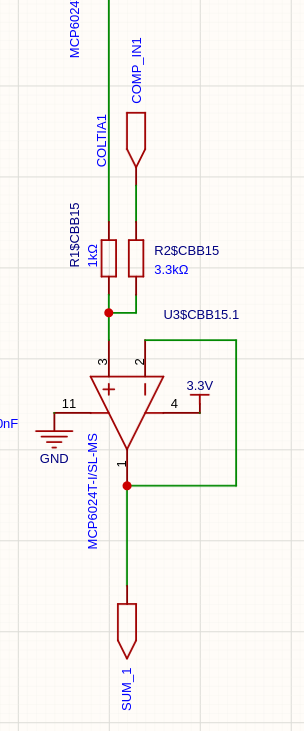
FPGA_code/docs/figures/fig_schematic_summing_attenuator_1k_3k3.png
