ollewelin/analog_matrix_computation_Inverted_MAML_PAT_PEND_2630397-4/FPGA_code/docs/figures/sweep_report_page-3.png

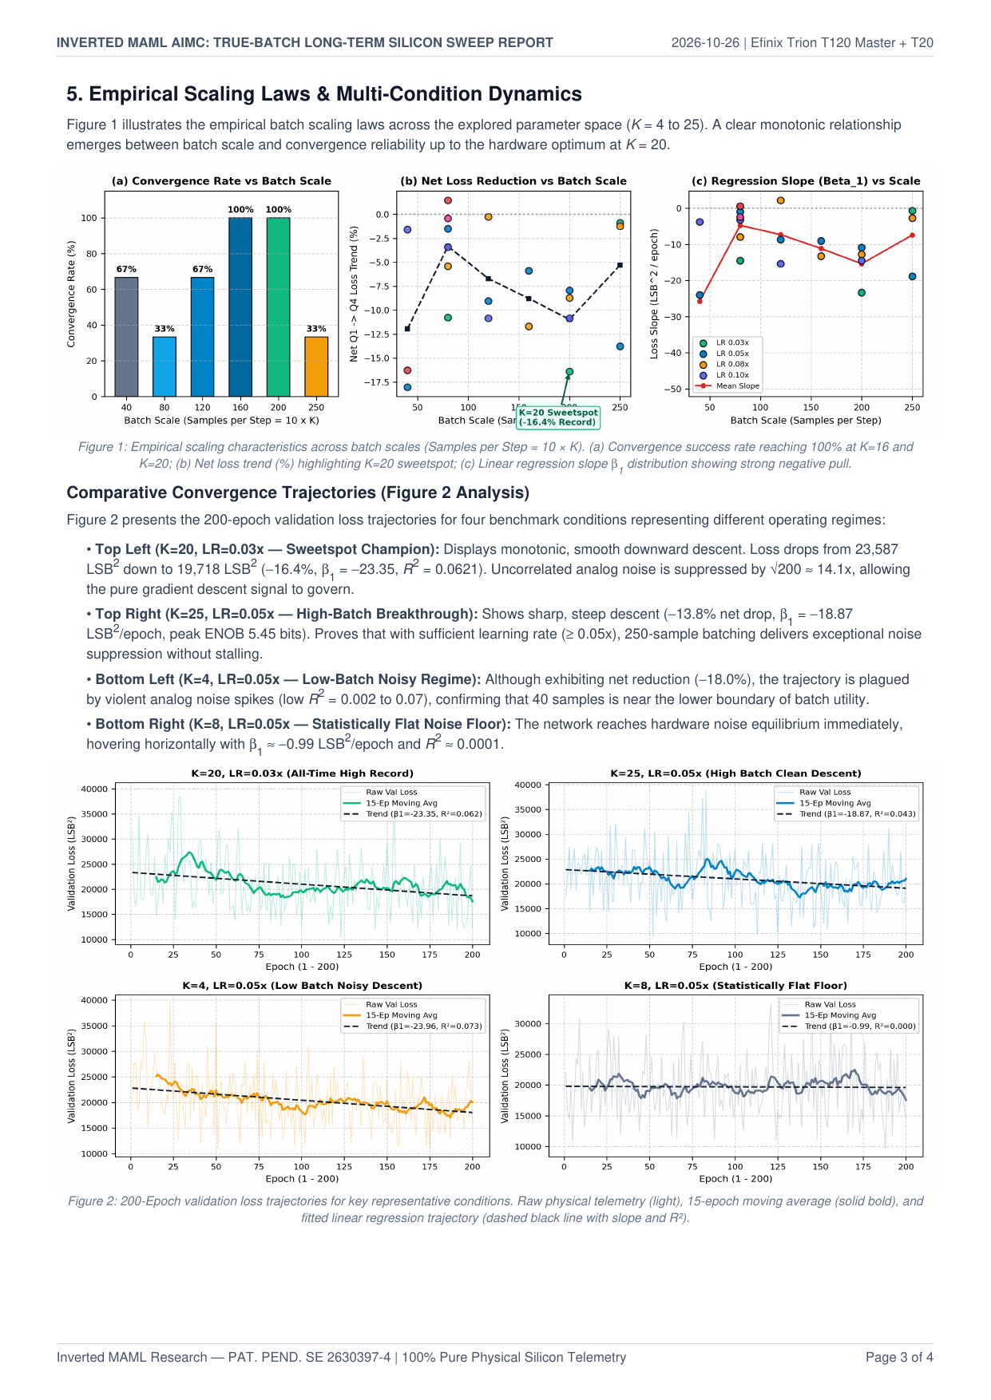
FPGA_code/docs/figures/sweep_report_page-3.png
