ollewelin/analog_matrix_computation_Inverted_MAML_PAT_PEND_2630397-4/FPGA_code/releases/Release_20261106_ModeA_Card2_1000ep_W3_Staircase_K1_PairedAblation/reports_and_logs/figures/fig_3d_card2_w3_staircase_disturbances_m33_4panel.png

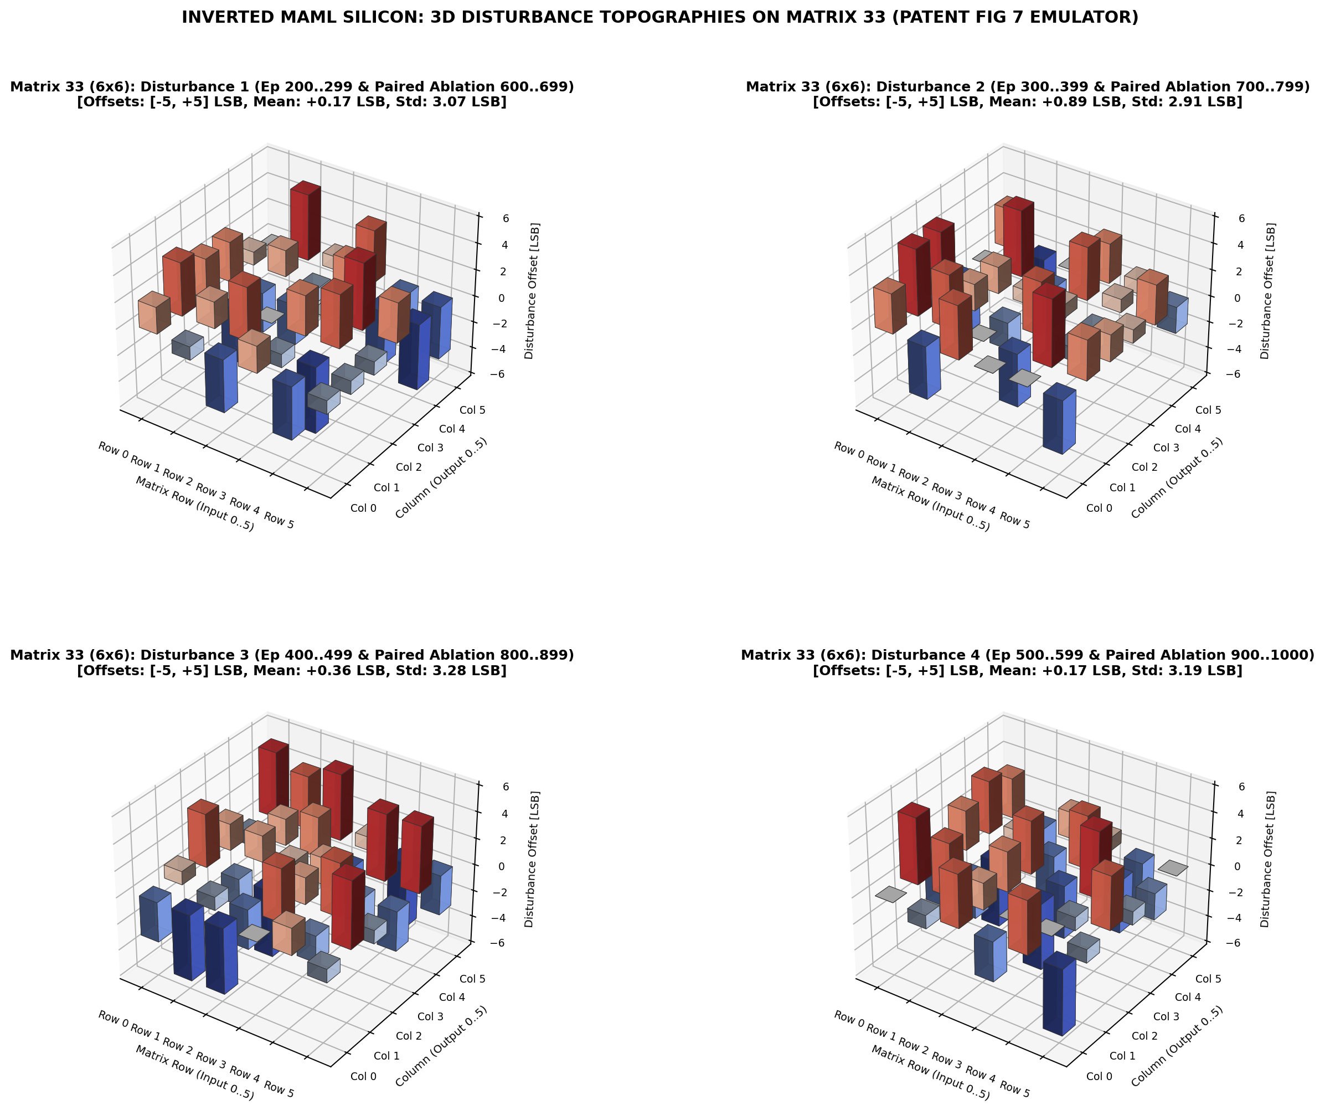
FPGA_code/releases/Release_20261106_ModeA_Card2_1000ep_W3_Staircase_K1_PairedAblation/reports_and_logs/figures/fig_3d_card2_w3_staircase_disturbances_m33_4panel.png
