ollewelin/analog_matrix_computation_Inverted_MAML_PAT_PEND_2630397-4/FPGA_code/releases/Release_20261106_ModeA_Card2_1000ep_W3_Staircase_K4_Addon/reports_and_logs/figures/fig_card2_w3_staircase_multi_timepoint_loss_enob_k4.png

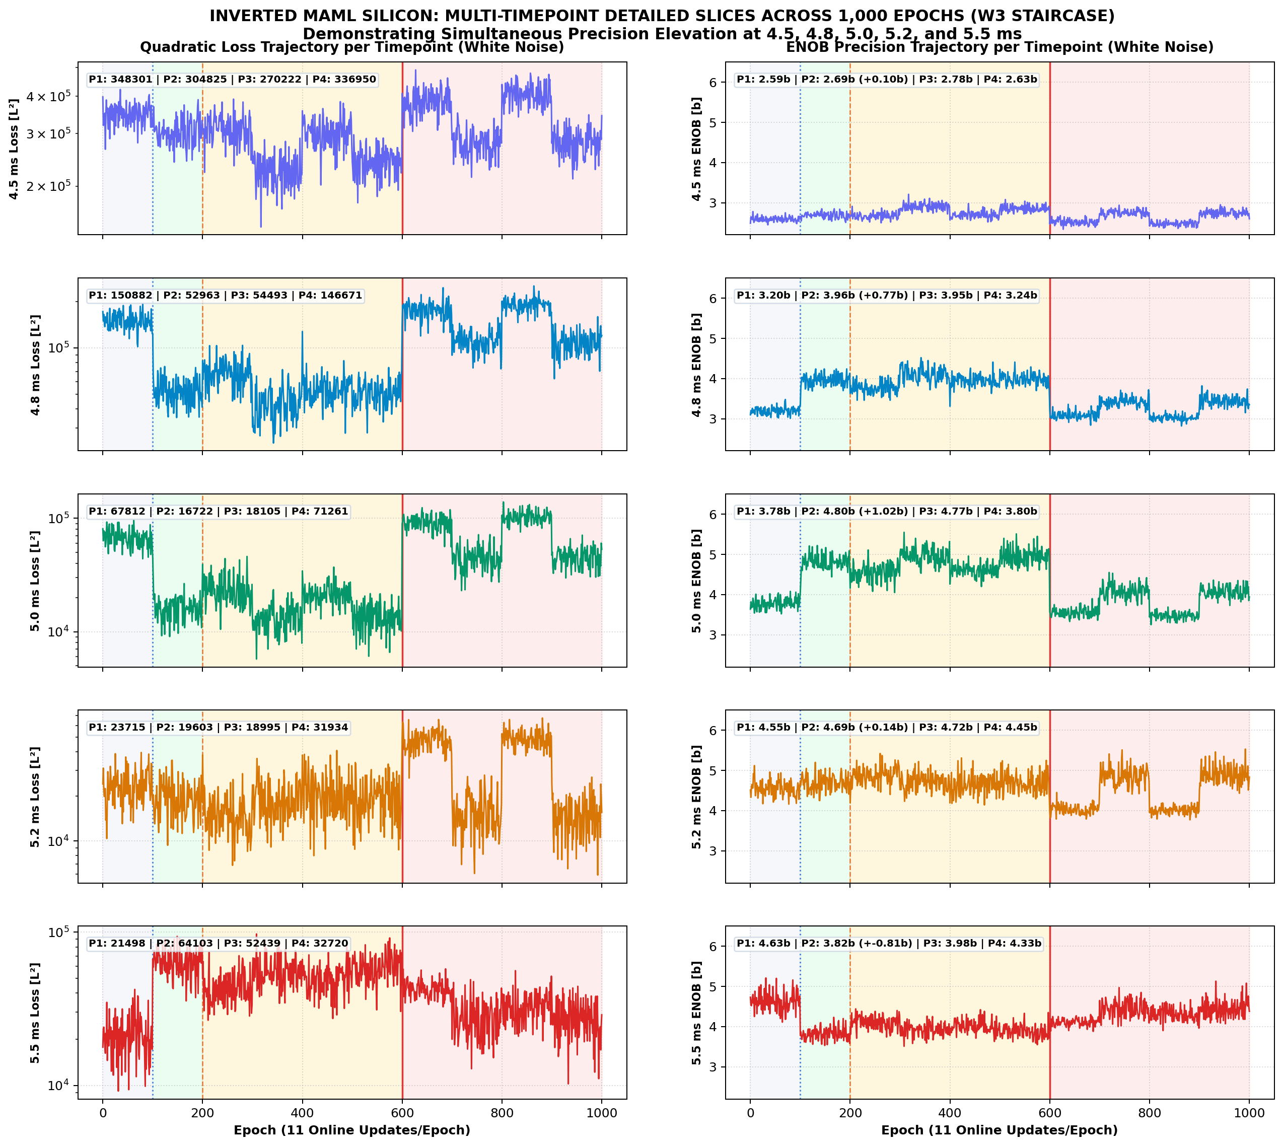
FPGA_code/releases/Release_20261106_ModeA_Card2_1000ep_W3_Staircase_K4_Addon/reports_and_logs/figures/fig_card2_w3_staircase_multi_timepoint_loss_enob_k4.png
