ollewelin/analog_matrix_computation_Inverted_MAML_PAT_PEND_2630397-4/FPGA_code/releases/Release_20261106_ModeA_Card2_1000ep_W3_Staircase_K4_Addon/reports_and_logs/figures/fig_mode_a_1000ep_5ms_pure_toeplitz_reg1024_lr0p08_swing40_var3_k4_1k_3p3k_ablation.png

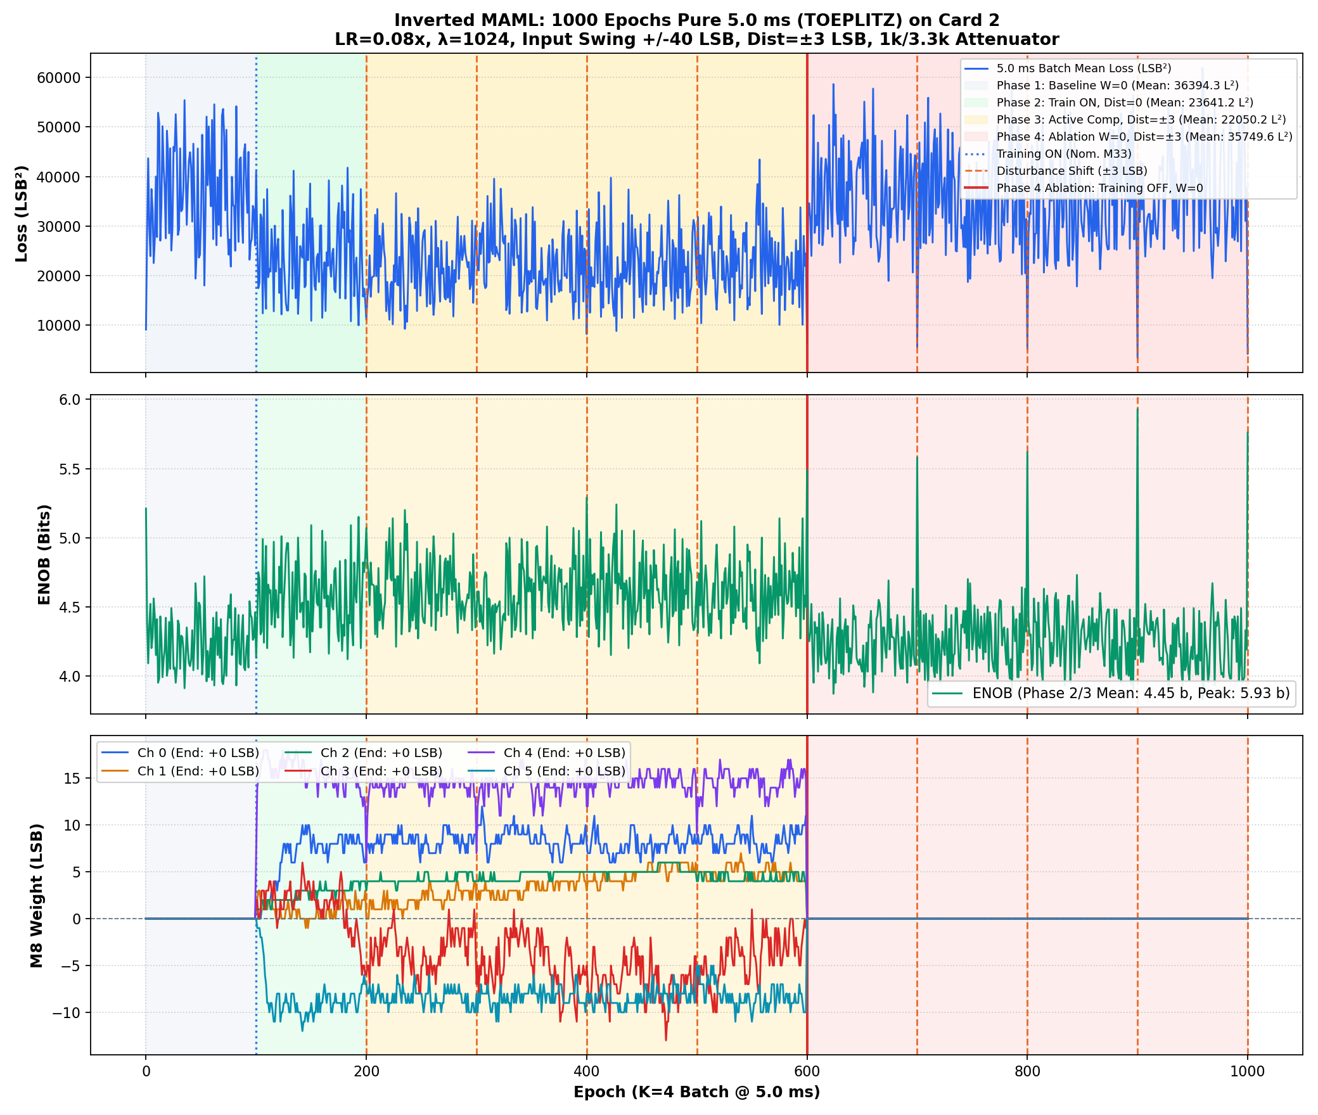
FPGA_code/releases/Release_20261106_ModeA_Card2_1000ep_W3_Staircase_K4_Addon/reports_and_logs/figures/fig_mode_a_1000ep_5ms_pure_toeplitz_reg1024_lr0p08_swing40_var3_k4_1k_3p3k_ablation.png
