ollewelin/analog_matrix_computation_Inverted_MAML_PAT_PEND_2630397-4/FPGA_code/releases/Release_20261106_ModeA_Card2_1000ep_W3_Staircase_K4_Addon/reports_and_logs/figures/fig_mode_a_1000ep_broadened_4500to5500us_white_reg2048_lr0p02_swing40_var5_k4_1k_3p3k_w3staircase_ablation_temporal_profile.png

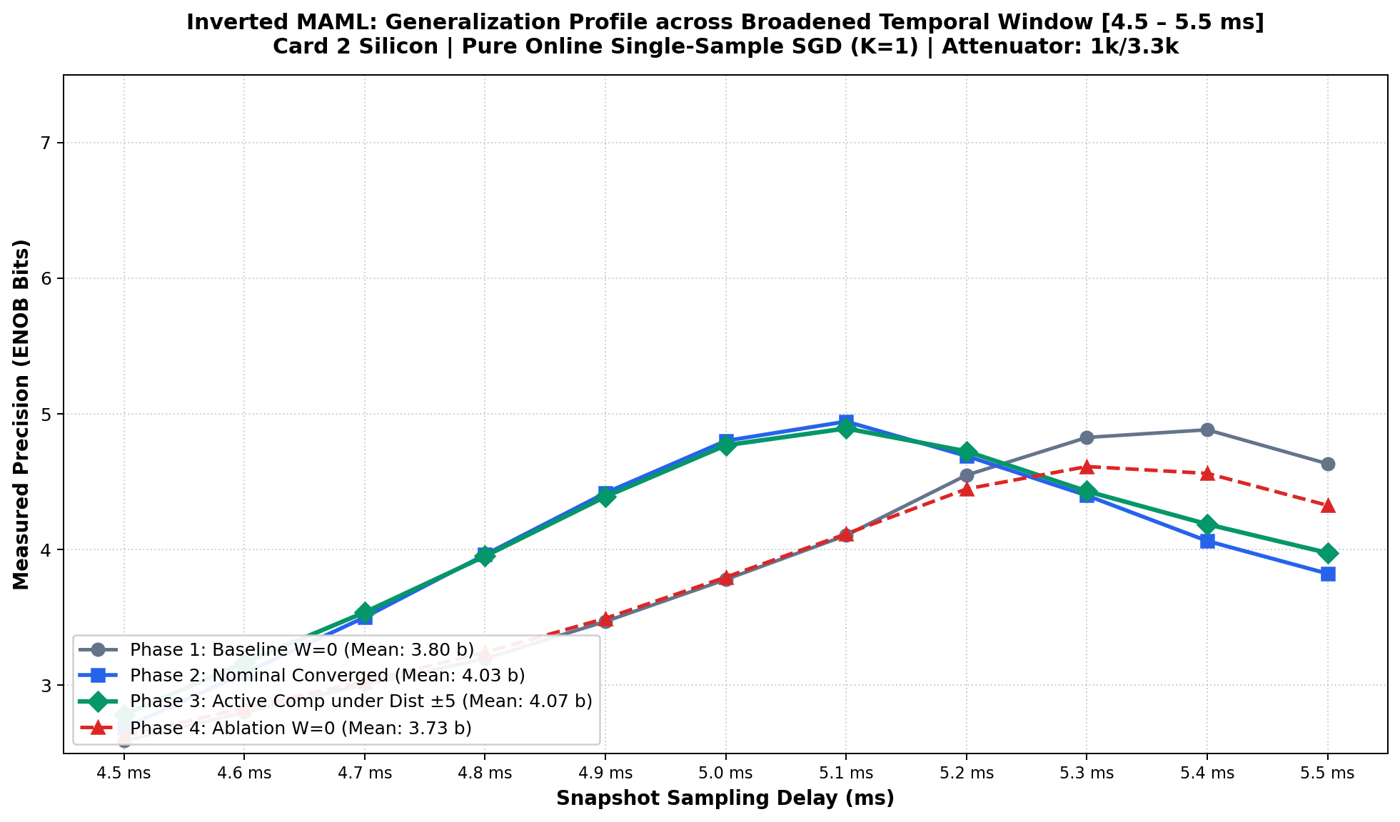
FPGA_code/releases/Release_20261106_ModeA_Card2_1000ep_W3_Staircase_K4_Addon/reports_and_logs/figures/fig_mode_a_1000ep_broadened_4500to5500us_white_reg2048_lr0p02_swing40_var5_k4_1k_3p3k_w3staircase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
