ollewelin/analog_matrix_computation_Inverted_MAML_PAT_PEND_2630397-4/FPGA_code/releases/Release_20261107_ModeA_Card2_TimingSolid_VerilogEngine_Comprehensive/reports_and_logs/figures/fig_2d_m8_trajectory_card2_w3_staircase_mode_b.png

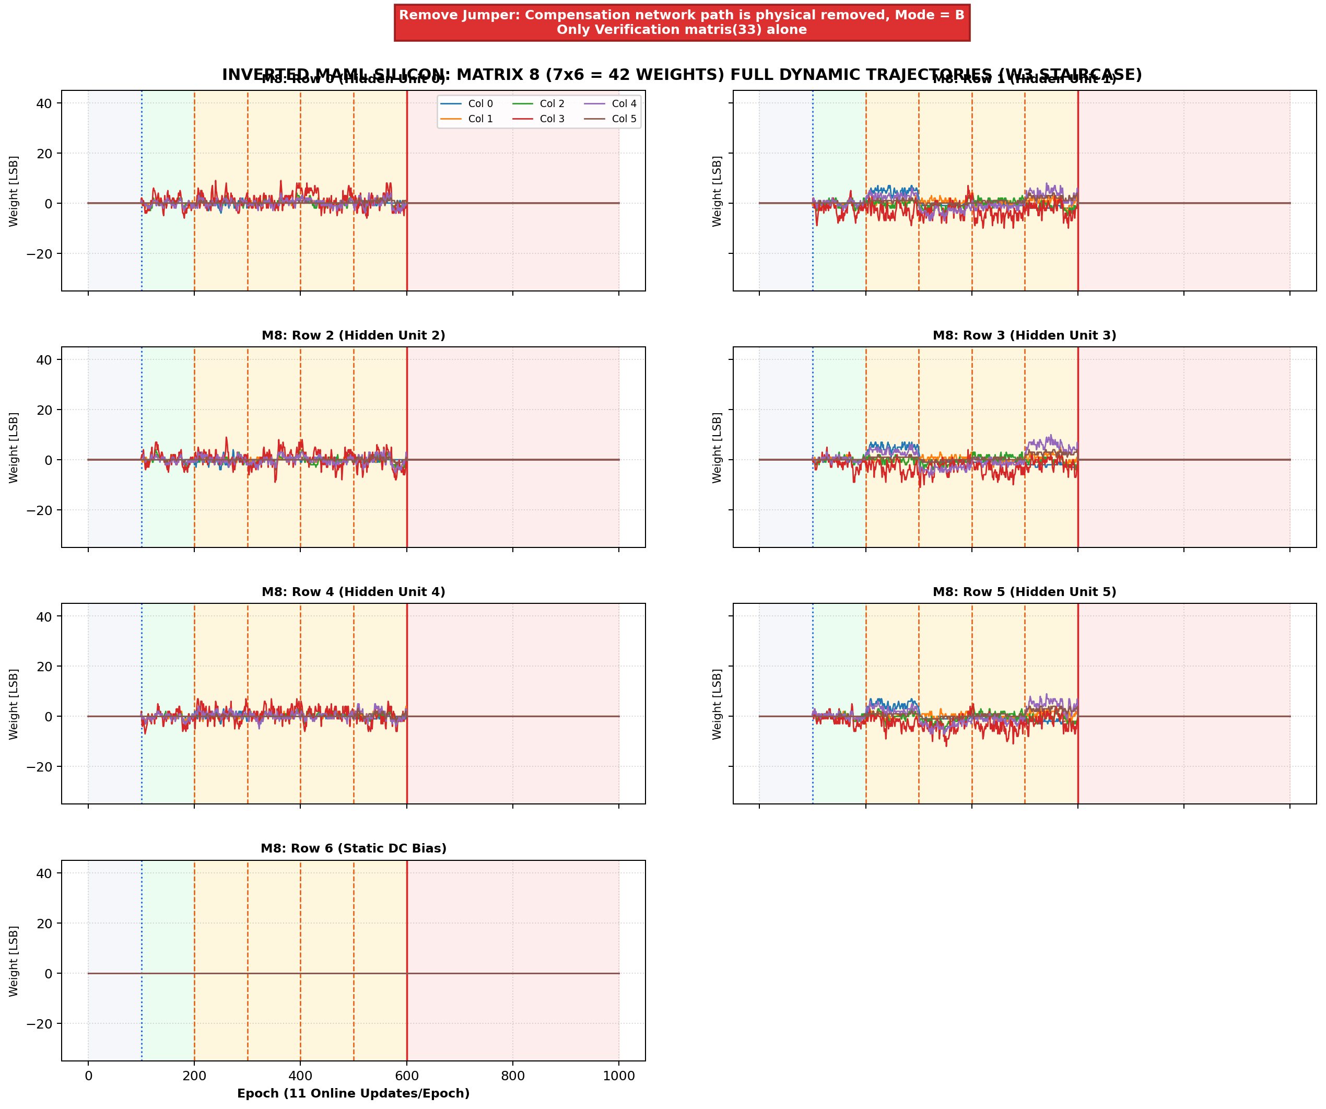
FPGA_code/releases/Release_20261107_ModeA_Card2_TimingSolid_VerilogEngine_Comprehensive/reports_and_logs/figures/fig_2d_m8_trajectory_card2_w3_staircase_mode_b.png
