ollewelin/analog_matrix_computation_Inverted_MAML_PAT_PEND_2630397-4/FPGA_code/releases/Release_20261107_ModeA_Card2_TimingSolid_VerilogEngine_Comprehensive/reports_and_logs/figures/fig_3d_card2_w3_staircase_disturbances_m33_4panel_k4.png

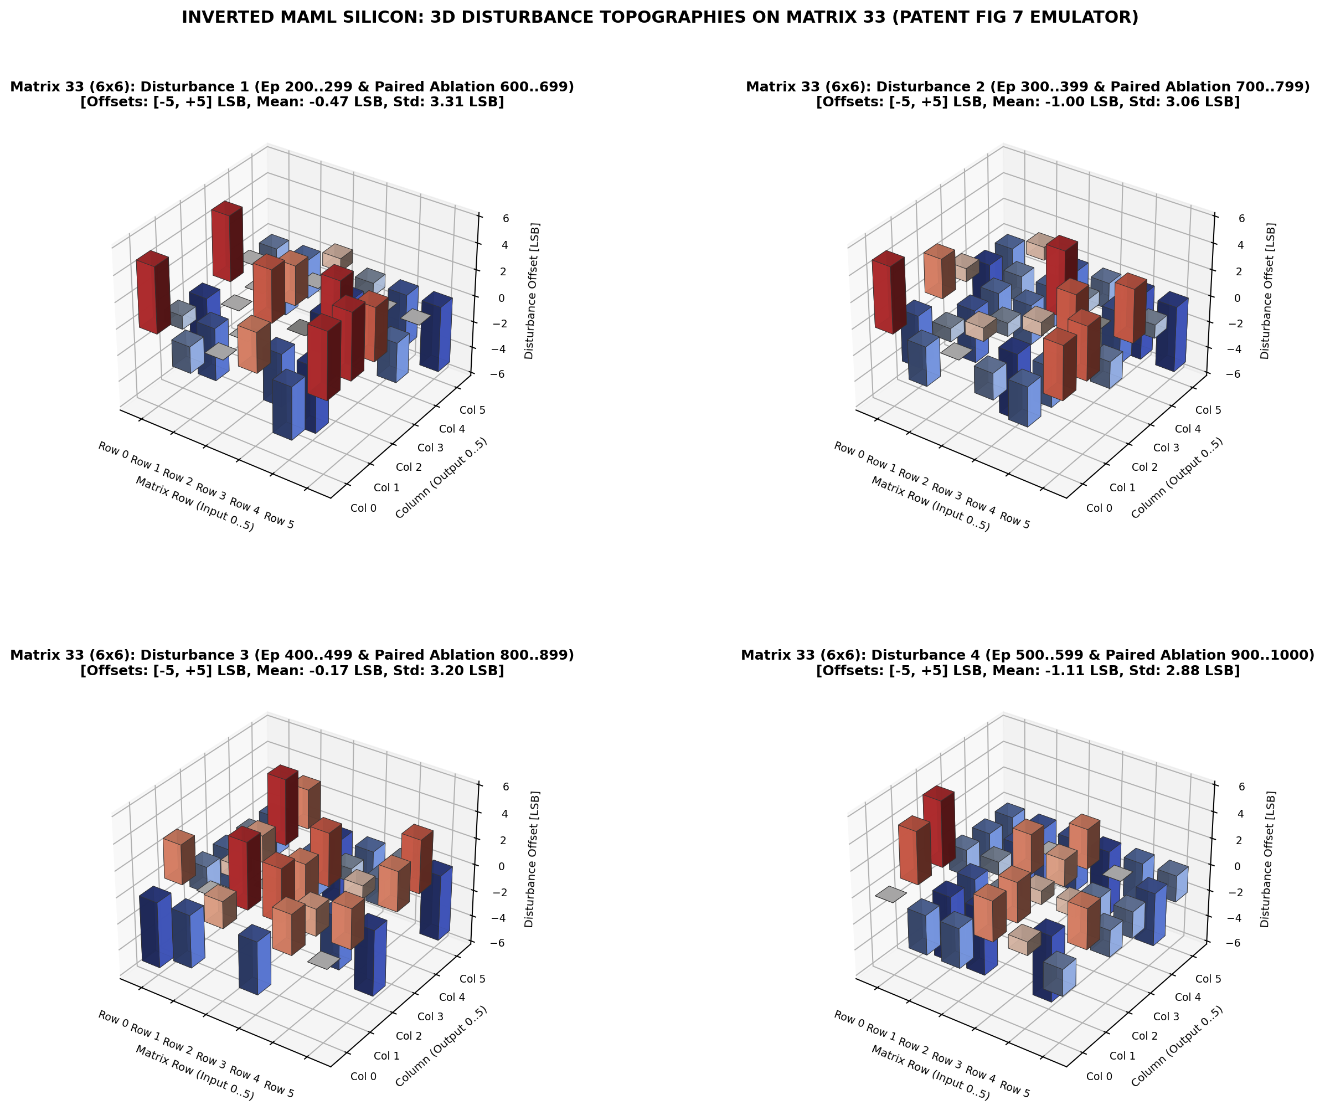
FPGA_code/releases/Release_20261107_ModeA_Card2_TimingSolid_VerilogEngine_Comprehensive/reports_and_logs/figures/fig_3d_card2_w3_staircase_disturbances_m33_4panel_k4.png
