ollewelin/analog_matrix_computation_Inverted_MAML_PAT_PEND_2630397-4/FPGA_code/releases/Release_20261107_ModeA_Card2_TimingSolid_VerilogEngine_Comprehensive/reports_and_logs/figures/fig_card2_w3_staircase_joint_loss_and_enob_all_stratas_4900to5900us_reg1024.png

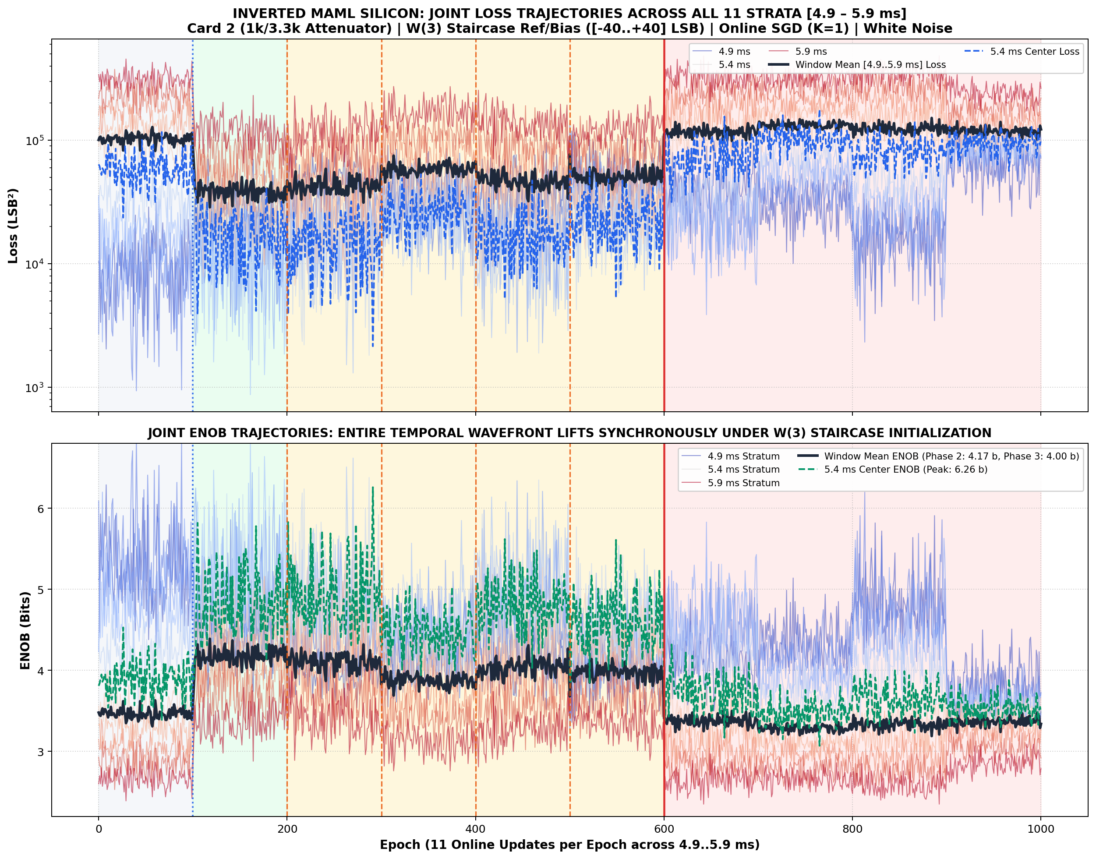
FPGA_code/releases/Release_20261107_ModeA_Card2_TimingSolid_VerilogEngine_Comprehensive/reports_and_logs/figures/fig_card2_w3_staircase_joint_loss_and_enob_all_stratas_4900to5900us_reg1024.png
