ollewelin/analog_matrix_computation_Inverted_MAML_PAT_PEND_2630397-4/FPGA_code/releases/Release_20261108_ModeA_Card2_ThermalStress_Cycling_30pctDuty_1Hz/reports_and_logs/figures/fig_card2_thermal_waterfall.png

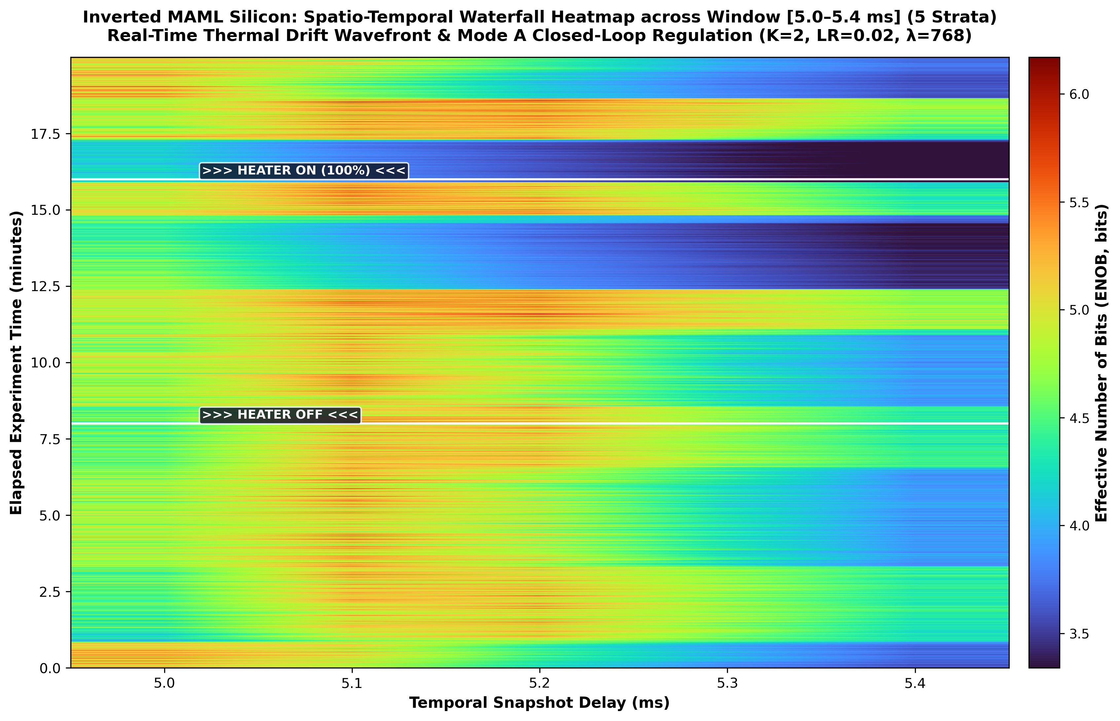
FPGA_code/releases/Release_20261108_ModeA_Card2_ThermalStress_Cycling_30pctDuty_1Hz/reports_and_logs/figures/fig_card2_thermal_waterfall.png
