ollewelin/analog_matrix_computation_Inverted_MAML_PAT_PEND_2630397-4/FPGA_code/releases/Release_20261110_ModeA_Card2_ColdStart_ThermalStress_FHP/reports_and_logs/figures/fig_card2_thermal_cold_start_timeline.png

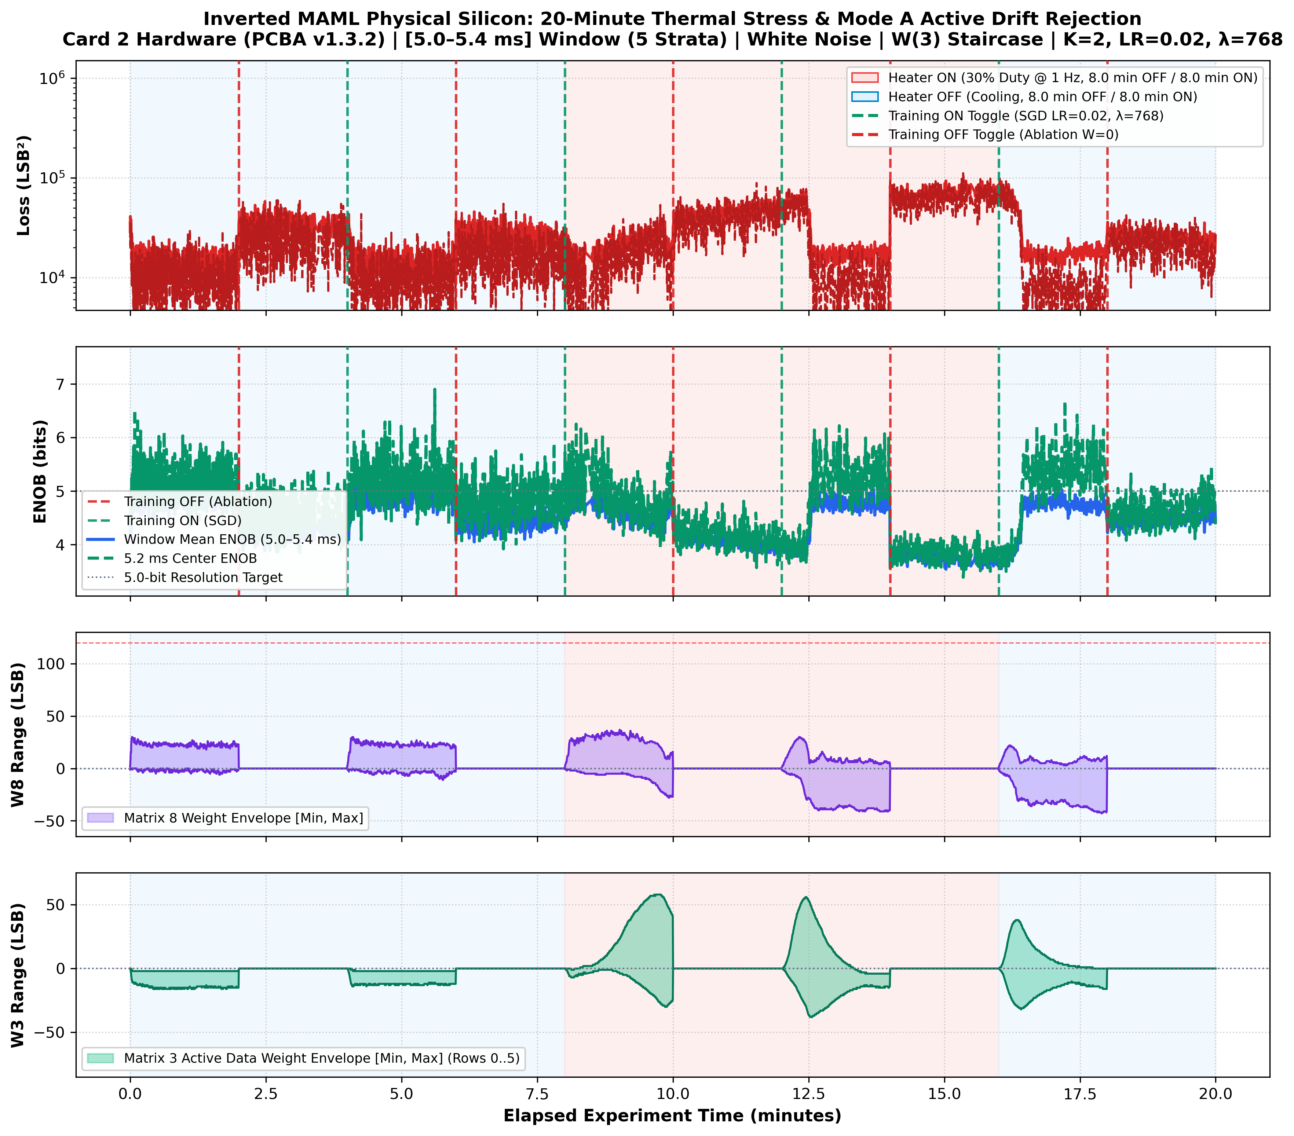
FPGA_code/releases/Release_20261110_ModeA_Card2_ColdStart_ThermalStress_FHP/reports_and_logs/figures/fig_card2_thermal_cold_start_timeline.png
