ollewelin/analog_matrix_computation_Inverted_MAML_PAT_PEND_2630397-4/FPGA_code/releases/Release_20261114_ModeA_Card1_BitSlicing_AntiWindup_Baseline_R1/reports_and_logs/figures/fig_card1_r3_lr0p02_l2_2560_mom0p80_cl70_w8_w3_all_weights.png

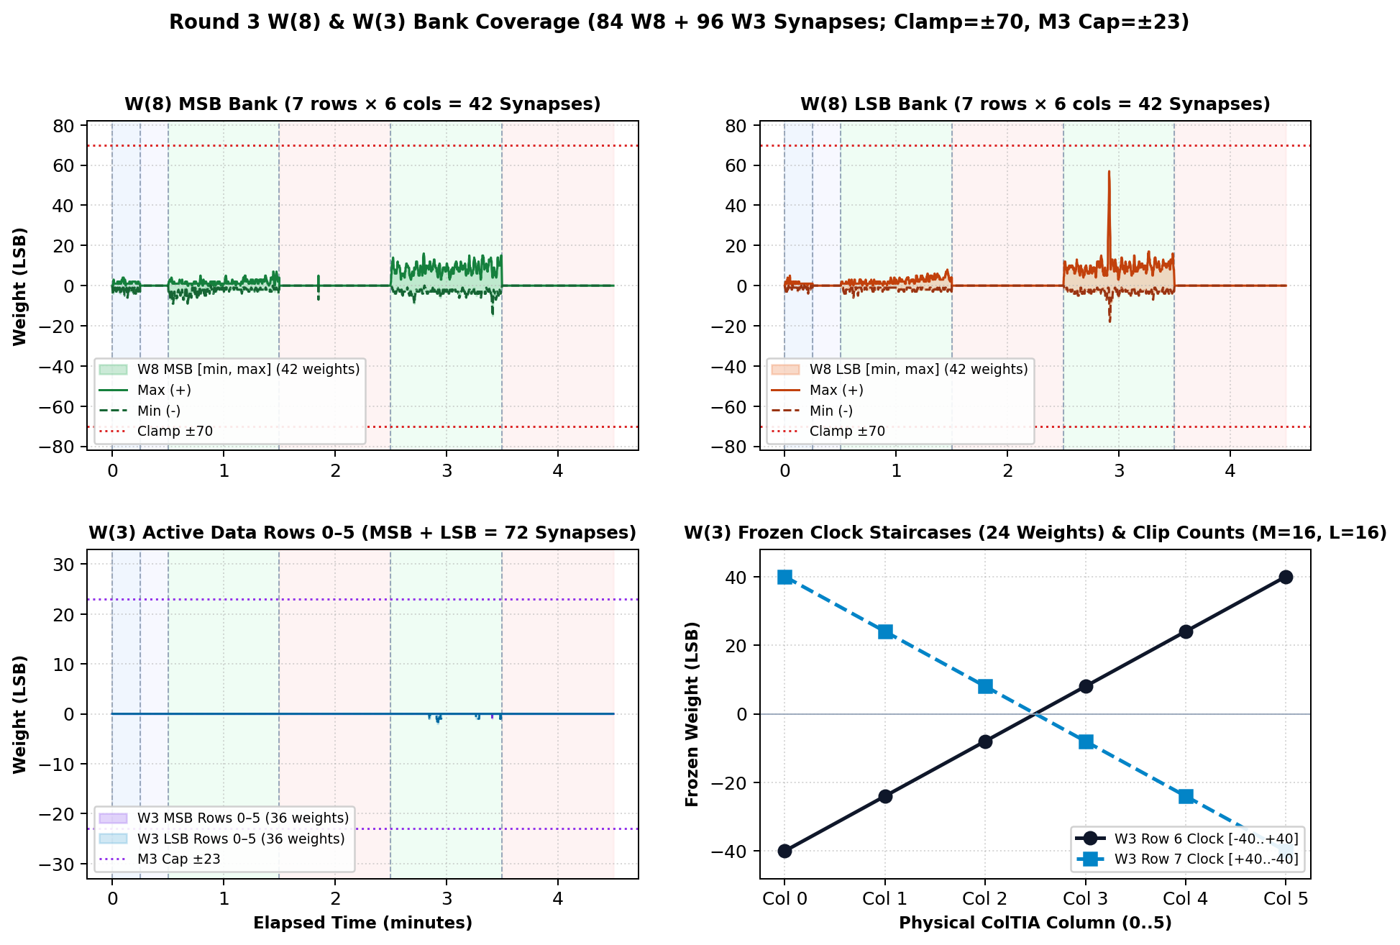
FPGA_code/releases/Release_20261114_ModeA_Card1_BitSlicing_AntiWindup_Baseline_R1/reports_and_logs/figures/fig_card1_r3_lr0p02_l2_2560_mom0p80_cl70_w8_w3_all_weights.png
