ollewelin/analog_matrix_computation_Inverted_MAML_PAT_PEND_2630397-4/FPGA_code/releases/Release_20261114_ModeA_Card1_BitSlicing_AntiWindup_Baseline_R1/reports_and_logs/figures/fig_card1_r5_lr0p03_l2_1024_mom0p85_cl75_w8_w3_all_weights.png

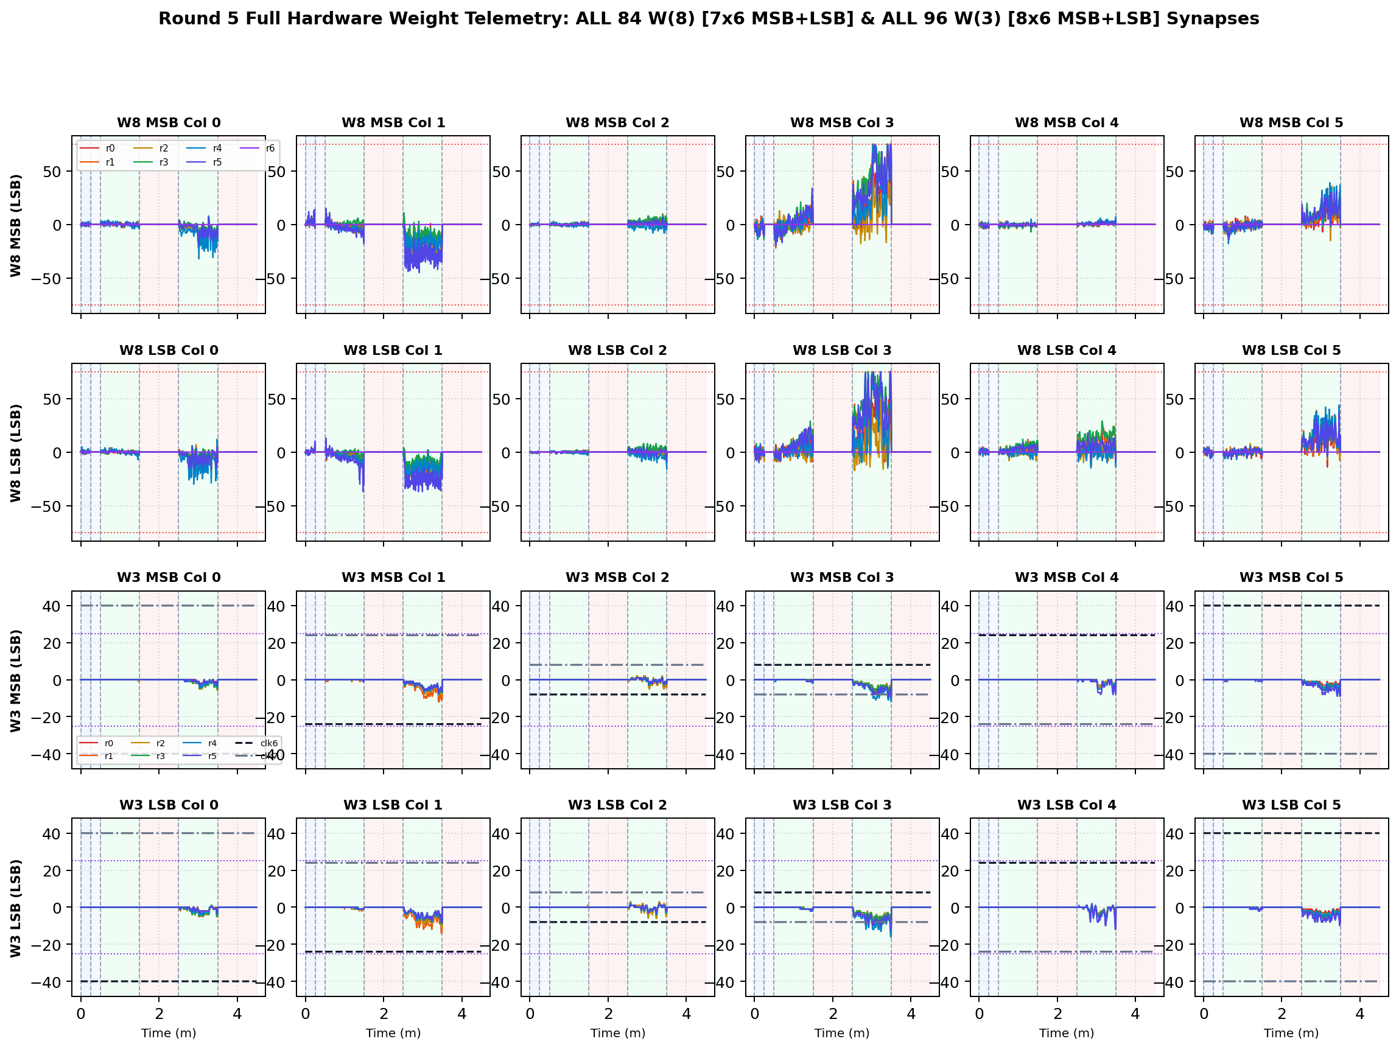
FPGA_code/releases/Release_20261114_ModeA_Card1_BitSlicing_AntiWindup_Baseline_R1/reports_and_logs/figures/fig_card1_r5_lr0p03_l2_1024_mom0p85_cl75_w8_w3_all_weights.png
