ollewelin/analog_matrix_computation_Inverted_MAML_PAT_PEND_2630397-4/Oscilloscope_Row_Kickback_276mV.jpg

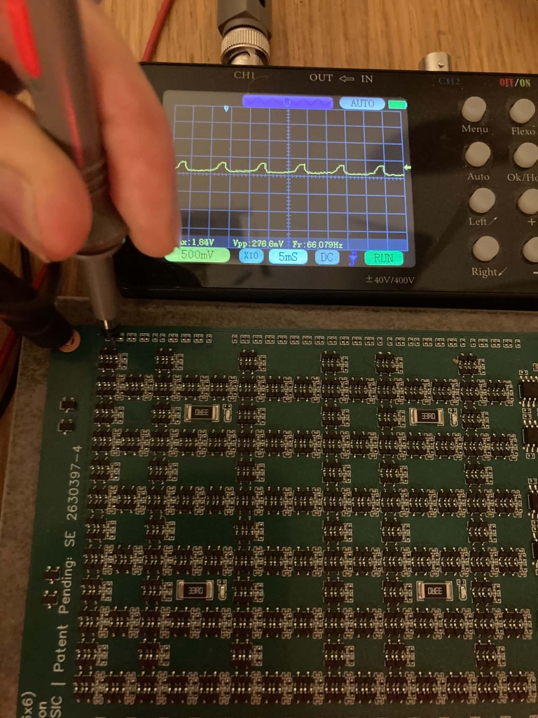
Oscilloscope_Row_Kickback_276mV.jpg
