ollewelin/analog_matrix_computation_Inverted_MAML_PAT_PEND_2630397-4/EasyEDA/Production_files_1_3_2/BOM_Analog_Matrix_Inverted_MAML_IMC_2026-09-05-JLCPCB Assembly Order(1).xls

JLCPCB BOM Tool - BOM Matching
BOM name：BOM_Analog_Matrix_Inverted_MAML_IMC_2026-09-05-JLCPCB Assembly Order.xlsx |  |  | Download Time：2026-09-05 20:48:48 |  |  |  | * Our matching results are updated in real-time, but stock and prices may change. If it's been over 24 hours, please re-match before placing your order.
PCB Assembled Qty：5 |  |  | Est. Total Price：80.6537
Your BOM |  |  |  | Matched Parts |  |  |  |  |  |  | Order Information
Designator | Comment | Footprint | JLCPCB Part # | Matches | Part # | Manufacturer | Footprint | Description | Category | Warning | JLCPCB Part # | Product link | Lib Type | Qty | Source | Total Price ($)
C2 | 1uF | C1206 |  | Select by System | CL31B105KBHNNNE | Samsung Electro-Mechanics | 1206 | 1uF 50V X7R ±10% 1206 Multilayer Ceramic Capacitors MLCC - SMD/SMT ROHS | Multilayer Ceramic Capacitors MLCC - SMD/SMT |  | C1848 | https://jlcpcb.com/partdetail/2200-CL31B105KBHNNNE/C1848 | Basic | 15 | 15 JLCPCB | 0.9465
C3,C4,C7,C35,C72 | 22uF | C2220 |  | Select by System | FS55X226K500EHG | PSA(Prosperity Dielectrics) | 2220 | 22uF 50V X7R ±10% 2220 Multilayer Ceramic Capacitors MLCC - SMD/SMT ROHS | Multilayer Ceramic Capacitors MLCC - SMD/SMT |  | C784103 | https://jlcpcb.com/partdetail/839503-FS55X226K500EHG/C784103 | Extended | 10 | 10 JLCPCB | 13.548
C6,C31,C38,C43,C60,C67,C212$CBB24,C215$CBB24,C217$CBB24,C220$CBB24 | 4.7uF | C0402 |  | Unconfirmed | CL05A475MP5NRNC | Samsung Electro-Mechanics | 0402 | 10V 4.7uF X5R ±20% 0402 Multilayer Ceramic Capacitors MLCC - SMD/SMT ROHS | Multilayer Ceramic Capacitors MLCC - SMD/SMT | 1.There may be multiple types of parts, but one type of part has been matched. Please check.; | C23733 | https://jlcpcb.com/partdetail/24469-CL05A475MP5NRNC/C23733 | Basic | 48 | 48 JLCPCB | 1.0848
C121$CBB22/CBB2,C122$CBB22/CBB2,C134$CBB22/CBB2,C136$CBB22/CBB2 | 4.7uF | C0402 |  | Select by System | CL05A475MP5NRNC | Samsung Electro-Mechanics | 0402 | 10V 4.7uF X5R ±20% 0402 Multilayer Ceramic Capacitors MLCC - SMD/SMT ROHS | Multilayer Ceramic Capacitors MLCC - SMD/SMT |  | C23733 | https://jlcpcb.com/partdetail/24469-CL05A475MP5NRNC/C23733 | Basic | 48 | 48 JLCPCB | 1.0848
C29,C30,C32,C32$CBB23,C37,C39,C44,C50,C51,C53,C61,C66,C71 | 47uF | C1206 |  | Unconfirmed | CL31A476MPHNNNE | Samsung Electro-Mechanics | 1206 | 10V 47uF X5R ±20% 1206 Multilayer Ceramic Capacitors MLCC - SMD/SMT ROHS | Multilayer Ceramic Capacitors MLCC - SMD/SMT | 1.There may be multiple types of parts, but one type of part has been matched. Please check.; | C96123 | https://jlcpcb.com/partdetail/97327-CL31A476MPHNNNE/C96123 | Basic | 30 | 30 JLCPCB | 7.59
C34,C49,C55$CBB22/CBB2,C56$CBB22/CBB2,C65 | 12pF | C0402 |  | Unconfirmed | V120J0402HQC500NBT | VIIYONG | 0402 | 12pF 50V C0G 0402 Multilayer Ceramic Capacitors MLCC - SMD/SMT ROHS | Multilayer Ceramic Capacitors MLCC - SMD/SMT | 1.There may be multiple types of parts, but one type of part has been matched. Please check.; | C5251212 | https://jlcpcb.com/partdetail/VIIYONG-V120J0402HQC500NBT/C5251212 | Extended | 20 | 20 JLCPCB | 0.106
C40,C45,C54,C68,C33,C48,C64 | 4.7nF | C0402 |  | Select by System | 0402B472K500NT | FH (Guangdong Fenghua Advanced Tech) | 0402 | 4.7nF 50V X7R ±10% 0402 Multilayer Ceramic Capacitors MLCC - SMD/SMT ROHS | Multilayer Ceramic Capacitors MLCC - SMD/SMT |  | C1538 | https://jlcpcb.com/partdetail/1890-0402B472K500NT/C1538 | Basic | 40 | 40 JLCPCB | 0.18
C41,C57,C70 | 1uF | C0402 |  | Select by System | CL05A105KA5NQNC | Samsung Electro-Mechanics | 0402 | 1uF 25V X5R ±10% 0402 Multilayer Ceramic Capacitors MLCC - SMD/SMT ROHS | Multilayer Ceramic Capacitors MLCC - SMD/SMT |  | C52923 | https://jlcpcb.com/partdetail/53938-CL05A105KA5NQNC/C52923 | Basic | 20 | 20 JLCPCB | 0.242
C56,C62,C73 | 3.3nF | C0402 |  | Select by System | CL05B332KB5NNNC | Samsung Electro-Mechanics | 0402 | 3.3nF 50V X7R ±10% 0402 Multilayer Ceramic Capacitors MLCC - SMD/SMT ROHS | Multilayer Ceramic Capacitors MLCC - SMD/SMT |  | C26404 | https://jlcpcb.com/partdetail/27148-CL05B332KB5NNNC/C26404 | Extended | 20 | 20 JLCPCB | 0.134
C58,C69,C74 | 47pF | C0402 |  | Select by System | 0402CG470J500NT | FH (Guangdong Fenghua Advanced Tech) | 0402 | 47pF 50V C0G ±5% 0402 Multilayer Ceramic Capacitors MLCC - SMD/SMT ROHS | Multilayer Ceramic Capacitors MLCC - SMD/SMT |  | C1567 | https://jlcpcb.com/partdetail/1919-0402CG470J500NT/C1567 | Basic | 20 | 20 JLCPCB | 0.17
C75,C76,C77,C79,C80 | 330uF | CAP-SMD_BD6.3-L6.6-W6.6-FD |  | Select by System | RVT0J331M0607 | Honor Elec | SMD,D6.3xL7.7mm | -55℃~+105℃ 2000hrs@105℃ 330uF 6.3V 6.3mm 7.7mm ±20% SMD,D6.3xL7.7mm Aluminum Electrolytic Capacitors - SMD ROHS | Aluminum Electrolytic Capacitors - SMD |  | C58276 | https://jlcpcb.com/partdetail/HonorElec-RVT0J331M0607/C58276 | Extended | 11 | 11 JLCPCB | 0.4774
C81,C83 | 100uF | CAP-SMD_BD10.0-L10.3-W10.3-LS11.0-FD |  | Select by System | MVK 50V100 M 10*10 | SamYoung Electronics | SMD,D10xL10mm | -40℃~+105℃ 100uF 10mm 10mm 2000hrs@105℃ 310mA@120Hz 50V ±20% SMD,D10xL10mm Aluminum Electrolytic Capacitors - SMD ROHS | Aluminum Electrolytic Capacitors - SMD |  | C165627 | https://jlcpcb.com/partdetail/177010-MVK_50V100_M_1010/C165627 | Extended | 5 | 5 JLCPCB | 1.406
C82 | 330uF | CAP-SMD_BD8.0-L8.3-W8.3-FD |  | Select by System | RVT1E331M0810 330UF 25V | DMBJ | SMD,D8xL10.2mm | -55℃~+105℃ 10.2mm 228mA@120Hz 25V 2800hrs@105℃ 330uF 8mm ±20% SMD,D8xL10.2mm Aluminum Electrolytic Capacitors - SMD ROHS | Aluminum Electrolytic Capacitors - SMD |  | C970701 | https://jlcpcb.com/partdetail/DMBJ-RVT1E331M0810_330UF25V/C970701 | Extended | 2 | 2 JLCPCB | 0.1554
C1$CBB7,C1$CBB9/CBB1,C1$CBB9/CBB2,C1$CBB9/CBB3,C1$CBB9/CBB4,C1$CBB9/CBB5,C1$CBB9/CBB6,C1$CBB9/CBB7,C1$CBB9/CBB8,C1$CBB9/CBB9,C1$CBB9/CBB10,C1$CBB9/CBB11,C1$CBB9/CBB12,C1$CBB9/CBB13,C1$CBB9/CBB14,C1$CBB9/CBB15,C1$CBB9/CBB16,C1$CBB9/CBB17,C1$CBB9/CBB18,C1$CBB9/CBB19,C1$CBB9/CBB20,C1$CBB9/CBB21,C1$CBB9/CBB22,C1$CBB9/CBB23,C1$CBB9/CBB24,C1$CBB9/CBB25,C1$CBB9/CBB26,C1$CBB9/CBB27,C1$CBB9/CBB28,C1$CBB9/CBB29,C1$CBB9/CBB30,C1$CBB9/CBB31,C1$CBB9/CBB32,C1$CBB9/CBB33,C1$CBB9/CBB34,C1$CBB9/CBB35,C1$CBB9/CBB36,C1$CBB9/CBB37,C1$CBB9/CBB38,C1$CBB9/CBB39,C1$CBB9/CBB40,C1$CBB9/CBB41,C1$CBB9/CBB42,C1$CBB19/CBB1,C1$CBB19/CBB2,C1$CBB19/CBB3,C1$CBB19/CBB4,C1$CBB19/CBB5,C1$CBB19/CBB6,C1$CBB19/CBB7,C1$CBB19/CBB8,C1$CBB19/CBB9,C1$CBB19/CBB10,C1$CBB19/CBB11,C1$CBB19/CBB12,C1$CBB19/CBB13,C1$CBB19/CBB14,C1$CBB19/CBB15,C1$CBB19/CBB16,C1$CBB19/CBB17,C1$CBB19/CBB18,C1$CBB19/CBB19,C1$CBB19/CBB20,C1$CBB19/CBB21,C1$CBB19/CBB22,C1$CBB19/CBB23,C1$CBB19/CBB24,C1$CBB19/CBB25,C1$CBB19/CBB26,C1$CBB19/CBB27,C1$CBB19/CBB28,C1$CBB19/CBB29,C1$CBB19/CBB30,C1$CBB19/CBB31,C1$CBB19/CBB32,C1$CBB19/CBB33,C1$CBB19/CBB34,C1$CBB19/CBB35,C1$CBB19/CBB36,C1$CBB21,C1$CBB49/CBB1,C1$CBB49/CBB2,C1$CBB49/CBB3,C1$CBB49/CBB4,C1$CBB49/CBB5,C1$CBB49/CBB6,C1$CBB49/CBB7,C1$CBB49/CBB8,C1$CBB49/CBB9,C1$CBB49/CBB10,C1$CBB49/CBB11,C1$CBB49/CBB12,C1$CBB49/CBB13,C1$CBB49/CBB14,C1$CBB49/CBB15,C1$CBB49/CBB16,C1$CBB49/CBB17,C1$CBB49/CBB18,C1$CBB49/CBB19,C1$CBB49/CBB20,C1$CBB49/CBB21,C1$CBB49/CBB22,C1$CBB49/CBB23,C1$CBB49/CBB24,C1$CBB49/CBB25,C1$CB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
C5$CBB7,C5$CBB21,C6$CBB7,C6$CBB21,C8$CBB7,C8$CBB21,C9$CBB7,C9$CBB21,C10$CBB7,C10$CBB21,C11$CBB7,C11$CBB21 | 100pF | C0402 |  | Select by System | 0402CG101J500NT | FH (Guangdong Fenghua Advanced Tech) | 0402 | 100pF 50V C0G ±5% 0402 Multilayer Ceramic Capacitors MLCC - SMD/SMT ROHS | Multilayer Ceramic Capacitors MLCC - SMD/SMT |  | C1546 | https://jlcpcb.com/partdetail/1898-0402CG101J500NT/C1546 | Basic | 34 | 34 JLCPCB | 0.153
D19 | RBR5L60ADDTE25 | SMA_L4.5-W2.6-LS5.0-RD |  | Select by Customer | B260A-13-F | Diodes Incorporated | SMA | -65℃~+150℃ 1 Independent 2A 500uA@60V 50A 60V 700mV@2A SMA Schottky Diodes ROHS | Schottky Diodes |  | C109094 | https://jlcpcb.com/partdetail/DiodesIncorporated-B260A_13F/C109094 | Extended | 5 | 5 JLCPCB | 0.6035
D1$CBB24 | USBLC6-2SC6 | SOT-23-6_L2.9-W1.6-P0.95-LS2.8-BL |  | Select by System | USBLC6-2SC6 | STMicroelectronics | SOT-23-6L | -40℃~+125℃ 150nA 17V 2 3.5pF 5.25V 5A 6V ESD IEC 61000-4-2 Unidirectional SOT-23-6L ESD and Surge Protection (TVS/ESD) ROHS | ESD And Surge Protection (TVS/ESD) |  | C7519 | https://jlcpcb.com/partdetail/STMicroelectronics-USBLC62SC6/C7519 | Extended | 5 | 5 JLCPCB | 0.9125
ETH-LED1,LED1,LED1$CBB15,LED1$CBB22,LED1$CBB23,LED2,LED2$CBB15,LED2$CBB23,LED3,LED3$CBB15,LED3$CBB23,LED4$CBB15,LED4$CBB23,LED5,LED5$CBB15,LED5$CBB23,LED6$CBB15,LED6$CBB23,LED7$CBB15,LED7$CBB23,LED8$CBB15,LED8$CBB23,LED9,LED9$CBB15,LED9$CBB23,LED10$CBB15,LED10$CBB23,LED11$CBB15,LED11$CBB23,LED12$CBB15,LED12$CBB23,LED13$CBB23 | KT-0603R | LED0603-RD |  | Unconfirmed | KT-0603R | Hubei KENTO Elec | 0603 | -40℃~+85℃ 1.6mm x 0.8mm square LED 1.8V~2.4V 120° 20mA 300mcd 40mW 615nm~630nm 645nm Discrete Diode Red Water Clear 0603 LED Indication - Discrete ROHS | LED Indication - Discrete | 1.There may be multiple types of parts, but one type of part has been matched. Please check.; | C2286 | https://jlcpcb.com/partdetail/Hubei_KENTOElec-KT0603R/C2286 | Basic | 74 | 74 JLCPCB | 0.5476
FPC1$CBB22/CBB1,FPC3$CBB22/CBB1 | 522711579 | FPC-SMD_522711579 |  | Select by Customer | 522711579 | MOLEX | P=1mm | -40℃~+85℃ 15P 1mm 500mA 50V Bottom Contact Flip-Top Phosphor bronze Sn-Bi Surface Mount, Right Angle P=1mm FFC, FPC (Flat Flexible) Connector Assemblies ROHS | FFC, FPC (Flat Flexible) Connector Assemblies |  | C7545783 | https://jlcpcb.com/partdetail/MOLEX-522711579/C7545783 | Extended | 4 | 4 My Parts | 0
H1$CBB8,H1$CBB10,H1$CBB11,H1$CBB12,H1$CBB13,H1$CBB14 | PZ254-1-03-Z-8.5 | HDR-TH_03P-P2.54-V-M |  | Select by System | PZ254-1-03-Z-8.5 | HCTL | 插件,P=2.54mm | -40℃~+105℃ 1 1x3P 2.54mm 2.5mm 3A 3P 3mm 6mm Black Brass Square pin Through Hole Plugin,P=2.54mm Pin Headers ROHS | Pin Headers |  | C2894926 | https://jlcpcb.com/partdetail/HCTL-PZ254_1_03_Z_85/C2894926 | Extended | 14 | 14 JLCPCB | 0.539
L1,L4,L5,L7 | 1.5uH | IND-SMD_L7.8-W7.0_GCD75 |  | Select by System | CD75-1R5M 1.5UH | DMBJ | SMD,7.8x7mm | 1.5uH 23mΩ 5.3A Unshielded Inductor ±20% SMD,7.8x7mm Power Inductors ROHS | Power Inductors |  | C2826688 | https://jlcpcb.com/partdetail/DMBJ-CD75_1R5M_15UH/C2826688 | Extended | 9 | 7 My Parts 2 JLCPCB | 0.1502
L2,L3,L6 | 6.8uH | IND-SMD_L6.6-W6.6 |  | Select by System | SMMS0630-6R8M | SXN(Shun Xiang Nuo Elec) | SMD,7.3x6.6mm | 48mΩ 5.1A 6.8uH 6A Molded Inductor ±20% SMD,7.3x6.6mm Molding Power Inductors ROHS | Power Inductors |  | C128690 | https://jlcpcb.com/partdetail/139975-SMMS06306R8M/C128690 | Extended | 7 | 7 JLCPCB | 0.6209
L8 | HR911130C | RJ45-TH_HR911130C |  | Select by System | HR911130C | HANRUN(Zhongshan HanRun Elec) | 弯插 | 0℃~+70℃ 1 Gold Non-PoE Phosphor bronze RJ45 Jack Right Angle Shielded With LED 弯插 Ethernet Connectors / Modular Connectors (RJ45 RJ11) ROHS | Ethernet Connectors / Modular Connectors (RJ45 RJ11) |  | C50933 | https://jlcpcb.com/partdetail/51945-HR911130C/C50933 | Extended | 2 | 2 JLCPCB | 5.6756
L12 | 4.7uH | IND-SMD_L7.8-W7.0_SUMIDA_CD73 |  | Select by Customer | SCD7850DYF4R7M | SOREDE | SMD,7.8x7mm | 30mΩ 4.7uH 5.4A Unshielded Inductor ±20% SMD,7.8x7mm Power Inductors ROHS | Power Inductors |  | C2827444 | https://jlcpcb.com/partdetail/SOREDE-SCD7850DYF4R7M/C2827444 | Extended | 2 | 2 JLCPCB | 0.1668
L13 | APBD2012-152WTD12 | L0805 |  | Select by System | APBD2012-152WTD12 | APV | 0805 | -55℃~+125℃ 1.5kΩ@100MHz 400mΩ 550mA ±25% 0805 Ferrite Beads ROHS |  |  | C50325953 | https://jlcpcb.com/partdetail/APV-APBD2012152WTD12/C50325953 | Extended | 20 | 20 JLCPCB | 0.394
L9$CBB22/CBB4,L10$CBB22/CBB4,L11$CBB22/CBB4,L11$CBB23 | BLM15AX221SN1D | L0402 |  | Unconfirmed | BLM15AX221SN1D | Murata Electronics | 0402 | 1 180mΩ 220Ω@100MHz 600mA ±25% 0402 Ferrite Beads ROHS | Ferrite Beads | 1.There may be multiple types of parts, but one type of part has been matched. Please check.; | C76885 | https://jlcpcb.com/partdetail/MurataElectronics-BLM15AX221SN1D/C76885 | Extended | 20 | 20 JLCPCB | 0.374
Q1$CBB1,Q1$CBB2,Q1$CBB3,Q1$CBB4,Q1$CBB5,Q1$CBB6,Q2$CBB1,Q2$CBB2,Q2$CBB3,Q2$CBB4,Q2$CBB5,Q2$CBB6,Q3$CBB1,Q3$CBB2,Q3$CBB3,Q3$CBB4,Q3$CBB5,Q3$CBB6,Q4$CBB1,Q4$CBB2,Q4$CBB3,Q4$CBB4,Q4$CBB5,Q4$CBB6,Q1$CBB8,Q1$CBB10,Q1$CBB11,Q1$CBB12,Q1$CBB13,Q1$CBB14,Q2$CBB8,Q2$CBB10,Q2$CBB11,Q2$CBB12,Q2$CBB13,Q2$CBB14,Q3$CBB8,Q3$CBB10,Q3$CBB11,Q3$CBB12,Q3$CBB13,Q3$CBB14,Q4$CBB8,Q4$CBB10,Q4$CBB11,Q4$CBB12,Q4$CBB13,Q4$CBB14 | MMBT3904WT1G | SC-70-3_L2.1-W1.3-P1.30-LS2.1-BR |  | Select by System | MMBT3904WT1G | onsemi | SC-70(SOT-323) | -55℃~+150℃ 1 NPN 150mW 200mA 200mV 300MHz 40 40V 50nA 6V NPN SC-70(SOT-323) Bipolar (BJT) ROHS | Bipolar (BJT) |  | C58011 | https://jlcpcb.com/partdetail/onsemi-MMBT3904WT1G/C58011 | Extended | 104 | 104 My Parts | 0
Q1$CBB15,Q2$CBB15,Q3$CBB15,Q4$CBB15,Q5$CBB9/CBB1,Q5$CBB9/CBB2,Q5$CBB9/CBB3,Q5$CBB9/CBB4,Q5$CBB9/CBB5,Q5$CBB9/CBB6,Q5$CBB9/CBB7,Q5$CBB9/CBB8,Q5$CBB9/CBB9,Q5$CBB9/CBB10,Q5$CBB9/CBB11,Q5$CBB9/CBB12,Q5$CBB9/CBB13,Q5$CBB9/CBB14,Q5$CBB9/CBB15,Q5$CBB9/CBB16,Q5$CBB9/CBB17,Q5$CBB9/CBB18,Q5$CBB9/CBB19,Q5$CBB9/CBB20,Q5$CBB9/CBB21,Q5$CBB9/CBB22,Q5$CBB9/CBB23,Q5$CBB9/CBB24,Q5$CBB9/CBB25,Q5$CBB9/CBB26,Q5$CBB9/CBB27,Q5$CBB9/CBB28,Q5$CBB9/CBB29,Q5$CBB9/CBB30,Q5$CBB9/CBB31,Q5$CBB9/CBB32,Q5$CBB9/CBB33,Q5$CBB9/CBB34,Q5$CBB9/CBB35,Q5$CBB9/CBB36,Q5$CBB9/CBB37,Q5$CBB9/CBB38,Q5$CBB9/CBB39,Q5$CBB9/CBB40,Q5$CBB9/CBB41,Q5$CBB9/CBB42,Q5$CBB15,Q5$CBB19/CBB1,Q5$CBB19/CBB2,Q5$CBB19/CBB3,Q5$CBB19/CBB4,Q5$CBB19/CBB5,Q5$CBB19/CBB6,Q5$CBB19/CBB7,Q5$CBB19/CBB8,Q5$CBB19/CBB9,Q5$CBB19/CBB10,Q5$CBB19/CBB11,Q5$CBB19/CBB12,Q5$CBB19/CBB13,Q5$CBB19/CBB14,Q5$CBB19/CBB15,Q5$CBB19/CBB16,Q5$CBB19/CBB17,Q5$CBB19/CBB18,Q5$CBB19/CBB19,Q5$CBB19/CBB20,Q5$CBB19/CBB21,Q5$CBB19/CBB22,Q5$CBB19/CBB23,Q5$CBB19/CBB24,Q5$CBB19/CBB25,Q5$CBB19/CBB26,Q5$CBB19/CBB27,Q5$CBB19/CBB28,Q5$CBB19/CBB29,Q5$CBB19/CBB30,Q5$CBB19/CBB31,Q5$CBB19/CBB32,Q5$CBB19/CBB33,Q5$CBB19/CBB34,Q5$CBB19/CBB35,Q5$CBB19/CBB36,Q5$CBB49/CBB1,Q5$CBB49/CBB2,Q5$CBB49/CBB3,Q5$CBB49/CBB4,Q5$CBB49/CBB5,Q5$CBB49/CBB6,Q5$CBB49/CBB7,Q5$CBB49/CBB8,Q5$CBB49/CBB9,Q5$CBB49/CBB10,Q5$CBB49/CBB11,Q5$CBB49/CBB12,Q5$CBB49/CBB13,Q5$CBB49/CBB14,Q5$CBB49/CBB15,Q5$CBB49/CBB16,Q5$CBB49/CBB17,Q5$CBB49/CBB18,Q5$CBB49/CBB19,Q5$CBB49/CBB20,Q5$CBB49/CBB21,Q5$CBB49/CBB22,Q5$CBB49/CBB23,Q5$CBB4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
Q9$CBB15,Q9$CBB19/CBB1,Q9$CBB19/CBB2,Q9$CBB19/CBB3,Q9$CBB19/CBB4,Q9$CBB19/CBB5,Q9$CBB19/CBB6,Q9$CBB19/CBB7,Q9$CBB19/CBB8,Q9$CBB19/CBB9,Q9$CBB19/CBB10,Q9$CBB19/CBB11,Q9$CBB19/CBB12,Q9$CBB19/CBB13,Q9$CBB19/CBB14,Q9$CBB19/CBB15,Q9$CBB19/CBB16,Q9$CBB19/CBB17,Q9$CBB19/CBB18,Q9$CBB19/CBB19,Q9$CBB19/CBB20,Q9$CBB19/CBB21,Q9$CBB19/CBB22,Q9$CBB19/CBB23,Q9$CBB19/CBB24,Q9$CBB19/CBB25,Q9$CBB19/CBB26,Q9$CBB19/CBB27,Q9$CBB19/CBB28,Q9$CBB19/CBB29,Q9$CBB19/CBB30,Q9$CBB19/CBB31,Q9$CBB19/CBB32,Q9$CBB19/CBB33,Q9$CBB19/CBB34,Q9$CBB19/CBB35,Q9$CBB19/CBB36,Q9$CBB49/CBB1,Q9$CBB49/CBB2,Q9$CBB49/CBB3,Q9$CBB49/CBB4,Q9$CBB49/CBB5,Q9$CBB49/CBB6,Q9$CBB49/CBB7,Q9$CBB49/CBB8,Q9$CBB49/CBB9,Q9$CBB49/CBB10,Q9$CBB49/CBB11,Q9$CBB49/CBB12,Q9$CBB49/CBB13,Q9$CBB49/CBB14,Q9$CBB49/CBB15,Q9$CBB49/CBB16,Q9$CBB49/CBB17,Q9$CBB49/CBB18,Q9$CBB49/CBB19,Q9$CBB49/CBB20,Q9$CBB49/CBB21,Q9$CBB49/CBB22,Q9$CBB49/CBB23,Q9$CBB49/CBB24,Q9$CBB49/CBB25,Q9$CBB49/CBB26,Q9$CBB49/CBB27,Q9$CBB49/CBB28,Q9$CBB49/CBB29,Q9$CBB49/CBB30,Q9$CBB49/CBB31,Q9$CBB49/CBB32,Q9$CBB49/CBB33,Q9$CBB49/CBB34,Q9$CBB49/CBB35,Q9$CBB49/CBB36,Q9$CBB49/CBB37,Q9$CBB49/CBB38,Q9$CBB49/CBB39,Q9$CBB49/CBB40,Q9$CBB49/CBB41,Q9$CBB49/CBB42,Q9$CBB49/CBB43,Q9$CBB49/CBB44,Q9$CBB49/CBB45,Q9$CBB49/CBB46,Q9$CBB49/CBB47,Q9$CBB49/CBB48,Q10$CBB15,Q11$CBB15,Q12$CBB15 | DOX3134A | SOT-323-3_L2.1-W1.3-P1.30-LS2.3-BR |  | Select by Customer | DOX3134A | DOINGTER | SOT-323 | -50℃~+150℃ 1 N-channel 120Ω@4.5V 12pF 1nC@4.5V 20V 220mW 23pF 600mV 63pF 900mA N-Channel SOT-323 MOSFETs ROHS |  | 1.There may be multiple types of parts, but one type of part has been matched. Please check.; | C54349756 | https://jlcpcb.com/partdetail/DOINGTER-DOX3134A/C54349756 | Extended | 1036 | 1036 My Parts | 0
Q1$CBB23,Q2$CBB23,Q3$CBB23,Q4$CBB23 | DO2320AA | SOT-23-3_L2.9-W1.6-P1.90-LS2.8-BR |  | Select by System | DO2320AA | DOINGTER | SOT-23-3 | -55℃~+150℃ 1 N-channel 1.2V 1.5W 14mΩ@4.5V 155pF 15nC@4.5V 175pF 20V 8A 950pF N-Channel SOT-23-3 MOSFETs ROHS | MOSFETs |  | C47018574 | https://jlcpcb.com/partdetail/DOINGTER-DO2320AA/C47018574 | Extended | 8 | 8 JLCPCB | 0.3528
Q1$CBB22/CBB1,Q2$CBB22/CBB1 | BSS138 | SOT-23-3_L2.9-W1.3-P1.90-LS2.4-BR-1 |  | Select by System | BSS138 | KUU | SOT-23 | -55℃~+150℃ 1 N-channel 1.6V 220mA 225mW 25pF 50V 50pF 6Ω@4.5V N-Channel SOT-23 MOSFETs ROHS | MOSFETs |  | C3015220 | https://jlcpcb.com/partdetail/KUU-BSS138/C3015220 | Extended | 10 | 10 JLCPCB | 0.192
R2,R4,R5,R7,R8,R10,R11,R13,R14,R16,R17,R19,R20,R22,R23,R25,R26,R28,R29,R31,R32,R34,R35,R37,R38,R40,R41,R43,R44,R63,R74,R80,R81,R83,R84,R86,R87,R89,R90,R92,R93,R95,R97,R99,R100,R102,R103,R105,R106,R108,R109,R111,R112,R114,R115,R117,R118,R120,R121,R123 | 120Ω | R0402 |  | Select by System | 0402WGF1200TCE | UNI-ROYAL(Uniroyal Elec) | 0402 | -55℃~+155℃ 120Ω 50V 62.5mW Thick Film Resistor ±1% ±100ppm/℃ 0402 Chip Resistor - Surface Mount ROHS | Chip Resistor - Surface Mount |  | C25079 | https://jlcpcb.com/partdetail/25822-0402WGF1200TCE/C25079 | Basic | 130 | 130 JLCPCB | 0.507
R3,R6,R9,R12,R15,R18,R21,R24,R27,R30,R33,R36,R39,R42,R62,R79,R82,R85,R88,R91,R94,R98,R101,R104,R107,R110,R113,R116,R119,R122 | 68Ω | R0402 |  | Select by System | 0402WGJ0680TCE | UNI-ROYAL(Uniroyal Elec) | 0402 | -55℃~+155℃ 50V 62.5mW 68Ω Thick Film Resistor ±100ppm/℃ ±5% 0402 Chip Resistor - Surface Mount ROHS | Chip Resistor - Surface Mount |  | C25178 | https://jlcpcb.com/partdetail/25921-0402WGJ0680TCE/C25178 | Extended | 70 | 70 JLCPCB | 0.07
R45,R65,R148,R158$CBB22,R158$CBB23,R159$CBB23,R164$CBB22/CBB2,R174$CBB22/CBB2 | 0Ω | R0402 |  | Unconfirmed | 0402WGF0000TCE | UNI-ROYAL(Uniroyal Elec) | 0402 | -55℃~+155℃ 0Ω 50V 62.5mW Thick Film Resistor ±1% ±800ppm/℃ 0402 Chip Resistor - Surface Mount ROHS | Chip Resistor - Surface Mount | 1.There may be multiple types of parts, but one type of part has been matched. Please check.; | C17168 | https://jlcpcb.com/partdetail/17853-0402WGF0000TCE/C17168 | Basic | 40 | 40 JLCPCB | 0.112
R46 | 6.49kΩ | R0402 |  | Select by System | RT0402BRE076K49L | YAGEO | 0402 | -55℃~+155℃ 50V 6.49kΩ 62.5mW Thin Film Resistor ±0.1% ±50ppm/℃ 0402 Chip Resistor - Surface Mount ROHS | Chip Resistor - Surface Mount |  | C853380 | https://jlcpcb.com/partdetail/YAGEO-RT0402BRE076K49L/C853380 | Extended | 20 | 20 JLCPCB | 0.488
R52,R136,R138 | 15kΩ | R0402 |  | Select by System | 0402WGF1502TCE | UNI-ROYAL(Uniroyal Elec) | 0402 | -55℃~+155℃ 15kΩ 50V 62.5mW Thick Film Resistor ±1% ±100ppm/℃ 0402 Chip Resistor - Surface Mount ROHS | Chip Resistor - Surface Mount |  | C25756 | https://jlcpcb.com/partdetail/26499-0402WGF1502TCE/C25756 | Basic | 20 | 20 JLCPCB | 0.072
R53,R128,R140 | 560kΩ | R0402 |  | Select by System | 0402WGF5603TCE | UNI-ROYAL(Uniroyal Elec) | 0402 | -55℃~+155℃ 50V 560kΩ 62.5mW Thick Film Resistor ±1% ±100ppm/℃ 0402 Chip Resistor - Surface Mount ROHS | Chip Resistor - Surface Mount |  | C132339 | https://jlcpcb.com/partdetail/143638-0402WGF5603TCE/C132339 | Extended | 20 | 20 JLCPCB | 0.018
R55 | 8.2kΩ | R0402 |  | Select by System | CR0402FF8201G | LIZ Elec | 0402 | -55℃~+125℃ 50V 62.5mW 8.2kΩ Thick Film Resistor ±1% ±200ppm/℃ 0402 Chip Resistor - Surface Mount ROHS | Chip Resistor - Surface Mount |  | C100538 | https://jlcpcb.com/partdetail/LIZElec-CR0402FF8201G/C100538 | Extended | 20 | 20 JLCPCB | 0.096
R56,R129,R143 | 40.2kΩ | R0402 |  | Select by System | 0402WGF4022TCE | UNI-ROYAL(Uniroyal Elec) | 0402 | -55℃~+155℃ 40.2kΩ 50V 62.5mW Thick Film Resistor ±1% ±100ppm/℃ 0402 Chip Resistor - Surface Mount ROHS | Chip Resistor - Surface Mount |  | C25893 | https://jlcpcb.com/partdetail/26636-0402WGF4022TCE/C25893 | Extended | 20 | 20 JLCPCB | 0.014
R57 | 24kΩ | R0402 |  | Select by Customer | RC0402FR-0724KL | YAGEO | 0402 | -55℃~+155℃ 24kΩ 50V 62.5mW Thick Film Resistor ±1% ±100ppm/℃ 0402 Chip Resistor - Surface Mount ROHS | Chip Resistor - Surface Mount |  | C138026 | https://jlcpcb.com/partdetail/YAGEO-RC0402FR0724KL/C138026 | Extended | 20 | 20 JLCPCB | 0.038
R58,R58$CBB23,R132,R146 | 0Ω | R1210 |  | Unconfirmed | RS-1210000JT | FH (Guangdong Fenghua Advanced Tech) | 1210 | -55℃~+155℃ 0Ω 200V 333mW Thick Film Resistor ±5% 1210 Chip Resistor - Surface Mount ROHS | Chip Resistor - Surface Mount | 1.There may be multiple types of parts, but one type of part has been matched. Please check.; | C140000 | https://jlcpcb.com/partdetail/151326-RS1210000JT/C140000 | Extended | 18 | 18 JLCPCB | 0.2286
R59 | 19.1kΩ | R0402 |  | Select by System | 0402WGF1912TCE | UNI-ROYAL(Uniroyal Elec) | 0402 | -55℃~+155℃ 19.1kΩ 50V 62.5mW Thick Film Resistor ±1% ±100ppm/℃ 0402 Chip Resistor - Surface Mount ROHS | Chip Resistor - Surface Mount |  | C52036 | https://jlcpcb.com/partdetail/53049-0402WGF1912TCE/C52036 | Extended | 20 | 20 JLCPCB | 0.05
R60,R131 | 36kΩ | R0402 |  | Select by System | 0402WGJ0363TCE | UNI-ROYAL(Uniroyal Elec) | 0402 | -55℃~+155℃ 36kΩ 50V 62.5mW Thick Film Resistor ±100ppm/℃ ±5% 0402 Chip Resistor - Surface Mount ROHS | Chip Resistor - Surface Mount |  | C25556 | https://jlcpcb.com/partdetail/26299-0402WGJ0363TCE/C25556 | Extended | 20 | 20 JLCPCB | 0.052
R125 | 43kΩ | R0402 |  | Select by System | 0402WGJ0433TCE | UNI-ROYAL(Uniroyal Elec) | 0402 | -55℃~+155℃ 43kΩ 50V 62.5mW Thick Film Resistor ±100ppm/℃ ±5% 0402 Chip Resistor - Surface Mount ROHS | Chip Resistor - Surface Mount |  | C25561 | https://jlcpcb.com/partdetail/26304-0402WGJ0433TCE/C25561 | Extended | 20 | 20 JLCPCB | 0.054
R126,R147 | 82kΩ | R0402 |  | Select by System | 0402WGF8202TCE | UNI-ROYAL(Uniroyal Elec) | 0402 | -55℃~+155℃ 50V 62.5mW 82kΩ Thick Film Resistor ±1% ±100ppm/℃ 0402 Chip Resistor - Surface Mount ROHS | Chip Resistor - Surface Mount |  | C4142 | https://jlcpcb.com/partdetail/4549-0402WGF8202TCE/C4142 | Extended | 20 | 20 JLCPCB | 0.038
R127,R219$CBB24 | 12kΩ | R0402 |  | Unconfirmed | 0402WGJ0123TCE | UNI-ROYAL(Uniroyal Elec) | 0402 | -55℃~+155℃ 12kΩ 50V 62.5mW Thick Film Resistor ±100ppm/℃ ±5% 0402 Chip Resistor - Surface Mount ROHS | Chip Resistor - Surface Mount | 1.There may be multiple types of parts, but one type of part has been matched. Please check.; | C25535 | https://jlcpcb.com/partdetail/26278-0402WGJ0123TCE/C25535 | Extended | 20 | 20 JLCPCB | 0.014
R133 | 32.4kΩ | R0402 |  | Select by System | 0402WGF3242TCE | UNI-ROYAL(Uniroyal Elec) | 0402 | -55℃~+155℃ 32.4kΩ 50V 62.5mW Thick Film Resistor ±1% ±100ppm/℃ 0402 Chip Resistor - Surface Mount ROHS | Chip Resistor - Surface Mount |  | C26974 | https://jlcpcb.com/partdetail/27723-0402WGF3242TCE/C26974 | Extended | 20 | 20 JLCPCB | 0.054
R141,R144,R150,R151 | 68kΩ | R0402 |  | Select by System | 0402WGF6802TCE | UNI-ROYAL(Uniroyal Elec) | 0402 | -55℃~+155℃ 50V 62.5mW 68kΩ Thick Film Resistor ±1% ±100ppm/℃ 0402 Chip Resistor - Surface Mount ROHS | Chip Resistor - Surface Mount |  | C36871 | https://jlcpcb.com/partdetail/37849-0402WGF6802TCE/C36871 | Extended | 20 | 20 JLCPCB | 0.044
R145 | 75kΩ | R0402 |  | Select by System | 0402WGF7502TCE | UNI-ROYAL(Uniroyal Elec) | 0402 | -55℃~+155℃ 50V 62.5mW 75kΩ Thick Film Resistor ±1% ±100ppm/℃ 0402 Chip Resistor - Surface Mount ROHS | Chip Resistor - Surface Mount |  | C25798 | https://jlcpcb.com/partdetail/26541-0402WGF7502TCE/C25798 | Extended | 20 | 20 JLCPCB | 0.06
R1$CBB1,R1$CBB2,R1$CBB3,R1$CBB4,R1$CBB5,R1$CBB6 | 300Ω | R0402 |  | Select by System | 0402WGF3000TCE | UNI-ROYAL(Uniroyal Elec) | 0402 | -55℃~+155℃ 300Ω 50V 62.5mW Thick Film Resistor ±1% ±100ppm/℃ 0402 Chip Resistor - Surface Mount ROHS | Chip Resistor - Surface Mount |  | C25102 | https://jlcpcb.com/partdetail/25845-0402WGF3000TCE/C25102 | Extended | 22 | 22 JLCPCB | 0.0462
R1$CBB7,R1$CBB21,R2$CBB7,R2$CBB21,R3$CBB7,R3$CBB9,R3$CBB21,R3$CBB49,R4$CBB7,R4$CBB9,R4$CBB21,R4$CBB49,R5$CBB7,R5$CBB9,R5$CBB21,R5$CBB49,R6$CBB7,R6$CBB9,R6$CBB21,R6$CBB49,R7$CBB9,R7$CBB49,R8$CBB9,R8$CBB49,R9$CBB9,R9$CBB49,R10$CBB1,R10$CBB2,R10$CBB3,R10$CBB4,R10$CBB5,R10$CBB6,R10$CBB9,R10$CBB49,R11$CBB9,R11$CBB49,R12$CBB9,R12$CBB49,R13$CBB9,R13$CBB49,R14$CBB9,R14$CBB49,R3$CBB19,R4$CBB19,R5$CBB19,R6$CBB19,R7$CBB19,R8$CBB19,R9$CBB19,R10$CBB8,R10$CBB10,R10$CBB11,R10$CBB12,R10$CBB13,R10$CBB14,R10$CBB19,R11$CBB19,R12$CBB19,R13$CBB19,R14$CBB19 | 100Ω | R0402 |  | Select by System | 0402WGF1000TCE | UNI-ROYAL(Uniroyal Elec) | 0402 | -55℃~+155℃ 100Ω 50V 62.5mW Thick Film Resistor ±1% ±100ppm/℃ 0402 Chip Resistor - Surface Mount ROHS | Chip Resistor - Surface Mount |  | C25076 | https://jlcpcb.com/partdetail/25819-0402WGF1000TCE/C25076 | Basic | 140 | 140 JLCPCB | 0.518
R1$CBB15,R4$CBB1,R4$CBB2,R4$CBB3,R4$CBB4,R4$CBB5,R4$CBB6,R5$CBB1,R5$CBB2,R5$CBB3,R5$CBB4,R5$CBB5,R5$CBB6,R5$CBB15,R6$CBB1,R6$CBB2,R6$CBB3,R6$CBB4,R6$CBB5,R6$CBB6,R7$CBB1,R7$CBB2,R7$CBB3,R7$CBB4,R7$CBB5,R7$CBB6,R9$CBB1,R9$CBB2,R9$CBB3,R9$CBB4,R9$CBB5,R9$CBB6,R9$CBB15,R13$CBB15,R85$CBB15,R86$CBB15,R89$CBB15,R90$CBB15,R93$CBB15,R94$CBB15,R97$CBB15,R98$CBB15,R101$CBB15,R102$CBB15,R105$CBB15,R106$CBB15,R109$CBB15,R113$CBB15,R218$CBB24,R4$CBB8,R4$CBB10,R4$CBB11,R4$CBB12,R4$CBB13,R4$CBB14,R5$CBB8,R5$CBB10,R5$CBB11,R5$CBB12,R5$CBB13,R5$CBB14,R6$CBB8,R6$CBB10,R6$CBB11,R6$CBB12,R6$CBB13,R6$CBB14,R7$CBB8,R7$CBB10,R7$CBB11,R7$CBB12,R7$CBB13,R7$CBB14,R9$CBB8,R9$CBB10,R9$CBB11,R9$CBB12,R9$CBB13,R9$CBB14,R13$CBB8,R13$CBB10,R13$CBB11,R13$CBB12,R13$CBB13,R13$CBB14,R15$CBB8,R15$CBB10,R15$CBB11,R15$CBB12,R15$CBB13,R15$CBB14 | 1kΩ | R0402 |  | Select by System | 0402WGF1001TCE | UNI-ROYAL(Uniroyal Elec) | 0402 | -55℃~+155℃ 1kΩ 50V 62.5mW Thick Film Resistor ±1% ±100ppm/℃ 0402 Chip Resistor - Surface Mount ROHS | Chip Resistor - Surface Mount |  | C11702 | https://jlcpcb.com/partdetail/12256-0402WGF1001TCE/C11702 | Basic | 202 | 202 JLCPCB | 0.7878
R1$CBB22,R10$CBB15,R11$CBB15,R12$CBB15,R12$CBB23,R13$CBB23,R14$CBB15,R14$CBB23,R15$CBB15,R15$CBB23,R16$CBB15,R16$CBB23,R17$CBB15,R17$CBB23,R18$CBB15,R18$CBB23,R19$CBB15,R19$CBB23,R20$CBB15,R20$CBB23,R21$CBB15,R22$CBB15,R31$CBB23,R32$CBB23,R33$CBB23,R34$CBB23,R49,R51,R54,R61,R95$CBB22,R168$CBB22/CBB2,R260$CBB22,R166$CBB22/CBB2 | 470Ω | R0402 |  | Unconfirmed | 0402WGF4700TCE | UNI-ROYAL(Uniroyal Elec) | 0402 | -55℃~+155℃ 470Ω 50V 62.5mW Thick Film Resistor ±1% ±100ppm/℃ 0402 Chip Resistor - Surface Mount ROHS | Chip Resistor - Surface Mount | 1.There may be multiple types of parts, but one type of part has been matched. Please check.; | C25117 | https://jlcpcb.com/partdetail/25860-0402WGF4700TCE/C25117 | Basic | 96 | 96 JLCPCB | 0.3168
R1$CBB23,R2$CBB23,R3$CBB23,R4$CBB23,R5$CBB23,R6$CBB23,R11$CBB23,R23$CBB23,R24$CBB23,R25$CBB23,R26$CBB23,R66,R67,R68,R71,R124,R139,R211$CBB24,R220$CBB24,R222$CBB24,R253$CBB22,R7$CBB23,R69,R70,R181$CBB24,R213$CBB24,R214$CBB24,R252$CBB22 | 10kΩ | R0402 |  | Unconfirmed | 0402WGF1002TCE | UNI-ROYAL(Uniroyal Elec) | 0402 | -55℃~+155℃ 10kΩ 50V 62.5mW Thick Film Resistor ±1% ±100ppm/℃ 0402 Chip Resistor - Surface Mount ROHS | Chip Resistor - Surface Mount | 1.There may be multiple types of parts, but one type of part has been matched. Please check.; | C25744 | https://jlcpcb.com/partdetail/26487-0402WGF1002TCE/C25744 | Basic | 76 | 76 JLCPCB | 0.2356
R1$CBB16/CBB1,R1$CBB16/CBB2,R1$CBB16/CBB3,R1$CBB16/CBB4,R1$CBB16/CBB5,R1$CBB16/CBB6,R1$CBB17/CBB1,R1$CBB17/CBB2,R1$CBB17/CBB3,R1$CBB17/CBB4,R1$CBB17/CBB5,R1$CBB17/CBB6,R1$CBB17/CBB7,R1$CBB17/CBB8,R1$CBB18/CBB1,R1$CBB18/CBB2,R1$CBB18/CBB3,R1$CBB18/CBB4,R1$CBB18/CBB5,R1$CBB18/CBB6,R1$CBB18/CBB7,R1$CBB18/CBB8,R1$CBB20/CBB1,R1$CBB20/CBB2,R1$CBB20/CBB3,R1$CBB20/CBB4,R1$CBB20/CBB5,R1$CBB20/CBB6,R1$CBB20/CBB7,R1$CBB20/CBB8,R3$CBB16/CBB1,R3$CBB16/CBB2,R3$CBB16/CBB3,R3$CBB16/CBB4,R3$CBB16/CBB5,R3$CBB16/CBB6,R3$CBB17/CBB1,R3$CBB17/CBB2,R3$CBB17/CBB3,R3$CBB17/CBB4,R3$CBB17/CBB5,R3$CBB17/CBB6,R3$CBB17/CBB7,R3$CBB17/CBB8,R3$CBB18/CBB1,R3$CBB18/CBB2,R3$CBB18/CBB3,R3$CBB18/CBB4,R3$CBB18/CBB5,R3$CBB18/CBB6,R3$CBB18/CBB7,R3$CBB18/CBB8,R3$CBB20/CBB1,R3$CBB20/CBB2,R3$CBB20/CBB3,R3$CBB20/CBB4,R3$CBB20/CBB5,R3$CBB20/CBB6,R3$CBB20/CBB7,R3$CBB20/CBB8,R4$CBB16/CBB1,R4$CBB16/CBB2,R4$CBB16/CBB3,R4$CBB16/CBB4,R4$CBB16/CBB5,R4$CBB16/CBB6,R4$CBB17/CBB1,R4$CBB17/CBB2,R4$CBB17/CBB3,R4$CBB17/CBB4,R4$CBB17/CBB5,R4$CBB17/CBB6,R4$CBB17/CBB7,R4$CBB17/CBB8,R4$CBB18/CBB1,R4$CBB18/CBB2,R4$CBB18/CBB3,R4$CBB18/CBB4,R4$CBB18/CBB5,R4$CBB18/CBB6,R4$CBB18/CBB7,R4$CBB18/CBB8,R4$CBB20/CBB1,R4$CBB20/CBB2,R4$CBB20/CBB3,R4$CBB20/CBB4,R4$CBB20/CBB5,R4$CBB20/CBB6,R4$CBB20/CBB7,R4$CBB20/CBB8,R5$CBB16/CBB1,R5$CBB16/CBB2,R5$CBB16/CBB3,R5$CBB16/CBB4,R5$CBB16/CBB5,R5$CBB16/CBB6,R5$CBB17/CBB1,R5$CBB17/CBB2,R5$CBB17/CBB3,R5$CBB17/CBB4,R5$CBB17/CBB5,R5$CBB17/CBB6,R5$CBB17/CBB7,R5$CBB17/CBB8,R5$CBB18/CBB1,R5$CBB18/CBB2,R5$CBB18/CBB3,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
R2$CBB16/CBB1,R2$CBB16/CBB2,R2$CBB16/CBB3,R2$CBB16/CBB4,R2$CBB16/CBB5,R2$CBB16/CBB6,R2$CBB17/CBB1,R2$CBB17/CBB2,R2$CBB17/CBB3,R2$CBB17/CBB4,R2$CBB17/CBB5,R2$CBB17/CBB6,R2$CBB17/CBB7,R2$CBB17/CBB8,R2$CBB18/CBB1,R2$CBB18/CBB2,R2$CBB18/CBB3,R2$CBB18/CBB4,R2$CBB18/CBB5,R2$CBB18/CBB6,R2$CBB18/CBB7,R2$CBB18/CBB8,R2$CBB20/CBB1,R2$CBB20/CBB2,R2$CBB20/CBB3,R2$CBB20/CBB4,R2$CBB20/CBB5,R2$CBB20/CBB6,R2$CBB20/CBB7,R2$CBB20/CBB8,R10$CBB16/CBB1,R10$CBB16/CBB2,R10$CBB16/CBB3,R10$CBB16/CBB4,R10$CBB16/CBB5,R10$CBB16/CBB6,R10$CBB17/CBB1,R10$CBB17/CBB2,R10$CBB17/CBB3,R10$CBB17/CBB4,R10$CBB17/CBB5,R10$CBB17/CBB6,R10$CBB17/CBB7,R10$CBB17/CBB8,R10$CBB18/CBB1,R10$CBB18/CBB2,R10$CBB18/CBB3,R10$CBB18/CBB4,R10$CBB18/CBB5,R10$CBB18/CBB6,R10$CBB18/CBB7,R10$CBB18/CBB8,R10$CBB20/CBB1,R10$CBB20/CBB2,R10$CBB20/CBB3,R10$CBB20/CBB4,R10$CBB20/CBB5,R10$CBB20/CBB6,R10$CBB20/CBB7,R10$CBB20/CBB8,R11$CBB16/CBB1,R11$CBB16/CBB2,R11$CBB16/CBB3,R11$CBB16/CBB4,R11$CBB16/CBB5,R11$CBB16/CBB6,R11$CBB17/CBB1,R11$CBB17/CBB2,R11$CBB17/CBB3,R11$CBB17/CBB4,R11$CBB17/CBB5,R11$CBB17/CBB6,R11$CBB17/CBB7,R11$CBB17/CBB8,R11$CBB18/CBB1,R11$CBB18/CBB2,R11$CBB18/CBB3,R11$CBB18/CBB4,R11$CBB18/CBB5,R11$CBB18/CBB6,R11$CBB18/CBB7,R11$CBB18/CBB8,R11$CBB20/CBB1,R11$CBB20/CBB2,R11$CBB20/CBB3,R11$CBB20/CBB4,R11$CBB20/CBB5,R11$CBB20/CBB6,R11$CBB20/CBB7,R11$CBB20/CBB8,R12$CBB16/CBB1,R12$CBB16/CBB2,R12$CBB16/CBB3,R12$CBB16/CBB4,R12$CBB16/CBB5,R12$CBB16/CBB6,R12$CBB17/CBB1,R12$CBB17/CBB2,R12$CBB17/CBB3,R12$CBB17/CBB4,R12$CBB17/CBB5,R12$CBB17/CBB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 | 10kΩ | R0402 |  | Select by System | RT0402BRD0710KL | YAGEO | 0402 | -55℃~+155℃ 10kΩ 50V 62.5mW Thin Film Resistor ±0.1% ±25ppm/℃ 0402 Chip Resistor - Surface Mount ROHS | Chip Resistor - Surface Mount |  | C190095 | https://jlcpcb.com/partdetail/YAGEO-RT0402BRD0710KL/C190095 | Extended | 428 | 428 My Parts | 0
R14$CBB1,R14$CBB2,R14$CBB3,R14$CBB4,R14$CBB5,R14$CBB6 | 270Ω | R0402 |  | Select by System | CRCW0402270RFKED | Vishay Intertech | 0402 | -55℃~+155℃ 270Ω 50V 62.5mW Thick Film Resistor ±1% ±100ppm/℃ 0402 Chip Resistor - Surface Mount ROHS | Chip Resistor - Surface Mount |  | C482120 | https://jlcpcb.com/partdetail/VishayIntertech-CRCW0402270RFKED/C482120 | Extended | 22 | 22 JLCPCB | 0.1254
R2$CBB1,R2$CBB2,R2$CBB3,R2$CBB4,R2$CBB5,R2$CBB6,R2$CBB8,R2$CBB10,R2$CBB11,R2$CBB12,R2$CBB13,R2$CBB14 | 1.2kΩ | R0402 |  | Select by System | 0402WGF1201TCE | UNI-ROYAL(Uniroyal Elec) | 0402 | -55℃~+155℃ 1.2kΩ 50V 62.5mW Thick Film Resistor ±1% ±100ppm/℃ 0402 Chip Resistor - Surface Mount ROHS | Chip Resistor - Surface Mount |  | C25862 | https://jlcpcb.com/partdetail/26605-0402WGF1201TCE/C25862 | Extended | 44 | 44 JLCPCB | 0.1144
R2$CBB15,R3$CBB15,R4$CBB15,R6$CBB15,R7$CBB15,R8$CBB15 | 3.9kΩ | R0402 |  | Select by System | 0402WGF3901TCE | UNI-ROYAL(Uniroyal Elec) | 0402 | -55℃~+155℃ 3.9kΩ 50V 62.5mW Thick Film Resistor ±1% ±100ppm/℃ 0402 Chip Resistor - Surface Mount ROHS | Chip Resistor - Surface Mount |  | C51721 | https://jlcpcb.com/partdetail/52734-0402WGF3901TCE/C51721 | Extended | 22 | 22 JLCPCB | 0.055
R215$CBB24,R217$CBB24 | 10Ω | R0402 |  | Select by System | 0402WGF100JTCE | UNI-ROYAL(Uniroyal Elec) | 0402 | -55℃~+155℃ 10Ω 50V 62.5mW Thick Film Resistor ±1% ±200ppm/℃ 0402 Chip Resistor - Surface Mount ROHS | Chip Resistor - Surface Mount |  | C25077 | https://jlcpcb.com/partdetail/25820-0402WGF100JTCE/C25077 | Basic | 20 | 20 JLCPCB | 0.058
R22$CBB23,R96,R135,R149,R21$CBB23,R77,R182$CBB23 | 22Ω | R0402 |  | Unconfirmed | 0402WGF220JTCE | UNI-ROYAL(Uniroyal Elec) | 0402 | -55℃~+155℃ 22Ω 50V 62.5mW Thick Film Resistor ±1% ±100ppm/℃ 0402 Chip Resistor - Surface Mount ROHS | Chip Resistor - Surface Mount | 1.There may be multiple types of parts, but one type of part has been matched. Please check.; | C25092 | https://jlcpcb.com/partdetail/25835-0402WGF220JTCE/C25092 | Basic | 40 | 40 JLCPCB | 0.132
R27$CBB23,R28$CBB23,R29$CBB23,R30$CBB23 | 33Ω | R2512 |  | Select by System | CRH2512F33R0E04Z | Ever Ohms Tech | 2512 | -55℃~+155℃ 200V 2W 33Ω Thick Film Resistor ±1% ±100ppm/℃ 2512 Chip Resistor - Surface Mount ROHS | Chip Resistor - Surface Mount |  | C175260 | https://jlcpcb.com/partdetail/Ever_OhmsTech-CRH2512F33R0E04Z/C175260 | Extended | 12 | 12 JLCPCB | 0.702
R3$CBB1,R3$CBB2,R3$CBB3,R3$CBB4,R3$CBB5,R3$CBB6,R8$CBB1,R8$CBB2,R8$CBB3,R8$CBB4,R8$CBB5,R8$CBB6,R3$CBB8,R3$CBB10,R3$CBB11,R3$CBB12,R3$CBB13,R3$CBB14,R8$CBB8,R8$CBB10,R8$CBB11,R8$CBB12,R8$CBB13,R8$CBB14 | 910Ω | R0402 |  | Select by Customer | 0402WGF9100TCE | UNI-ROYAL(Uniroyal Elec) | 0402 | -55℃~+155℃ 50V 62.5mW 910Ω Thick Film Resistor ±1% ±100ppm/℃ 0402 Chip Resistor - Surface Mount ROHS | Chip Resistor - Surface Mount |  | C44933 | https://jlcpcb.com/partdetail/45935-0402WGF9100TCE/C44933 | Extended | 68 | 68 JLCPCB | 0.1292
R32$CBB16,R98$CBB16,R100$CBB16,R102$CBB16,R104$CBB16,R106$CBB16,R134,R142 | 1.5kΩ | R0402 |  | Unconfirmed | 0402WGF1501TCE | UNI-ROYAL(Uniroyal Elec) | 0402 | -55℃~+155℃ 1.5kΩ 50V 62.5mW Thick Film Resistor ±1% ±100ppm/℃ 0402 Chip Resistor - Surface Mount ROHS | Chip Resistor - Surface Mount | 1.There may be multiple types of parts, but one type of part has been matched. Please check.; | C25867 | https://jlcpcb.com/partdetail/26610-0402WGF1501TCE/C25867 | Basic | 26 | 26 JLCPCB | 0.0806
R32$CBB17,R32$CBB18,R32$CBB20,R64$CBB17,R64$CBB18,R64$CBB20,R96$CBB17,R96$CBB18,R96$CBB20,R128$CBB17,R128$CBB18,R128$CBB20,R130$CBB17,R130$CBB18,R130$CBB20,R132$CBB17,R132$CBB18,R132$CBB20,R134$CBB17,R134$CBB18,R134$CBB20,R136$CBB17,R136$CBB20 | 51kΩ | R0402 |  | Select by System | 0402WGF5102TCE | UNI-ROYAL(Uniroyal Elec) | 0402 | -55℃~+155℃ 50V 51kΩ 62.5mW Thick Film Resistor ±1% ±100ppm/℃ 0402 Chip Resistor - Surface Mount ROHS | Chip Resistor - Surface Mount |  | C25794 | https://jlcpcb.com/partdetail/26537-0402WGF5102TCE/C25794 | Basic | 56 | 56 JLCPCB | 0.1064
R48$CBB16,R99$CBB16,R101$CBB16,R103$CBB16,R105$CBB16,R107$CBB16,R212$CBB24 | 1.8kΩ | R0402 |  | Select by System | 0402WGF1801TCE | UNI-ROYAL(Uniroyal Elec) | 0402 | -55℃~+155℃ 1.8kΩ 50V 62.5mW Thick Film Resistor ±1% ±100ppm/℃ 0402 Chip Resistor - Surface Mount ROHS | Chip Resistor - Surface Mount |  | C25871 | https://jlcpcb.com/partdetail/26614-0402WGF1801TCE/C25871 | Extended | 24 | 24 JLCPCB | 0.0624
R51$CBB23,R78,R183$CBB22 | 12kΩ | R0402 |  | Unconfirmed | 0402WGF1202TCE | UNI-ROYAL(Uniroyal Elec) | 0402 | -55℃~+155℃ 12kΩ 50V 62.5mW Thick Film Resistor ±1% ±100ppm/℃ 0402 Chip Resistor - Surface Mount ROHS | Chip Resistor - Surface Mount | 1.There may be multiple types of parts, but one type of part has been matched. Please check.; | C25752 | https://jlcpcb.com/partdetail/26495-0402WGF1202TCE/C25752 | Basic | 40 | 40 JLCPCB | 0.148
R96$CBB16,R1,R64,R64$CBB16 | 20kΩ | R0402 |  | Unconfirmed | 0402WGF2002TCE | UNI-ROYAL(Uniroyal Elec) | 0402 | -55℃~+155℃ 20kΩ 50V 62.5mW Thick Film Resistor ±1% ±100ppm/℃ 0402 Chip Resistor - Surface Mount ROHS | Chip Resistor - Surface Mount | 1.There may be multiple types of parts, but one type of part has been matched. Please check.; | C25765 | https://jlcpcb.com/partdetail/26508-0402WGF2002TCE/C25765 | Basic | 40 | 40 JLCPCB | 0.096
R97$CBB16,R80$CBB16 | 27kΩ | R0402 |  | Select by System | 0402WGF2702TCE | UNI-ROYAL(Uniroyal Elec) | 0402 | -55℃~+155℃ 27kΩ 50V 62.5mW Thick Film Resistor ±1% ±100ppm/℃ 0402 Chip Resistor - Surface Mount ROHS | Chip Resistor - Surface Mount |  | C25771 | https://jlcpcb.com/partdetail/26514-0402WGF2702TCE/C25771 | Extended | 40 | 40 JLCPCB | 0.088
U1,U1$CBB22,U1$CBB24,U2,U2$CBB24,U93$CBB23,U93$CBB24,U110$CBB24,U111$CBB24,U112$CBB22,U112$CBB24 | PZ2.54-2*4 | HDR-TH_8P-P2.54-V-M-R2-C4-S2.54 |  | Unconfirmed | PZ2.54-2*4 | ZHOURI | 插件,P=2.54mm | 2 2.54mm 2x4P 8P 插件,P=2.54mm Pin Headers ROHS | Pin Headers | 1.There may be multiple types of parts, but one type of part has been matched. Please check.; | C5156676 | https://jlcpcb.com/partdetail/ZHOURI-PZ2_54_24/C5156676 | Extended | 22 | 22 JLCPCB | 1.0472
U3 | KF301-5.0-2P | CONN-TH_P5.00_KF301-5.0-2P |  | Select by System | KF301-5.0-2P | Cixi Kefa Elec | 插件,P=5mm | -30℃~+120℃ 1 1.5 14~22 17A 1x2P 2 250V 2P 5mm Blue Through Hole 插件,P=5mm Screw Terminal Blocks ROHS | Screw Terminal Blocks |  | C474881 | https://jlcpcb.com/partdetail/Cixi_KefaElec-KF301_5_02P/C474881 | Extended | 3 | 3 JLCPCB | 0.3018
U5,U6,U7 | AP64350SP-13 | SO-8_L4.9-W3.9-P1.27-LS6.0-BL-EP |  | Select by System | AP64350SP-13 | Diodes Incorporated | SO-8-EP | -40℃~+125℃ 1 100kHz~2.2MHz 22uA 3.5A 3.8V~40V 800mV~39V Adjustable Buck Buck Built-in Yes SO-8-EP DC-DC Converters ROHS | DC-DC Converters |  | C2071691 | https://jlcpcb.com/partdetail/DiodesIncorporated-AP64350SP13/C2071691 | Extended | 6 | 6 My Parts | 0
U9,U12,U16 | MP2393GTL-Z | SOT-583-8_L2.1-W1.2-P0.50-LS1.6-BL |  | Select by System | MP2393GTL-Z | Monolithic Power Systems | SOT-583 | -40℃~+125℃@(TJ) 1 200uA 3A 4.2V~24V 650kHz 800mV~13V Adjustable Buck Buck Built-in Yes SOT-583 DC-DC Converters ROHS | DC-DC Converters |  | C6674609 | https://jlcpcb.com/partdetail/Monolithic_PowerSystems-MP2393GTLZ/C6674609 | Extended | 6 | 6 My Parts | 0
U14,U118$CBB23 | APX803S-31SA-7 | SOT-23-3_L2.9-W1.3-P1.90-LS2.4-BR |  | Unconfirmed | APX803S-31SA-7 | Diodes Incorporated | SOT-23 | -40℃~+85℃ 1 10uA 1V~5.5V 240ms 3.08V Active Low No No Open Drain Voltage Monitor SOT-23 Supervisor and Reset ICs ROHS | Supervisor And Reset ICs | 1.There may be multiple types of parts, but one type of part has been matched. Please check.; | C129757 | https://jlcpcb.com/partdetail/DiodesIncorporated-APX803S_31SA7/C129757 | Extended | 5 | 2 My Parts 3 JLCPCB | 0.7419
U1$CBB1,U1$CBB2,U1$CBB3,U1$CBB4,U1$CBB5,U1$CBB6,U1$CBB15,U2$CBB15,U3$CBB9,U3$CBB15,U3$CBB49,U4$CBB9,U4$CBB49,U5$CBB9,U5$CBB49,U1$CBB8,U1$CBB10,U1$CBB11,U1$CBB12,U1$CBB13,U1$CBB14,U1$CBB16,U1$CBB17,U1$CBB18,U1$CBB20,U2$CBB16,U2$CBB17,U2$CBB18,U2$CBB20,U3$CBB19,U4$CBB19,U5$CBB19 | MCP6024T-I/SL-MS | SOIC-14_L8.7-W3.9-P1.27-LS6.0-BL-1 |  | Select by Customer | MCP6024T-I/SL-MS | MSKSEMI | SOP-14 | -2.75V~-1.1V、1.1V~2.75V -40℃~+85℃ 10V/us 11MHz 2.2V~5.5V 2.5mV 300uA 30pA 4 400pA 600nV/℃ 60nV/√Hz@1kHz 70mA 95dB Rail-to-Rail Input, Rail-to-Rail Output SOP-14 Operational Amplifier ROHS |  |  | C54539958 | https://jlcpcb.com/partdetail/MSKSEMI-MCP6024T_I_SLMS/C54539958 | Extended | 64 | 64 My Parts | 0
U1$CBB7,U1$CBB21,U2$CBB7,U2$CBB21,U3$CBB7,U3$CBB21,U4$CBB7,U4$CBB21,U5$CBB7,U5$CBB21,U7$CBB7,U7$CBB21 | XC2361A | TSOT-23-6_L2.9-W1.6-P0.95-LS2.6-BL |  | Select by Customer | XC2361A | Si-Change | SOT-23-6 | SOT-23-6 Analog to Digital Converters (ADC) ROHS |  |  | C41383383 | https://jlcpcb.com/partdetail/SiChange-XC2361A/C41383383 | Extended | 24 | 24 My Parts | 0
U1$CBB23 | T20F256C3 | FBGA-256_L13.0-W13.0-R16-C16-P0.80-TL |  | Select by System | T20F256C3 | Efinix | FBGA-256(13x13) | 0℃~+85℃ 1069548bit 19728 FBGA-256(13x13) Programmable Logic Device (CPLDs/FPGAs) ROHS | Global Sourcing Parts |  | C3277960 | https://jlcpcb.com/partdetail/Efinix-T20F256C3/C3277960 | Extended | 2 | 2 My Parts | 0
U100$CBB22 | T120F324C3 | BGA324C65P18X18_1200X1200X97N |  | Select by System | T120F324C3 | Efinix | FBGA-324(12x12) | FBGA-324(12x12) Programmable Logic Device (CPLDs/FPGAs) ROHS |  |  | C3277966 | https://jlcpcb.com/partdetail/Efinix-T120F324C3/C3277966 | Extended | 2 | 2 My Parts | 0
U101$CBB24 | 12MHz | CRYSTAL-SMD_4P-L3.2-W2.5-BL |  | Select by System | ECS-120-10-33B-CKM-TR | ECS | SMD3225-4P | -20℃~+70℃ 100Ω 10pF 12MHz ±10ppm ±10ppm SMD3225-4P Crystals ROHS | Crystals |  | C2450718 | https://jlcpcb.com/partdetail/ECS-ECS_120_10_33B_CKMTR/C2450718 | Extended | 2 | 2 My Parts | 0
U103$CBB24,U104$CBB24 | BLM15PX330SN1D | L0402 |  | Select by System | BLM15PX330SN1D | Murata Electronics | 0402 | 1 22mΩ 33Ω@100MHz 3A ±25% 0402 Ferrite Beads ROHS | Ferrite Beads |  | C160974 | https://jlcpcb.com/partdetail/MurataElectronics-BLM15PX330SN1D/C160974 | Extended | 20 | 20 JLCPCB | 0.4
U19$CBB23 | W25Q64JVZPIQ | WSON-8_L6.0-W5.0-P1.27-BL-EP |  | Select by Customer | W25Q64JVZPIM | Winbond Elec | WSON-8(5x6) | -40℃~+85℃ 133MHz 2.7V~3.6V 3ms 64Mbit Power-on reset、Hardware write protection、Software write protection、Write enable latch、Absolute write protection SPI WSON-8(5x6) NOR FLASH ROHS | NOR FLASH |  | C7413985 | https://jlcpcb.com/partdetail/WinbondElec-W25Q64JVZPIM/C7413985 | Extended | 2 | 2 JLCPCB | 9.0024
U2$CBB22/CBB1,U95$CBB22/CBB1 | PCA9306DC1 | VSSOP-8_L2.4-W2.1-P0.50-LS3.2-BR |  | Select by System | PCA9306DC1 | NXP Semicon | VSSOP-8-0.5mm | -40℃~+105℃ 1.8V~5.5V 1V~3.6V 2 2 2Mbps Automatic direction detection、Output enable high-impedance Bidirectional Level translator Open-drain SMBus、I2C VSSOP-8-0.5mm Translators, Level Shifters ROHS | Translators, Level Shifters |  | C129510 | https://jlcpcb.com/partdetail/NXPSemicon-PCA9306DC1/C129510 | Extended | 4 | 4 JLCPCB | 1.3264
U6$CBB16/CBB1,U6$CBB16/CBB2,U6$CBB16/CBB3,U6$CBB16/CBB4,U6$CBB16/CBB5,U6$CBB16/CBB6,U6$CBB17/CBB1,U6$CBB17/CBB2,U6$CBB17/CBB3,U6$CBB17/CBB4,U6$CBB17/CBB5,U6$CBB17/CBB6,U6$CBB17/CBB7,U6$CBB17/CBB8,U6$CBB18/CBB1,U6$CBB18/CBB2,U6$CBB18/CBB3,U6$CBB18/CBB4,U6$CBB18/CBB5,U6$CBB18/CBB6,U6$CBB18/CBB7,U6$CBB18/CBB8,U6$CBB20/CBB1,U6$CBB20/CBB2,U6$CBB20/CBB3,U6$CBB20/CBB4,U6$CBB20/CBB5,U6$CBB20/CBB6,U6$CBB20/CBB7,U6$CBB20/CBB8 | 74HC595 | SOP-16_L9.9-W3.9-P1.27-LS6.0-BL |  | Select by System | 74HC595 | GR | SOP-16 | -40℃~+85℃ 1 100ns@5V,50pF 10MHz 2V~6V 74HC 8 Serial-to-Serial or Parallel Tri-State SOP-16 Shift Registers ROHS | Shift Registers |  | C18164493 | https://jlcpcb.com/partdetail/GR-74HC595/C18164493 | Extended | 60 | 60 My Parts | 0
U98$CBB24 | FT2232HL-REEL | LQFP-64_L10.0-W10.0-P0.50-LS12.0-TL |  | Select by System | FT2232HL-REEL | FTDI | LQFP-64(10x10) | -40℃~+85℃ 2 480Mbps USB 2.0 USB to UART、USB to FIFO LQFP-64(10x10) USB Converters ROHS | USB Converters |  | C27882 | https://jlcpcb.com/partdetail/FTDI-FT2232HLREEL/C27882 | Extended | 2 | 2 My Parts | 0
U98$CBB22/CBB2 | RTL8211F-CG | WQFN-40_L5.0-W5.0-P0.4-BL-EP |  | Select by System | RTL8211F-CG | Realtek Semicon | WQFN-40-EP(5x5) | 1.5V、1.8V、2.5V、3.3V 10BASE-T、100BASE-TX、1000BASE-T 10Mbit/s、100Mbit/s、1Gbit/s Ethernet Transceiver RGMII WQFN-40-EP(5x5) Ethernet Transceivers ROHS | Ethernet Transceivers |  | C187932 | https://jlcpcb.com/partdetail/RealtekSemicon-RTL8211FCG/C187932 | Extended | 2 | 2 JLCPCB | 2.8136
U99$CBB22 | W25Q128JVSIQ | SOIC-8_L5.3-W5.3-P1.27-LS8.0-BL |  | Select by System | W25Q128JVSIQ | Winbond Elec | SOIC-8-208mil | -40℃~+85℃ 100,000 cycles 120ms@(32KB) 128Mbit 133MHz 1uA 2.7V~3.6V 20 Years 3ms Power-on reset、Hardware write protection、Software write protection、Write enable latch、Absolute write protection SPI SOIC-8-208mil NOR FLASH ROHS | NOR FLASH |  | C97521 | https://jlcpcb.com/partdetail/WinbondElec-W25Q128JVSIQ/C97521 | Basic | 2 | 2 My Parts | 0
USB3$CBB24 | USB-B10-BRW | USB-B-TH_USB-B10-BRW |  | Select by System | USB-B10-BRW | XUNPU | 弯插 | -20℃~+70℃ 1 1.5A 16.3mm 30V 4P Female Right Angle Type-B USB 2.0 White 弯插 USB Connectors ROHS | USB Connectors |  | C720549 | https://jlcpcb.com/partdetail/XUNPU-USB_B10BRW/C720549 | Extended | 2 | 2 JLCPCB | 0.2942
X1,X1$CBB23 | 50MHz | OSC-SMD_4P-L3.2-W2.5-BL |  | Unconfirmed | OT322550MJBA4SL | YXC Crystal Oscillators | SMD3225-4P | -40℃~+85℃ 1.8V~3.3V 50MHz CMOS ±10ppm ±20ppm SMD3225-4P Crystal Oscillators ROHS | Crystal Oscillators | 1.There may be multiple types of parts, but one type of part has been matched. Please check.; | C717684 | https://jlcpcb.com/partdetail/758644-OT322550MJBA4SL/C717684 | Extended | 5 | 2 My Parts 3 JLCPCB | 1.5984
X4$CBB22/CBB2 | 25MHz | CRYSTAL-SMD_4P-L5.0-W3.2-BL |  | Select by System | XC53M4-25.000-F12JJDT | HCI | SMD5032-4P | -40℃~+85℃ 12pF 25MHz 50Ω Crystal Oscillator ±30ppm ±30ppm SMD5032-4P Crystals ROHS | Crystals |  | C2916916 | https://jlcpcb.com/partdetail/HCI-XC53M4_25_000F12JJDT/C2916916 | Extended | 5 | 5 JLCPCB | 1.274
TP1,TP2,TP3,TP4,TP5,TP6,TP7,TP2$CBB23,TP3$CBB23 | Test-Point | Test-Point-0.5mm |  | No matches | No Part Selected
