ollewelin/analog_matrix_computation_Inverted_MAML_PAT_PEND_2630397-4/FPGA_code/docs/figures/fig_m3_sigmoid_step1_column_summary.png

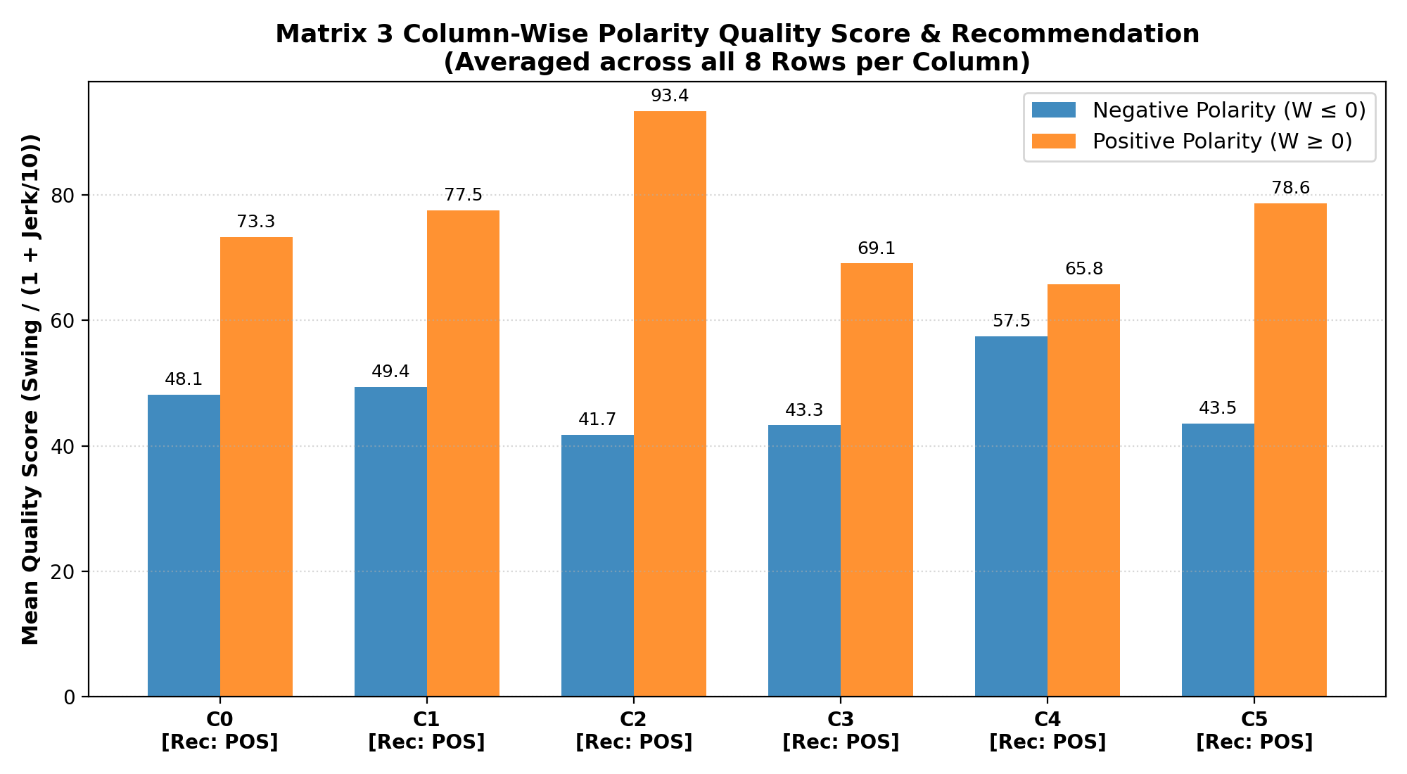
FPGA_code/docs/figures/fig_m3_sigmoid_step1_column_summary.png
