ollewelin/analog_matrix_computation_Inverted_MAML_PAT_PEND_2630397-4/FPGA_code/docs/figures/fig_m3_sigmoid_step2_column_scurves.png

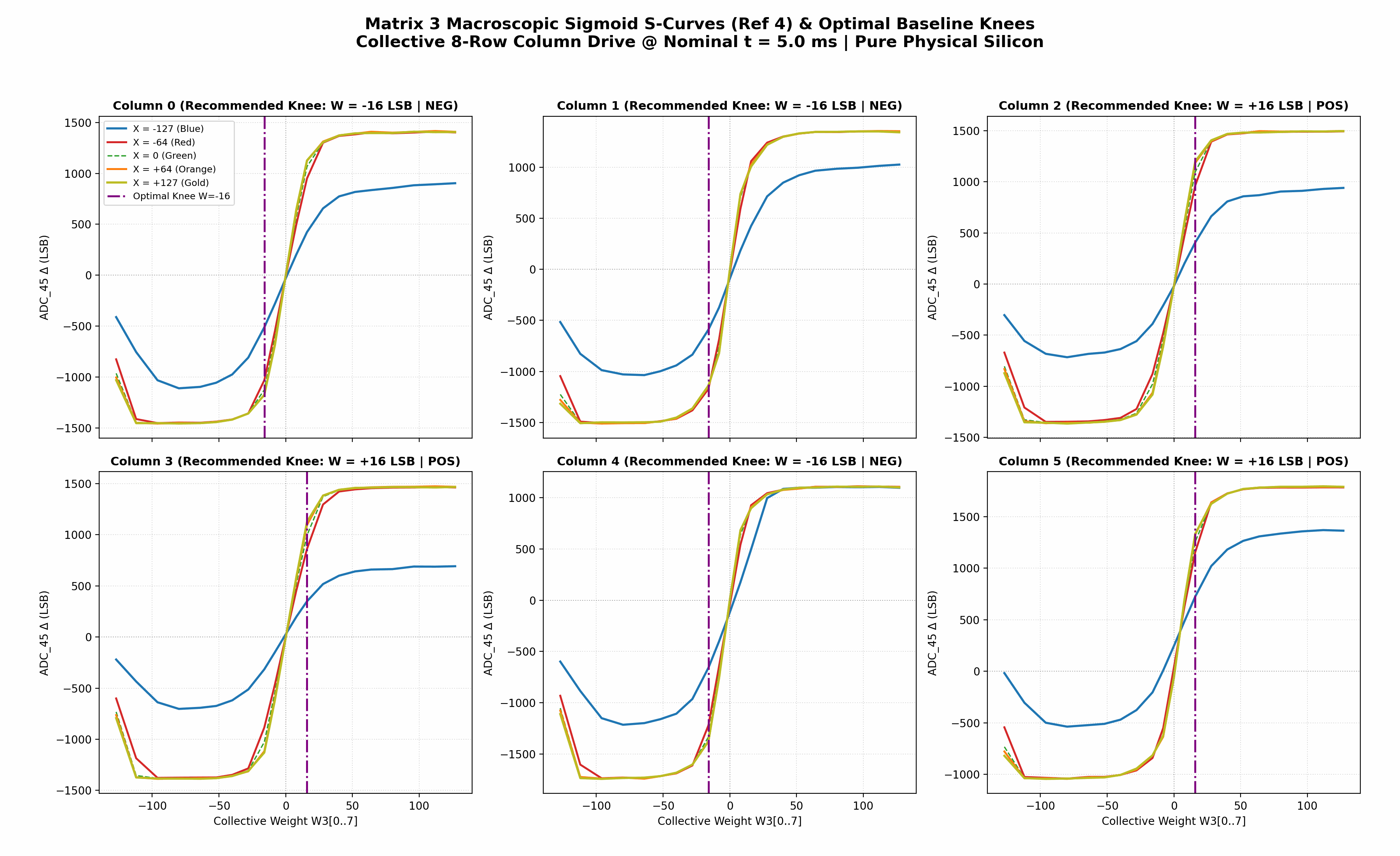
FPGA_code/docs/figures/fig_m3_sigmoid_step2_column_scurves.png
