ollewelin/analog_matrix_computation_Inverted_MAML_PAT_PEND_2630397-4/simulator_32x32/results_32x32/two_stage_maml_16x16/02_operation_mode_16x16.png

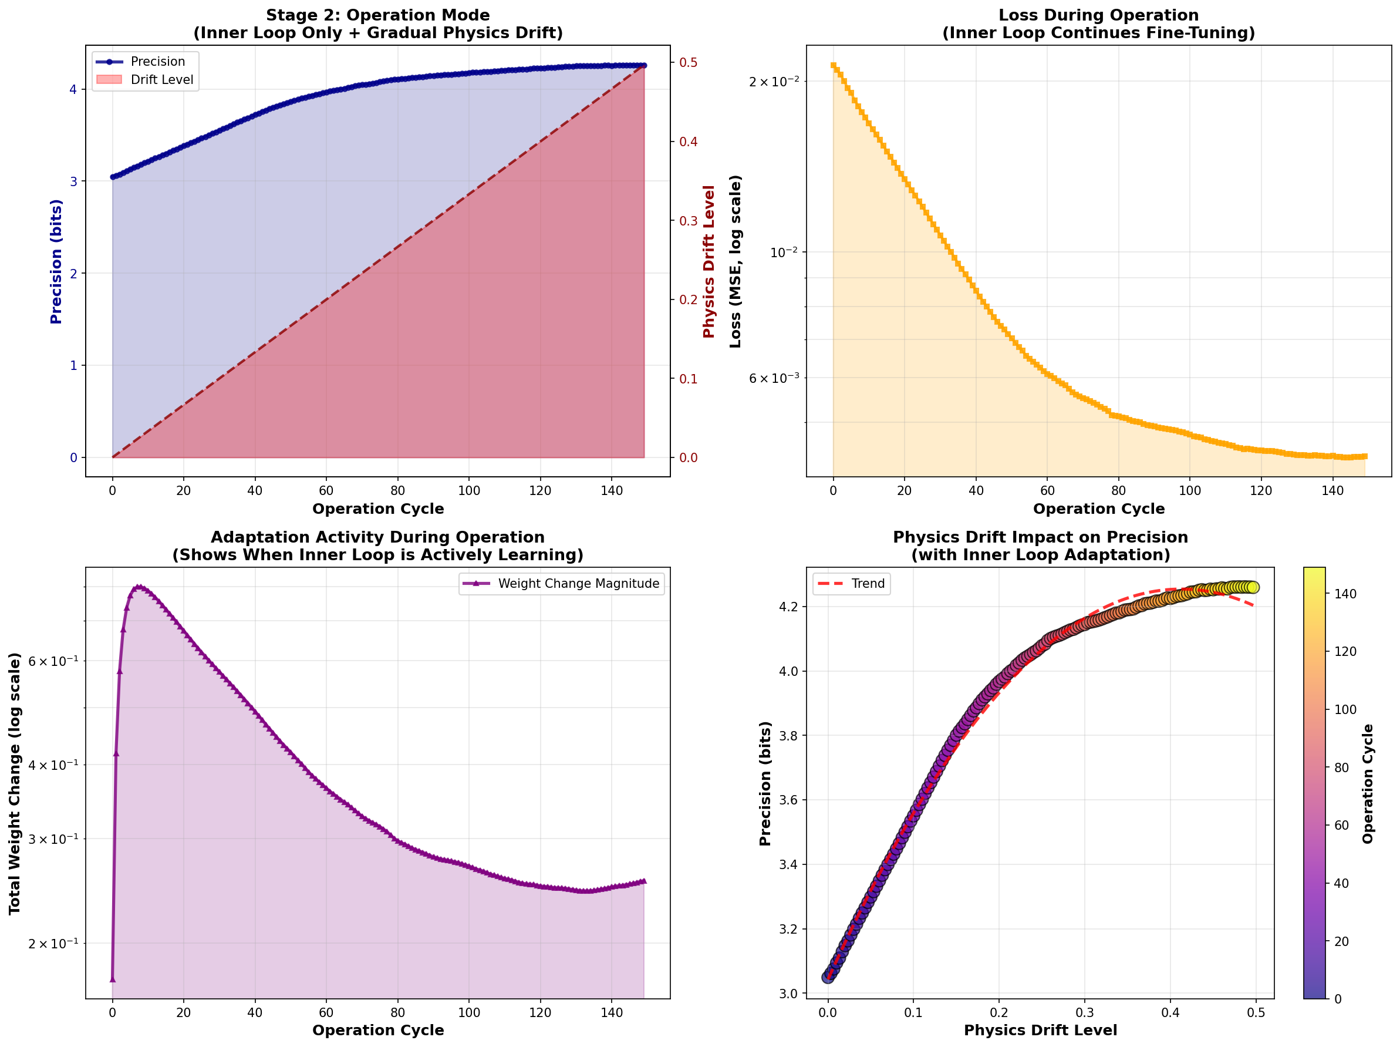
simulator_32x32/results_32x32/two_stage_maml_16x16/02_operation_mode_16x16.png
