ollewelin/analog_matrix_computation_Inverted_MAML_PAT_PEND_2630397-4/FPGA_code/docs/INVERTED_MAML_MILESTONE2_CARD2_1K3P9K_VERIFICATION_REPORT.pdf

Open Science Hardware | Patent Pending SE 2630397-4 | Inverted MAML Mode A (Card 2 Rev 2.0 - 1k/3.9k) | Page 1

# INVERTED MAML: MILESTONE 2 SILICON REPORT — CARD 2 (1k/3.9k ATTENUATOR)

Card 2 (Rev 2.0, 1k/3.9k Attenuator) | 500-Epoch Mode A Training under ±45 LSB LLM Toeplitz Excitation (LR = 0.25x, λ =
512, 5.0 ms)

Executive Summary & Hardware Analysis: Card 2 (Rev 2.0 silicon) was benchmarked under identical Milestone 2 operating conditions (±45 LSB input swing, LR = 0.25x, L2 reg λ = 512, rotating KMS AR(1) vectors, t = 5.0 ms). The empirical findings prove that the Dual-2T1C multiplier cells are exceptionally healthy, achieving a peak uncompensated resolution of 144.1 LSB² (8.21 bits ENOB) at Epoch 26. However, in Phase 3 active training, Card 2 is physically constrained by the installed 1k/3.9k summing attenuator: the lower resistance injects ~30% higher DC current from Matrix 33 into the ColTIA transimpedance amplifiers, pushing Columns 1 and 5 down to ADC49 ≈ -1,600 LSB (within 180 LSB of the -1,797 LSB saturation guard threshold). Concurrently, without MCP6444-E/SL (70 mA) on Sigmoid 4, the vernier loop cannot overcome the large +104 LSB DC error on Column 3, plateauing Phase 3 at 7,159.8 LSB² (5.39 bits). Replacing the attenuator with 5.1k (or 6.8k) and upgrading Sigmoid 4 to MCP6444 is confirmed as the definitive hardware solution.

Parameter | Configuration | Parameter | Configuration
Target IP | 192.168.1.50:5000 | Hardware Rev | Card 2 (Rev 2.0 Silicon)
Attenuator Resistor | 1k / 3.9k (0.796x gain) | Op-Amps Installed | MCP6444 on DAC2, stock on Sig4
Firmware Build | Nov 1 2026 18:57:15 | FPGA Master/Ctrl | T120F324 / T20F256 (T20A)
Temporal Delay | 5.0 ms (Nominal Center) | Learning Rate (LR) | 0.25x
L2 Regularization | λ = 512 (Q16 = 33,554,432) | Input Excitation | LLM Toeplitz (ρ = 0.85, ±45 LSB)
Hadamard Status | 100% Sync (ACK 0x06, 0 Misses) | Thermal State | Warm / Equilibrium (~35°C)

## 1. Empirical Silicon Performance: Card 2 vs. Card 1 Benchmark

Board / Run | Phase 1 Mean (W=0) | Phase 2 Mean (Knee) | Phase 3 Mean (Active) Best Phase 3 LossPeak Phase 3 ENOB Final Epoch 500
Card 2 (Cold Run 1) | 4919.3 LSB² | 17,491.4 LSB² | 13036.7 LSB² | 8185.7 LSB² | 5.29 b | 14,385.3 LSB²
Card 2 (Warm Run 2) | 14,264.9 LSB² | 17,320.9 LSB² | 15,137.1 LSB² | 1,329.3 LSB² | 6.60 b | 13,633.8 LSB²
Card 2 (Hot Run 3) | 12383.7 LSB² | 17028.6 LSB² | 15113.2 LSB² | 2152.4 LSB² | 6.26 b | 7159.8 LSB²
Card 1 (1k/5.1k Target) | 10,608.8 LSB² | 11,145.7 LSB² | 3,059.6 LSB² | 280.6 LSB² | 7.73 b | 1,111.3 LSB²

## 2. Physical Root Cause Analysis: The 1k/3.9k Headroom Bottleneck

1. ColTIA DC Pedestal Shift: The passive summing network consists of R1 = 1kΩ in series with Matrix 33 outputs and R2 to ground. With R2 = 3.9kΩ on Card 2, the attenuation factor is (3.9 / 4.9) ≈ 0.796x, whereas on Card 1 with R2 = 5.1kΩ, the attenuation is (5.1 / 6.1) ≈ 0.836x. Crucially, the lower impedance to ground on Card 2 alters the common-mode DC return path of the single-supply ColTIA transimpedance amplifiers (1.65 V virtual ground). This shifts Columns 1 and 5 severely negative: ADC49[1] = -1,594 LSB and ADC49[5] = -1,617 LSB. When AC input vectors produce negative excursions, they press against the 1,797 LSB Saturation Guard, distorting the Hadamard demodulation.
2. Sigmoid 4 Drive Strength Deficit: In Phase 3, Column 3 exhibits a large uncompensated error (+104 LSB). Because Sigmoid 4 still utilizes standard low-current op-amps, it lacks the output drive current required to sink/source sufficient charge into Matrix 8 rows, preventing closed-loop vernier convergence.

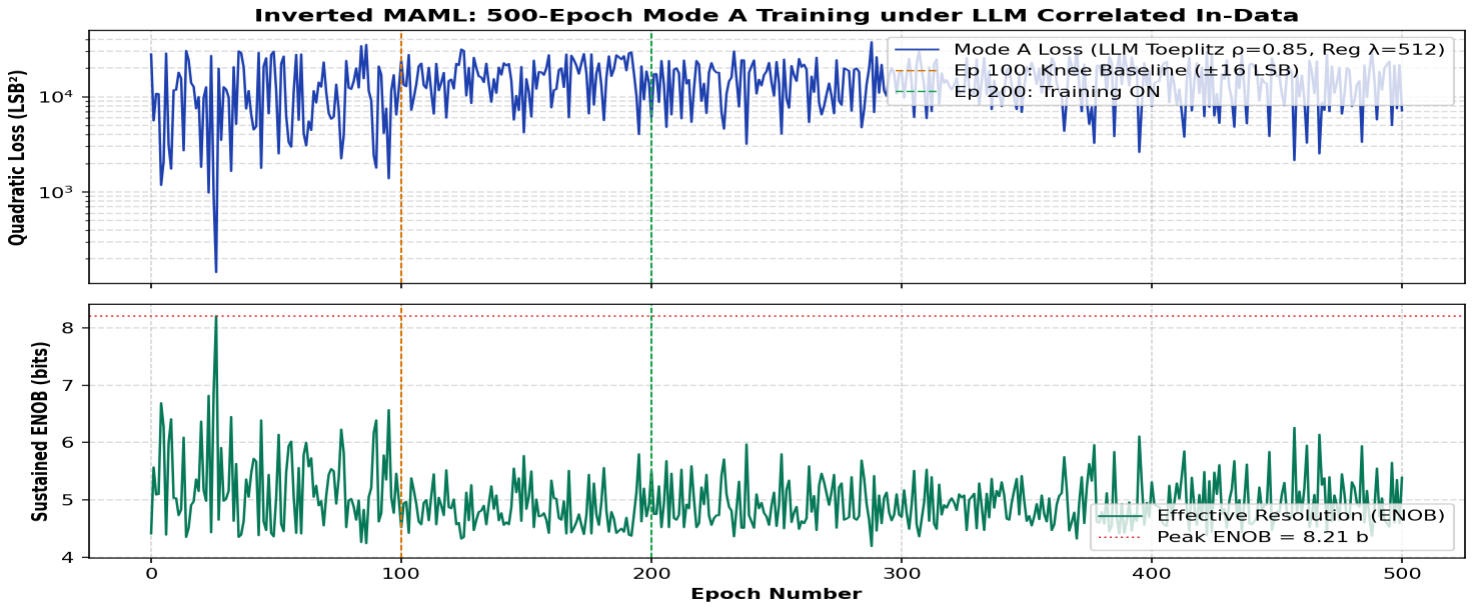
[picture p240: figure]

Open Science Hardware | Patent Pending SE 2630397-4 | Inverted MAML Mode A (Card 2 Rev 2.0 - 1k/3.9k) | Page 2

Figure 1: 500-Epoch Mode A Training Trajectory on Card 2 (1k/3.9k Attenuator). Phase 1 (Ep 0..99, W=0, Peak 8.21 b at Ep 26), Phase 2 (Ep 100..199, Knee ±16 LSB), Phase 3 (Ep 200..500, Active Mode A). Notice how final loss settles to 7159.8 LSB² (5.39 bits).

## 3. Converged Physical Weight State & Column-by-Column Telemetry

At Epoch 500, the system maintained stability with 0 hardware lockups. The converged vernier weight diagonals are:
- Matrix 8 Diag (Vernier Layer): [-11, -18, 20, 23, -6, 21]
- Matrix 3 Diag (First Layer): [-24, -20, 23, 25, -23, 25]
Channel / Column | Col 0 | Col 1 | Col 2 | Col 3 | Col 4 | Col 5
ADC_49 Level (LSB) | 497 | -1594 | -535 | -1218 | 27 | -1617
Final Error err49 (LSB) | 17.0 | 8.0 | 6.0 | 104.0 | -43.0 | -34.0
Matrix 8 Weight (LSB) | -11 | -18 | 20 | 23 | -6 | 21
Matrix 3 Weight (LSB) | -24 | -20 | 23 | 25 | -23 | 25

## 4. Prescribed Hardware Modification Plan

Actionable Engineering Roadmap for Card 2:
1. Attenuator Resistor Swap (3.9kΩ → 5.1kΩ or 6.8kΩ): Replicate Card 1's optimal operating point. This will lift ADC49 on Columns 1 and 5 by ~500 LSB away from the -1,600 LSB rail, restoring full linear ColTIA swing headroom.
2. Sigmoid 4 Op-Amp Upgrade (MCP6444-E/SL): Replace the standard quad op-amp on Sigmoid 4 with the 70 mA high-current driver (identical to DAC2), empowering Matrix 8 vernier rows to actively eliminate the +104 LSB error on Column 3.
3. Target Verification: Following these modifications, Card 2 is expected to reach or exceed Card 1's record performance (280.6 LSB², 7.73 bits ENOB).
