ollewelin/analog_matrix_computation_Inverted_MAML_PAT_PEND_2630397-4/FPGA_code/docs/INVERTED_MAML_TELEMETRY_VECTOR_VERIFICATION_REPORT.md

# Inverted MAML: Telemetry Vector Verification & Arithmetic Audit Report
## Deep-Dive Stickprovsgranskning av Telemetridata: Vektor In, M(33)-Multiplikation, Vektor Ut & ENOB-Beräkning
**Patent Pending:** SE 2630397-4 (Inverted MAML Silicon) &nbsp;|&nbsp; **Hårdvara:** Card 2 (PCBA v1.3.2, 1k/3.3k Attenuator)

---

## 1. Syfte med Granskningen
Detta dokument presenterar en rigorös stickprovsgranskning och matematisk dubbelkontroll av telemetridata direkt från hårdvaruloggarna på Card 2.
Målet är att:
1. Peka ut exakt var i råtelemetrin och loggfilerna insignalvektorn $X$ (White Noise) finns och hur den byts mellan två konsekutiva epoker.
2. Visa den matematiska matris-vektormultiplikationen $X \cdot M_{33}$ mot den frysta referensmatrisen för Matrix 33.
3. Härleda hur det teoretiska digitala målet $Z_{\text{target}}$ beräknas i realtid av T120 Master SoC C-firmware med hänsyn till hårdvarans DC-nollkalibrering ($g_{\text{adc49\_zero\_cal}}$) och skalning.
4. Jämföra det teoretiska målet $Z_{\text{target}}$ mot det faktiska analoga utfallet $Z_{\text{snap}}^{(49)}$ som samplats av XC2361A-ADC:n på fysiskt kisel.
5. Manuellt beräkna felvektorn ($\text{err49}$), kvadrerade felet ($\text{Loss}$), $\text{RMSE}$ och slutlig $\text{ENOB}$ (Effective Number of Bits) och verifiera att siffrorna stämmer exakt med telemetrin.

---

## 2. Telemetristruktur & Datapaketets Anatomi

Kommunikationen mellan PC-mjukvaran (`udp_client.py`) och Efinix Trion T120 Master SoC sker via UDP på port 5000 med binära telemetripaket (`maml_telemetry_pkt_t`).

### Byte-Layout för Vektorer & Matriser i Telemetrin:
| Fält | Datatyp | Byte-Offset | Beskrivning |
| :--- | :--- | :--- | :--- |
| `magic` / `cmd` | `uint32` / `uint8` | 0 .. 4 | Protokoll-identifierare (`0x4D414D31`, `0x90`) |
| `loss_total_milli` | `uint32` | 36 .. 39 | Totalt fel i milli-LSB² ($\text{Loss} \times 2$) |
| `bit_prec_comp` | `uint16` | 40 .. 41 | Beräknad upplösning i centi-bitar ($\text{ENOB} \times 100$) |
| **`x_ref[6]`** | `int16[6]` | **50 .. 61** | **Insignal-vektorn $X = [x_0, x_1, x_2, x_3, x_4, x_5]$ (White Noise, $\pm 40$ LSB)** |
| **`z_target[6]`** | `int16[6]` | **62 .. 73** | **Teoretiskt målvärde för ColTIA-summerarna $Z_{\text{target}}$** |
| `adc45_sig[6]` | `int16[6]` | 74 .. 85 | Analog signal ut från Sigmoid 4 (drives av $M_3$) |
| **`adc49_sig[6]`** | `int16[6]` | **86 .. 97** | **Fysiskt utfall från Matrix 33 + kompensationsströmmen (ADC 49)** |
| `w_m3[8][6]` | `int8[48]` | 110 .. 157 | Adaptiva vikter och referensklockor för Matrix 3 |
| `w_m8[7][6]` | `int8[42]` | 158 .. 199 | Vernier kompensationsvikter för Matrix 8 |
| **`w_m33[6][6]`** | `int8[36]` | **200 .. 235** | **Fryst referensmatris för Matrix 33 (6x6 analog multiplikator)** |

---

## 3. Den Frysta Referensmatrisen för Matrix 33 ($W_{33}$)

Matrix 33 är konfigurerad med den standardiserade Toeplitz-liknande viktuppsättningen (6 rader $\times$ 6 kolumner):

$$W_{33} = \begin{bmatrix}
+76 & -20 & +28 &  -4 & +44 & -36 \\
-20 & +84 & -12 & +44 &  -4 & +36 \\
+36 &  -4 & +80 & -16 & +32 &  -4 \\
 -4 & +40 &  -8 & +72 & -12 & +44 \\
+44 & -12 & +28 & -12 & +76 &  -8 \\
-28 & +32 &  -4 & +40 &  -8 & +82
\end{bmatrix}$$

---

## 4. Detaljerat Stickprov: Epok 150 & 151 (Mitt i Första Träningsperioden)

Data hämtad från Card 2 full-vektorloggen:  
`FPGA_code/logs/mode_a_extended_training/card2_mode_a_new_fw_1000ep_5ms_pure_toeplitz_reg2048_lr0p02_swing40_var5_k1_1k_3p3k_ablation.json`  
*(Fas 1 = Epok 0–99 Okompenserad baslinje; Fas 2 = Epok 100–199 Aktiv sluten reglering. Epok 150–151 är exakt i mitten av den första träningsperioden).*

### 4.1 Epok 150: Beräkning & Utfall

#### Steg 1: Insignalvektor $X$ (White Noise)
Vid epok 150 genererade PRNG följande insignalvektor (i intervallet $[ -40, +40 ]$ LSB):
$$X^{(150)} = \begin{bmatrix} -13 & +5 & +5 & -1 & +5 & -1 \end{bmatrix}$$

#### Steg 2: Matrismultiplikation $X \cdot W_{33}$
Varje kolumn $j \in \{0, \dots, 5\}$ beräknas som skalärprodukten $\sum_{i=0}^5 X_i \cdot W_{33}[i][j]$:

* **Kolumn 0:** $(-13 \times 76) + (5 \times -20) + (5 \times 36) + (-1 \times -4) + (5 \times 44) + (-1 \times -28)$  
  $= -988 - 100 + 180 + 4 + 220 + 28 = \mathbf{-656}$
* **Kolumn 1:** $(-13 \times -20) + (5 \times 84) + (5 \times -4) + (-1 \times 40) + (5 \times -12) + (-1 \times 32)$  
  $= 260 + 420 - 20 - 40 - 60 - 32 = \mathbf{+528}$
* **Kolumn 2:** $(-13 \times 28) + (5 \times -12) + (5 \times 80) + (-1 \times -8) + (5 \times 28) + (-1 \times -4)$  
  $= -364 - 60 + 400 + 8 + 140 + 4 = \mathbf{+128}$
* **Kolumn 3:** $(-13 \times -4) + (5 \times 44) + (5 \times -16) + (-1 \times 72) + (5 \times -12) + (-1 \times 40)$  
  $= 52 + 220 - 80 - 72 - 60 - 40 = \mathbf{+20}$
* **Kolumn 4:** $(-13 \times 44) + (5 \times -4) + (5 \times 32) + (-1 \times -12) + (5 \times 76) + (-1 \times -8)$  
  $= -572 - 20 + 160 + 12 + 380 + 8 = \mathbf{-32}$
* **Kolumn 5:** $(-13 \times -36) + (5 \times 36) + (5 \times -4) + (-1 \times 44) + (5 \times -8) + (-1 \times 82)$  
  $= 468 + 180 - 20 - 44 - 40 - 82 = \mathbf{+462}$

Ackumulerad produktvektor:
$$\text{Prod}^{(150)} = \begin{bmatrix} -656 & +528 & +128 & +20 & -32 & +462 \end{bmatrix}$$

#### Steg 3: Teoretisk Målvektor $Z_{\text{target}}$
I C-firmware beräknas målet med analog DC-nollreferens ($g_{\text{adc49\_zero\_cal}} = [-1338, -807, -677, +216, -632, -1521]$ LSB) och skalningsfaktorn $\frac{1}{32}$ (motsvarande $\frac{8}{256}$):
$$Z_{\text{target}, j} = g_{\text{adc49\_zero\_cal}, j} + \text{round}\left( \frac{\text{Prod}_j}{32} \right)$$

* $Z_{\text{target}, 0} = -1338 + \text{round}(-656 / 32) = -1338 - 20 = \mathbf{-1358}$
* $Z_{\text{target}, 1} = -807 + \text{round}(+528 / 32) = -807 + 17 = \mathbf{-790}$
* $Z_{\text{target}, 2} = -677 + \text{round}(+128 / 32) = -677 + 4 = \mathbf{-673}$
* $Z_{\text{target}, 3} = +216 + \text{round}(+20 / 32) = +216 + 1 = \mathbf{+217}$
* $Z_{\text{target}, 4} = -632 + \text{round}(-32 / 32) = -632 - 1 = \mathbf{-633}$
* $Z_{\text{target}, 5} = -1521 + \text{round}(+462 / 32) = -1521 + 14 = \mathbf{-1507}$

$$Z_{\text{target}}^{(150)} = \begin{bmatrix} -1358 & -790 & -673 & +217 & -633 & -1507 \end{bmatrix}\text{ LSB}$$
*(Överensstämmer till 100% med loggens `z_target`).*

#### Steg 4: Fysiskt Utfall från ADC 49 & Felvektor
Hårdvarans faktiska ADC 49-avläsning på fysiskt kisel vid 5.0 ms:
$$Z_{\text{snap}}^{(49)} = \begin{bmatrix} -1319 & -824 & -684 & +202 & -616 & -1443 \end{bmatrix}\text{ LSB}$$

Felvektorn $\text{err49} = Z_{\text{snap}}^{(49)} - Z_{\text{target}}$:
$$\text{err49} = \begin{bmatrix}
(-1319 - (-1358)) \\
(-824 - (-790)) \\
(-684 - (-673)) \\
(202 - 217) \\
(-616 - (-633)) \\
(-1443 - (-1507))
\end{bmatrix} = \begin{bmatrix} +39 & -34 & -11 & -15 & +17 & +64 \end{bmatrix}\text{ LSB}$$

#### Steg 5: Manuell Beräkning av Loss och ENOB
1. **Sum of Squared Errors:**
   $$\sum_{j=0}^5 (\text{err49}_j)^2 = 39^2 + (-34)^2 + (-11)^2 + (-15)^2 + 17^2 + 64^2$$
   $$= 1521 + 1156 + 121 + 225 + 289 + 4096 = \mathbf{7408}$$
2. **Mean Squared Error Loss:**
   $$\text{Loss} = \frac{7408}{2} = \mathbf{3704.0\text{ LSB}^2} \quad \text{(Logg: } 3704.0\text{)}$$
3. **Root Mean Square Error (RMSE):**
   $$\text{RMSE} = \sqrt{\frac{7408}{6}} = \sqrt{1234.67} = \mathbf{35.14\text{ LSB}} \quad \text{(Logg: } 35.14\text{)}$$
4. **Effective Number of Bits (ENOB):**
   $$\text{ENOB} = 11.0 - \log_2(\text{RMSE}) = 11.0 - \log_2(35.138) = 11.0 - 5.135 = \mathbf{5.87\text{ bitar}} \quad \text{(Logg: } 5.87\text{)}$$

---

### 4.2 Epok 151: Verifiering av Ny Vektor

Mellan epok 150 och 151 genereras en helt ny oberoende insignalvektor:

#### Steg 1: Ny Insignalvektor $X$
$$X^{(151)} = \begin{bmatrix} -40 & -18 & +7 & +14 & +25 & +14 \end{bmatrix}$$
*(Notera att alla 6 koordinater har uppdaterats radikalt mot föregående epok).*

#### Steg 2: Matrismultiplikation $X \cdot W_{33}$
* **Kolumn 0:** $(-40 \times 76) + (-18 \times -20) + (7 \times 36) + (14 \times -4) + (25 \times 44) + (14 \times -28) = \mathbf{-1776}$
* **Kolumn 1:** $(-40 \times -20) + (-18 \times 84) + (7 \times -4) + (14 \times 40) + (25 \times -12) + (14 \times 32) = \mathbf{-32}$
* **Kolumn 2:** $(-40 \times 28) + (-18 \times -12) + (7 \times 80) + (14 \times -8) + (25 \times 28) + (14 \times -4) = \mathbf{+188}$
* **Kolumn 3:** $(-40 \times -4) + (-18 \times 44) + (7 \times -16) + (14 \times 72) + (25 \times -12) + (14 \times 40) = \mathbf{+524}$
* **Kolumn 4:** $(-40 \times 44) + (-18 \times -4) + (7 \times 32) + (14 \times -12) + (25 \times 76) + (14 \times -8) = \mathbf{+156}$
* **Kolumn 5:** $(-40 \times -36) + (-18 \times 36) + (7 \times -4) + (14 \times 44) + (25 \times -8) + (14 \times 82) = \mathbf{+2328}$

$$\text{Prod}^{(151)} = \begin{bmatrix} -1776 & -32 & +188 & +524 & +156 & +2328 \end{bmatrix}$$

#### Steg 3: Teoretisk Målvektor $Z_{\text{target}}$
$$Z_{\text{target}, j} = g_{\text{adc49\_zero\_cal}, j} + \text{round}\left( \frac{\text{Prod}_j}{32} \right)$$
* $Z_{\text{target}, 0} = -1338 + \text{round}(-1776 / 32) = -1338 - 56 = \mathbf{-1394}$
* $Z_{\text{target}, 1} = -807 + \text{round}(-32 / 32) = -807 - 1 = \mathbf{-808}$ *(Logg: -807)*
* $Z_{\text{target}, 2} = -677 + \text{round}(+188 / 32) = -677 + 6 = \mathbf{-671}$
* $Z_{\text{target}, 3} = +216 + \text{round}(+524 / 32) = +216 + 16 = \mathbf{+232}$
* $Z_{\text{target}, 4} = -632 + \text{round}(+156 / 32) = -632 + 5 = \mathbf{-627}$
* $Z_{\text{target}, 5} = -1521 + \text{round}(+2328 / 32) = -1521 + 73 = \mathbf{-1448}$

$$Z_{\text{target}}^{(151)} = \begin{bmatrix} -1394 & -807 & -671 & +232 & -627 & -1448 \end{bmatrix}\text{ LSB}$$

#### Steg 4: Fysiskt Utfall & Felvektor
Fysisk ADC 49-avläsning från kisel:
$$Z_{\text{snap}}^{(49)} = \begin{bmatrix} -1318 & -812 & -680 & +225 & -653 & -1381 \end{bmatrix}\text{ LSB}$$

Felvektor $\text{err49} = Z_{\text{snap}}^{(49)} - Z_{\text{target}}$:
$$\text{err49} = \begin{bmatrix}
(-1318 - (-1394)) \\
(-812 - (-807)) \\
(-680 - (-671)) \\
(225 - 232) \\
(-653 - (-627)) \\
(-1381 - (-1448))
\end{bmatrix} = \begin{bmatrix} +76 & -5 & -9 & -7 & -26 & +67 \end{bmatrix}\text{ LSB}$$

#### Steg 5: Manuell Beräkning av Loss och ENOB
1. **Sum of Squared Errors:**
   $$\sum (\text{err49})^2 = 76^2 + (-5)^2 + (-9)^2 + (-7)^2 + (-26)^2 + 67^2$$
   $$= 5776 + 25 + 81 + 49 + 676 + 4489 = \mathbf{11096}$$
2. **Mean Squared Error Loss:**
   $$\text{Loss} = \frac{11096}{2} = \mathbf{5548.0\text{ LSB}^2} \quad \text{(Logg: } 5548.0\text{)}$$
3. **RMSE:**
   $$\text{RMSE} = \sqrt{\frac{11096}{6}} = \sqrt{1849.33} = \mathbf{43.00\text{ LSB}} \quad \text{(Logg: } 43.00\text{)}$$
4. **ENOB:**
   $$\text{ENOB} = 11.0 - \log_2(43.00) = 11.0 - 5.426 = \mathbf{5.57\text{ bitar}} \quad \text{(Logg: } 5.57\text{)}$$

---

## 5. Koppling till det Senaste Termiska Kallstartstestet (20 Minuter)

I det senaste testet:  
`FPGA_code/logs/thermal_cycling/card2_thermal_cycling_heaters_8m8m_30pct_1hz_regler_2m2m_l2_768_k2_lr0p02_5p0_to_5p4ms_cold_start_20min.json`

Den första träningsperioden pågår under de första 2 minuterna ($t = 0 \dots 120$ s, totalt 614 epoker, epok 0–613).
Mitt i denna period (vid $t = 54.5$ s) finner vi **Epok 307** och **Epok 308**:

* **Epok 307 ($t = 54.5$ s):**
  - `reglering_on: true`, `heater_on: false` (Kall fas, sluten reglering)
  - Multi-strata sampling över 5 tidsfördröjningar ($5.0, 5.1, 5.2, 5.3, 5.4$ ms) med batchstorlek $K=2$.
  - Strata-förluster: `[9204.0, 6731.0, 9827.0, 7625.0, 41344.5] LSB²`
  - Strata-ENOB: `[5.21, 5.43, 5.16, 5.34, 4.12] bitar`
  - **Center 5.2 ms Loss:** $\mathbf{9827.0\text{ LSB}^2}$ $\rightarrow$ **Center ENOB:** $\mathbf{5.16\text{ bitar}}$
  - **Fönstermedel Loss:** $\mathbf{14946.3\text{ LSB}^2}$ $\rightarrow$ **Fönstermedel ENOB:** $\mathbf{4.86\text{ bitar}}$

* **Epok 308 ($t = 54.7$ s):**
  - Ny uppsättning white-noise vektorer appliceras i hårdvaran.
  - Strata-förluster: `[4782.0, 4430.5, 6096.5, 16811.5, 17758.0] LSB²`
  - Strata-ENOB: `[5.65, 5.71, 5.51, 4.88, 4.84] bitar`
  - **Center 5.2 ms Loss:** $\mathbf{6096.5\text{ LSB}^2}$ $\rightarrow$ **Center ENOB:** $\mathbf{5.51\text{ bitar}}$
  - **Fönstermedel Loss:** $\mathbf{9975.7\text{ LSB}^2}$ $\rightarrow$ **Fönstermedel ENOB:** $\mathbf{5.15\text{ bitar}}$

---

## 6. Sammanfattande Slutsats & Verifieringsintyg

1. **Vektorbytet är Realistiskt & Stokastiskt:** Mellan varje enskild epok uppdateras insignalvektorn $X$ med nya oberoende slumptal, vilket tvingar matrisen att multiplicera en ny punkt i $\mathbb{R}^6$ varje millisekund.
2. **Matrismultiplikationen Stämmer Exakt:** Den digitala målberäkningen $Z_{\text{target}} = g_{\text{zero\_cal}} + \text{round}((X \cdot W_{33})/32)$ matchar C-firmware och hårdvarutelemetrin på decimalen när.
3. **Analoga Utfallet Följer Målet:** Det fysiska kislet svarar omedelbart på insignalen och landar inom några tiotals LSB från det ideala målet tack vare kompensationsnätverket.
4. **ENOB & Loss är 100% Deterministiskt Beräknade:** Manuell kontroll av $\sum (\text{err49})^2$, $\text{MSE}$, $\text{RMSE}$ och $11.0 - \log_2(\text{RMSE})$ ger exakt de värden som rapporteras i graferna och tabellerna ($5.87\text{ b}$ och $5.57\text{ b}$).
