ollewelin/analog_matrix_computation_Inverted_MAML_PAT_PEND_2630397-4/FPGA_code/docs/M3_TEMPORAL_CLOCK_AND_BIAS_CHARACTERIZATION_REPORT.md

# Inverted MAML: Karakteriseringsrapport för Klockceller, Vanliga Beräkningsceller & Bias-Celler (1.0 – 9.0 ms & 4.5 – 5.5 ms)
**Patent Pending SE 2630397-4 | Milstolpe 3: Temporal Kompensation & S-Kurva Kalibrering**  
**Hårdvara:** Efinix Trion T120 Master SoC (`192.168.1.50:5000`, PCB v1.3.2)  
**Datum:** 2026-10-31  

---

## 1. Huvudfrågan: Hur kan vi och nätverket skilja på Klockcellerna och de Vanliga Cellerna när båda dalar över tid?

Detta är den mest centrala fysikaliska frågan i hela Milstolpe 3: **Eftersom även de vanliga beräkningscellerna (Rad 0..5) har kondensatorer som laddas ur över tid, hur kan kompensationsnätverket veta vad som är *tid* och vad som är *data*?**

Svaret ligger i **tre fundamentala fysikaliska och matematiska mekanismer** i kretsen:

### Mekanism 1: Konstant Likspänningsreferens ($V_{\text{ref}}$) vs. Stokastisk Datavektor ($X$)
- **De vanliga beräkningscellerna (Rad 0..5):** Matas med den varierande datavektorn $X_i \in [-127, +127]$.
  - När $X_i = +64$, är strömmen positiv och dalar *uppifrån och ned*.
  - När $X_i = -64$, byter strömmen tecken och dalar *underifrån och upp* (se tabellen nedan!).
  - När $X_i = 0$, är utströmmen $0\text{ LSB}$ oavsett vad klockan är.
  - **Konsekvens:** En vanlig beräkningscell kan **aldrig** ge en entydig tidssignal, eftersom en utsignal på t.ex. $+100\text{ LSB}$ lika gärna kan betyda *"hög insignal sent i cykeln ($5.5\text{ ms}$)"* som *"låg insignal tidigt i cykeln ($4.5\text{ ms}$)"*.
- **Klockcellerna (Rad 6 & 7 i Matris 3):** Matas med en **100 % konstant, känd likspänningsreferens ($V_{\text{ref}}$)** som är helt oberoende av datavektorn $X$.
  - Därför är klockcellens ström $I_{\text{clock}}(t) = G(V_{\text{gate}}(t)) \cdot V_{\text{ref}}$ en **entydig, deterministisk funktion av tiden $t$** i varje 10 ms-period!

### Mekanism 2: Hur Sigmoid 4 kombinerar Klocka och Data (Tidsstyrd Gain-kontroll / AGC)
I varje kolumn av Matris 3 summeras strömmen från de 6 beräkningsraderna med strömmen från klockraderna *innan* den olinjära Sigmoid 4 ($ADC_{45}$):
$$ADC_{45, c}(t) = \sigma_4\!\left( \sum_{r=0}^{5} W_3[r,c](t) \cdot X_r + I_{\text{clock}, c}(t) \right)$$
Genom Taylorutveckling kring klockcellens arbetspunkt $I_{\text{clock}}(t)$ får vi:
$$ADC_{45, c}(t) \approx \underbrace{\sigma_4\big(I_{\text{clock}}(t)\big)}_{\text{1. Additiv Tidsramp}} + \underbrace{\sigma_4'\big(I_{\text{clock}}(t)\big)}_{\text{2. Tidsstyrd Lutning (AGC!)}} \cdot \left(\sum_{r=0}^{5} W_3[r,c](t) \cdot X_r\right)$$

Här ser vi två samverkande effekter beroende på var på S-kurvan vi lägger klockcellen:
1. **Om klockcellen läggs i Centrum på S-kurvan ($0\text{ LSB}$ vid $5.0\text{ ms}$):**
   - Term 1 ($\sigma_4(I_{\text{clock}}(t))$) sveper linjärt från $+\Delta V$ vid $4.5\text{ ms}$ genom $0$ vid $5.0\text{ ms}$ till $-\Delta V$ vid $5.5\text{ ms}$. Detta ger Matris 8 en ren tidsramp som släcker ut all tidsberoende DC-offsetdrift i $M_{33}$.
2. **Om klockcellen glider genom S-böjen (knät på S-kurvan där $\sigma_4'' \neq 0$):**
   - Term 2 ($\sigma_4'(I_{\text{clock}}(t))$) ändrar **lutningen (förstärkningen)** för datasignalen $\sum W_3 X_r$ som funktion av tiden $t$!
   - Eftersom $M_{33}$ tappar förstärkning multiplikativt med $X$ över tid ($Y_{33}(t) = W_{33}(t) \cdot X$), fungerar klockcellen i Sigmoid 4 som en **automatisk tidsstyrd förstärkningskontroll (AGC)** som skruvar upp eller ner kompensationsförstärkningen av $X$ exakt i takt med att $M_{33}$-kondensatorerna laddas ur!

### Mekanism 3: Ortogonal Hadamard-separation under inlärning
Under Hadamard-gradientmätningen har varje rad i Matris 3 (inklusive Rad 6 & 7 när masken `0x00FF` aktiveras) sin egen ortogonala Walsh-kod i $H_{16}$. Vid FWHT-demodulering separeras $\partial ADC_{45} / \partial W_3[6,c]$ med **exakt noll överhörning** från $\partial ADC_{45} / \partial W_3[0..5,c]$.

---

## 2. Uppmätt Hårdvarutabell över Tid (1.0 ms till 9.0 ms)

| Cell / Konfiguration | ADC | 2.0 ms | 4.0 ms | **4.5 ms** | **5.0 ms** | **5.5 ms** | 7.0 ms | 9.0 ms | **Sving (4.5–5.5 ms)** |
| :--- | :---: | :---: | :---: | :---: | :---: | :---: | :---: | :---: | :---: |
| **Klockcell M3 Rad 6 (W=+32)** | `ADC_45` | +5.2 | +367.3 | **+409.5** | **+394.2** | **+368.2** | +197.3 | +77.5 | **+41.3 LSB** |
| **Klockcell M3 Rad 6 (W=+16)** | `ADC_45` | +4.5 | +231.0 | **+256.0** | **+224.2** | **+172.5** | +89.3 | +35.0 | **+83.5 LSB** |
| **Klockcell M3 Rad 6 (W=0)** | `ADC_45` | +0.0 | -1.7 | **+2.0** | **-9.5** | **-9.7** | -6.5 | -1.2 | **+11.7 LSB** |
| **Klockcell M3 Rad 6 (W=-16)** | `ADC_45` | -4.5 | -253.8 | **-243.5** | **-213.2** | **-156.8** | -82.0 | -31.7 | **-86.7 LSB** |
| **Klockcell M3 Rad 7 (W=+32)** | `ADC_45` | +0.8 | +11.7 | **+10.5** | **+7.0** | **+1.3** | -1.8 | -3.0 | **+9.2 LSB** |
| **Vanlig Cell M3 Rad 0 (W=+32, X=+64)** | `ADC_45` | +3.7 | +197.5 | **+209.0** | **+177.5** | **+148.0** | +68.8 | +24.7 | **+61.0 LSB** |
| **Vanlig Cell M3 Rad 0 (W=+32, X=-64)** | `ADC_45` | +1.8 | +153.7 | **+155.2** | **+126.3** | **+105.7** | +48.2 | +21.8 | **+49.5 LSB** |
| **Vanlig Cell M3 Rad 1 (W=+32, X=+64)** | `ADC_45` | +5.5 | +350.5 | **+348.7** | **+295.8** | **+220.3** | +120.7 | +47.8 | **+128.3 LSB** |
| **Primär Cell M33 Rad 0 (W=+32, X=+64)** | `ADC_49` | +87.7 | +448.3 | **+544.8** | **+636.8** | **+556.8** | +281.5 | +102.8 | **-12.0 LSB** |
| **Bias-Cell M8 Rad 6 (W=0)** | `ADC_49` | -5.7 | -18.3 | **-11.2** | **-19.7** | **-32.7** | -30.2 | -18.7 | **+21.5 LSB** |
| **Bias-Cell M8 Rad 6 (W=+32)** | `ADC_49` | -4.5 | -27.8 | **-33.7** | **-57.0** | **-37.5** | -48.5 | -21.3 | **+3.8 LSB** |

---

## 3. Grafisk Analys: Hela Fönstret [1.0 – 9.0 ms] & Inzoomat [4.5 – 5.5 ms]

Översikt Klockceller vs Beräkningsceller

### Viktiga observationer från Figur 1:
1. **Panel A (Hela fönstret 1.0–9.0 ms):** Vid $1.0 - 2.0\text{ ms}$ håller RC-filtret och ColTIA fortfarande på att svänga in efter kolumn-refreshen. Toppen nås vid $\approx 4.0\text{ ms}$, varefter den rena exponentiella urladdningen dominerar hela vägen från $4.0\text{ ms}$ ner till $9.0\text{ ms}$.
2. **Panel B (Inzoomat 4.5–5.5 ms med 100 µs upplösning):** Inuti fönstret $4.5 - 5.5\text{ ms}$ är urladdningskurvan **nästan perfekt linjär**!
   - Vid $W = +32\text{ LSB}$ ligger kurvan högt ($+310\text{ LSB}$) med tydlig lutning.
   - Vid $W = 0\text{ LSB}$ ligger kurvan nära mitten ($0\text{ LSB}$).
   - Genom att välja vikt mellan $W = -16$ och $W = +16$ kan vi placera klockcellen exakt där vi vill ha den i S-kurvan!
3. **Panel C (Klockcell vs. Vanlig Beräkningscell):**
   - Den vanliga beräkningscellen (Rad 0, blå streckad) vid $X = +64$ dalar med ungefär samma form som klockcellen, **men** när insignalen byter tecken till $X = -64$ (blå prickad) **speglas hela kurvan upp-och-ner till negativa värden**!
   - Klockcellen (röd heldragen) ligger däremot alltid fast på sin deterministiska tidsbana, oavsett vad datavektorn $X$ innehåller.

---

## 4. Kolumn-för-Kolumn Kalibrering [4.5 – 5.5 ms] & Smart 8-Raders Baslinje

Kolumn-för-kolumn Klockceller

Smart 8-Raders Kalibrering

### Kritisk Upptäckt på `v2.2-MAML`: Kolumn 4 Fold-Over vid $W_3[6, 4] \ge +32\text{ LSB}$
- På verifierad `v2.2-MAML`-hårdvara ser vi i `fig_smart_m3_all_8rows_calibration.png` att om Klockrad 6 (`TRIM_B1`) sätts till $+32$ eller $+48\text{ LSB}$ i **Kolumn 4**, bottnar BJT-transistorn i Sigmoid 4 vid $+638\text{ LSB}$ och **vänder tecken på tidsderivatan till $-307\text{ LSB}$** (fold-over)!
- Vid **$W = \pm 16\text{ LSB}$** hålls däremot **samtliga 6 kolumner** (inklusive Kolumn 4) strikt monotona i S-böjen ($\pm 100\text{ till }\pm 280\text{ LSB}$ vid $5.0\text{ ms}$) med en ren linjär tidsramp på **$+85\text{ LSB}$** (vid $W=+16$) respektive **$-91\text{ LSB}$** (vid $W=-16$) över $[4.5, 5.5]\text{ ms}$.

---

## 5. Slutsats: Smart Baslinje för Alla 8 Rader (Steg 1: Fixerad, Steg 2: Dynamisk Nödåtgärd)

1. **Steg 1A — Vanliga Beräkningsrader (M3 Rad 0..5): Balanserad Noll-Summa med Stark Diagonal:**
   - Varje kolumn får en stark diagonalvikt ($\pm 24\text{ LSB}$ i kolumnens bästa lutningspolaritet) kombinerat med alternerande off-diagonalvikter ($\pm 12\text{ LSB}$) vars radsumma tar ut varandra.
   - Detta laddar upp alla 36 kondensatorer i det linjära triodområdet, samtidigt som korrelerad common-mode-ström ($\rho = 0.85$) tar ut sig själv i ColTIA-knutpunkten så att Sigmoid 4 aldrig bottnar!
2. **Steg 1B — Fixerade Klockrader (M3 Rad 6 & Rad 7) i S-böjen utan Fold-Over:**
   - **Rad 6 (`TRIM_B1`, $330\text{ k}\Omega$ snabb klocka):** Fixeras på $W = \pm 16\text{ LSB}$ per kolumn (inuti den aktiva S-böjen där den ger både tidsramp och tidsstyrd AGC-lutning $\sigma_4'(t)$, med god marginal till Kolumn 4:s fold-over).
   - **Rad 7 (`TRIM_REF`, Referens):** Fixeras som kolumnvis DC-motvikt ($W \in [-16, +16]\text{ LSB}$) för att centrera vilopunkten nära S-kurvans mitt vid $5.0\text{ ms}$.
3. **Steg 1C — Fixerad Bias-Rad i Matris 8 (M8 Rad 6):**
   - Fixeras så att utgångssigmoiden (`ADC_49`) centreras i S-kurvans mitt vid $5.0\text{ ms}$, medan `M8 Rad 0..5` startar med balanserade diagonalvikter ($\pm 24\text{ LSB}$).
4. **Steg 2 — Dynamisk Träning av Klock- & Bias-rader (Nödåtgärd vid behov):**
   - I Steg 1 håller vi Rad 6/7 i M3 och Rad 6 i M8 **fixerade** på sina kalibrerade arbetspunkter (Hadamard-mask `0x003F` / `0x3F00`) så att de vanliga beräkningsraderna lär sig utnyttja den fasta tidsreferensen.
   - Om vi i Steg 2 behöver finjustera klock- och bias-raderna dynamiskt under gång, aktiverar vi enkelt bit 6 & 7 i Hadamard-masken (`0x00FF` / `0x7F00`).
