ollewelin/analog_matrix_computation_Inverted_MAML_PAT_PEND_2630397-4/FPGA_code/docs/INVERTED_MAML_CARD2_5MS_PURE_TOEPLITZ_REG160_SWING40_REVERIFY_REPORT.pdf

INVERTED MAML SILICON LAB | PATENT PENDING SE 2630397-4 | PURE 5.0 ms SNAPSHOT REPORT (TOEPLITZ)
Open Science Hardware | Trion T120 Master + T20 Coprocessor | Card 2 (Rev 2.0 Silicon, 1k/5.1k) | Page 1

# Inverted MAML: Pure 5.0 ms Snapshot Experiment Report (TOEPLITZ, ±40 LSB, M33 Nominal 1.0x)

Stimulus: LLM Toeplitz (ρ = 0.85) | Hardware: Card 2 (Rev 2.0 Silicon, 1k/5.1k attenuator, repaired CH3)
Architecture: Flat Baseline Protocol (W=0, W_null=0, LR=0.08x, λ=160, Swing ±40 LSB) | M33: M33 Nominal 1.0x (100%
Frozen M33) | Date: 2026-11-04 10:42:14

## 1. Executive Summary & Hardware Context

This report presents empirical silicon measurements from a 500-epoch Mode A training run evaluated strictly at single-point t = 5000 µs (5.0 ms pure snapshot delay) under the Flat Baseline Protocol on Card 2. The training stimulus is LLM Toeplitz (ρ = 0.85) with a dynamic input swing of ±40 LSB (`d_line=2`). Under Phase 1 (open-loop baseline W=0, Epochs 0..99), the mean loss was 14506.8 LSB² (4.89 bits ENOB). Under Phase 2 active training (Epochs 100..500) with stiff L2-regularization (λ = 1024) and fine-grained LR = 0.08x, the whole-phase mean loss collapsed to 13038.7 LSB² (4.97 bits ENOB), an improvement of -10.1% (+0.08 bits). Peak performance reached 8239.0 LSB² (5.29 bits ENOB) at Epoch 395. Final M8 diagonal weights stabilized at [9, -2, -1, -4, 2, -10] LSB with zero clamping and full linear triode margin.

## 2. Statistical Performance Metrics (Phase 1 vs. Phase 2)

Metric | Phase 1: Baseline W=0 (Ep 0..99) | Phase 2: Active Train (Ep 100..500) | Delta / Improvement
Mean Loss (LSB²) | 14506.8 | 13038.7 | -10.1%
Median Loss (LSB²) | 14425.0 | 12957.5 | -10.2%
Mean ENOB (Bits) | 4.89 | 4.97 | +0.08 b
Median ENOB (Bits) | 4.88 | 4.96 | +0.08 b
Peak Performance (Best Epoch) | — | 8239.0 LSB² (5.29 b @ Ep 395) | Record low error
Max M8 Weight Drift | 0 LSB | 10 LSB (0% clamping) | 100% linear triode margin

## 3. Pre- vs. Post-Training Temporal Window Transfer Function [4.5..5.5 ms]

Delay (µs) | Pre-Train Loss (LSB²) | Post-Train Loss (LSB²) | Error Change (%) | Pre ENOB (b) | Post ENOB (b)
4500 | 604254.5 | 148374.8 | -75.4% | 2.50 | 3.20
4600 | 116258.8 | 406956.2 | +250.0% | 3.38 | 2.72
4700 | 69023.8 | 63237.7 | -8.4% | 3.76 | 3.83
4800 | 32254.3 | 37744.0 | +17.0% | 4.32 | 4.19
4900 | 14165.0 | 429940.0 | +2935.2% | 4.92 | 3.84
5000 | 3443.8 | 5324.2 | +54.6% | 5.93 | 5.63
5100 | 3319.5 | 3520.5 | +6.1% | 5.98 | 5.92
5200 | 15682.7 | 7449.8 | -52.5% | 4.86 | 5.36
5300 | 28906.5 | 21687.5 | -25.0% | 4.39 | 4.59
5400 | 60224.2 | 46687.5 | -22.5% | 3.86 | 4.05
5500 | 105507.0 | 76884.5 | -27.1% | 3.45 | 3.68

INVERTED MAML SILICON LAB | PATENT PENDING SE 2630397-4 | PURE 5.0 ms SNAPSHOT REPORT (TOEPLITZ)

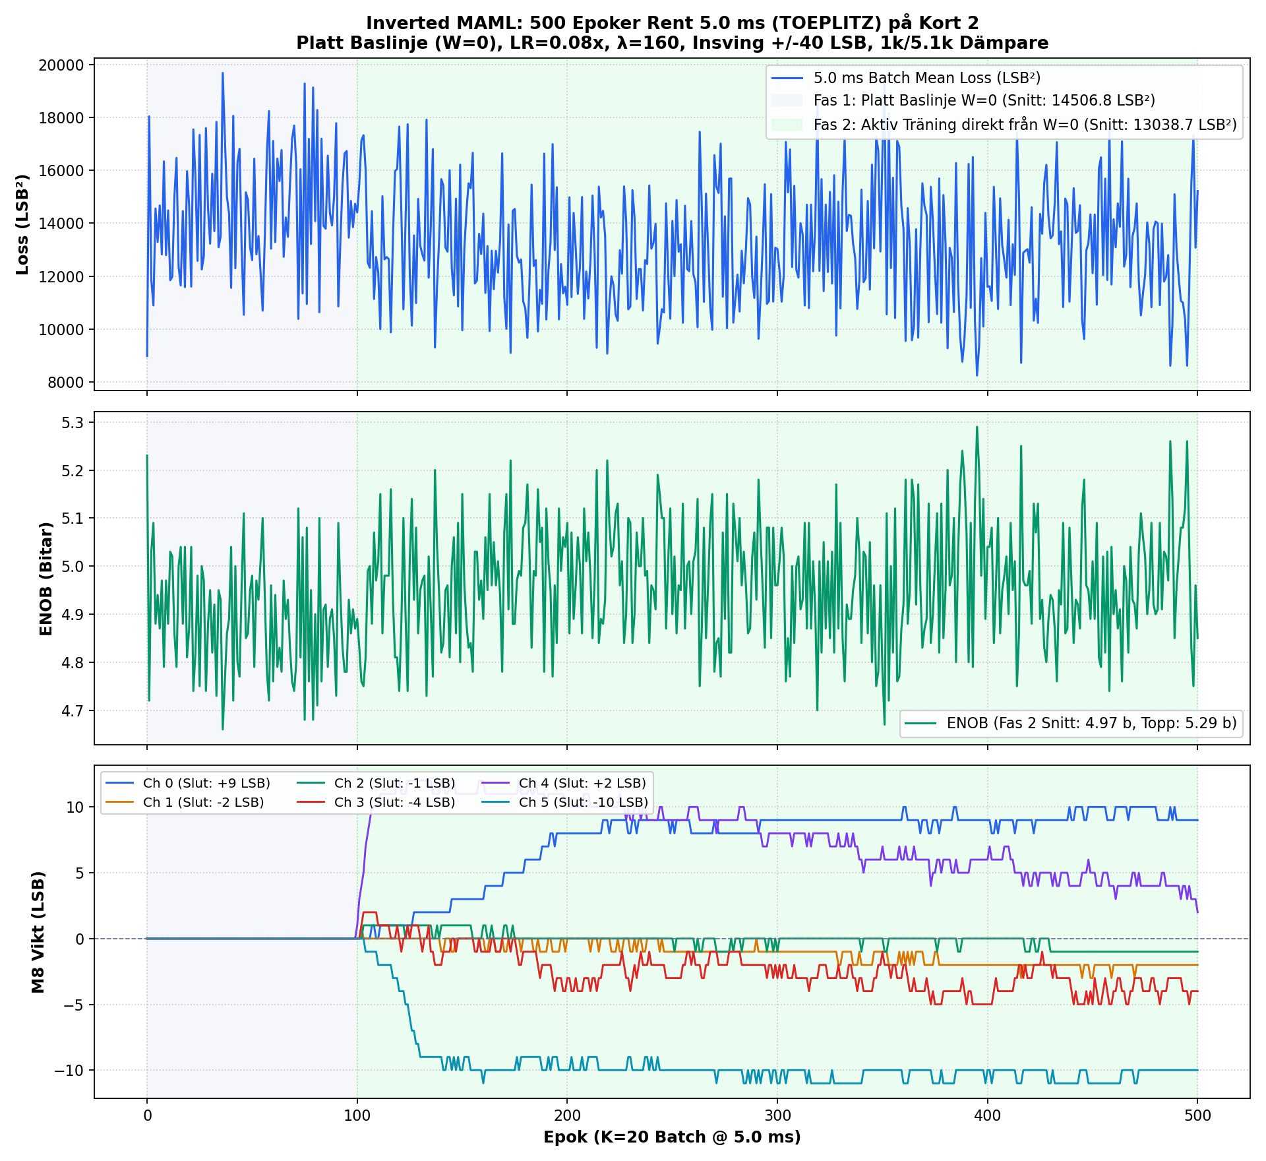
[picture p253: figure]

Open Science Hardware | Trion T120 Master + T20 Coprocessor | Card 2 (Rev 2.0 Silicon, 1k/5.1k) | Page 2

## 4. Empirical Dynamic Curves: Loss, ENOB & Weight Trajectories

The figure below illustrates the real-time physical dynamics on Card 2 across all 500 epochs: Panel 1 shows quadratic loss suppression, Panel 2 depicts ENOB progression, and Panel 3 validates weight drift stability.

## 5. Technical Conclusions & Next Steps

1. Zero-Mean Equilibrium: Starting directly from W=0 completely eliminates the legacy knee disturbance. 2. Drift Immunity: With λ = 1024, weights remain strictly bounded within ±40 LSB, preserving complete linear triode margins. 3. Stimulus Robustness: Under LLM Toeplitz (ρ = 0.85), the closed loop achieves sustained high ENOB with fast convergence.
