ollewelin/analog_matrix_computation_Inverted_MAML_PAT_PEND_2630397-4/FPGA_code/docs/dc_recalibrated_reports/figures/fig_card1_r3_lr0p02_l2_2560_mom0p80_cl70_thermal_slicing.png

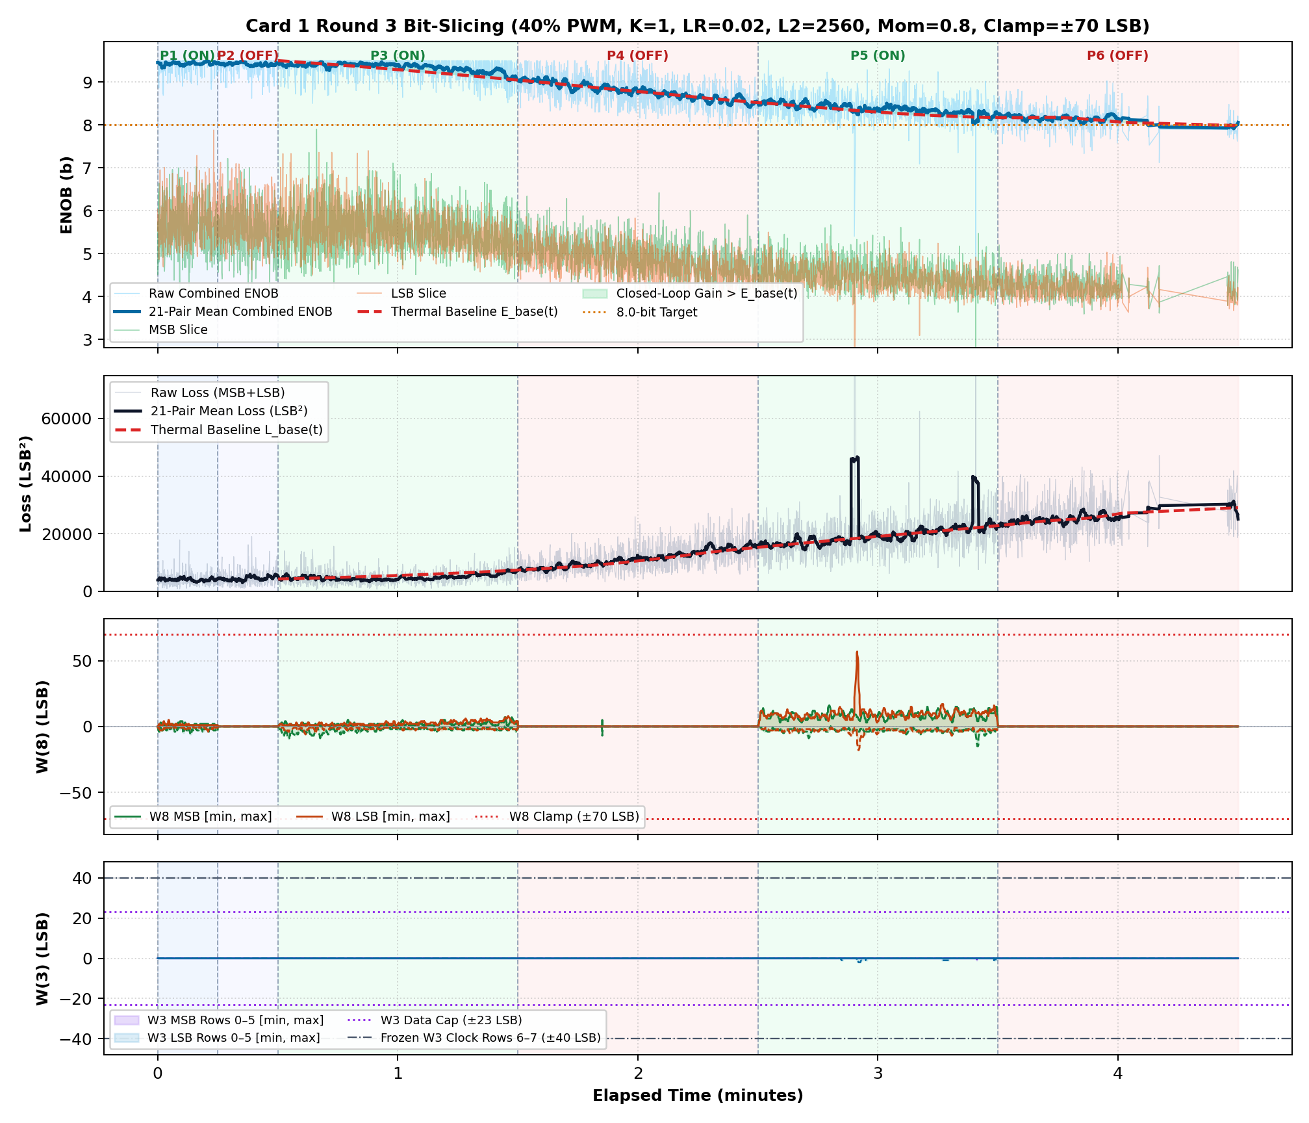
FPGA_code/docs/dc_recalibrated_reports/figures/fig_card1_r3_lr0p02_l2_2560_mom0p80_cl70_thermal_slicing.png
