ollewelin/analog_matrix_computation_Inverted_MAML_PAT_PEND_2630397-4/FPGA_code/docs/dc_recalibrated_reports/figures/fig_card1_r7_lr0p035_l2_768_mom0p90_cl75_thermal_slicing.png

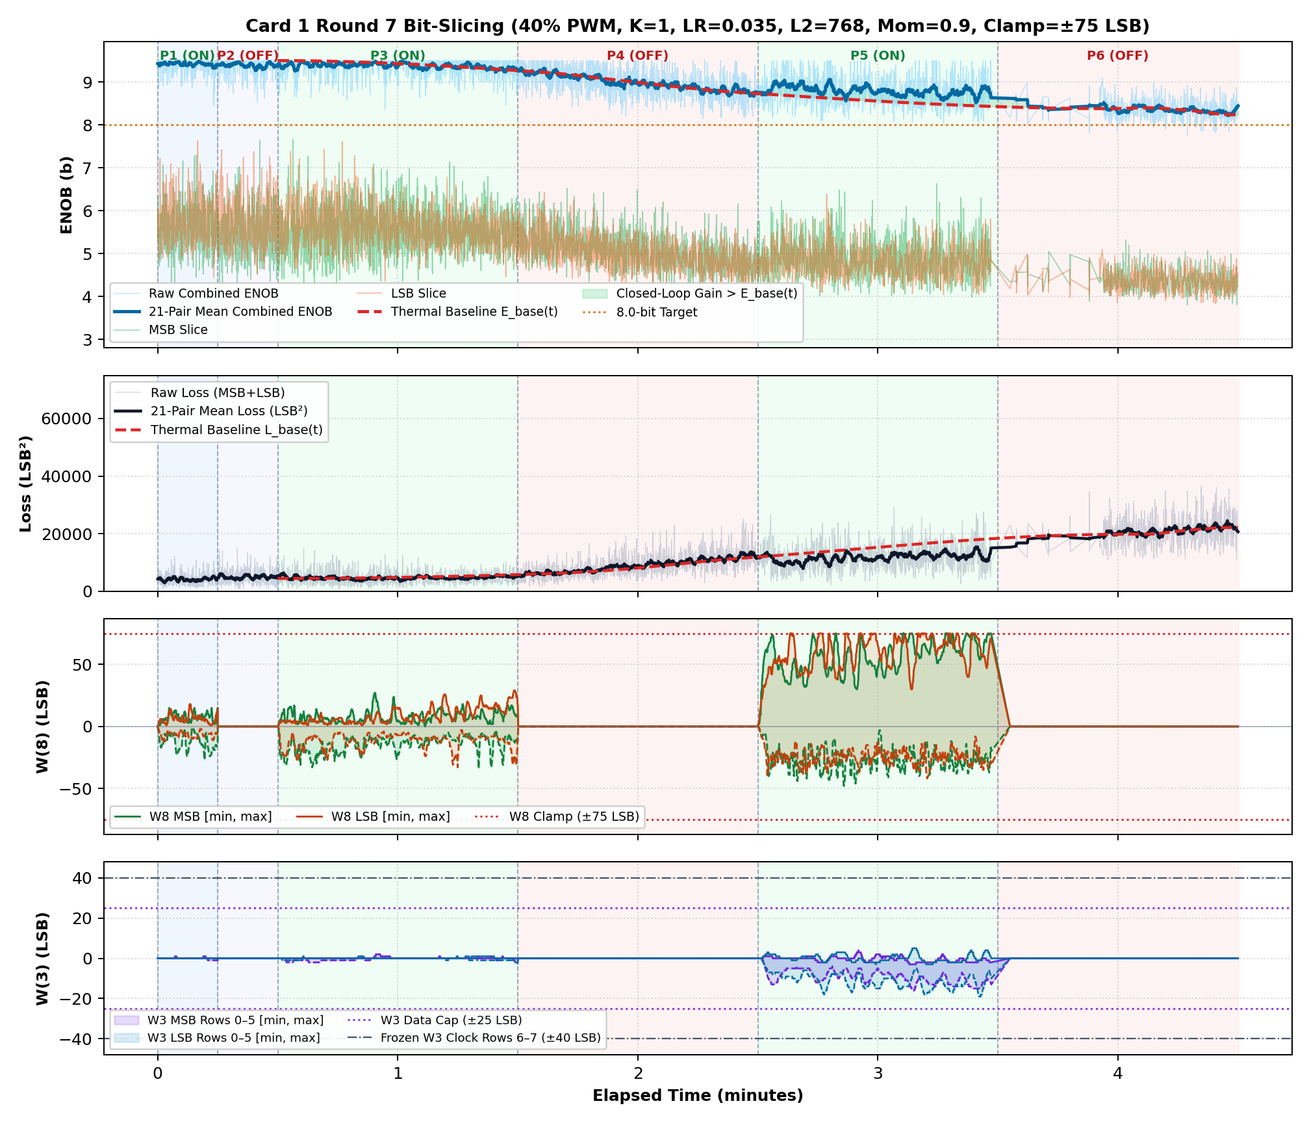
FPGA_code/docs/dc_recalibrated_reports/figures/fig_card1_r7_lr0p035_l2_768_mom0p90_cl75_thermal_slicing.png
