ollewelin/analog_matrix_computation_Inverted_MAML_PAT_PEND_2630397-4/FPGA_code/docs/dc_recalibrated_reports/figures/fig_card1_r8_lr0p04_l2_1536_mom0p82_cl75_w8_w3_all_weights.png

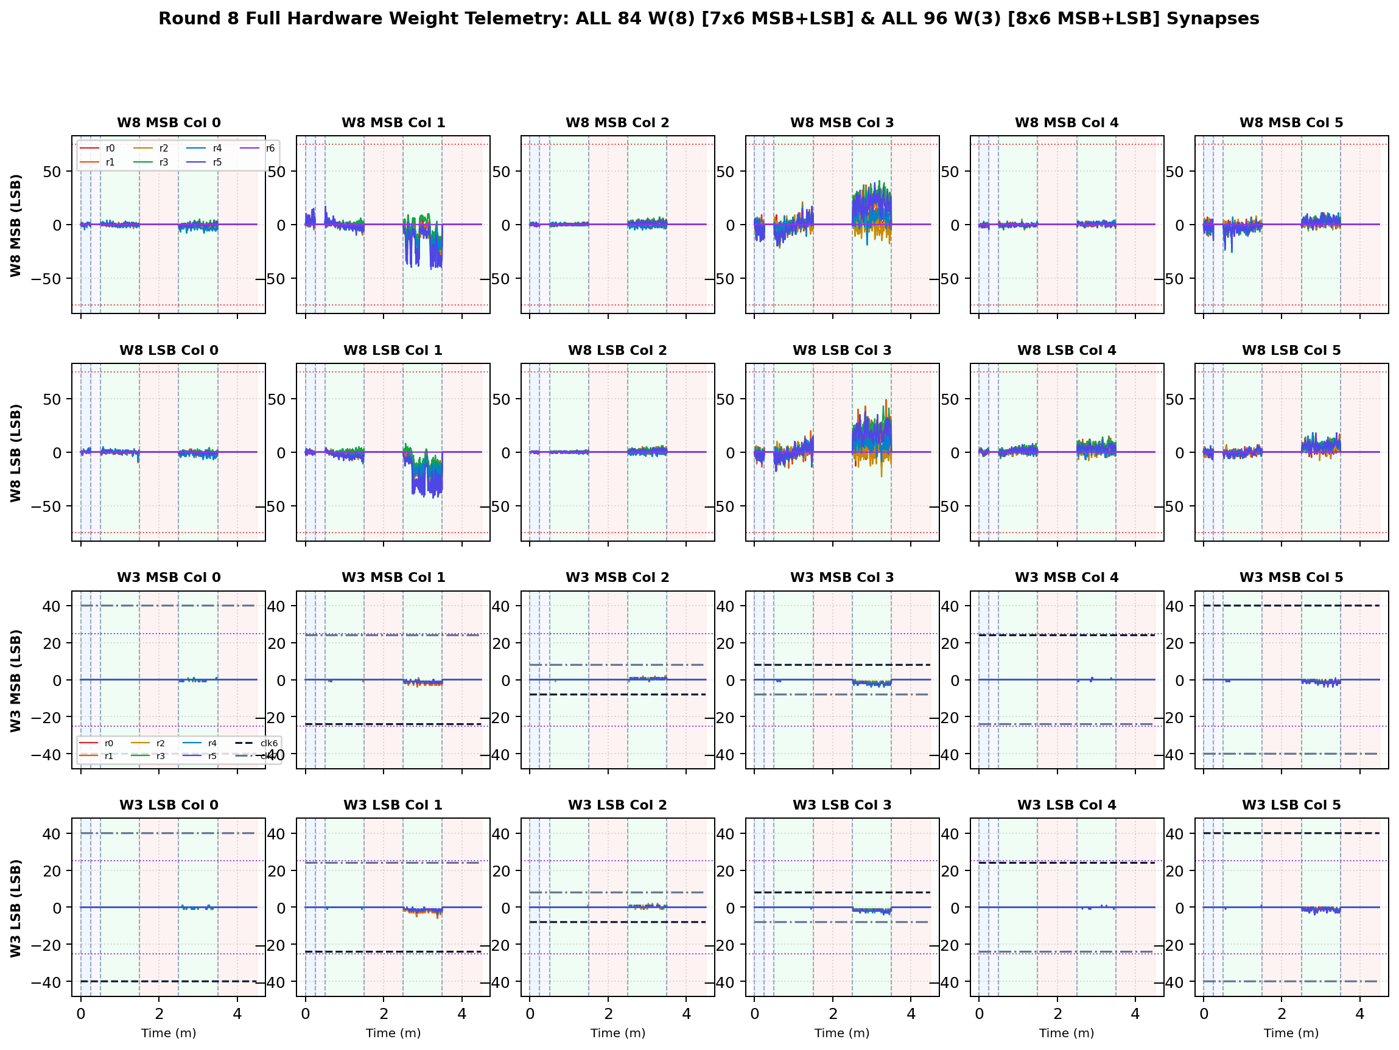
FPGA_code/docs/dc_recalibrated_reports/figures/fig_card1_r8_lr0p04_l2_1536_mom0p82_cl75_w8_w3_all_weights.png
