ollewelin/analog_matrix_computation_Inverted_MAML_PAT_PEND_2630397-4/FPGA_code/docs/figures/fig_1k15k_hardware_verification.png

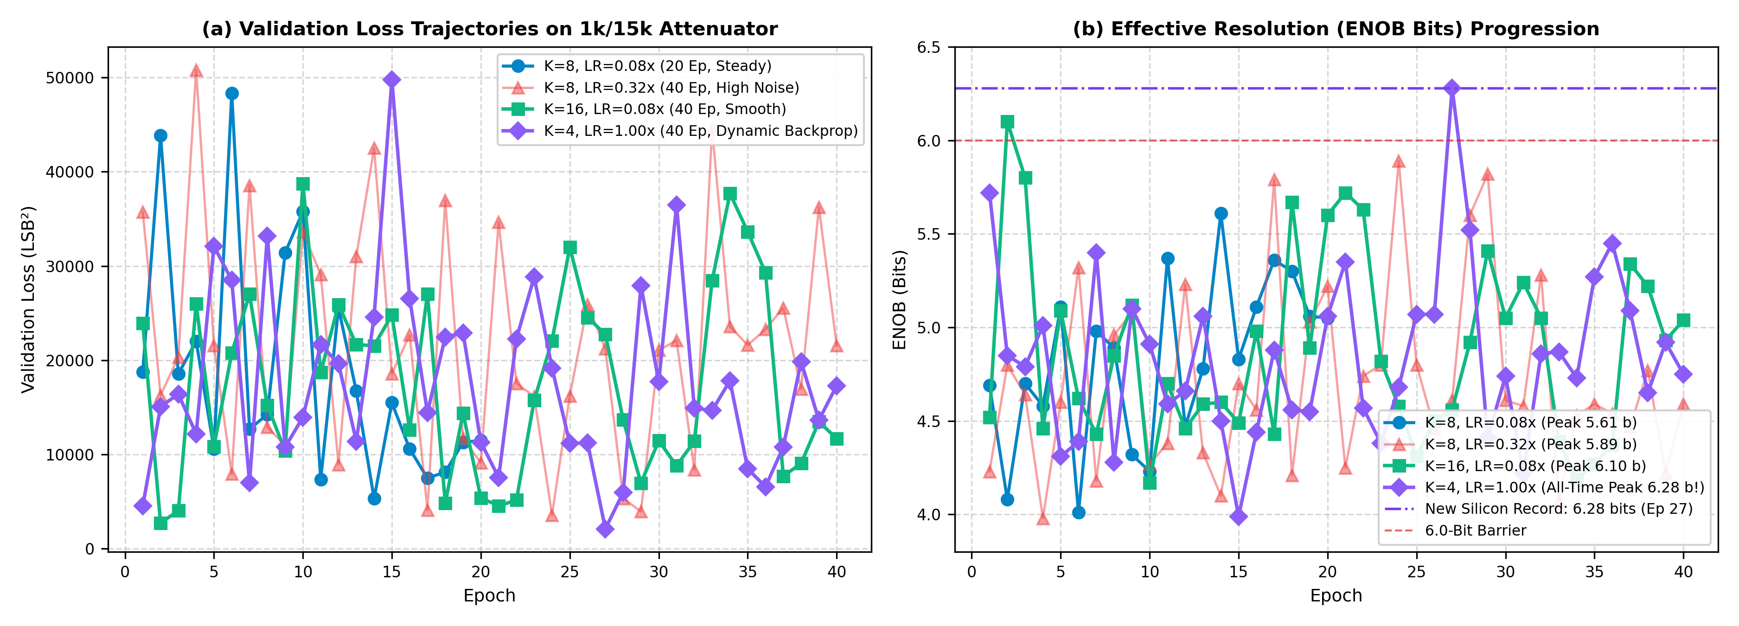
FPGA_code/docs/figures/fig_1k15k_hardware_verification.png
