ollewelin/analog_matrix_computation_Inverted_MAML_PAT_PEND_2630397-4/FPGA_code/docs/figures/fig_mode_a_500ep_broadened_4p5to5p5ms_rev2_1k3p9k_verified_t20a_k20_llm_k20.png

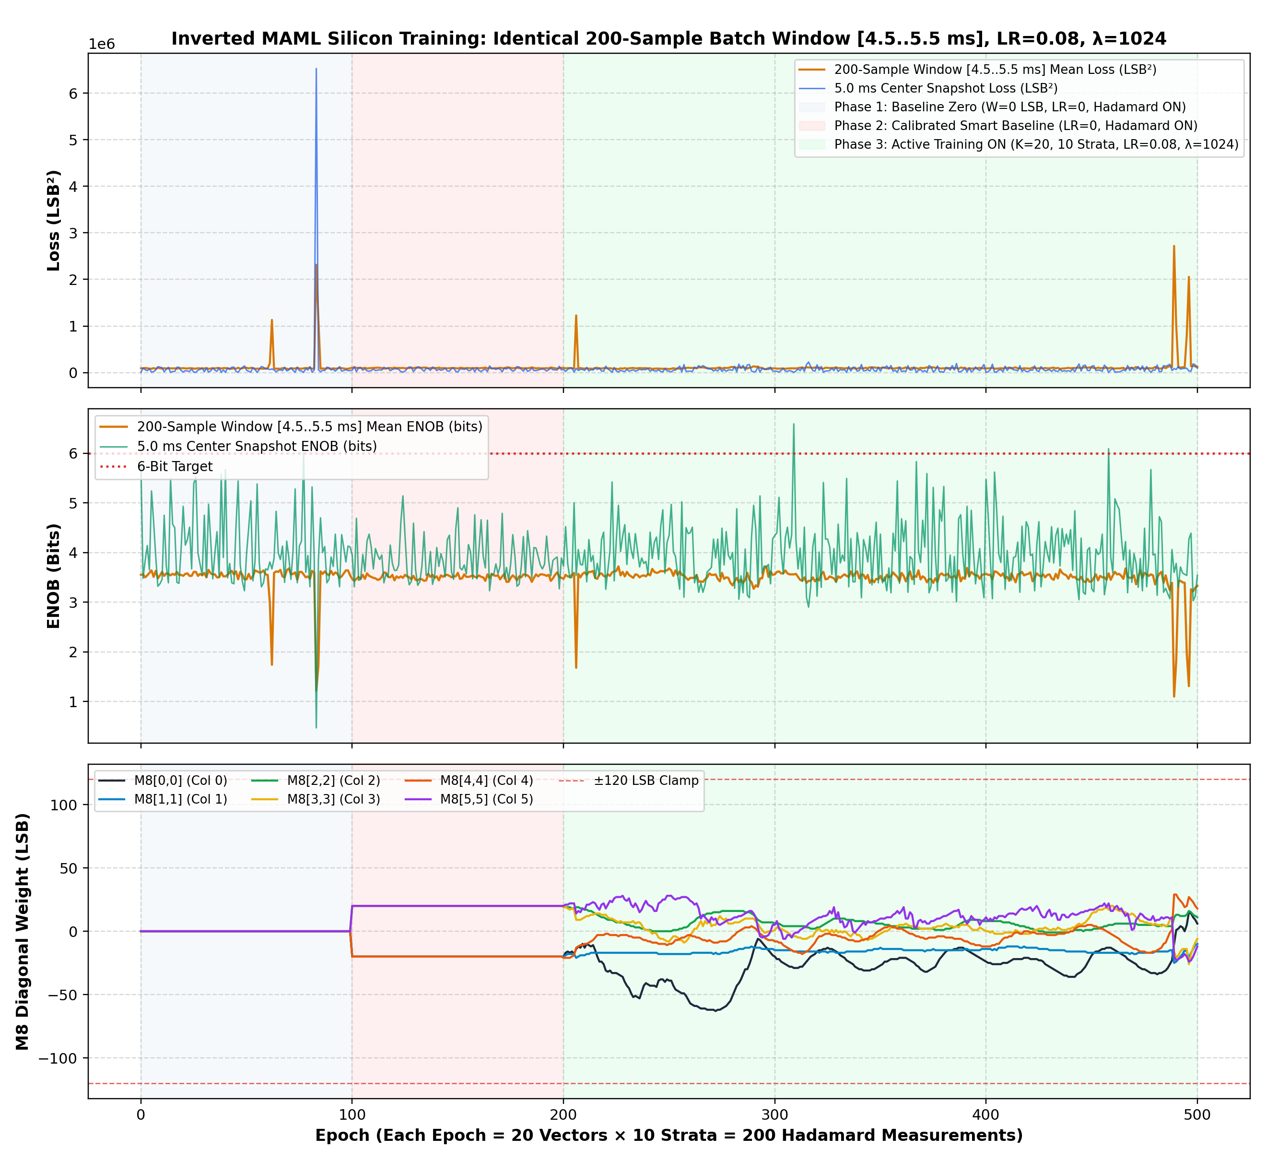
FPGA_code/docs/figures/fig_mode_a_500ep_broadened_4p5to5p5ms_rev2_1k3p9k_verified_t20a_k20_llm_k20.png
