ollewelin/analog_matrix_computation_Inverted_MAML_PAT_PEND_2630397-4/FPGA_code/docs/figures/fig_mode_a_500ep_llm_rho85_reg512_test_same_as_before.png

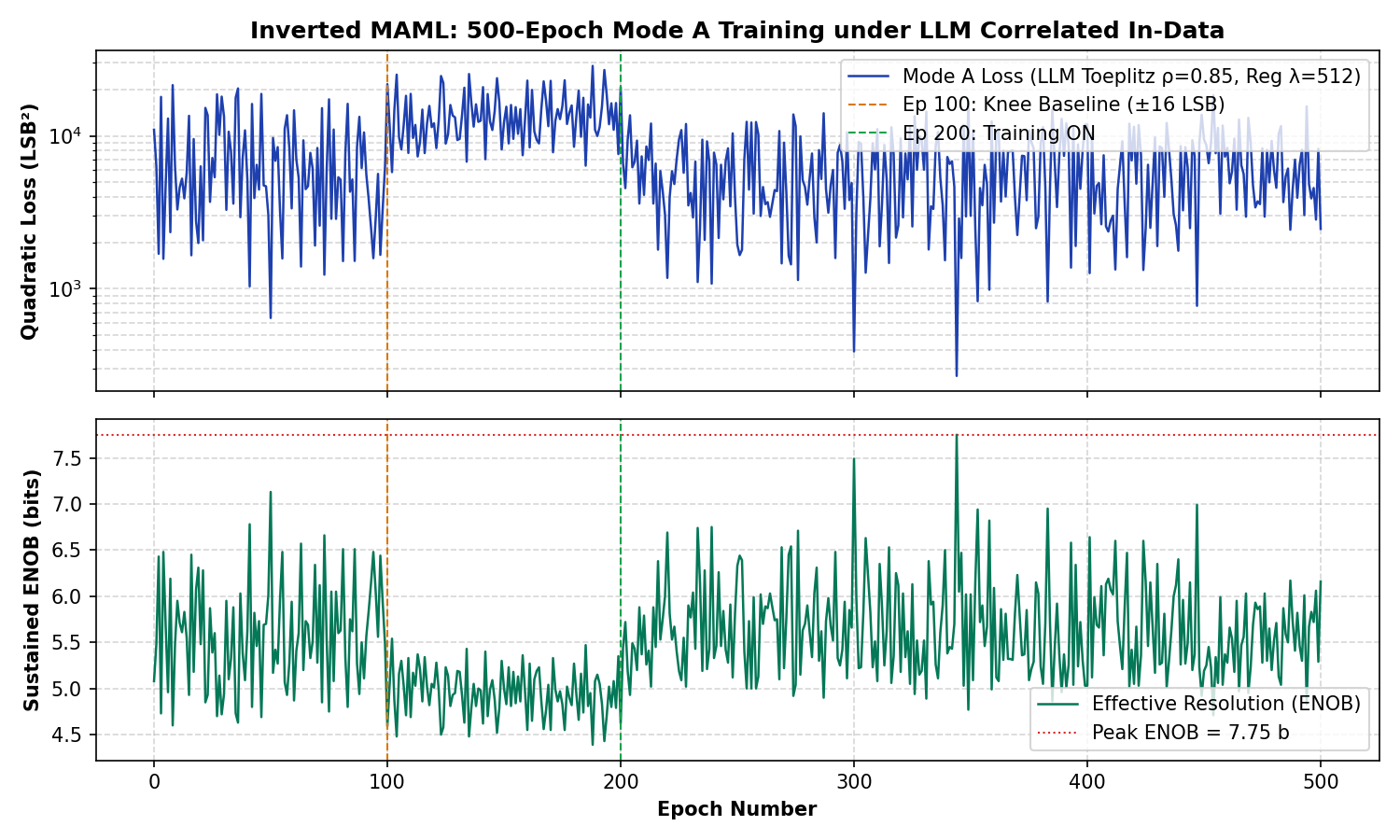
FPGA_code/docs/figures/fig_mode_a_500ep_llm_rho85_reg512_test_same_as_before.png
