ollewelin/analog_matrix_computation_Inverted_MAML_PAT_PEND_2630397-4/FPGA_code/docs/figures/fig_smart_m3_all_8rows_calibration.png

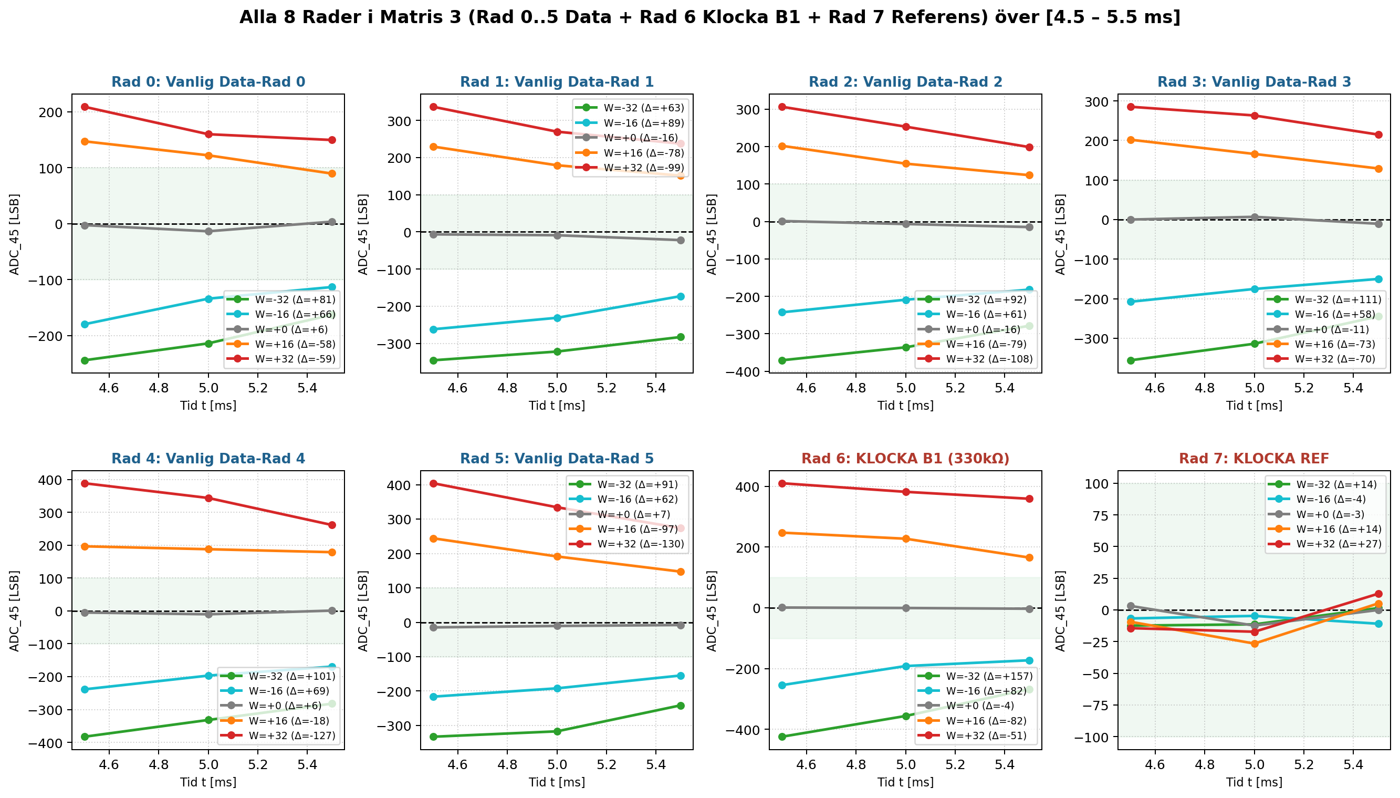
FPGA_code/docs/figures/fig_smart_m3_all_8rows_calibration.png
