ollewelin/analog_matrix_computation_Inverted_MAML_PAT_PEND_2630397-4/FPGA_code/logs/mode_a_lr_optimization_study/figures/fig3_lr_payload_validation_strata.png

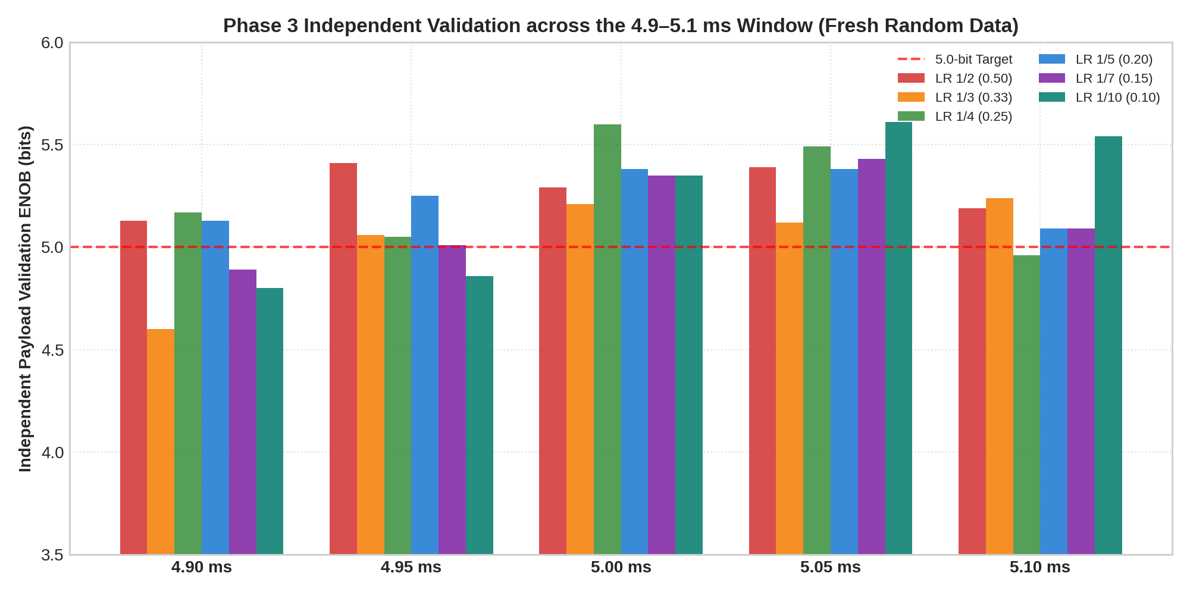
FPGA_code/logs/mode_a_lr_optimization_study/figures/fig3_lr_payload_validation_strata.png
