ollewelin/analog_matrix_computation_Inverted_MAML_PAT_PEND_2630397-4/FPGA_code/releases/Release_20261114_ModeA_Card1_BitSlicing_AntiWindup_Baseline_R1/reports_and_logs/dc_recalibrated_reports/figures/fig_card1_bs_comp_all_w3_weights.png

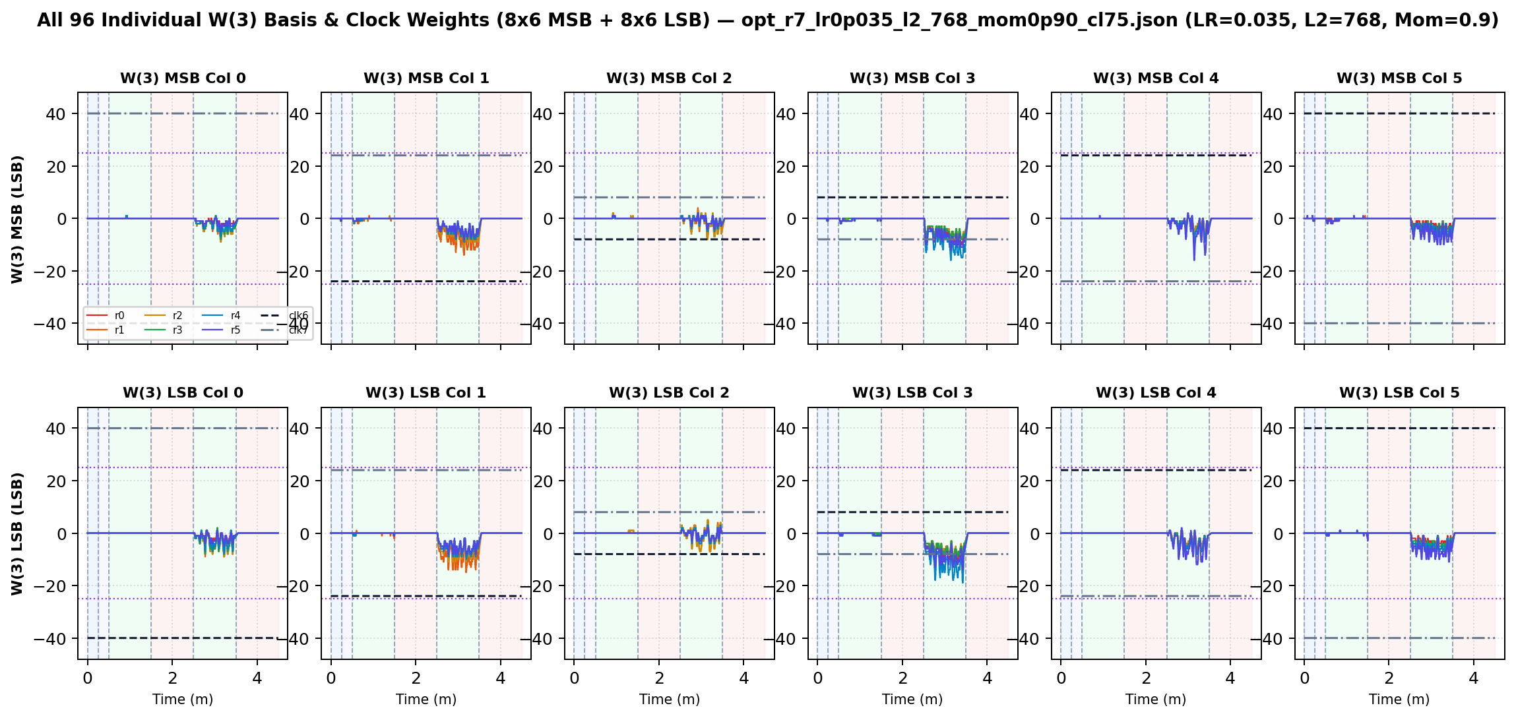
FPGA_code/releases/Release_20261114_ModeA_Card1_BitSlicing_AntiWindup_Baseline_R1/reports_and_logs/dc_recalibrated_reports/figures/fig_card1_bs_comp_all_w3_weights.png
