ollewelin/analog_matrix_computation_Inverted_MAML_PAT_PEND_2630397-4/simulator/results/compensation_phases.png

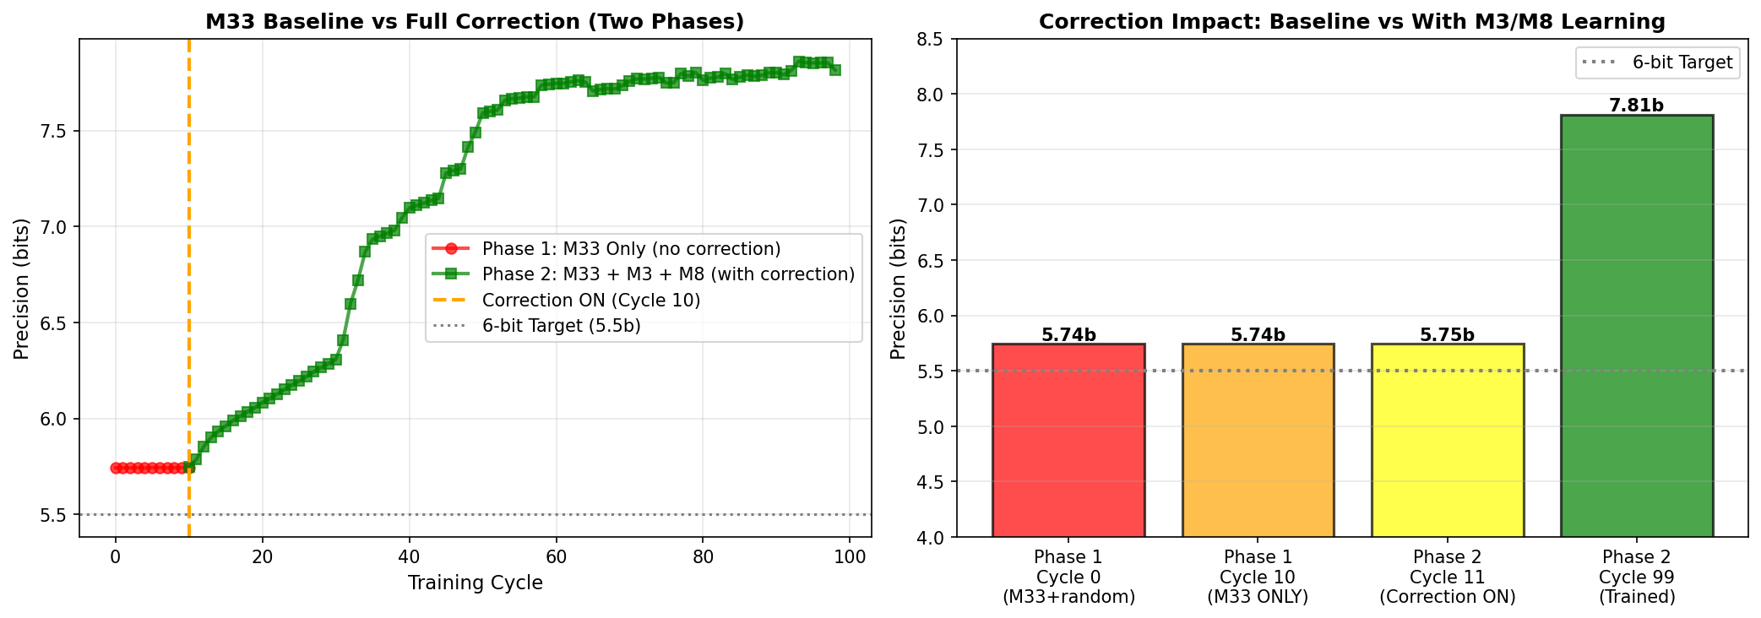
simulator/results/compensation_phases.png
