ollewelin/analog_matrix_computation_Inverted_MAML_PAT_PEND_2630397-4/simulator/results/convergence_20260707_174231.png

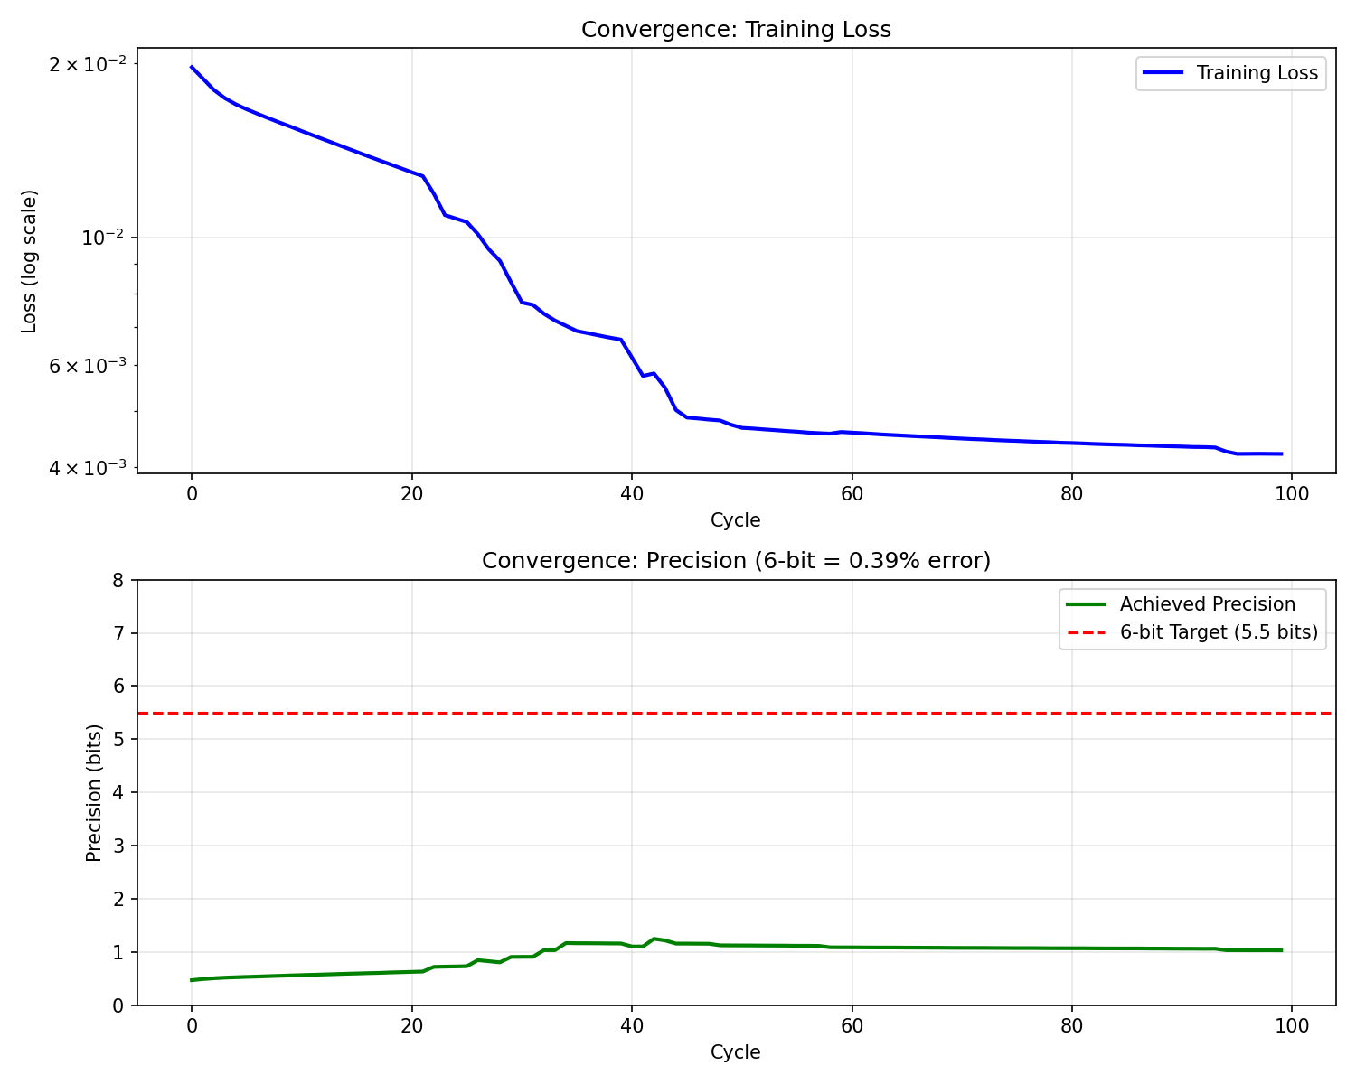
simulator/results/convergence_20260707_174231.png
