ollewelin/analog_matrix_computation_Inverted_MAML_PAT_PEND_2630397-4/simulator/results/cycle0_analysis.png

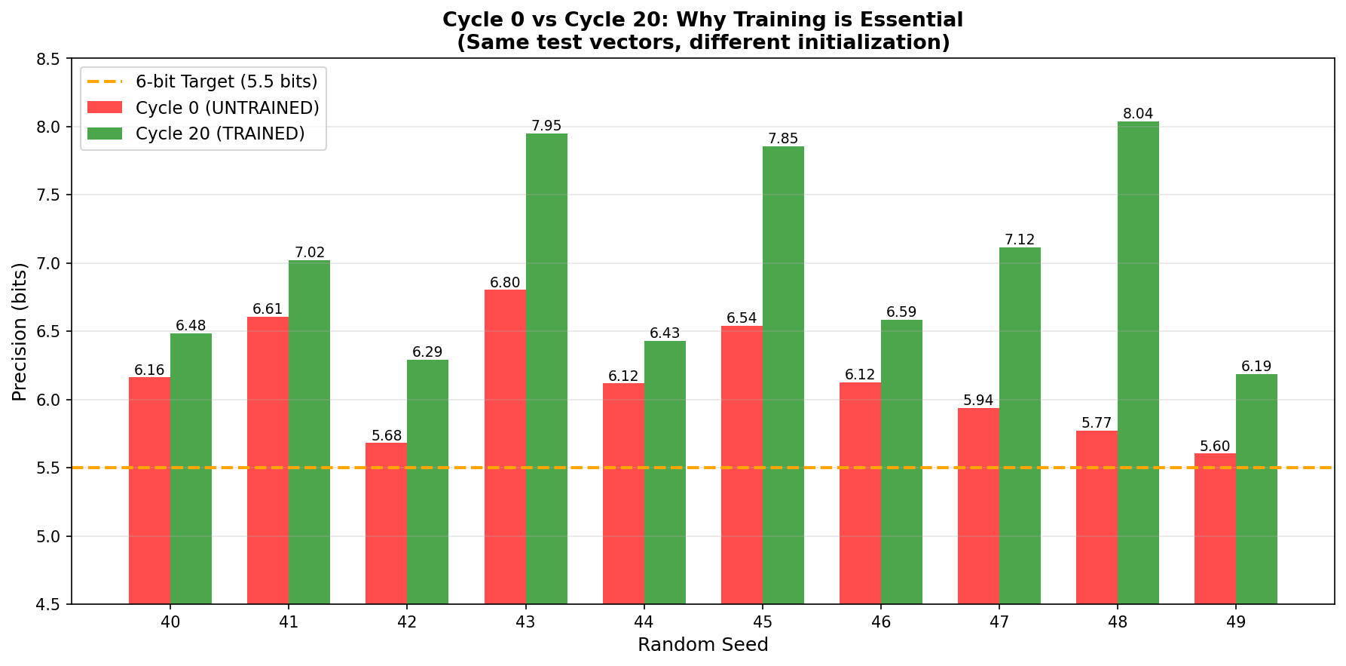
simulator/results/cycle0_analysis.png
