ollewelin/analog_matrix_computation_Inverted_MAML_PAT_PEND_2630397-4/simulator/results/direct_test_20260707_174721.png

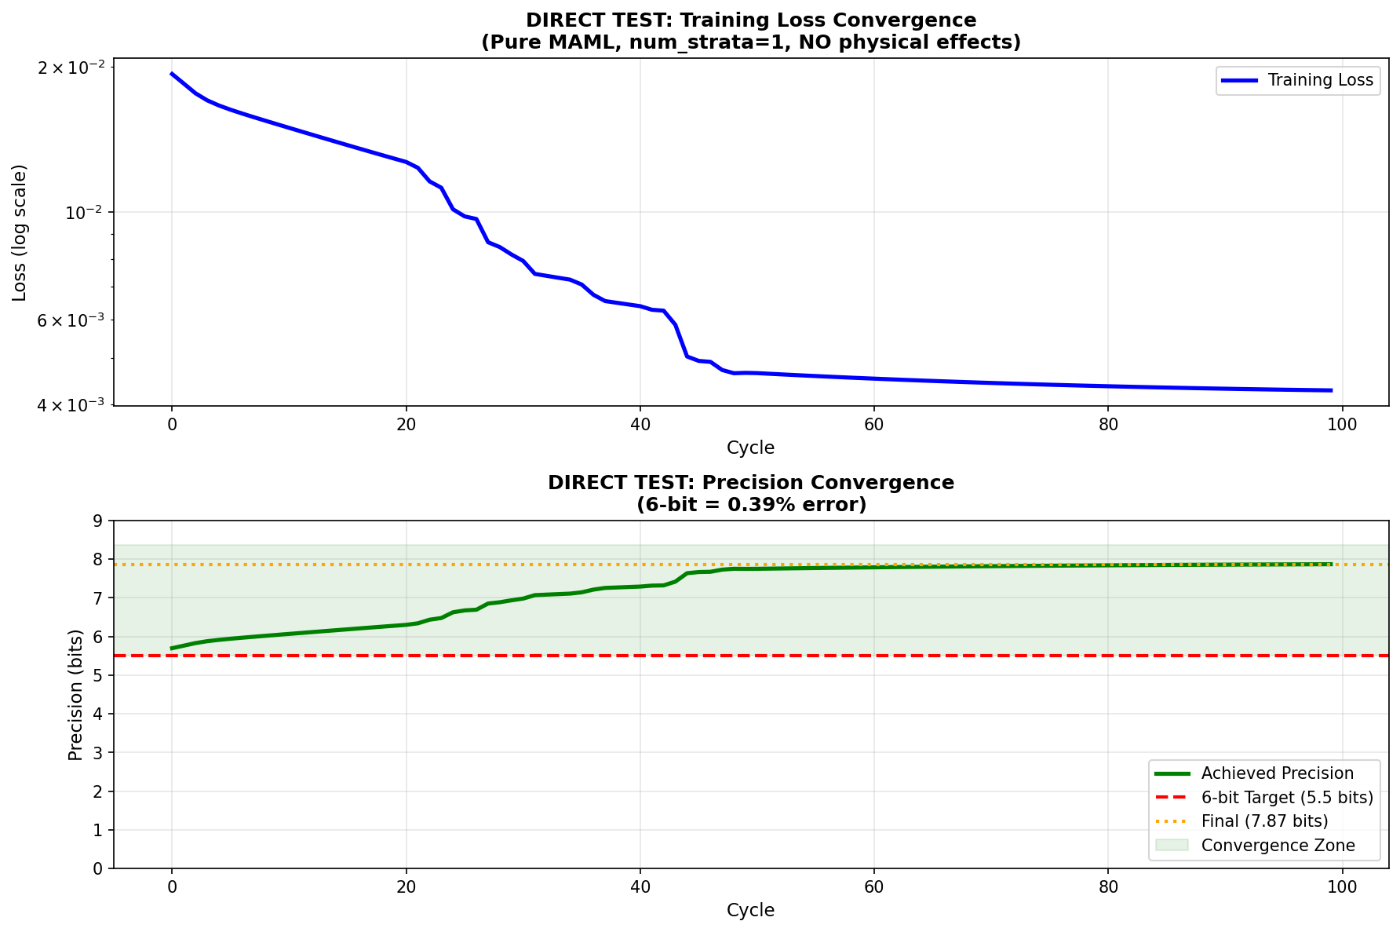
simulator/results/direct_test_20260707_174721.png
