ollewelin/analog_matrix_computation_Inverted_MAML_PAT_PEND_2630397-4/simulator_32x32/results_32x32/comparison/plot1_precision_comparison.png

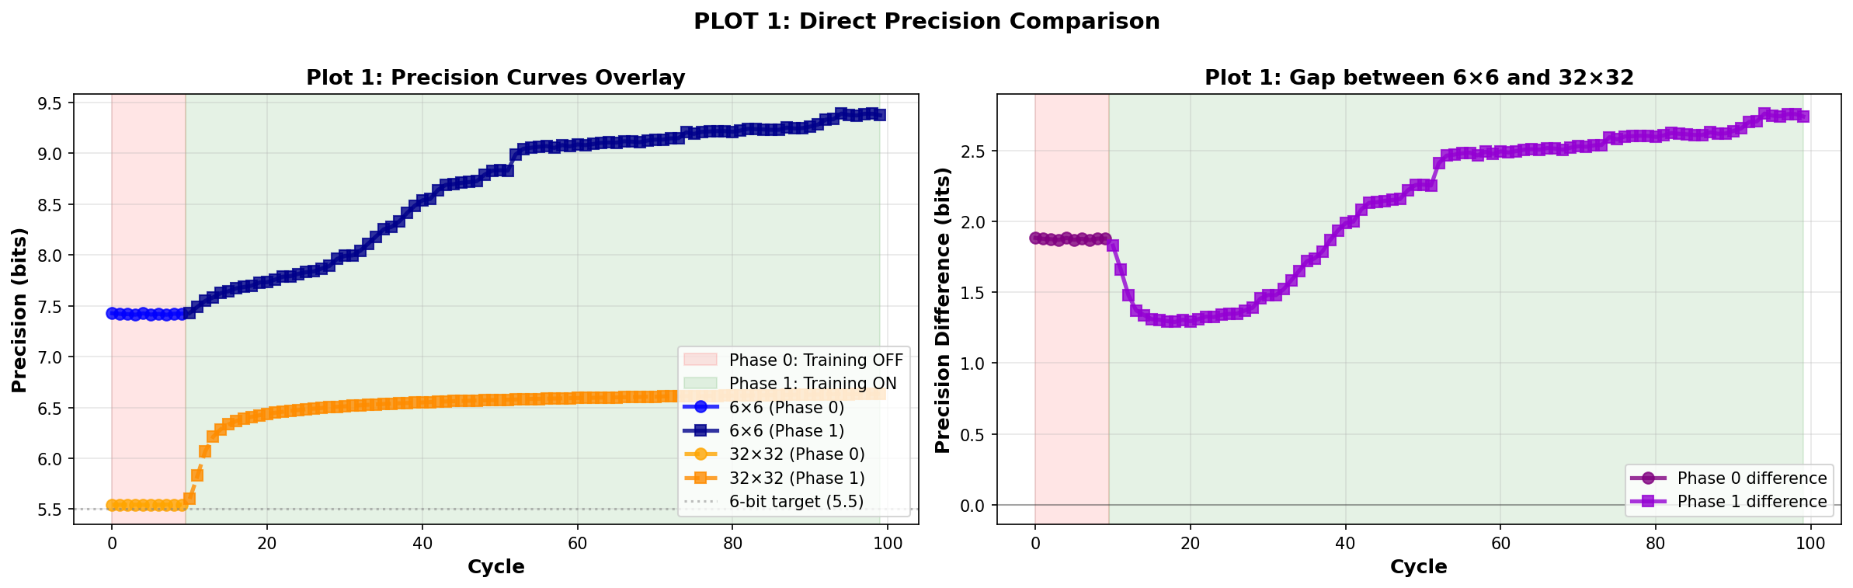
simulator_32x32/results_32x32/comparison/plot1_precision_comparison.png
