ollewelin/analog_matrix_computation_Inverted_MAML_PAT_PEND_2630397-4/simulator_32x32/results_32x32/two_stage_maml/03_stage1_vs_stage2_comparison.png

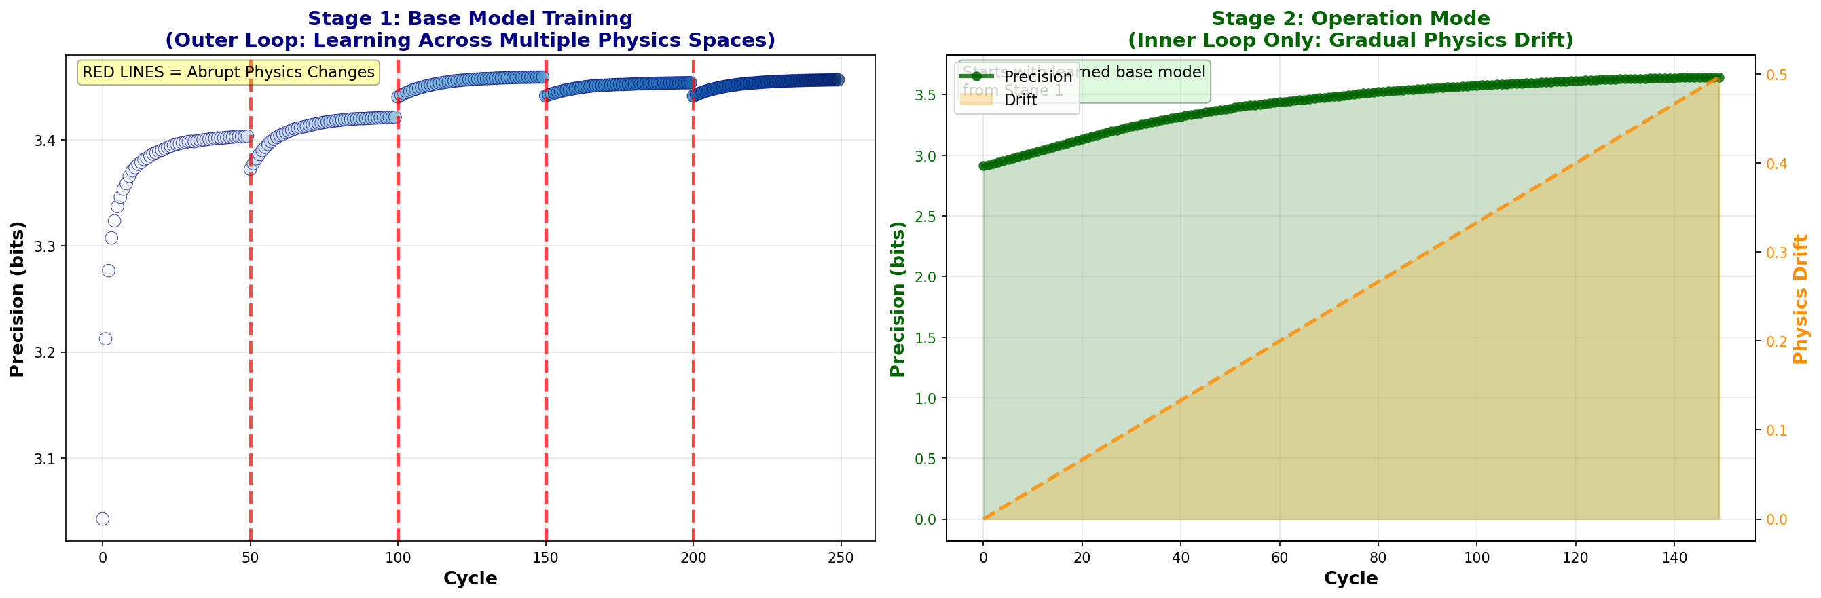
simulator_32x32/results_32x32/two_stage_maml/03_stage1_vs_stage2_comparison.png
