ollewelin/analog_matrix_computation_Inverted_MAML_PAT_PEND_2630397-4/simulator_32x32/results_32x32/two_stage_maml_8x8_with_baseline/04_baseline_vs_trained_8x8.png

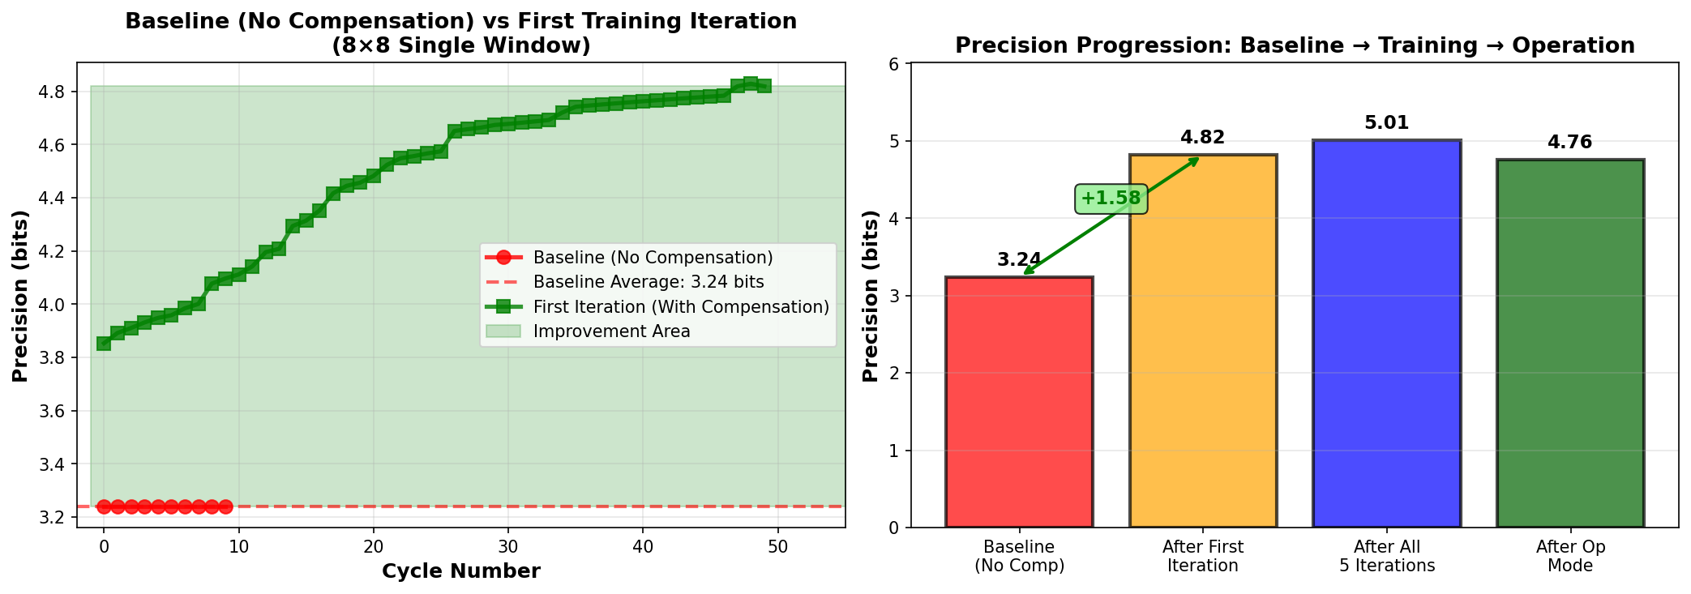
simulator_32x32/results_32x32/two_stage_maml_8x8_with_baseline/04_baseline_vs_trained_8x8.png
