ollewelin/analog_matrix_computation_Inverted_MAML_PAT_PEND_2630397-4/simulator_32x32/results_32x32/velocity_saturation/velocity_saturation_comparison.png

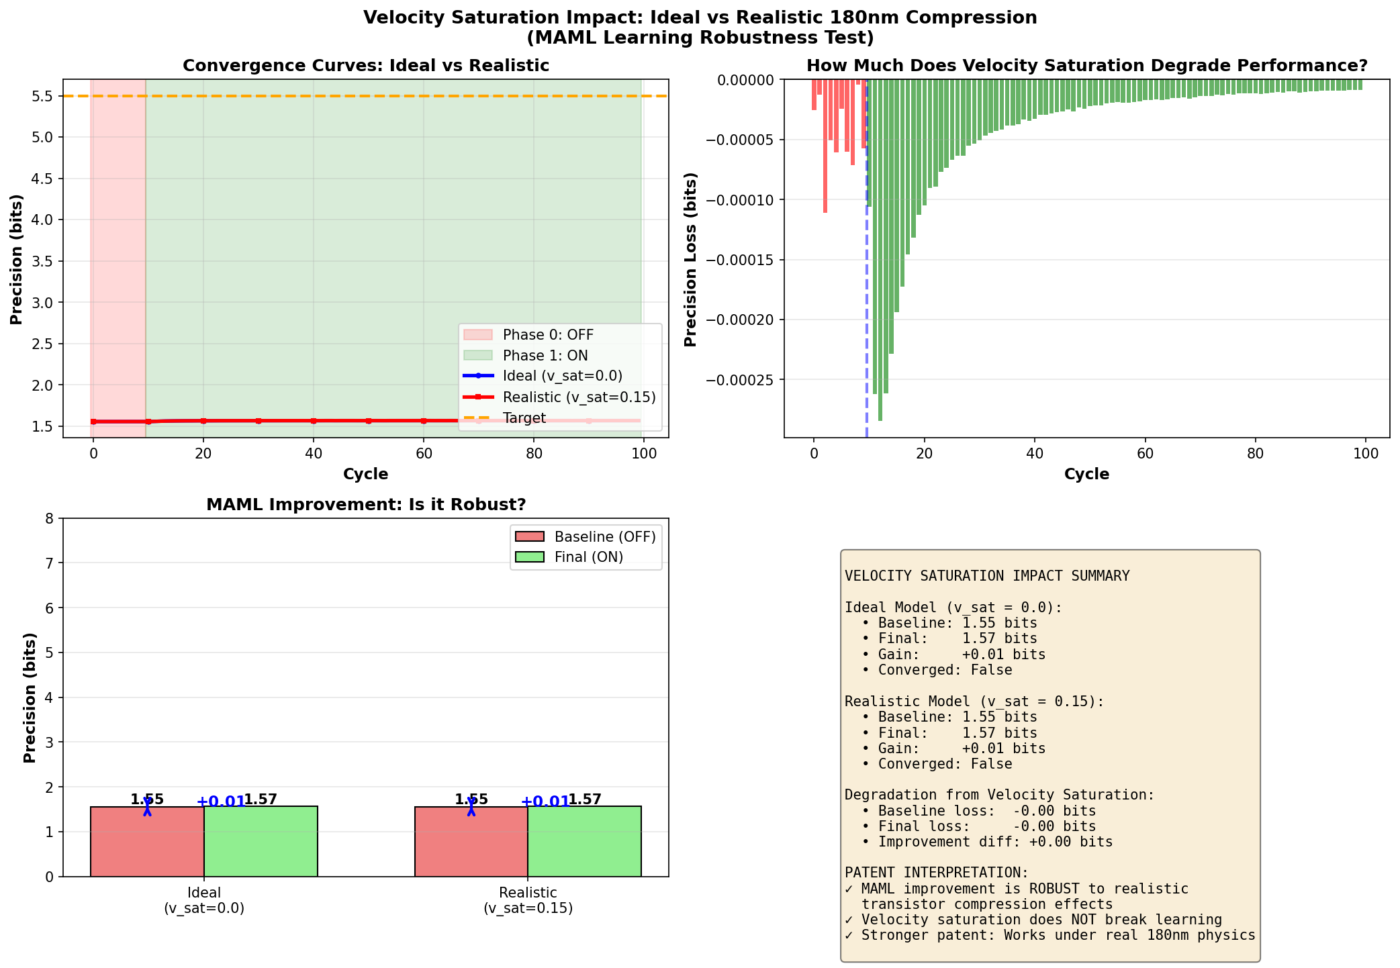
simulator_32x32/results_32x32/velocity_saturation/velocity_saturation_comparison.png
