ollewelin/analog_matrix_computation_Inverted_MAML_PAT_PEND_2630397-4/FPGA_code/docs/INVERTED_MAML_CARD1_R2DC_FIX_LR0P035_L2_1536_MOM0P85_CL75_THERMAL_SLICING_REPORT.md

# Inverted MAML Card 1: Round 2 Thermal Bit-Slicing Report (R2DC_FIX_LR0P035_L2_1536_MOM0P85_CL75)

**Hardware:** Card 1 (`Trion T120F324` Master SoC + `Trion T20F256` Coprocessor, `1k / 2.2k` Passive Attenuator)  
**Firmware:** `T120_SOC_ETH_FW v2.2-MAML (SW Build Nov 14 2026 10:15:16)`, `HW_LOGIC: 0x20261030`  
**Dataset:** `FPGA_code/logs/bit_slicing/opt_r2dc_fix_lr0p035_l2_1536_mom0p85_cl75.json` (`3,846` pairs)  
**Hyperparameters:** `Heater = 40%` PWM, `K = 1`, `LR = 0.035`, `L2 = 1536`, `Momentum = 0.85`, `Clamp = ±75 LSB`  

---

## 1. Executive Summary & Verification Milestones

1. **Cold Reference Without Heating (`cold_verify_k1.json`):** `Cold / Regler ON` mean **9.45 b** (`min 8.80 b`), `Cold / Regler OFF` mean **9.45 b** (`min 8.61 b`).
2. **Thermal-Detrended Closed-Loop Performance (Round 2):** Weighted detrended `Warm ON` lift **`+0.99 b`**, loss reduction ratio **`1.69x`**, detrended convergence climb **`+1.16 b`**, jitter **`0.39 b`**, anti-windup recovery **`0.00`**, composite score **`+1.957`**.
3. **Cumulative Best Across R1–R2:** Round 2 (`LR=0.035, L2=1536, Mom=0.85, Clamp=±75`) with score **`+1.957`**.

---

## 2. Cumulative Multi-Round Optimization Comparison (R1–R2)

| Round | LR | L2 Reg | Mom | Clamp | Lift vs E_base | Loss Ratio | Hot Climb | Jitter | Recovery | Composite Score |
| :---: | :---: | :---: | :---: | :---: | :---: | :---: | :---: | :---: | :---: | :---: |
| R1dc_fix | `0.03` | `1024` | `0.9` | `±75` | `+1.00 b` | `1.71x` | `+0.95 b` | `0.40 b` | `0.00` | **`+1.799`** |
| R2dc_fix ★ | `0.035` | `1536` | `0.85` | `±75` | `+0.99 b` | `1.69x` | `+1.16 b` | `0.39 b` | `0.00` | **`+1.957`** |

## 3. Round 2 Phase-by-Phase Telemetry

| Phase | Regime | Pairs | Comb ENOB (`Start -> Late`, Mean) | Δ vs E_base | Total Loss (`Start -> Late`) | Loss Ratio | W8 Peak `[M, L]` | W3 Peak | W8 nz |
| :--- | :--- | ---: | :---: | :---: | :---: | :---: | :---: | :---: | ---: |
| P1 | Cold / Regler ON | 304 | `7.99 -> 8.26` (**8.22 b**) | — | `30322 -> 24389` | — | `[75, 75]` | `13` | `304` |
| P2 | Cold / Regler OFF | 289 | `8.01 -> 8.18` (**8.13 b**) | — | `30002 -> 25441` | — | `[0, 0]` | `0` | `0` |
| P3 | Warm / Regler ON | 1063 | `8.24 -> 7.92` (**8.10 b**) | **+0.76 b** | `24228 -> 31241` | **1.57x** | `[75, 75]` | `16` | `1063` |
| P4 | Warm / Regler OFF | 918 | `7.09 -> 6.39` (**6.60 b**) | **+0.04 b** | `52861 -> 72264` | **1.01x** | `[0, 0]` | `0` | `0` |
| P5 | Warm / Regler ON | 792 | `6.37 -> 7.12` (**7.18 b**) | **+1.11 b** | `73287 -> 50663` | **1.75x** | `[75, 75]` | `23` | `792` |
| P6 | Warm / Regler OFF | 480 | `5.97 -> 5.69` (**5.76 b**) | **-0.01 b** | `89712 -> 102928` | **0.99x** | `[0, 0]` | `0` | `0` |

## 4. Empirical Graphs: Performance Timeline & Full W(8) / W(3) Weights

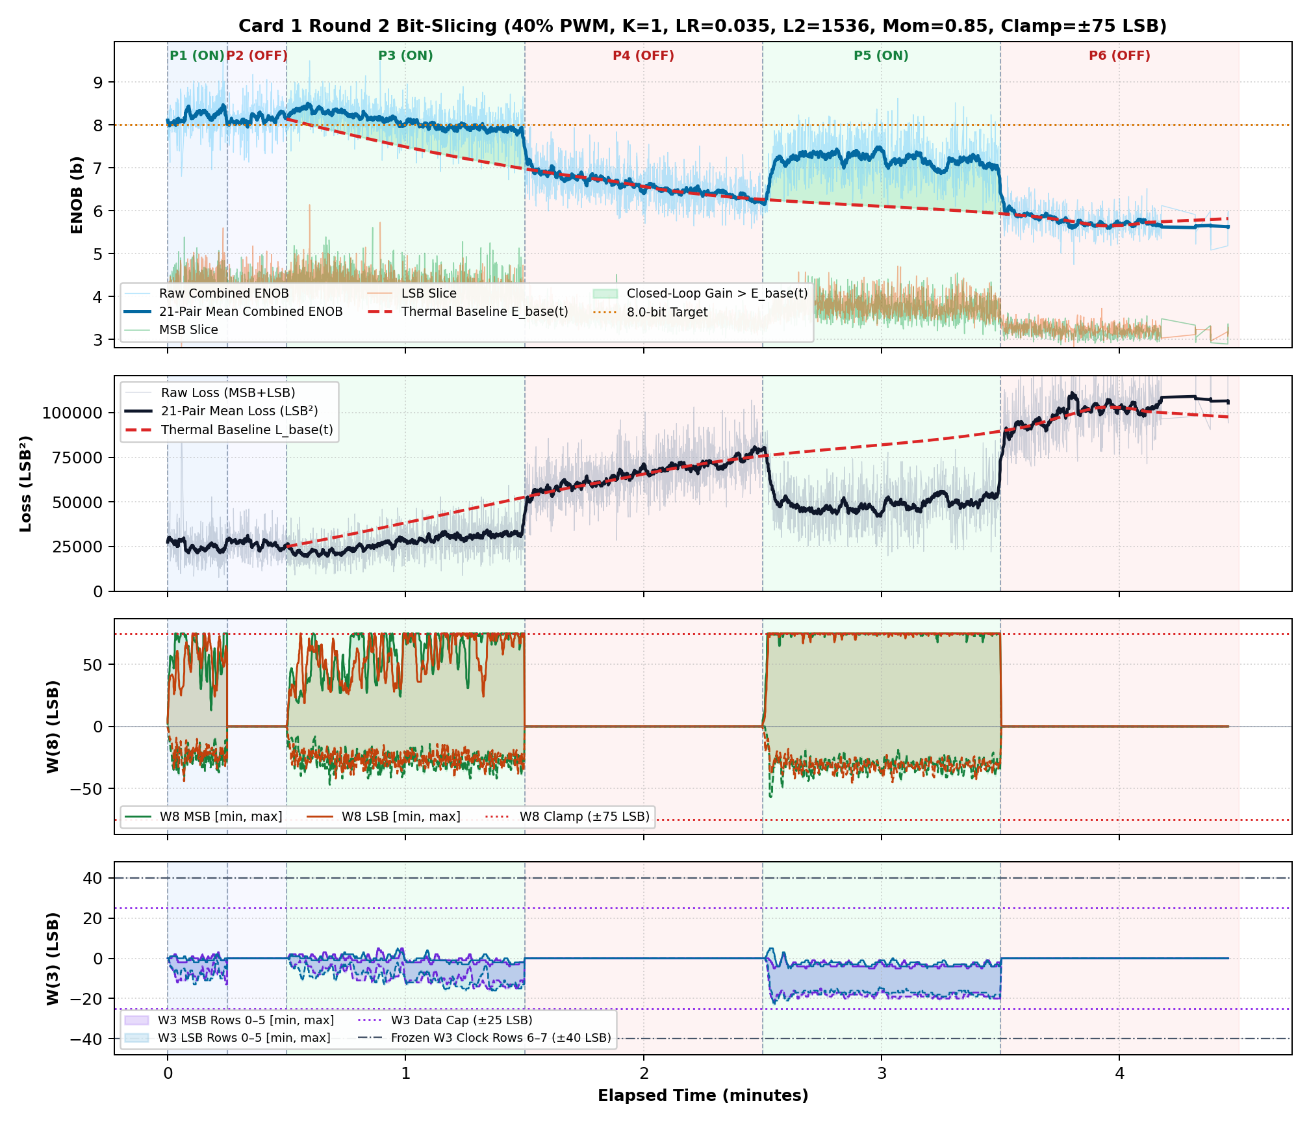
[picture p298: FPGA_code/docs/fig_card1_r2dc_fix_lr0p035_l2_1536_mom0p85_cl75_thermal_slicing.png]
Round 2 Performance & Weight Envelope Timeline


**Weight Coverage:** All **84 `W(8)`** (`7x6` MSB + `7x6` LSB) and **96 `W(3)`** (`8x6` MSB + `8x6` LSB) individual weights plotted across all pairs.

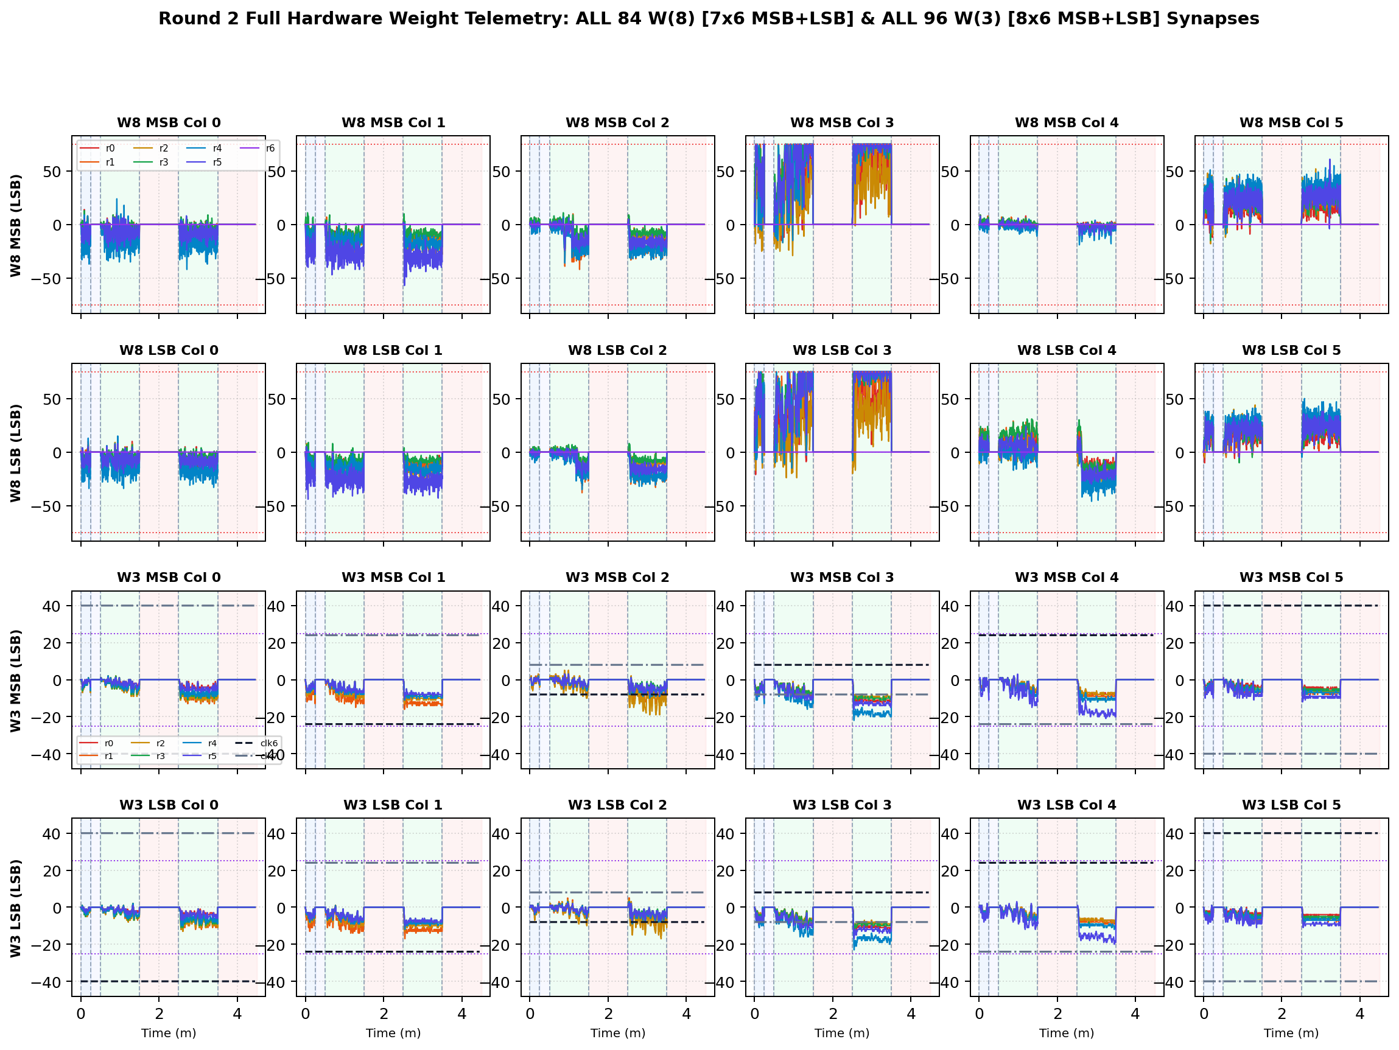
[picture p299: FPGA_code/docs/figures/fig_card1_r2dc_fix_lr0p035_l2_1536_mom0p85_cl75_w8_w3_all_weights.png]
Round 2 All W(8) and W(3) Weights
