ollewelin/analog_matrix_computation_Inverted_MAML_PAT_PEND_2630397-4/FPGA_code/docs/ANALOG_NEURAL_NETWORK_DYNAMIC_RANGE_AND_L2_REGULARIZATION_LESSONS_LEARNED.md

# Inverted MAML: Physical Dynamic Range Constraints, L2 Regularization & DC Calibration in Analog Neural Networks
### Comprehensive Engineering Lessons Learned on Substrate Sensitivity, Rail Saturation & the Physical Balancing Act

> **Patent Reference**: SE 2630397-4 (Open Science Hardware)  
> **Silicon Engine**: Dual-FPGA Inverted MAML Master Platform (Trion T120 SoC + T20 Matrix Controller)  
> **Substrate**: Dual-2T1C Silicon Triode Multipliers (M33, M3, M8), Single-Supply ColTIA Amplifiers & Sigmoid Networks  
> **Authors**: Inverted MAML Engineering Team  
> **Date**: November 3, 2026  

---

## 1. Abstract & Core Thesis

Unlike digital neural networks running in IEEE-754 floating-point arithmetic (where dynamic range exceeds $10^{38}$ and clipping is virtually non-existent), **Analog Neural Networks (ANNs) operate within narrow, bounded physical voltage rails (0 to 3.3V) and finite transimpedance headroom**. 

On physical analog silicon, internal stages—specifically the ColTIA transimpedance amplifiers, the Dual-2T1C differential triode multipliers, and the bipolar sigmoid activation networks—readily hit their non-linear limits ("bottnar") if quiescent levels are not precisely controlled. 

This paper articulates the fundamental discovery made during hardware characterization across Card 1 and Card 2:
> **In an analog neural substrate, L2 Regularization and DC Calibration are not independent algorithmic options—they form a tightly coupled, mandatory physical balancing act.**  
> - Without DC Calibration, the L2 regularizer acts as an unyielding "rubber band" that permanently tethers the weights to an asymmetric, non-zero operating point, fighting gradient descent and causing severe steady-state error.  
> - Without L2 Regularization, unconstrained gradient drift drives analog multiplier weights into rail-to-rail saturation ($\pm 127\text{ LSB}$) or chaotic high-variance oscillation zones.  
> - Operating together, accurate DC Calibration centers the quiescent point directly in the highest-transconductance linear window, while L2 Regularization provides the stabilizing restorative force that keeps the analog weights centered in that window under dynamic arbitrary inputs.

---

## 2. Digital Software vs. Physical Silicon: The Fundamental Divergence

The intuition that *"the network will simply learn to compensate for any static DC offset by itself during training"* is an artifact of digital software simulation. In physical silicon, this intuition fails completely:

```
===================================================================================================================
PARAMETER / BEHAVIOR          DIGITAL NEURAL NETWORK (GPU / PYTORCH)       ANALOG NEURAL NETWORK (INVERTED MAML)
===================================================================================================================
Dynamic Range                 Practically infinite (float32: ~150 dB)       Extremely bounded (single-supply 3.3V, ~66 dB)
Saturation Boundary           None (unless explicit activation clip)        Hard rail clipping at ground and supply rails
Carrier Demodulation          Not applicable (direct mathematical product)  Hadamard carrier wave modulation (500 kHz)
Effect of Clipping            Numerical truncation                          Generates PHANTOM GRADIENTS (false directions)
Weight Penalty (L2 λ)         Abstract loss regularization                  Mechanical "rubber band" pulling toward baseline
Quiescent DC Offset           Trivially absorbed into bias parameters       Biases amplifiers into non-linear compression
===================================================================================================================
```

---

## 3. The Anatomy of Analog Rail Saturation ("Bottning")

When analog signals traverse the physical Inverted MAML compute loop, they encounter three distinct physical stages, each with strict headroom limits:

```
    In-Data (DAC2) ──► Matrix 33 (Triode) ──► Summing Junction ──► ColTIA TIA Stage ──► Sigmoid 4 (Ref 4) ──► ADC_49
                             ▲                        │                      │                    │
                             │                  [Attenuator]                 │              [Matrix 8]
                     [Hadamard Carrier]               ▼                      ▼                    ▲
                                                 Shunt to GND        Single-Supply Rail   Saturation Tail
                                                 (3.9k vs 5.1k)        (-1797 LSB Floor)    (dv/dσ -> 0)
```

### A. The Single-Supply ColTIA Transimpedance Stage
The ColTIA transimpedance amplifiers convert summing-node current into an analog voltage. Operating on a single positive supply with virtual ground references:
* The negative saturation limit is reached at **$-1\,797\text{ LSB}$**.
* With a low-impedance passive attenuator ($1\text{ k}\Omega / 3.9\text{ k}\Omega$), quiescent current pulls the DC operating level down to **$-1\,600\text{ LSB}$**.
* This leaves an operational headroom of **only $\sim 180\text{ LSB}$** before hard bottoming occurs. Any dynamic negative excursion drives the op-amp into hard clipping.

### B. The Phenomenon of Phantom Gradients
The Inverted MAML architecture uses Hadamard carrier modulation ($500\text{ kHz}$) to extract loss gradients without backpropagation. 
* If the analog carrier wave remains linear, synchronous cross-correlation extracts the true analytical gradient $\nabla \mathcal{L}$.
* **If the signal hits the ColTIA rail, the bottom half of the carrier wave is clipped.**
* Harmonic distortion from this clipping introduces spurious frequency components at the demodulation frequency. The demodulator interprets this distortion as an active loss gradient, producing **phantom gradient bursts** that drive the weights in entirely false directions!

### C. Sigmoid 4 Transconductance Compression (Vanishing Analog Gradient)
The hardware sigmoid network (Ref 4) provides non-linear compression:
$$\sigma(v) = \frac{1}{1 + e^{-k v}}, \quad \frac{d\sigma}{dv} = k \cdot \sigma(v) \cdot (1 - \sigma(v))$$
* **At Quiescent Center ($v \approx 0$):** Slope $d\sigma/dv \approx 0.25$ (maximum sensitivity, linear dynamic control).
* **Under Large DC Offset ($|v| \gg 0$):** Operating point shifts into the asymptotic saturation tails where $d\sigma/dv \rightarrow 0$.
* When a channel is pushed into saturation tails, weight adjustments produce negligible current change. The analog gradient vanishes, leaving the loop powerless to restore balance.

---

## 4. The Role of L2 Regularization: The Mechanical "Rubber Band"

In the Inverted MAML inner-loop training equation:
$$W_{t+1} = W_t + \eta \cdot \text{HadamardGradient} - \mathbf{\lambda \cdot (W_t - W_{\text{base}})}$$

The term $\lambda \cdot (W_t - W_{\text{base}})$ is a physical restoring force, precisely analogous to a **mechanical spring or rubber band**:

1. **Why L2 Regularization is Mandatory**:  
   Without this restorative force ($\lambda = 0$), the physical weights in Matrix 3 and Matrix 8 drift under cumulative thermal noise and arbitrary vector driving forces until they hit the hard numerical/analog clamping rails at $\pm 127\text{ LSB}$. Once saturated, dynamic sensitivity is destroyed.
2. **Why L2 Regularization Demands DC Calibration**:  
   The rubber band anchors the weights to $W_{\text{base}}$.
   * Suppose Channel 3 has a physical silicon DC offset of $+352\text{ LSB}$.
   * To nullify this error, the weight $W_3$ must travel far into negative territory (e.g. $-60\text{ LSB}$).
   * But as $W_3$ moves away from $W_{\text{base}}$, the rubber band pulls back with proportional force:
     $$F_{\text{restore}} = \lambda \cdot (W_3 - W_{\text{base}})$$
   * At steady state, the gradient force and the rubber band force reach an equilibrium:
     $$\eta \cdot \nabla \mathcal{L} = \lambda \cdot (W_{\text{final}} - W_{\text{base}})$$
   * **This locks in a permanent, unresolvable steady-state DC error!** The loop cannot pull the error to zero because doing so would require infinitely overcoming the regularizer.

```
       [Uncalibrated W_base = +20 LSB] ◄══════ (Rubber Band Spring λ = 512) ══════► [Target Weight = -60 LSB]
                                                        ▲
                                             Equilibrium Stalls Here:
                                           Permanent Residual DC Error!
```

**Conclusion**: When the baseline $W_{\text{base}}$ is accurately calibrated to the physical zero-offset null point of the silicon, the rubber band pulls the weights **toward zero error** rather than fighting the gradient descent!

---

## 5. The Fallacy of the Sigmoid Knee Pre-Bias ("S-Böjarna") vs. Flat Equilibrium ($W_{\text{null}} = 0$)

A widespread theoretical misconception in early analog neural network modeling was the idea of **pre-biasing the multiplier weights into the "knee" or inflection bend of the sigmoid activation function** ($W = \pm 16\text{ LSB}$):

### A. The Theoretical Trap:
The digital intuition argued that because a neural network requires non-linearity, the weights should be statically biased into the non-linear curvature ("S-böjarna") of Sigmoid 4 to maximize non-linear expressivity.

### B. What Physical Silicon Revealed:
1. **Catastrophic Dynamic Range Destruction:**  
   When the auxiliary network was pre-biased into the sigmoid knee ($W = \pm 16\text{ LSB}$ in the legacy Phase 2 protocol), the multiplier cells injected massive unbalanced DC currents directly into the ColTIA summing junctions. Quiescent loss exploded to **$209\,323\text{ LSB}^2$ ($2.95\text{ bits ENOB}$)**!
2. **The Perverted L2 Anchor:**  
   Anchoring L2 regularization to that knee baseline ($W_{\text{base}} = W_{\text{knee}}$) meant that the regularizer's "rubber band" was continuously pulling the weights back into the high-distortion, saturated bend, actively fighting gradient descent.
3. **Vanishing Gradient in the Saturation Tails:**  
   By pushing the quiescent operating point toward the knee, dynamic signals immediately clipped against the asymptotic tails of the sigmoid where transconductance collapses ($d\sigma/dv \rightarrow 0$), paralyzing the demodulation engine.

### C. The Breakthrough: True Linear Center ($W_{\text{null}} = 0$)
Following Lead Engineer Olle's directive to eliminate the artificial knee perturbation and anchor the system at a **completely flat baseline ($W = 0$, $W_{\text{null}} = 0$)**, physical silicon delivered its cleanest, most stable performance:
* **Maximal Symmetric Transconductance:** At $v \approx 0$, the sigmoid exhibits its maximum slope ($d\sigma/dv = 0.25$), providing the highest possible analog sensitivity without pre-biasing into compression.
* **Maximum Headroom in Both Polarities:** Zero quiescent offset preserves the full $\pm 750\text{ LSB}$ linear dynamic range of the $5.1\text{ k}\Omega$ attenuator.
* **Empirical Validation:** Initiating active training directly from $W=0$ with L2 regularizing toward $W_{\text{null}} = 0$ produced a **$-55.7\%$ whole-phase error reduction** (from $2\,937.2\text{ LSB}^2$ / $6.05\text{ b}$ down to $1\,300.7\text{ LSB}^2$ / $6.71\text{ b}$), reaching all-time records of **$8.26\dots 8.77\text{ bits ENOB}$**.

> **Cardinal Rule for Analog Neural Networks:**  
> **NEVER pre-bias the quiescent state into the sigmoid knees or S-bends.**  
> Anchor the baseline and L2 regularizer strictly at the **symmetric linear zero center ($W_{\text{null}} = 0$)**, and let the adaptive loop dynamically generate non-linear trim currents only when demanded by real-time errors!

---

## 6. The Empirical Evidence: Card 2 ($3.9\text{ k}\Omega$ vs $5.1\text{ k}\Omega$)

The recent 20-run campaign on Card 2 provided dramatic confirmation of this physics:

1. **Peak Resolution Exploded to 8.50 Bits ($96.3\text{ LSB}^2$ in Run 08)**:  
   When input vectors happened to align favorably with Channel 3's offset, the increased linear headroom of the $5.1\text{ k}\Omega$ attenuator allowed the silicon to reach an **all-time project record of $8.50\text{ bits}$ ENOB**.
2. **Phase 3 Average Stalled at 5.04 Bits ($11\,588\text{ LSB}^2$)**:  
   Because Channel 3 remained uncalibrated with a $+352\text{ LSB}$ offset while $W_{\text{base}}$ pulled toward $+20\text{ LSB}$, Channel 3 generated an RMSE of $118.5\text{ LSB}$ ($14\,042\text{ LSB}^2$ loss) across arbitrary rotating vectors, dominating over $70\%$ of the total board error all by itself!
3. **Five Out of Six Channels Improved**:  
   Channels 0, 1, 2, 4, and 5 all showed reduced RMSE and increased headroom with $5.1\text{ k}\Omega$. Channel 3 alone masked the overall gain due to the rubber-band anchor offset.

---

## 7. The Complete Engineering Recipe for Stable Analog Convergence

To achieve sub-LSB convergence in physical analog neural networks, the following architectural rules must be strictly adhered to:

```
   ┌─────────────────────────────────────────────────────────────────────────────────┐
   │ 1. PASSIVE ATTENUATOR BALANCING (1k / 5.1k Ohm)                                 │
   │    Provides >750 LSB symmetric ColTIA headroom without drowning Hadamard SNR.   │
   ├─────────────────────────────────────────────────────────────────────────────────┤
   │ 2. SMART DC NULL CALIBRATION (Per-Column W_base Calibration)                    │
   │    Aligns the L2 rubber band anchor directly over each channel's silicon null.  │
   ├─────────────────────────────────────────────────────────────────────────────────┤
   │ 3. HIGH-CURRENT OP-AMP BUFFERING (MCP6444-E/SL 70 mA on DAC2 & Sigmoid 4)       │
   │    Eliminates drive starvation across all 6 columns simultaneously.             │
   ├─────────────────────────────────────────────────────────────────────────────────┤
   │ 4. L2 REGULARIZATION SPRING (lambda = 512)                                      │
   │    Constrains dynamic weights to the quiet linear inflection zone of Sigmoid 4. │
   └─────────────────────────────────────────────────────────────────────────────────┘
```

By respecting the narrow physical dynamic range of the analog substrate and using DC Calibration to set the anchor point of the L2 regularizer, the Inverted MAML architecture transforms what would otherwise be a chaotic, saturating analog circuit into a deterministic, ultra-high-precision computing engine capable of exceeding **$8.5\text{ bits}$ of physical analog resolution**.
