ollewelin/analog_matrix_computation_Inverted_MAML_PAT_PEND_2630397-4/FPGA_code/docs/INVERTED_MAML_CARD1_R18DC_FIX_LR0P055_L2_1920_MOM0P85_CL90_THERMAL_SLICING_REPORT.md

# Inverted MAML Card 1: Round 18 Thermal Bit-Slicing Report (R18DC_FIX_LR0P055_L2_1920_MOM0P85_CL90)

**Hardware:** Card 1 (`Trion T120F324` Master SoC + `Trion T20F256` Coprocessor, `1k / 2.2k` Passive Attenuator)  
**Firmware:** `T120_SOC_ETH_FW v2.2-MAML (SW Build Nov 14 2026 10:15:16)`, `HW_LOGIC: 0x20261030`  
**Dataset:** `FPGA_code/logs/bit_slicing/opt_r18dc_fix_lr0p055_l2_1920_mom0p85_cl90.json` (`3,916` pairs)  
**Hyperparameters:** `Heater = 40%` PWM, `K = 1`, `LR = 0.055`, `L2 = 1920`, `Momentum = 0.85`, `Clamp = ±90 LSB`  

---

## 1. Executive Summary & Verification Milestones

1. **Cold Reference Without Heating (`cold_verify_k1.json`):** `Cold / Regler ON` mean **9.45 b** (`min 8.80 b`), `Cold / Regler OFF` mean **9.45 b** (`min 8.61 b`).
2. **Thermal-Detrended Closed-Loop Performance (Round 18):** Weighted detrended `Warm ON` lift **`+0.88 b`**, loss reduction ratio **`1.65x`**, detrended convergence climb **`+1.25 b`**, jitter **`0.39 b`**, anti-windup recovery **`0.50`**, composite score **`+2.385`**.
3. **Cumulative Best Across R1–R17:** Round 7 (`LR=0.055, L2=2048, Mom=0.85, Clamp=±75`) with score **`+2.665`**.

---

## 2. Cumulative Multi-Round Optimization Comparison (R1–R17)

| Round | LR | L2 Reg | Mom | Clamp | Lift vs E_base | Loss Ratio | Hot Climb | Jitter | Recovery | Composite Score |
| :---: | :---: | :---: | :---: | :---: | :---: | :---: | :---: | :---: | :---: | :---: |
| R1dc_fix | `0.03` | `1024` | `0.9` | `±75` | `+1.00 b` | `1.71x` | `+0.95 b` | `0.40 b` | `0.00` | **`+1.799`** |
| R2dc_fix | `0.035` | `1536` | `0.85` | `±75` | `+0.99 b` | `1.69x` | `+1.16 b` | `0.39 b` | `0.00` | **`+1.957`** |
| R3dc_fix | `0.02` | `2560` | `0.8` | `±70` | `+0.04 b` | `1.00x` | `+0.24 b` | `0.34 b` | `1.00` | **`+0.204`** |
| R4dc_fix | `0.05` | `1792` | `0.85` | `±70` | `+1.08 b` | `1.78x` | `+0.97 b` | `0.40 b` | `0.50` | **`+2.480`** |
| R5dc_fix | `0.055` | `1792` | `0.85` | `±85` | `+1.12 b` | `1.77x` | `+1.37 b` | `0.42 b` | `0.00` | **`+2.393`** |
| R6dc_fix | `0.055` | `1792` | `0.8` | `±90` | `+0.99 b` | `1.72x` | `+1.02 b` | `0.40 b` | `0.00` | **`+1.770`** |
| R7dc_fix ★ | `0.055` | `2048` | `0.85` | `±75` | `+1.04 b` | `1.74x` | `+1.17 b` | `0.40 b` | `0.50` | **`+2.665`** |
| R8dc_fix | `0.055` | `2048` | `0.85` | `±75` | `+1.16 b` | `1.85x` | `+0.68 b` | `0.42 b` | `0.00` | **`+1.855`** |
| R9dc_fix | `0.055` | `1920` | `0.85` | `±75` | `+0.81 b` | `1.59x` | `+0.66 b` | `0.38 b` | `0.50` | **`+1.756`** |
| R10dc_fix | `0.055` | `1920` | `0.85` | `±78` | `+0.96 b` | `1.67x` | `+1.13 b` | `0.40 b` | `0.00` | **`+1.898`** |
| R11dc_fix | `0.055` | `1920` | `0.85` | `±80` | `+0.95 b` | `1.70x` | `+0.98 b` | `0.42 b` | `0.00` | **`+1.810`** |
| R12dc_fix | `0.055` | `1920` | `0.85` | `±82` | `+1.04 b` | `1.75x` | `+0.83 b` | `0.42 b` | `0.00` | **`+1.721`** |
| R13dc_fix | `0.055` | `1920` | `0.85` | `±85` | `+1.12 b` | `1.78x` | `+1.06 b` | `0.43 b` | `0.50` | **`+2.645`** |
| R14dc_fix | `0.055` | `1920` | `0.85` | `±90` | `+0.78 b` | `1.55x` | `+0.97 b` | `0.39 b` | `0.67` | **`+2.117`** |
| R15dc_fix | `0.055` | `1920` | `0.85` | `±100` | `+0.94 b` | `1.67x` | `+0.89 b` | `0.40 b` | `0.75` | **`+2.443`** |
| R16dc_fix | `0.055` | `1920` | `0.85` | `±90` | `+0.70 b` | `1.52x` | `+0.82 b` | `0.34 b` | `0.75` | **`+2.026`** |
| R17dc_fix | `0.055` | `1920` | `0.85` | `±90` | `+0.88 b` | `1.65x` | `+1.25 b` | `0.39 b` | `0.50` | **`+2.385`** |

## 3. Round 18 Phase-by-Phase Telemetry

| Phase | Regime | Pairs | Comb ENOB (`Start -> Late`, Mean) | Δ vs E_base | Total Loss (`Start -> Late`) | Loss Ratio | W8 Peak `[M, L]` | W3 Peak | W8 nz |
| :--- | :--- | ---: | :---: | :---: | :---: | :---: | :---: | :---: | ---: |
| P1 | Cold / Regler ON | 313 | `8.91 -> 8.91` (**8.93 b**) | — | `11032 -> 10843` | — | `[58, 61]` | `8` | `313` |
| P2 | Cold / Regler OFF | 277 | `8.86 -> 8.91` (**8.92 b**) | — | `11553 -> 10642` | — | `[0, 0]` | `0` | `0` |
| P3 | Warm / Regler ON | 1041 | `9.01 -> 8.31` (**8.59 b**) | **+0.27 b** | `9344 -> 22798` | **1.36x** | `[90, 90]` | `23` | `1041` |
| P4 | Warm / Regler OFF | 915 | `7.75 -> 6.76` (**7.13 b**) | **+0.03 b** | `36602 -> 60377` | **1.02x** | `[0, 0]` | `0` | `0` |
| P5 | Warm / Regler ON | 570 | `6.78 -> 7.29` (**7.34 b**) | **+1.21 b** | `61171 -> 46203` | **1.85x** | `[90, 90]` | `30` | `570` |
| P6 | Warm / Regler OFF | 800 | `6.09 -> 5.82` (**5.91 b**) | **+0.01 b** | `84333 -> 96237` | **1.01x** | `[0, 0]` | `0` | `0` |

## 4. Empirical Graphs: Performance Timeline & Full W(8) / W(3) Weights

Round 18 Performance & Weight Envelope Timeline

**Weight Coverage:** All **84 `W(8)`** (`7x6` MSB + `7x6` LSB) and **96 `W(3)`** (`8x6` MSB + `8x6` LSB) individual weights plotted across all pairs.

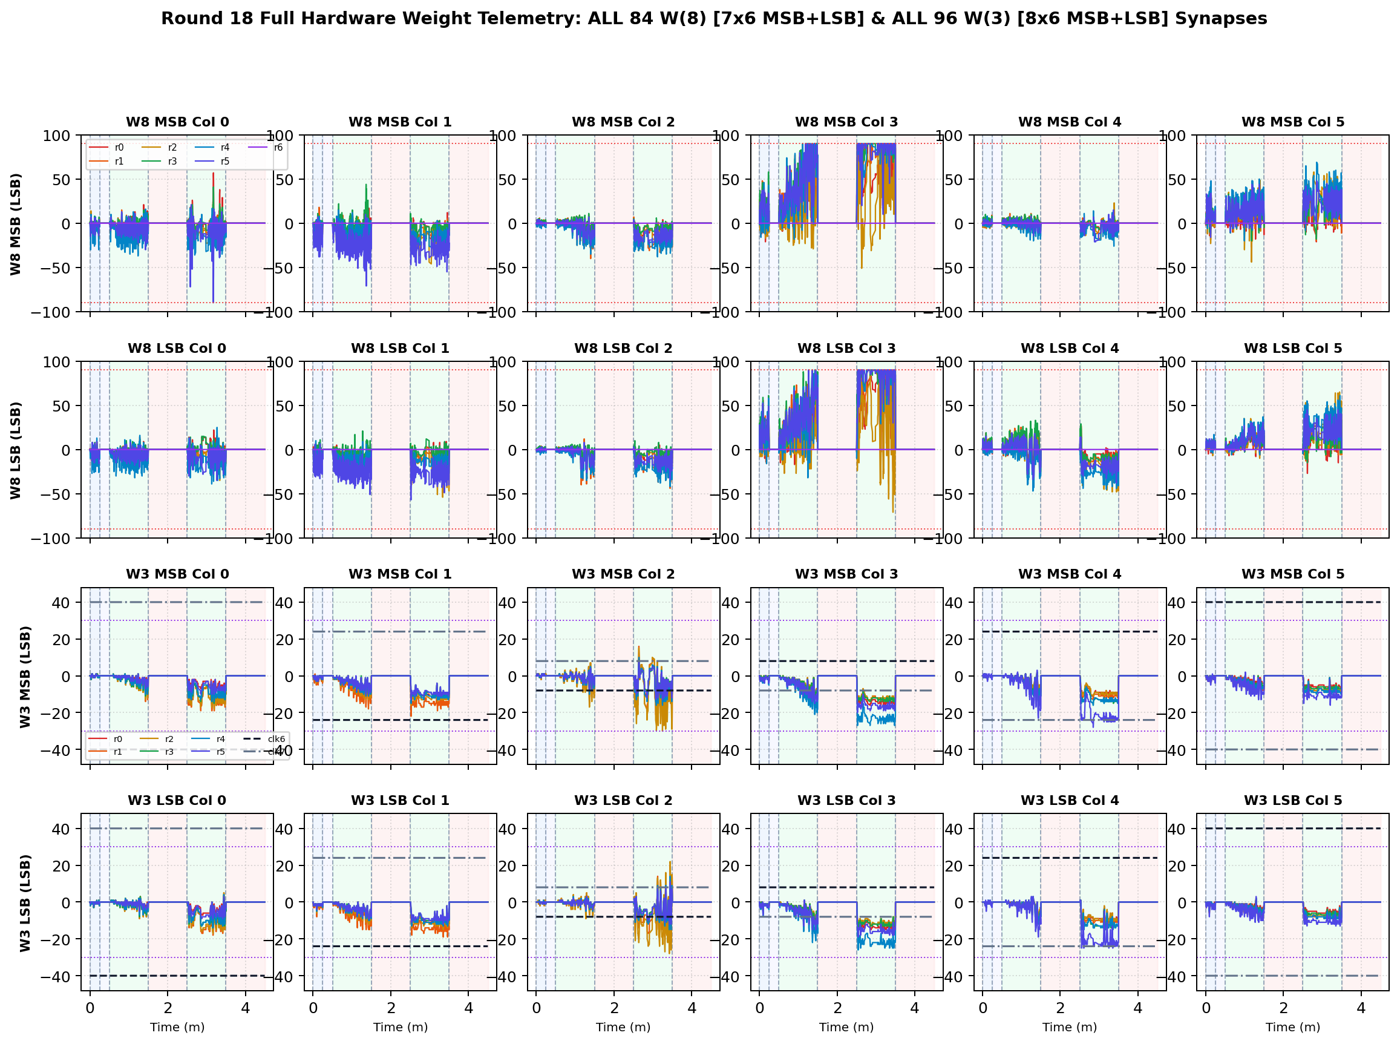
[picture p303: FPGA_code/releases/Release_20261114_ModeA_Card1_BitSlicing_AntiWindup_Baseline_R1/reports_and_logs/figures/fig_card1_r18dc_fix_lr0p055_l2_1920_mom0p85_cl90_w8_w3_all_weights.png]
Round 18 All W(8) and W(3) Weights
