ollewelin/analog_matrix_computation_Inverted_MAML_PAT_PEND_2630397-4/FPGA_code/releases/Release_20261114_ModeA_Card1_BitSlicing_AntiWindup_Baseline_R1/reports_and_logs/INVERTED_MAML_CARD1_R8DC_FIX_LR0P055_L2_2048_MOM0P85_CL75_THERMAL_SLICING_REPORT.md

# Inverted MAML Card 1: Round 8 Thermal Bit-Slicing Report (R8DC_FIX_LR0P055_L2_2048_MOM0P85_CL75)

**Hardware:** Card 1 (`Trion T120F324` Master SoC + `Trion T20F256` Coprocessor, `1k / 2.2k` Passive Attenuator)  
**Firmware:** `T120_SOC_ETH_FW v2.2-MAML (SW Build Nov 14 2026 10:15:16)`, `HW_LOGIC: 0x20261030`  
**Dataset:** `FPGA_code/logs/bit_slicing/opt_r7dc_fix_verify13m_lr0p055_l2_2048_mom0p85_cl75.json` (`7,200` pairs)  
**Hyperparameters:** `Heater = 40%` PWM, `K = 1`, `LR = 0.055`, `L2 = 2048`, `Momentum = 0.85`, `Clamp = ±75 LSB`  

---

## 1. Executive Summary & Verification Milestones

1. **Cold Reference Without Heating (`cold_verify_k1.json`):** `Cold / Regler ON` mean **9.45 b** (`min 8.80 b`), `Cold / Regler OFF` mean **9.45 b** (`min 8.61 b`).
2. **Thermal-Detrended Closed-Loop Performance (Round 8):** Weighted detrended `Warm ON` lift **`+1.16 b`**, loss reduction ratio **`1.85x`**, detrended convergence climb **`+0.68 b`**, jitter **`0.42 b`**, anti-windup recovery **`0.00`**, composite score **`+1.855`**.
3. **Cumulative Best Across R1–R8:** Round 7 (`LR=0.055, L2=2048, Mom=0.85, Clamp=±75`) with score **`+2.665`**.

---

## 2. Cumulative Multi-Round Optimization Comparison (R1–R8)

| Round | LR | L2 Reg | Mom | Clamp | Lift vs E_base | Loss Ratio | Hot Climb | Jitter | Recovery | Composite Score |
| :---: | :---: | :---: | :---: | :---: | :---: | :---: | :---: | :---: | :---: | :---: |
| R1dc_fix | `0.03` | `1024` | `0.9` | `±75` | `+1.00 b` | `1.71x` | `+0.95 b` | `0.40 b` | `0.00` | **`+1.799`** |
| R2dc_fix | `0.035` | `1536` | `0.85` | `±75` | `+0.99 b` | `1.69x` | `+1.16 b` | `0.39 b` | `0.00` | **`+1.957`** |
| R3dc_fix | `0.02` | `2560` | `0.8` | `±70` | `+0.04 b` | `1.00x` | `+0.24 b` | `0.34 b` | `1.00` | **`+0.204`** |
| R4dc_fix | `0.05` | `1792` | `0.85` | `±70` | `+1.08 b` | `1.78x` | `+0.97 b` | `0.40 b` | `0.50` | **`+2.480`** |
| R5dc_fix | `0.055` | `1792` | `0.85` | `±85` | `+1.12 b` | `1.77x` | `+1.37 b` | `0.42 b` | `0.00` | **`+2.393`** |
| R6dc_fix | `0.055` | `1792` | `0.8` | `±90` | `+0.99 b` | `1.72x` | `+1.02 b` | `0.40 b` | `0.00` | **`+1.770`** |
| R7dc_fix ★ | `0.055` | `2048` | `0.85` | `±75` | `+1.04 b` | `1.74x` | `+1.17 b` | `0.40 b` | `0.50` | **`+2.665`** |
| R8dc_fix | `0.055` | `2048` | `0.85` | `±75` | `+1.16 b` | `1.85x` | `+0.68 b` | `0.42 b` | `0.00` | **`+1.855`** |

## 3. Round 8 Phase-by-Phase Telemetry

| Phase | Regime | Pairs | Comb ENOB (`Start -> Late`, Mean) | Δ vs E_base | Total Loss (`Start -> Late`) | Loss Ratio | W8 Peak `[M, L]` | W3 Peak | W8 nz |
| :--- | :--- | ---: | :---: | :---: | :---: | :---: | :---: | :---: | ---: |
| P3 | Warm / Regler ON | 1672 | `8.33 -> 7.58` (**7.95 b**) | **+1.29 b** | `20916 -> 41271` | **1.93x** | `[75, 75]` | `25` | `1672` |
| P4 | Warm / Regler OFF | 1230 | `6.37 -> 5.85` (**6.09 b**) | **+0.02 b** | `70958 -> 94606` | **1.00x** | `[0, 0]` | `0` | `0` |
| P5 | Warm / Regler ON | 1254 | `6.02 -> 6.70` (**6.75 b**) | **+1.08 b** | `87755 -> 62399` | **1.78x** | `[75, 75]` | `25` | `1254` |
| P6 | Warm / Regler OFF | 950 | `5.53 -> 5.43` (**5.49 b**) | **+0.01 b** | `111378 -> 117807` | **1.00x** | `[0, 0]` | `0` | `0` |
| P7 | Warm / Regler ON | 1105 | `5.63 -> 6.49` (**6.52 b**) | **+1.16 b** | `107093 -> 68701` | **1.84x** | `[75, 75]` | `25` | `1105` |
| P8 | Warm / Regler OFF | 989 | `5.33 -> 5.26` (**5.29 b**) | **-0.00 b** | `124102 -> 129302` | **1.00x** | `[0, 0]` | `0` | `0` |

## 4. Empirical Graphs: Performance Timeline & Full W(8) / W(3) Weights

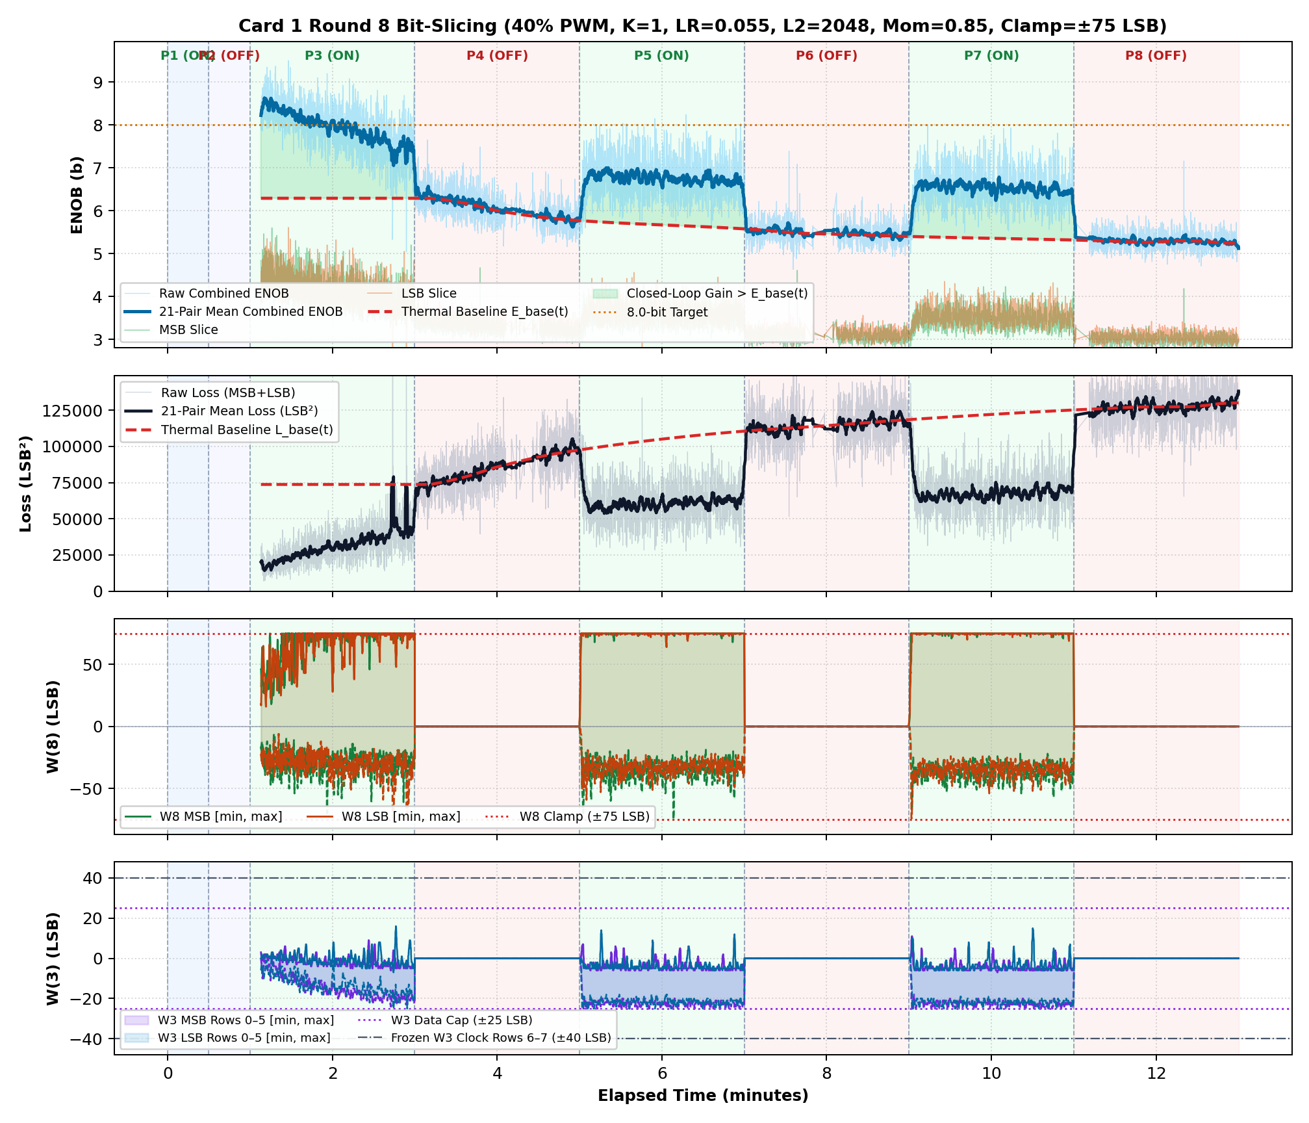
[picture p321: FPGA_code/docs/fig_card1_r8dc_fix_lr0p055_l2_2048_mom0p85_cl75_thermal_slicing.png]
Round 8 Performance & Weight Envelope Timeline


**Weight Coverage:** All **84 `W(8)`** (`7x6` MSB + `7x6` LSB) and **96 `W(3)`** (`8x6` MSB + `8x6` LSB) individual weights plotted across all pairs.

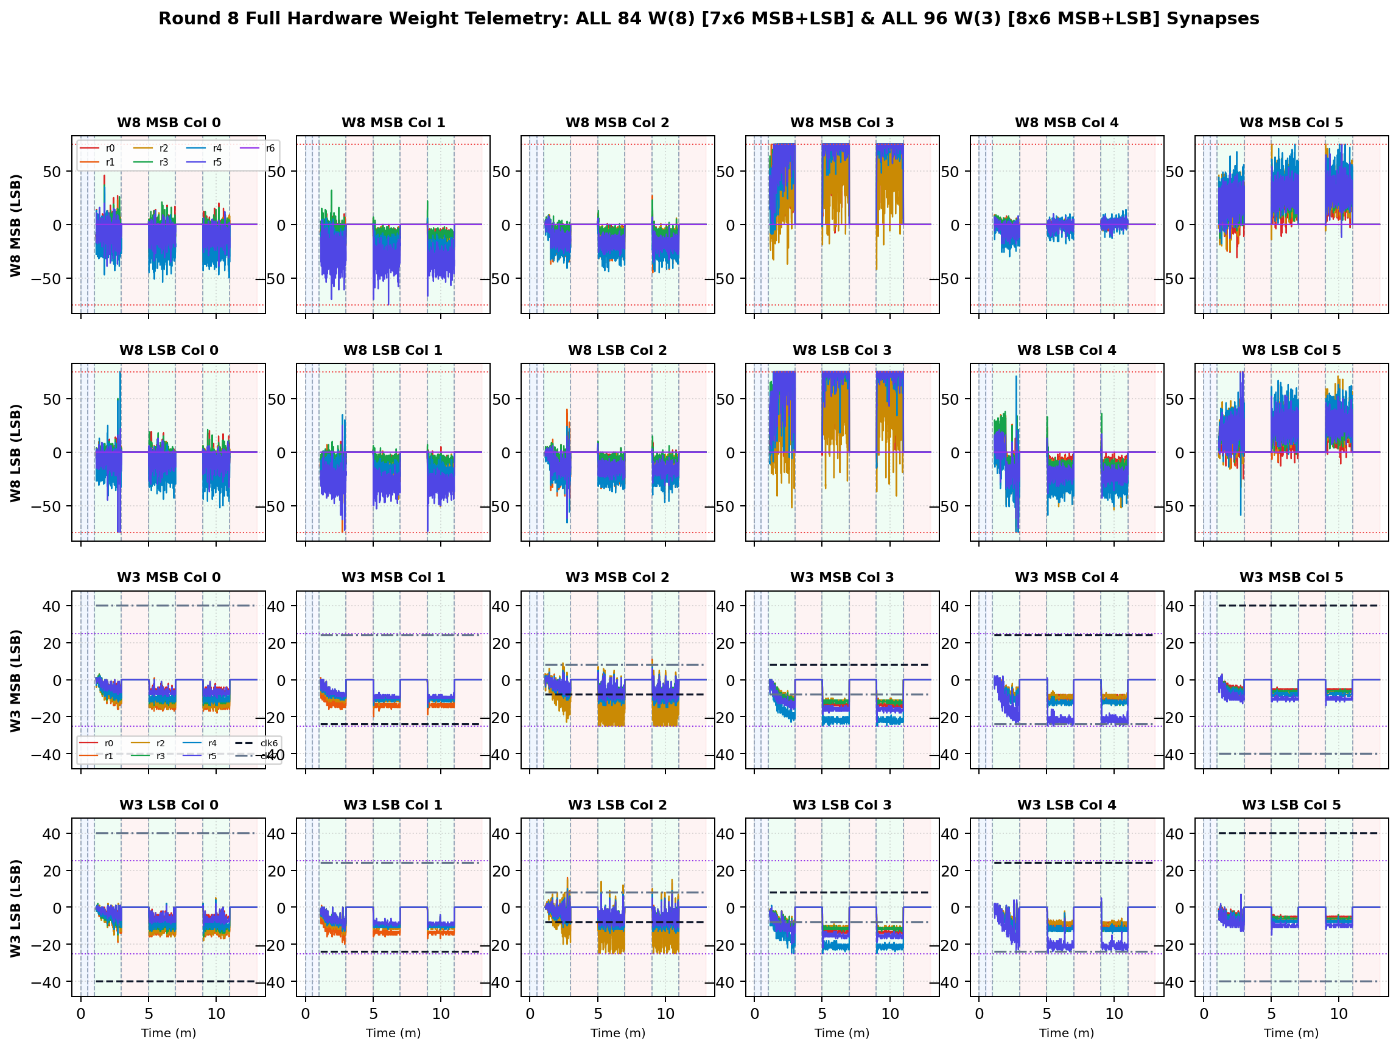
[picture p322: FPGA_code/docs/figures/fig_card1_r8dc_fix_lr0p055_l2_2048_mom0p85_cl75_w8_w3_all_weights.png]
Round 8 All W(8) and W(3) Weights
