ollewelin/analog_matrix_computation_Inverted_MAML_PAT_PEND_2630397-4/FPGA_code/releases/Release_20261114_ModeA_Card1_BitSlicing_AntiWindup_Baseline_R1/reports_and_logs/INVERTED_MAML_CARD1_R5DC_FIX_LR0P055_L2_1792_MOM0P85_CL85_THERMAL_SLICING_REPORT.md

# Inverted MAML Card 1: Round 5 Thermal Bit-Slicing Report (R5DC_FIX_LR0P055_L2_1792_MOM0P85_CL85)

**Hardware:** Card 1 (`Trion T120F324` Master SoC + `Trion T20F256` Coprocessor, `1k / 2.2k` Passive Attenuator)  
**Firmware:** `T120_SOC_ETH_FW v2.2-MAML (SW Build Nov 14 2026 10:15:16)`, `HW_LOGIC: 0x20261030`  
**Dataset:** `FPGA_code/logs/bit_slicing/opt_r5dc_fix_lr0p055_l2_1792_mom0p85_cl85.json` (`4,077` pairs)  
**Hyperparameters:** `Heater = 40%` PWM, `K = 1`, `LR = 0.055`, `L2 = 1792`, `Momentum = 0.85`, `Clamp = ±85 LSB`  

---

## 1. Executive Summary & Verification Milestones

1. **Cold Reference Without Heating (`cold_verify_k1.json`):** `Cold / Regler ON` mean **9.45 b** (`min 8.80 b`), `Cold / Regler OFF` mean **9.45 b** (`min 8.61 b`).
2. **Thermal-Detrended Closed-Loop Performance (Round 5):** Weighted detrended `Warm ON` lift **`+1.12 b`**, loss reduction ratio **`1.77x`**, detrended convergence climb **`+1.37 b`**, jitter **`0.42 b`**, anti-windup recovery **`0.00`**, composite score **`+2.393`**.
3. **Cumulative Best Across R1–R5:** Round 4 (`LR=0.05, L2=1792, Mom=0.85, Clamp=±70`) with score **`+2.480`**.

---

## 2. Cumulative Multi-Round Optimization Comparison (R1–R5)

| Round | LR | L2 Reg | Mom | Clamp | Lift vs E_base | Loss Ratio | Hot Climb | Jitter | Recovery | Composite Score |
| :---: | :---: | :---: | :---: | :---: | :---: | :---: | :---: | :---: | :---: | :---: |
| R1dc_fix | `0.03` | `1024` | `0.9` | `±75` | `+1.00 b` | `1.71x` | `+0.95 b` | `0.40 b` | `0.00` | **`+1.799`** |
| R2dc_fix | `0.035` | `1536` | `0.85` | `±75` | `+0.99 b` | `1.69x` | `+1.16 b` | `0.39 b` | `0.00` | **`+1.957`** |
| R3dc_fix | `0.02` | `2560` | `0.8` | `±70` | `+0.04 b` | `1.00x` | `+0.24 b` | `0.34 b` | `1.00` | **`+0.204`** |
| R4dc_fix ★ | `0.05` | `1792` | `0.85` | `±70` | `+1.08 b` | `1.78x` | `+0.97 b` | `0.40 b` | `0.50` | **`+2.480`** |
| R5dc_fix | `0.055` | `1792` | `0.85` | `±85` | `+1.12 b` | `1.77x` | `+1.37 b` | `0.42 b` | `0.00` | **`+2.393`** |

## 3. Round 5 Phase-by-Phase Telemetry

| Phase | Regime | Pairs | Comb ENOB (`Start -> Late`, Mean) | Δ vs E_base | Total Loss (`Start -> Late`) | Loss Ratio | W8 Peak `[M, L]` | W3 Peak | W8 nz |
| :--- | :--- | ---: | :---: | :---: | :---: | :---: | :---: | :---: | ---: |
| P1 | Cold / Regler ON | 320 | `7.98 -> 8.34` (**8.30 b**) | — | `31391 -> 21818` | — | `[85, 85]` | `22` | `320` |
| P2 | Cold / Regler OFF | 303 | `8.09 -> 8.16` (**8.15 b**) | — | `28607 -> 25302` | — | `[0, 0]` | `0` | `0` |
| P3 | Warm / Regler ON | 1043 | `8.22 -> 8.06` (**8.21 b**) | **+0.87 b** | `24642 -> 28681` | **1.66x** | `[85, 85]` | `26` | `1043` |
| P4 | Warm / Regler OFF | 901 | `6.94 -> 6.33` (**6.59 b**) | **+0.02 b** | `55223 -> 74216` | **1.01x** | `[0, 0]` | `0` | `0` |
| P5 | Warm / Regler ON | 814 | `6.52 -> 7.04` (**7.14 b**) | **+1.24 b** | `68241 -> 52505` | **1.83x** | `[85, 85]` | `28` | `814` |
| P6 | Warm / Regler OFF | 696 | `5.82 -> 5.70` (**5.75 b**) | **+0.01 b** | `94966 -> 102515` | **1.01x** | `[0, 0]` | `0` | `0` |

## 4. Empirical Graphs: Performance Timeline & Full W(8) / W(3) Weights

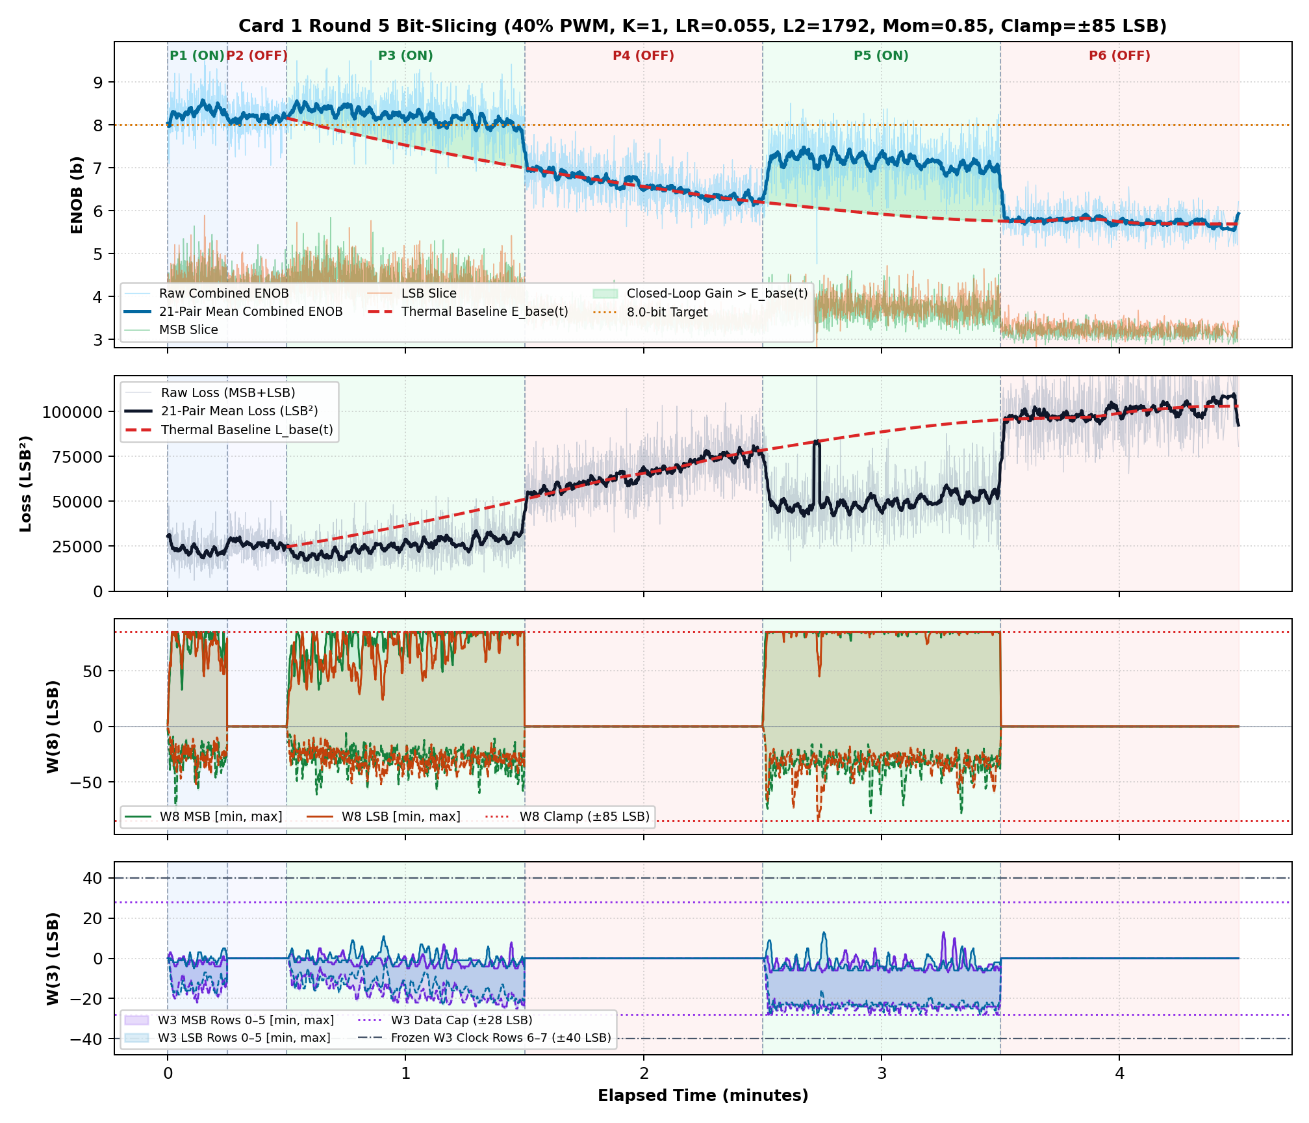
[picture p324: FPGA_code/docs/figures/fig_card1_r5dc_fix_lr0p055_l2_1792_mom0p85_cl85_thermal_slicing.png]
Round 5 Performance & Weight Envelope Timeline


**Weight Coverage:** All **84 `W(8)`** (`7x6` MSB + `7x6` LSB) and **96 `W(3)`** (`8x6` MSB + `8x6` LSB) individual weights plotted across all pairs.

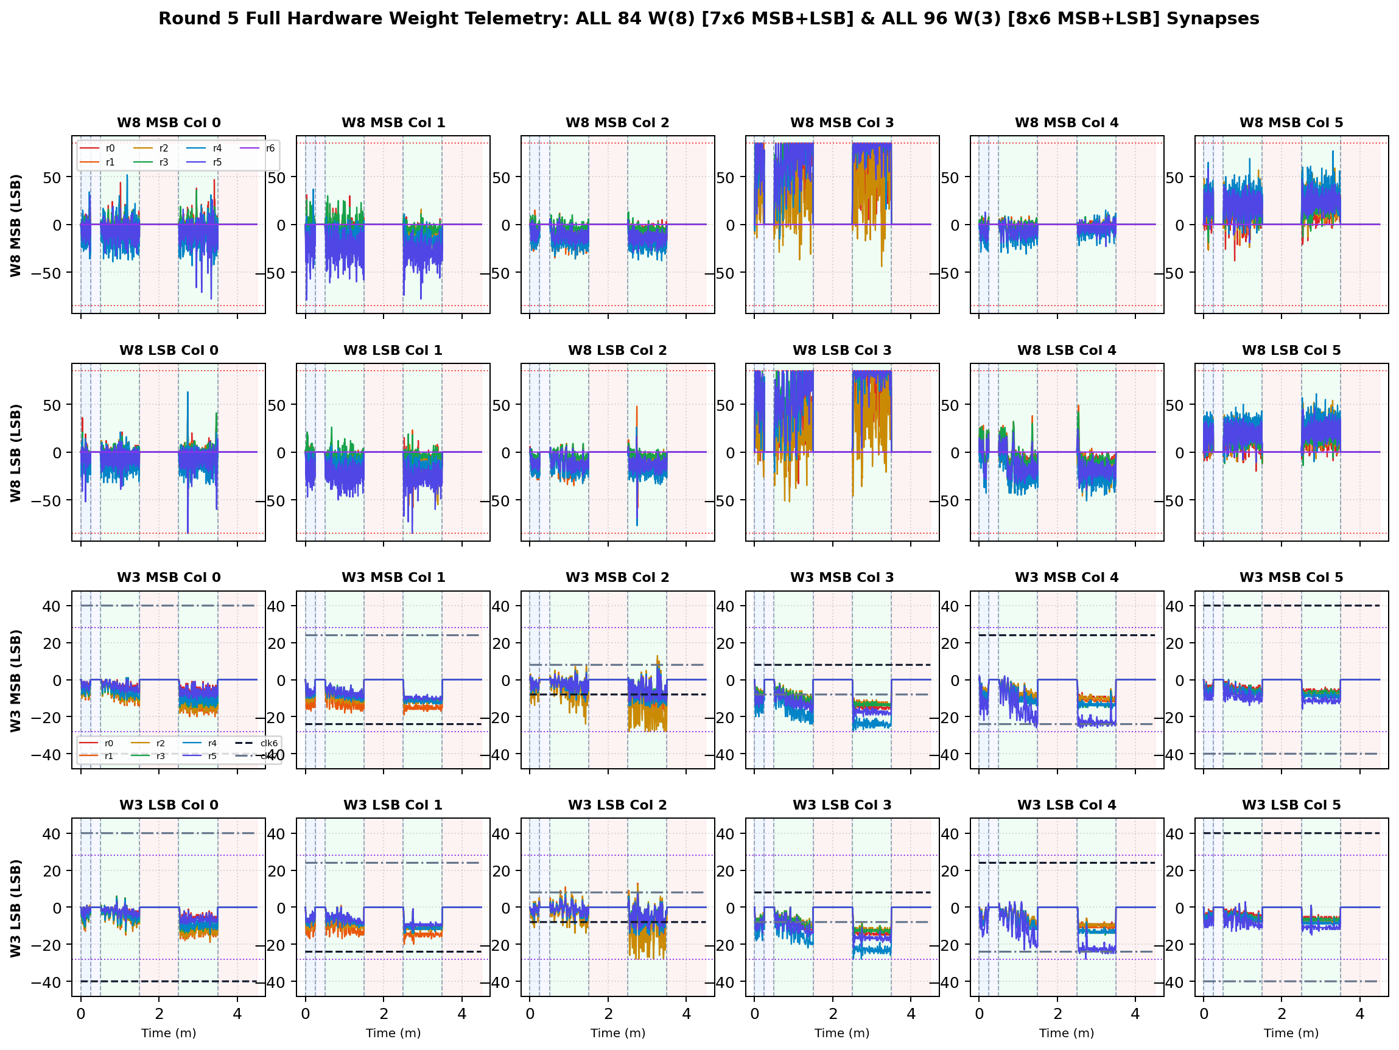
[picture p325: FPGA_code/docs/fig_card1_r5dc_fix_lr0p055_l2_1792_mom0p85_cl85_w8_w3_all_weights.png]
Round 5 All W(8) and W(3) Weights
