ollewelin/analog_matrix_computation_Inverted_MAML_PAT_PEND_2630397-4/FPGA_code/releases/Release_20261114_ModeA_Card1_BitSlicing_AntiWindup_Baseline_R1/reports_and_logs/INVERTED_MAML_CARD1_R18DC_FIX_LR0P055_L2_1920_MOM0P85_CL90_THERMAL_SLICING_REPORT.pdf

# Inverted MAML Card 1: Round 18 Thermal Bit-Slicing Report

Hardware: Card 1 (T120+T20, 1k/2.2k) | FW: v2.2-MAML (0x20261030) | Params: 40% PWM, K=1, LR=0.055, L2=1920, Mom=0.85,
Clamp=±90 LSB

## 1. Round 18 Summary & Cumulative Comparison (R1–R17)

- Cold Verification: Phase 1 ON = 9.45 b, Phase 2 OFF = 9.45 b (W8=0 strictly).
- Round 18 Detrended Trend Metrics: Lift vs E_base = +0.88 b, Loss Ratio = 1.65x, Climb = +1.25 b, Jitter = 0.39 b, Recovery = 0.50, Score = +2.385.
Rnd | LR | L2 | Mom | Clamp | Lift | LossR | Climb | Jitt | Recov | Score
R10dc_fix | 0.055 | 1920 | 0.85 | ±78 | +0.96b | 1.67x | +1.13b | 0.40b | 0.00 | +1.898
R11dc_fix | 0.055 | 1920 | 0.85 | ±80 | +0.95b | 1.70x | +0.98b | 0.42b | 0.00 | +1.810
R12dc_fix | 0.055 | 1920 | 0.85 | ±82 | +1.04b | 1.75x | +0.83b | 0.42b | 0.00 | +1.721
R13dc_fix | 0.055 | 1920 | 0.85 | ±85 | +1.12b | 1.78x | +1.06b | 0.43b | 0.50 | +2.645
R14dc_fix | 0.055 | 1920 | 0.85 | ±90 | +0.78b | 1.55x | +0.97b | 0.39b | 0.67 | +2.117
R15dc_fix | 0.055 | 1920 | 0.85 | ±100 | +0.94b | 1.67x | +0.89b | 0.40b | 0.75 | +2.443
R16dc_fix | 0.055 | 1920 | 0.85 | ±90 | +0.70b | 1.52x | +0.82b | 0.34b | 0.75 | +2.026
R17dc_fix | 0.055 | 1920 | 0.85 | ±90 | +0.88b | 1.65x | +1.25b | 0.39b | 0.50 | +2.385

## 2. Phase-by-Phase Telemetry (3,916 Pairs)

Phase Regime | | N | Start->Late (Mean) | ∆ vs E_base | Loss Start->Late | W8 Pk [M,L] | W3 Pk | W8 nz
P1 | Cold / Regler ON | 313 | 8.91->8.91 (8.93b) | - | 11032->10843 | [58,61] | 8 | 313
P2 | Cold / Regler OFF | 277 | 8.86->8.91 (8.92b) | - | 11553->10642 | [0,0] | 0 | 0
P3 | Warm / Regler ON | 1041 | 9.01->8.31 (8.59b) | +0.27 b | 9344->22798 | [90,90] | 23 | 1041
P4 | Warm / Regler OFF | 915 | 7.75->6.76 (7.13b) | +0.03 b | 36602->60377 | [0,0] | 0 | 0
P5 | Warm / Regler ON | 570 | 6.78->7.29 (7.34b) | +1.21 b | 61171->46203 | [90,90] | 30 | 570
P6 | Warm / Regler OFF | 800 | 6.09->5.82 (5.91b) | +0.01 b | 84333->96237 | [0,0] | 0 | 0


INVERTED MAML (SE 2630397-4) | Card 1 Round 18 Concise Report (R18DC_FIX_LR0P055_L2_1920_MOM0P85_CL90) | Page 1 of 2

## 3. All W(8) (7x6 MSB+LSB) & W(3) (8x6 MSB+LSB) Weight Dynamics — Round 18

- Full 180-Synapse Per-Pair Capture: Every individual weight in Matrix 8 MSB (42 weights), Matrix 8 LSB (42 weights), Matrix 3 MSB (36 active + 12 clock), and Matrix 3 LSB (36 active + 12 clock) is plotted below across all columns `Col 0..5`. W(8) enforces anti-windup clamping at ±90 LSB, while W(3) rows 0–5 stay within ±30 LSB so rows 6–7 clock staircases remain locked at ±40 LSB.


INVERTED MAML (SE 2630397-4) | Card 1 Round 18 Concise Report (R18DC_FIX_LR0P055_L2_1920_MOM0P85_CL90) | Page 2 of 2
