ollewelin/analog_matrix_computation_Inverted_MAML_PAT_PEND_2630397-4/FPGA_code/releases/Release_20261114_ModeA_Card1_BitSlicing_AntiWindup_Baseline_R1/reports_and_logs/INVERTED_MAML_CARD1_R14DC_FIX_LR0P055_L2_1920_MOM0P85_CL85_THERMAL_SLICING_REPORT.pdf

# Inverted MAML Card 1: Round 14 Thermal Bit-Slicing Report

Hardware: Card 1 (T120+T20, 1k/2.2k) | FW: v2.2-MAML (0x20261030) | Params: 40% PWM, K=1, LR=0.055, L2=1920, Mom=0.85,
Clamp=±85 LSB

## 1. Round 14 Summary & Cumulative Comparison (R1–R13)

- Cold Verification: Phase 1 ON = 9.45 b, Phase 2 OFF = 9.45 b (W8=0 strictly).
- Round 14 Detrended Trend Metrics: Lift vs E_base = +1.12 b, Loss Ratio = 1.78x, Climb = +1.06 b, Jitter = 0.43 b, Recovery = 0.50, Score = +2.645.
Rnd | LR | L2 | Mom | Clamp | Lift | LossR | Climb | Jitt | Recov | Score
R6dc_fix | 0.055 | 1792 | 0.8 | ±90 | +0.99b | 1.72x | +1.02b | 0.40b | 0.00 | +1.770
R7dc_fix* | 0.055 | 2048 | 0.85 | ±75 | +1.04b | 1.74x | +1.17b | 0.40b | 0.50 | +2.665
R8dc_fix | 0.055 | 2048 | 0.85 | ±75 | +1.16b | 1.85x | +0.68b | 0.42b | 0.00 | +1.855
R9dc_fix | 0.055 | 1920 | 0.85 | ±75 | +0.81b | 1.59x | +0.66b | 0.38b | 0.50 | +1.756
R10dc_fix | 0.055 | 1920 | 0.85 | ±78 | +0.96b | 1.67x | +1.13b | 0.40b | 0.00 | +1.898
R11dc_fix | 0.055 | 1920 | 0.85 | ±80 | +0.95b | 1.70x | +0.98b | 0.42b | 0.00 | +1.810
R12dc_fix | 0.055 | 1920 | 0.85 | ±82 | +1.04b | 1.75x | +0.83b | 0.42b | 0.00 | +1.721
R13dc_fix | 0.055 | 1920 | 0.85 | ±85 | +1.12b | 1.78x | +1.06b | 0.43b | 0.50 | +2.645

## 2. Phase-by-Phase Telemetry (3,921 Pairs)

Phase Regime | | N | Start->Late (Mean) | ∆ vs E_base | Loss Start->Late | W8 Pk [M,L] | W3 Pk | W8 nz
P1 | Cold / Regler ON | 314 | 7.65->8.14 (8.10b) | - | 38104->26114 | [85,85] | 22 | 314
P2 | Cold / Regler OFF | 299 | 7.93->7.93 (7.90b) | - | 32245->44391 | [0,0] | 0 | 0
P3 | Warm / Regler ON | 1048 | 8.21->7.88 (8.08b) | +1.00 b | 24480->32744 | [85,85] | 25 | 1048
P4 | Warm / Regler OFF | 936 | 6.70->6.21 (6.40b) | +0.03 b | 61322->79126 | [0,0] | 0 | 0
P5 | Warm / Regler ON | 844 | 6.43->6.99 (7.04b) | +1.20 b | 73277->54033 | [85,85] | 28 | 844
P6 | Warm / Regler OFF | 480 | 5.72->5.55 (5.63b) | +0.02 b | 99142->110679 | [0,0] | 0 | 0


INVERTED MAML (SE 2630397-4) | Card 1 Round 14 Concise Report (R14DC_FIX_LR0P055_L2_1920_MOM0P85_CL85) | Page 1 of 2

## 3. All W(8) (7x6 MSB+LSB) & W(3) (8x6 MSB+LSB) Weight Dynamics — Round 14

- Full 180-Synapse Per-Pair Capture: Every individual weight in Matrix 8 MSB (42 weights), Matrix 8 LSB (42 weights), Matrix 3 MSB (36 active + 12 clock), and Matrix 3 LSB (36 active + 12 clock) is plotted below across all columns `Col 0..5`. W(8) enforces anti-windup clamping at ±85 LSB, while W(3) rows 0–5 stay within ±28 LSB so rows 6–7 clock staircases remain locked at ±40 LSB.


INVERTED MAML (SE 2630397-4) | Card 1 Round 14 Concise Report (R14DC_FIX_LR0P055_L2_1920_MOM0P85_CL85) | Page 2 of 2
