ollewelin/analog_matrix_computation_Inverted_MAML_PAT_PEND_2630397-4/LTspice/Sigmoid_test_2BJT_Diff_in_D.asc

L1: ind; 10n; Rser=1m
Q1: npn; BC547C
Q3: npn; BC547C
Q4: npn; BC547C
Q5: npn; BC547C
R1: res; 1k
R2: res; 1k
R3: res; 3.3k
R4: res; 1.2k
R5: res; 1k
R6: res; 270
R7: res; 910
R8: res; 1k
R9: res; 100
R10: res; 1k
R11: res; 910
R12: res; 3.3k
R13: res; 3.3k
R14: res; 300
U1: LT1678
U2: LT1678
U3: LT1678
U4: LT1678
V1: voltage; 3.3
V2: voltage; SINE(0.8 0.8 1k)
V3: voltage; 1.65
V4: voltage; SINE(0.8 0.8 1k 0 0 180)
Named nets: 0, vref, sin, s1, single, sin_ph_shift, OUTPUT
.tran 0.002
