ollewelin/analog_matrix_computation_Inverted_MAML_PAT_PEND_2630397-4/LTspice/Sigmoid_test_2BJT_Diff_in_C.asc

C1: cap; 10µ
L1: ind; 10n; Rser=1m
Q1: npn; BC547C
Q3: npn; BC547C
Q4: npn; BC547C
Q5: npn; BC547C
R1: res; 1k
R2: res; 1k
R3: res; 33k
R4: res; 12k
R5: res; 10k
R6: res; 3k
R7: res; 10k
R8: res; 10k
R9: res; 1k
R10: res; 10k
R11: res; 10k
R12: res; 33k
R13: res; 33k
R14: res; 3k
R15: res; 47
U1: MAX4162
U2: MAX4162
U4: MAX4162
U5: MAX4162
V1: voltage; 3.3
V2: voltage; SINE(0.8 0.8 1k)
V3: voltage; 1.65
V4: voltage; SINE(0.8 0.8 1k 0 0 180)
Named nets: 0, vref, sin, s1, single, sin_ph_shift, OUTPUT, Vref_F
.tran 0.002
