ollewelin/analog_matrix_computation_Inverted_MAML_PAT_PEND_2630397-4/(list of files, drawings)

Other design files:
EasyEDA/V2_format/ProPrj_Inverted_MAML_6x6_2026-09-04.epro
