ollewelin/analog_matrix_computation_Inverted_MAML_PAT_PEND_2630397-4/(commit log)

2026-09-30 Change LED_test1 image format to JPEG
    Updated image file format from PNG to JPEG in README.
2026-10-03 docs(fpga): add easyeda schematic query guide
2026-10-03 docs(fpga): add T20 to T120 bus wires specification
2026-10-03 feat(t120): integrate sapphire soc bsp, lwip stack, ip blocks and startup docs
    [external.cfg, flash.cfg, flash_softTap.cfg, flash_ti.cfg, flash_tz.cfg, ftdi.cfg, ftdi_ti.cfg, ftdi_tz.cfg]
2026-10-04 fix(fpga/sw): resolve timing violations and add STA guard skills
    - Fix timing constraints on 50 MHz clock and APB bus
    - Restore LED2 heartbeat and enable UART debug output on pin F13
    - Fix MDIO/PHY init, lwIP Ethernet stack and camera drivers
    - Add automated timing check script (check_timing.py) and timing-guard skills
    - Add hardware diagnostic docs and debug journal
    [eth_mac_100m.c, eth_mac_100m.h, ethernetif.h, ethernetif_100m.c, main.c, phy_mdio_1000m.c]
2026-10-07 Change SoC and TCP/IP IP block to standard AXI. feat(eth): switch to Efinix TSE MAC, add loopback and update MDIO for PHY 0x05
2026-10-07 LINK up working on fix ping
    [eth_echo_responder.sv, main (copy).c, main.c, top_level.sv, tsemac_axis_packet_fifo.sv]
2026-10-10 ping not work yet working on that, add T20 T120 brige remove some file and add skill for defining SoC IP etc
    [eth_mac_100m.sv, main.c, t120_bridge_clkgen.sv, t120_bridge_regs.h, t120_creset_controller.sv, t120_hbus_seq.sv, t120_inter_fpga_bridge.sv, t120_sbus_rx.sv]
2026-10-10 png test .hex for SPI flash
2026-10-10 add simple T120LED1 only one LED blink test hex
2026-10-10 FPGA Syntesis regenerate example, ping working
    [external.cfg, flash.cfg, flash_softTap.cfg, flash_ti.cfg, flash_tz.cfg, ftdi.cfg, ftdi_ti.cfg, ftdi_tz.cfg]
2026-10-10 update more S-buss SPI flash metodes not yet finnish
2026-10-10 update more S-buss SPI Flashing to T20
2026-10-10 update more S-buss SPI Flashing to T20 JUMP_APP working
2026-10-11 add JUMPER settings, board_v1_3_2_with_jumpers_and parches.jpeg
2026-10-11 analog DAC ADC etc included
2026-10-11 Fix 100Hz auto refresh. Test Analog multiplication matrix(3)
2026-10-12 [200~git commit -m 'fix(t20,t120): restore 100Hz 50us column-by-column 2T1C gate pulses, sawtooth capacitor refresh, and S-bus SPI flash transceiver
    1. Fix 2T1C Column Gate Refresh & Eliminate Stuck-High 3.3V Gate Lines (T20_Golden + T20_Custom):
    - Configured and connected all 36 differential pass-transistor gate pins (G_P1..6_MAT_3/8/33 and G_N1..6_MAT_3/8/33) in both T20_Golden (0x000000) and T20_Custom (0x000a6000) T20F256.peri.xml and top_level.sv so they actively drive 0V (OFF) at reset instead of floating high via Efinix weak pull-ups.
    - Verified hardware column-gate pulse engine (S-bus CH 0x05, OP 0x4 in t20_hw_responder.sv) with strict one-column-at-a-time, one-polarity-at-a-t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
2026-10-12 feat(t120,docs): add post-fix M3/M33 full-matrix characterization, COLTIA pedestal bias, and debug journal 1. Post-Fix Full-Matrix Hardware Characterization (ANALOG_MULTIPLIER_DIAGNOSTIC_REPORT.md & 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
2026-10-13 feat(research): complete Jumper Modes A/B/C characterization and launch 30-min thermal campaign - Mode B (OFF): Probed standalone Matrix 33 (2.12 ENOB baseline, 32.76 LSB mismatch, training locked) -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
2026-10-14 [200~feat(sw): add standalone 100 atomic triads LED hardware test software
    - Created standalone test variant in FPGA_code/sw/standalone_test_versions/LED_test_100_atomic_triades/
    - Cycles sequentially through 100 distinct atomic triad configurations (M3, M8, M33)
    - Retains fixed strata dwell time (10 refresh cycles = 100 ms) before swapping triads
    - Holds Heaters 2 & 4 ON (100% duty) and Heaters 1 & 3 OFF (0% duty)
    - Fixes single random white-noise DAC reference vector across all 100 variants
    - Drives real-time analog outputs on ADC_45 and ADC_49 to front-panel LED bars at 100 Hz refresh
    - Added hardware validation report in FPGA_code/docs/LED_TEST_100_ATOMIC_TRIADES_REPORT.md
    - Preserved s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
2026-10-14 feat(sw): add standalone 100 atomic triads LED hardware test software
    - Preserved standar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
2026-10-15 docs: document 100 Hz refresh kickback phenomenon and oscilloscope hardware learnings in README
2026-10-16 docs(README): update oscilloscope analysis to DAC Data & Weight Op-Amp output current limitation and add SOIC-14 replacements
2026-10-16 hw: implement contiguous 24us Hadamard burst and verify hardware carrier SNR
    - Rebuilt T120 sequencer RTL (t120_hbus_seq, t120_inter_fpga_bridge, t120_analog_io_ctrl)
    to generate a contiguous 24.00 us (2x6 x 2.00 us) Hadamard table with zero Tri-State gaps.
    - Positioned Hadamard burst at t = 2.0 ms after refresh to avoid capacitor droop corruption.
    - Sample XC2361A differential ADCs at end of pulse (t = 1.96 us) before subsequent pulse transitions.
    - Utilized T20 hardware slave double-buffered receiver (t20_hbus_rx) with clean 0x8000 Hi-Z exit.
    - Live hardware verification confirms +15.5 dB to +32.3 dB carrier SNR on ADC_45 and up to
    +23.3 dB on ADC_49, demonstrating repeatable physical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
2026-10-18 docs(README): Add 2026-10-18 100nF memory cell scope captures, v1.3.2 12-col DAC driver low-R_out notes, and full-speed Efinix LA verification
2026-10-19 docs(README): Add 2026-10-19 milestone, patent Fig 8 Hadamard injection circuit, and late Nov MCP664-E/SL test roadmap
2026-10-20 docs: add oscilloscope capture of DAC2_D_ROW1 sag vs Matrix(3) weight cell and document op-amp current bottleneck
2026-10-21 feat(maml): autonomous silicon characterization, t0=3ms inner-loop neural compensation & continuous ADC LA build
    - Scientific Hardware Investigation (Pure Silicon Telemetry, anti-simulation enforced):
    * Mapped 2D multiplier transfer surface Y = f(W, X) with <4.2% odd-symmetry error.
    * Measured MCP6024 buffer op-amp sag (~188 mVpp) under multi-column dynamic load.
    * Evaluated 36-cell spatial process uniformity on Matrix 33 (CV=21.7% gain spread,
    with <10% row variation confirming PCB copper trace resistance is negligible).
    * Validated multi-layer dynamic range across Matrix 3 (soft-sigmoid), Matrix 8 & Matrix 33.
    * Verified 24 us contiguous Hadamard carrier bursts (20.9 dB mean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
2026-10-22 docs(hardware): confirm flawless Weight DAC op-amp operation and isolate current sag strictly to Data lines
    - Oscilloscope Bench Verification (2026-10-22):
    * Added oscilloscope captures (example2, example3, example4) confirming that the 6-level
    waveform on W_M1_ROW1 is the expected sequential 6-column refresh train, settling onto
    completely flat, distortion-free plateaus when randomized.
    * Verified that standard MCP6024 quad op-amps are 100% adequate for Weight charging lines
    since they charge only one 100 nF memory capacitor at a time (time-multiplexed).
    * Removed previous recommendation for 100 nF external reservoir capacitors on Weight lines;
    the original schematic a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
2026-10-24 feat(silicon): decouple snapshot timing, restore Mode B 100Hz refresh, and verify single-cell multiplier dynamics
    - Decouple multiplier snapshot time (0-9.5 ms) from Hadamard timing in T120 SoC firmware and GUI
    - Fix Mode B weight refresh suppression by removing w=0 clamp on Matrix 3 (W_M1_ROW1) and Matrix 8
    - Include Matrix 33 (DAC_34) in weight randomization and enable autonomous 100 Hz In-Data white-noise generator
    - Auto-pause autonomous In-Data generator during single-cell probe to guarantee clean single-row measurement
    - Characterize Cell (0,0) in Mode B on physical silicon: confirm electrical null at W=-43 LSB and full linear swing of +-600 mV
    - Archive verified bitstream, hex, and fi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
2026-10-24 docs(maml): enable full 6-column loss at 5.0ms; deprecate obsolete column masking
    Empirical silicon verification at t = 5.0 ms in Mode A confirms all 6 columns (0..5)
    are active and centered near 0 LSB (+-30 mV). Saturated rail behavior on cols 2 & 3
    was an artifact of older uncentered weights / transient-window measurements.
    Update Argon specification and skill to train over all 6 columns.
2026-10-24 docs(maml): scrub all remaining mentions of column masking; enforce full 6 columns everywhere
    Ensure Equation 4, flowchart, checklists, and review steps strictly reference
    full 6-column operation (j in 0..5) without any lingering masking references.
2026-10-25 feat(maml): Mode A multi-vector mini-batch training engine & dynamic LR scaling
    - Implemented run_mode_a_multi_vector_batch.py with rotating K-vector batches (K=4..8) and multi-sample unseen holdout validation.
    - Added dynamic learning rate programming (req[17..18], g_lr_inner_q16) to maml_platform.c (0x11 SET_CONFIG) and udp_client.py.
    - Physical silicon characterization:
    - LR 1.0x: Overreacts across diverse vectors.
    - LR 0.25x: Peak Val RMSE 21.44 LSB (6.58 bits ENOB) at Ep 36.
    - LR 0.10x: 100 epochs, K=8 (800 updates) proves rock-solid landscape stability (r=0.9989).
    - Established 1k/3.9k baseline telemetry prior to 1k/15k hardware attenuator modification.
    - Updated olle_log with ex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
2026-10-26 Implement True Multi-Strata Batch Architecture (M*K samples) on T120 SoC & launch long-term sweep
2026-10-26 Enable unbuffered print output in sweep orchestrator
2026-10-26 docs(readme): clarify open science note on discrete PCBA vs commercial ASIC licensing
2026-10-26 feat(hardware): verify 20-epoch Mode A fixed-vector run at LR=2.0 on 1k/15k resistor
2026-10-27 docs: clarify dual research regimes (Max ENOB vs Full-Swing Relative Lift) and document digital data/weight clamping
2026-10-27 docs: add architectural disclosure for multi-layer daisy-chained Atomic Triads with sparse digital state propagation
2026-10-27 docs: clean up raw LaTeX tags and formatting in Multi-Layer Daisy-Chain disclosure for clean Markdown rendering
2026-10-27 docs: elevate Multi-Layer Daisy-Chain architecture to professional LaTeX display math
2026-10-27 docs: streamline GitHub KaTeX math and eliminate broken inline notation in daisy-chain section
2026-10-27 feat(scripts): add 1k/3.3k ohm attenuator solder verification and test scripts
2026-10-29 benchmark: complete 3-stage 500-epoch experiment without artificial seeding (peak 7.90b ENOB)
2026-10-29 docs: document 3-stage 500-epoch benchmark milestone (7.90b peak ENOB) with figure in README
2026-10-30 feat(hardware): T120 HW/SW versionsregister, dynamisk L2-regularisering mot knäbaslinje och Run 01-rapport
    - Hårdvarudokumentation: Registrerat 1k/5.1k Ohm dämpare vid summatorn på PCB v1.3.2 (~16.4% kompensationsauktoritet).
    - Bitströmsarkiv: Sparat 7.90b milstolpebitströmmar i FPGA_code/bitstreams_archive/20261029_T120_MAML_KneeBaseline_7p90ENOB/.
    - Resyntes & STA-fix: Lagt till HW version 0x20261030 (ID=MAM1) och synkroniserat cap45/cap49 RAM-inferens till Block RAM. Fmax nådde 52.71 MHz med positiv slack (+1.029 ns setup, +0.086 ns hold).
    - Version Guard Skill: Skapat t120-version-guard skill och verify_and_guard_version.py som automatiskt frågar board-version över UDP och repro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
2026-10-30 docs(benchmark): slutrapport för 10-körningskampanjen med dynamisk baslinjeregularisering
    - Genomfört 10 oberoende 1000-epokers körningar (10 000 fysiska epoker totalt) på Trion T120 SoC vid 192.168.1.50:5000.
    - Hårdvara: PCB v1.3.2 med 1k/5.1k Ohm summator-dämpare.
    - Verifierat att L2-regularisering mot W_baseline = [-16, -16, 16, 16, -16, 16] LSB håller vikterna i det linjära S-kurveområdet och förhindrar 2T1C DC-drift.
    - Skapat sammanfattande statistisk medelvärdesrapport och konvergensgraf (mean ± 1σ) i FPGA_code/docs/M3_M8_10RUNS_1000EP_REGULARIZATION_REPORT.pdf och .md.
    - Sparat samtliga 10 JSON-dataset i FPGA_code/logs/baseline_regularization_campaign/.
2026-10-30 feat(anti-sat): implementera ColTIA saturation guard med Hadamard-marginal och LayerNorm på T120
    - Fastställt uppmätt Hadamard peak-to-peak stegsväng (243 LSB på ADC45) som säkerhetsmarginal
    - COLTIA_CLIP_THRESHOLD_LSB satt till 1797 LSB (2047 - 250)
    - Om ADC45 eller ADC49 når tröskeln undertrycks viktuppdateringen helt (0 ändring på deformerat sample)
    - Räknare och kolumnbitmask skickas i realtid över UDP-telemetri (clip_events_cnt, col_clip_mask, last_clip_adc_id)
    - Zero-mean centering (LayerNorm) adderad för färgade indatalaecken för att förhindra common-mode bottning
    - Skapat agent-skill coltia-saturation-guard
    - Verifierat live på fysisk kisel med 0 bottnade epoker och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
2026-10-31 hardware(v2.0): uppdatera EasyEDA PCB v2.0 produktionsfiler och JLCPCB BOM-underlag
    - Ersatt halvfärdig projektfil (ProPrj...2026-10-01) med färdig ProPrj_Inverted_MAML_6x6_2026-10-31.epro2
    - Inkluderat färska produktionsfiler: Gerber-arkiv (6-lagers) och PickAndPlace CPL
    - Konfigurerat och kört BOM_section_script.py mot nya BOM_Analog_Matrix_Inverted_MAML_IMC_2026-10-31.csv:
    * Delat upp 6 komponentrader med >2047 tecken i Designator-cellen (100nF, 2.2nF, DOX3134A, 1M, 20k, 10k)
    * Genererat BOM_Analog_Matrix_Inverted_MAML_IMC_2026-10-31_Designator_max_2047_char.csv (max 2043 tecken)
    * Verifierat med verify_section.py att 100% av komponenterna och kvantiteterna bevarats intakta (CSV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
2026-10-31 docs: add OSHWLab interactive CAD/PCB links and PCB v2.0 release specs
2026-11-01 docs/reports: 500-epoch empirical silicon evaluation across [4.5-5.5 ms] with colored LLM data
    - Implemented and verified Mode A 500-epoch training on physical silicon (Trion T120 Master SoC @ 192.168.1.50:5000)
    - Configured Kac-Murdock-Szegö AR(1) Toeplitz spatial covariance (rho=0.85) and real-time Hardware LayerNorm
    - Established calibrated smart baseline for all 8 rows in Matrix 3 (compute + clock reference) and Matrix 8 vernier
    - Empirical silicon validation: 98% quadratic error collapse (Loss 29,122 -> 498 LSB²) and 7.31-bit ENOB peak at Epoch 220
    - Characterized long-term -120 LSB clamp saturation drift at Epoch 320 and formulated Remediation Actions 1 & 2
    - Generated comprehensive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
2026-11-01 docs/milestone3: add comprehensive 11-page Milestone 3 report across [4.5..5.5 ms]
    - 500-epoch silicon evaluation with 100% identical 200-sample Hadamard batch cadence across all phases
    - Telemetry dataset: mode_a_500ep_broadened_4p5to5p5ms_reg1024_lr0p25_identical_k20_llm.json
    - Dedicated separate pages for single-point 5.0 ms midpoint vs full 4.5..5.5 ms temporal window
    - Patent SE 2630397-4 Fig 5 (displaced sampling) and Fig 6 (temporal leakage compensation)
    - Documented future research directions for strata x K, LR, L2, and multi-cycle 10 ms undersampling
2026-11-01 docs: clarify standard CMOS leaky gain cells vs exotic materials in Milestone 3 motivation
2026-11-01 feat & docs: full ±80 LSB zero-mean colored swing run, 13-page report, and signal-flow examples
    - Upgrade maml_generate_new_white_noise_ref in maml_platform.c with max_span=80,
    6x AC boost on LayerNorm residual, and proportional vector scaling so peak reaches
    ±80 LSB while strictly preserving sum(x_i) ≈ 0 (preventing ColTIA saturation).
    - Complete 500-epoch silicon run across [4.5..5.5 ms] (LR=0.08x, lambda=1024)
    with mean peak 68.4 LSB, median peak 78.0 LSB, 42.0 LSB RMS (+12.9 dB power).
    - Generate 13-page publication PDF/MD report with Epoch 397 GUI screenshot,
    hardcoded W33 payload matrix, and three detailed silicon signal-flow example tables
    (Input X * W33 -> Target Z vs T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
2026-11-01 hardware: update PCB v2.0 to 2026-11-01 (Ethernet 0 ohm errata replaced by 100nF, regenerate JLCPCB split BOM)
    - Update PCB Version 2.0 release in EasyEDA/next_revision_2 to 2026-11-01.
    - Fix Ethernet PHY errata: replace 0 Ohm resistor R45 with 100 nF capacitor
    (C0402, C1/CBB2) for AC-coupling / filtering.
    - Generate updated JLCPCB continuation BOM (Designator_max_2047_char.csv)
    splitting designators >2047 chars across 109 rows, verified with verify_section.py.
    - Remove deprecated 2026-10-31 files, keeping exclusively 2026-11-01 production files.
    - Update BOM_section_script.py, verify_section.py, and Errata_notes_version_2.txt.
2026-11-02 refactor(fpga): verify T20 custom bitstream on hardware, archive release artifacts, and clean up repository
    - Hardware Verification: Verified T20 custom application bitstream on physical silicon
    (Status: T20 ONLINE [TAG=T20A, S-bus ACK 0x06], zero missed Hadamard frames, dynamic
    analog multiplier curves confirmed across M3, M8, M33).
    - Bitstream Archive: Preserved verified working bitstreams (.hex, .bit, and pure binary .bin)
    in FPGA_code/releases/T20_Custom_Verified/ with detailed README metadata.
    - Repository Cleanup: Removed obsolete 47-pin prototype directory (FPGA_code/T20F256/).
    - Tooling & Skills: Added efinix-dual-fpga-programming skill documenting JTAG flashing
    sequence, and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
2026-11-03 feat(mode_a): verify Milestone 2 on Card 1 (7.73b peak ENOB) & add --d-line swing control
    - Verify Milestone 2 Mode A on Card 1 (Rev 1.4, 1k/5.1k attenuator):
    * Phase 1 (Baseline W=0): 10,608.8 LSB² mean (5.13 bits)
    * Phase 2 (Knee Baseline ±16 LSB): 11,145.7 LSB² mean (5.10 bits)
    * Phase 3 (Active Training, LR=0.25x, lambda=512): collapsed to 280.6 LSB² (Peak ENOB: 7.73 bits at Ep 437)
    * Final Epoch 500: 1,111.3 LSB² (6.73 bits)
    - Update run_500ep_llm_regularization.py:
    * Add --d-line CLI parameter (default 2 for +/-40-45 LSB swing, 1 for +/-80 LSB)
    * Add --tag CLI parameter for run identification
    - Fix udp_client.py:
    * Fix draw_fresh_vector socket timeout by setting expe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
2026-11-03 docs & verification: Card 2 hardware repair (CH3 resoldered), flat baseline validation (-55.7% loss, +0.66b ENOB) and report PDF
    - Documented physical root-cause resolution on Card 2 (0402 5.1k open-circuit on CH3 resoldered by Olle).
    - Verified channel-by-channel error drop: Channel 3 loss reduced by -95.8% (from 9,106.8 down to 382.3 LSB²).
    - Implemented and executed Flat Baseline Experiment (Olle's hypothesis: starting training directly from W=0, W_null=0 without artificial knee disturbances).
    - Confirmed -55.7% whole-phase loss reduction (2,937.2 down to 1,300.7 LSB²) and +0.66 bit ENOB improvement across all 401 training epochs over open-loop W=0.
    - Reached new all-time single-epoch s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
2026-11-03 docs: log hardware defect confirmation on Card 1 CH4 (0402 5.1k open circuit) and invalidate flawed baseline
    - Logged physical multimeter confirmation by Olle Welin: Channel 4 on Card 1 has an open circuit on the 0402 5.1k series summing resistor.
    - Documented in olle_log and debug_journal that ALL previous 5.1k measurements on Card 1 were severely flawed due to this missing channel (CH4 caused 7,072 LSB² error alone).
    - Added critical warning banner to INVERTED_MAML_MILESTONE2_CARD1_VERIFICATION_REPORT.md invalidating the 06:20 Card 1 baseline.
    - Card 1 requires resoldering on CH4 to achieve full symmetry and >6.5b open-loop accuracy matching Card 2.
2026-11-03 docs: log Card 1 CH4 0402 5.1k solder defect (now fixed, untested) and add Card 2 flat baseline PDF report
    - Documented that all previous 5.1k measurements on Card 1 were invalid due to an improper 0402 solder joint (open circuit) on Channel 4.
    - Olle has now resoldered Channel 4 on Card 1 (fixed, but not yet tested on rig).
    - Generated publication PDF and report for Card 2 Flat Baseline Experiment showing -55.7% whole-phase loss reduction directly from W=0.
2026-11-03 feat(mode_a): complete 500-epoch broadened window [4.5..5.5 ms] run on Card 2 with flat baseline
    - Verified 2-phase flat baseline protocol (W=0 open loop, active training directly from W=0 with W_null=0).
    - 200-sample window loss improved to 55,349 LSB^2 (peak 4.09b ENOB across [4.5..5.5 ms]).
    - 5.0 ms center snapshot reached peak performance of 7.29 bits ENOB (511.5 LSB^2).
    - Pre- vs post-sweep showed -96.9% error drop at 5.0 ms and -94.9% error drop at 4.8 ms.
    - 0% weight clamping across all 6 columns at Epoch 500: W8 = [4, -41, 88, -9, -17, -5] LSB.
2026-11-03 docs: add Card 2 Broadened Window [4.5..5.5 ms] report (MD + publication PDF)
    - Identical 9-page publication structure to Milestone 3 report.
    - Features prominent hardware defect note on Card 1 CH4 (0402 5.1k open circuit, now resoldered by Olle).
    - Documents the Flat Baseline Protocol (W=0, W_null=0) cutting error by -96.9% at 5.0 ms with zero knee jump.
    - Includes 3D Dual-2T1C weight landscapes, split 5.0ms vs full-window trajectories, 2D weight dynamics, and pre vs. post temporal transfer functions.
2026-11-03 Reports: preserve exact native aspect ratios for all images and patent schematics across dedicated pages (no squishing)
2026-11-03 build(git): ignore intermediate reports and track Card 2 repair, swing40, and swing80 reports and all code
2026-11-04 feat(mode_a): complete 1000ep run with K=1 single-sample SGD, Var=3, Reg=1024
2026-11-04 feat(benchmark): 1000-epoch broadened window [4.5..5.5 ms] pure online single-sample SGD report and multi-timepoint figures
2026-11-04 feat(hw): update EasyEDA next_revision_2 to 2026-11-04 with 1k/3.3k attenuator and split BOM
2026-11-04 feat(benchmark): 1000ep broadened window white noise online SGD and 10-page report
    - Execute 1000-epoch pure online single-sample SGD (K=1, 11 updates/epoch)
    under uncorrelated white noise data excitation across [4.5..5.5 ms].
    - Track and compensate non-stationary +/-5 LSB perturbations on Matrix 33.
    - Generate 10-page publication PDF with Page 7 dedicated to 3D disturbance
    offset topographies (Patent Fig 7 Emulator).
    - Verify peak precision of 6.26 b ENOB (2143.5 LSB^2) at 5.0 ms center,
    window mean loss reduction of -63.5%, and 8x error jump under Phase 4 ablation.
2026-11-05 docs(report): 4-page publication PDF and markdown for Mode A vs Mode B cross-check with schematic and PCB verification
2026-11-05 docs: remove spectrogram heatmap from README, keeping clean 2D line graphs and updating figure numbers
2026-11-05 hw(easyeda): update next_revision_2 production packages to 2026-11-05 synced with OSHWLab
    - Replace 2026-11-04 production files with updated 2026-11-05 packages:
    * Gerber_Inverted_MAML_IMC_2026-11-05.zip
    * PickAndPlace_Inverted_MAML_IMC_2026_11_05.csv
    * FlyingProbeTesting_Inverted_MAML_IMC_2026-11-05.zip
    * odb++_pcb_2026-11-05.tgz
    * Layout.pdf (42 MB)
    - Regenerate and verify JLCPCB special BOM:
    * BOM_Analog_Matrix_Inverted_MAML_IMC_2026-11-05_Designator_max_2047_char.csv
    - Update BOM_section_script.py and verify_section.py to reference 2026-11-05
    - Remove deprecated 2026-11-04 production files
2026-11-05 docs(benchmark): add Card 1 1k/2.2k attenuator benchmark report, dataset and README entry
    - Card 1 physically resoldered to 1k/2.2k attenuator ratio (-10.1 dB, +132% injected current vs 5.1k)
    - 1,000 epochs, 11 strata across [4.5..5.5 ms], 11,000 single-sample online SGD steps on silicon
    - Shattered peak precision to 6.63 bits ENOB (1,390.5 LSB^2 min loss) and 6.52 bits nominal sustained
    - Halved non-stationary disturbance loss under Patent Fig 7 +/-5 LSB perturbations (20,835.9 LSB^2, 4.75 b)
    - Record 9.53x ablation contrast (953% error surge when W=0)
    - Published 3-page PDF and Markdown reports with 3-way silicon comparison overlay
2026-11-05 fix(t120): phase-lock 10ms refresh timer and execute Card 1 Mode A 1000ep benchmark
2026-11-05 docs: formal retraction and investigation report on refresh timing jitter artifacts
    - Add INVESTIGATION_REPORT_TIMING_JITTER_AND_BASELINE_ARTIFACTS.md documenting
    root cause analysis of the 10/20 ms refresh jitter bug in T120 C-firmware.
    - Include empirical proof dataset and comparative figure on Card 2 showing
    complete collapse of apparent 8.1x contrast (from 8.14x to 1.10x, delta = 0.04 b).
    - Add formal retraction warning banners to all affected Nov 4-5 reports
    (FHP comprehensive, White Noise, Mode A vs Mode B, and Attenuator comparisons).
    - Update root README.md with honest post-mortem and true silicon baseline (~5.6 bits).
    - Update releases/README.md with retraction notices.
    - Arch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
2026-11-06 fix(releases): remove deprecated 20261104 and 20261105 release packages due to timing jitter bug
2026-11-07 feat(mode_a): add Mode A vs Mode B ablation comparison and 2D numeric perturbation cards
    - Re-ran 1,000-epoch Mode A benchmark on Card 2 (4.5-5.5 ms, K=1, White Noise, ±5 LSB drift) after zero-baseline calibration.
    - Added comprehensive 11-page Mode A report without Mode B banner.
    - Added Page 10 head-to-head empirical comparison (Mode A vs Mode B) proving active analog compensation advantage (+0.40 bits / -43.5% error under disturbances).
    - Replaced 3D disturbance view with 2D numerical matrix card layout (Page 7) matching hardware specification.
    - Archived full Mode B ablation datasets and comprehensive reports (4.5-5.5 ms and 5.0-6.0 ms).
2026-11-07 Implement pure Verilog crystal-locked 10.000000ms refresh and Hadamard frame engine (0.00ns jitter)
2026-11-08 benchmarks: update 20-min Card 2 thermal cycling report across 5.0-5.4 ms window with BJT saturation guard
    - 20-minute physical run (3436 epochs, 8m8m heaters @ 100%, 2m2m regulation)
    - Mode A closed loop suppresses catastrophic 100% thermal drift by -65.4% (510k down to 176k LSB², +1.48 bits ENOB)
    - Safe shutdown confirmed: heaters OFF (0%), weights centered
    - Regenerated 10-page publication PDF and markdown reports
2026-11-08 feat(thermal): add continuous 30% duty cycle 1Hz heater PWM support and GUI telemetry
2026-11-08 feat: 11-page thermal stress report with 2D weight curves, DC calibration timing analysis, and ASIC vs PCB spatial thermal discussion
2026-11-10 feat(thermal): add --heater-start option (default off) for cold DC-calibration runs
2026-11-11 Fix SGD momentum reset bug & implement 2-beat analog bit slicing
    - Fix momentum wiping bug: Eliminated redundant MAML_CMD_CENTER_WEIGHTS
    calls inside the 2-beat loop that previously wiped g_vel_m8_q14 to zero
    every 10 ms, halting momentum accumulation.
    - Switched slice toggling to MAML_CMD_SET_W33 (set_w33_matrix) to update
    nominal M33 and Z_target while preserving active M8 weights and SGD state.
    - Rescaled L2 regularization per step (lambda=96 vs 768) and set LR=0.04
    with K=2 to enable fast, robust thermal drift compensation.
    - Added analog-bit-slicing skill documenting true 2-beat interleaving,
    deterministic integer restoration math, and advantages over DSP tuning.
    - Added bit_s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
2026-11-12 feat(bit_slicing): add fixed startup DC calibration & 8-phase thermal sequence (30% duty, LR=0.04, K=2)
2026-11-12 Use T20 crystal-locked hardware PWM directly instead of Python software PWM
2026-11-14 feat: 100% Open Source (incl. commercial ASIC/IC, SHL-2.1 + SE 2630397-4), Mode A Bit-Slicing Anti-Windup & R1-R2 Reports
    Everything in this repository — including hardware schematics, PCB layouts, commercial ASIC/IC silicon implementations and manufacturing, FPGA gateware, RISC-V firmware, Python/GUI software, and experimental datasets/reports — is 100% Open Source under the Solderpad Hardware License v2.1 (SHL-2.1) with a perpetual, worldwide, royalty-free patent license covering Swedish Patent Application SE 2630397-4 for both commercial and non-commercial use.
    Included in this commit:
    - LICENSE, LICENSE.md, README.md: explicit 100% Open Source & commercial ASIC/IC patent grant polic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
2026-11-14 chore: Lock R1 Cold DC Calibration (r1_dc_cal_fixed.json) & Archive Recalibrated R2-R8 Reports (100% Open Source SHL-2.1 incl. Commercial ASIC)
2026-11-14 docs: R3dc_fix 180-Weight Report, GP Pinch-Off/Clamp Search Fix & FHP Report (100% Open Source SHL-2.1 incl. Commercial ASIC)
2026-11-14 docs+fix: Verified HW Clamp UDP Check, R4dc_fix (CL70 #1 +2.480) & R5dc_fix (CL85 +1.12b Lift) 180-Weight Reports (100% Open Source SHL-2.1 incl. Commercial ASIC)
2026-11-14 Lock Clamp=90 LSB optimum, document R10..R16 clamp sweep & silicon saturation in README
    - Lock Clamp = 90 LSB ('Lagom') as verified production optimum on Card 1 silicon:
    P3 Warm Comb ENOB reaches 8.78 bits with 13.4k total loss (lowest thermal loss recorded)
    - Systematic hardware clamp sweep (R10..R16) under 40% PWM thermal stress:
    75 LSB (under-clamped, +0.81 b) -> 85 LSB (high lift +1.12 b) -> 90 LSB (peak precision 8.78 b) -> 100 LSB (2T1C MOS triode saturation knee, loss rises to 18.9k)
    - Update Release README with embedded multi-panel timeline, 180-weight trajectory figures, and reproduction commands
    - Dynamically scale W(8) y-axis to prevent clamp truncation in concise reports (w8_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
2026-11-14 Document clean R18 verification run (Clamp=90 LSB, +1.25 b hot climb) and updated reports
2026-11-14 Document clean R19 replicate (Clamp=90 LSB, 3924 unbroken pairs, P3 8.80 b) and updated release
2026-11-14 Document multi-stage Round 20 (30s phases: 2 cold + 6 warm 30% + 6 warm 40%, 4702 unbroken pairs)
